rryske2001/praca-magisterska/obrazki/konwertery_spi_i2c.png

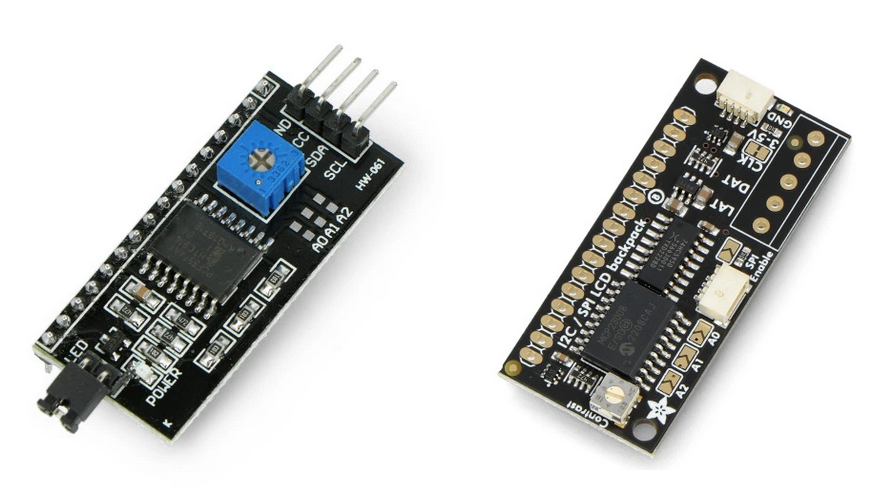
obrazki/konwertery_spi_i2c.png
