rryske2001/praca-magisterska/obrazki/40x2_lewe_wyprowadzenia.png

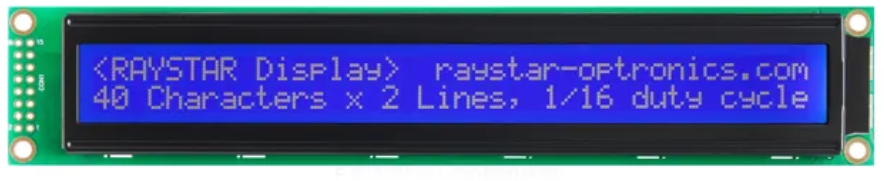
obrazki/40x2_lewe_wyprowadzenia.png
