rryske2001/praca-magisterska/obrazki/rysunki.pptx

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
Instrukcja (01h)

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
Drugi bajt danych

Pierwszy bajt danych

MOSI

8

Stan wysokiej impedancji

MISO

## Slide 2

PCF8574

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
## Slide 3

MCP23S17

GPA7

GPA6

GPA5

GPA4

GPA3

GPA2

GPA1

GPA0

INTA

INTB

A2

A1

A0

GPB0

GBP1

GPB2

GPB3

GPB4

GPB5

GPB6

GPB7

VDD

VSS

CS

SCK

SI

SO

RESET

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
## Slide 4

MCP2017

GPA7

GPA6

GPA5

GPA4

GPA3

GPA2

GPA1

GPA0

INTA

INTB

A2

A1

A0

GPB0

GBP1

GPB2

GPB3

GPB4

GPB5

GPB6

GPB7

VDD

VSS

NC

SCK

SDA

NC

RESET

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
