rryske2001/praca-magisterska/MCP_I2C_SPI_alternatywna_V11/plots/MCP_I2C_SPI_schematic_V3.pdf

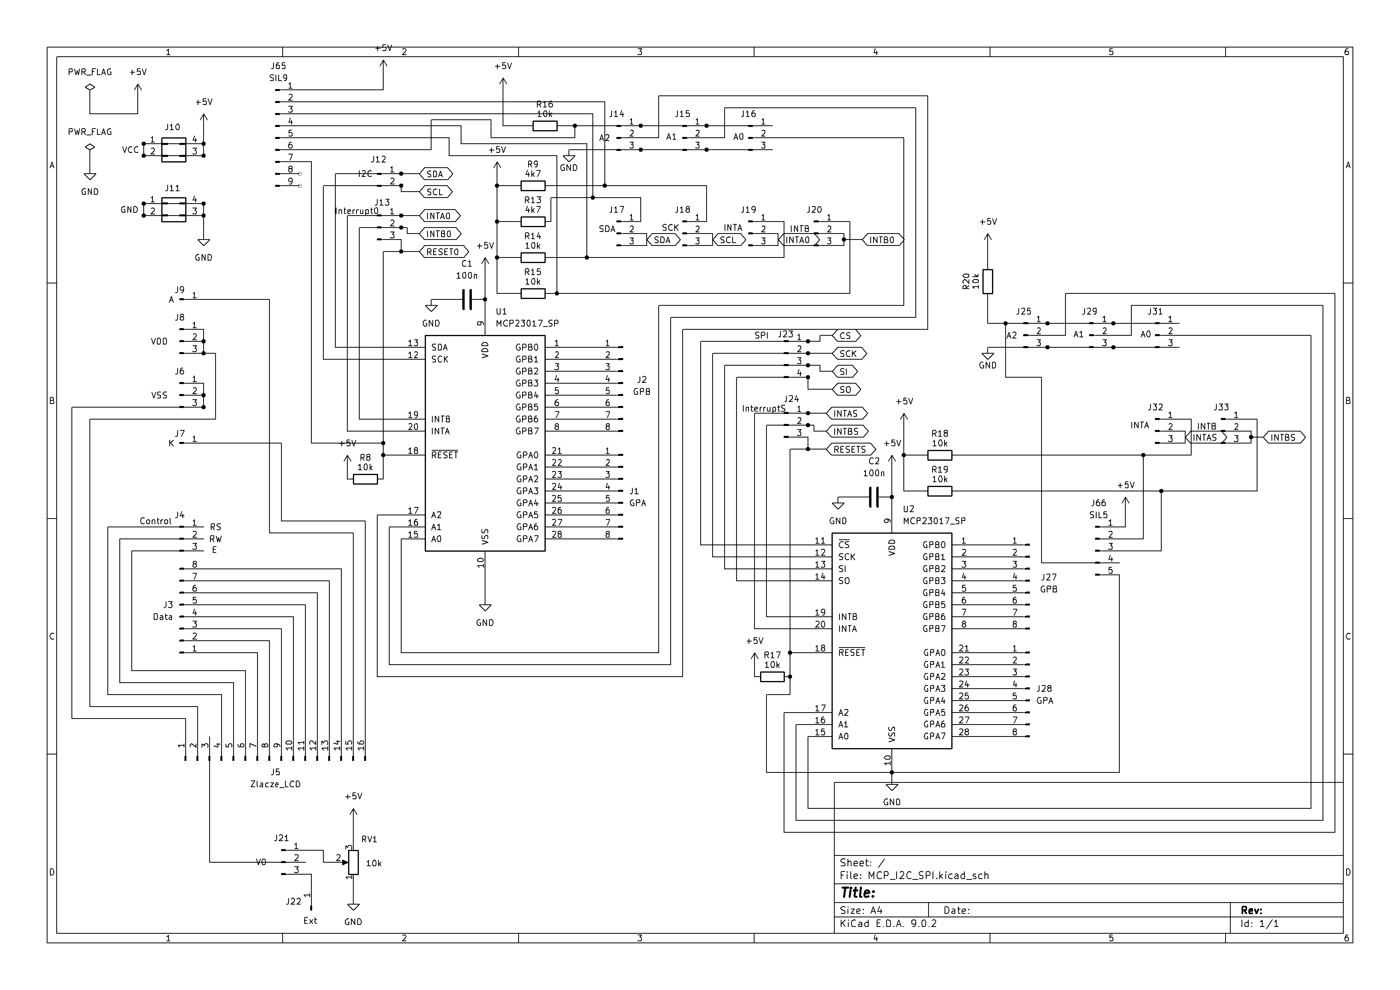
[picture p25: page 1]
