rryske2001/praca-magisterska/Praca_Dyplomowa_Magisterska_Szymon_Dobrowolski_Rafal_Ryske.pdf

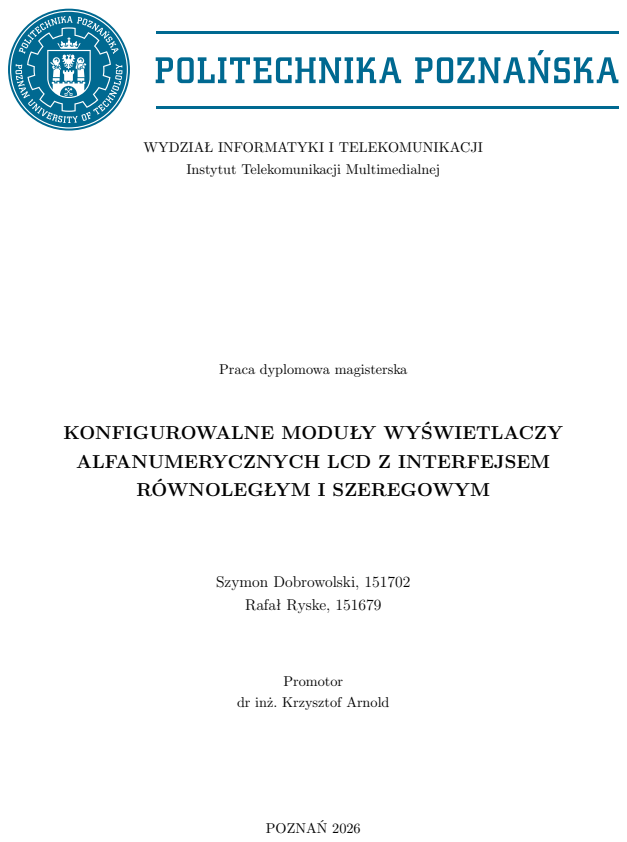
[picture p26: page 1]
RÓWNOLEGŁYM I SZEREGOWYM; Szymon Dobrowolski, 151702; Rafał Ryske, 151679; Promotor; POZNAŃ 2026

WYDZIAŁ INFORMATYKI I TELEKOMUNIKACJI

Instytut Telekomunikacji Multimedialnej

Praca dyplomowa magisterska

KONFIGUROWALNE MODUŁY WYŚWIETLACZY

ALFANUMERYCZNYCH LCD Z INTERFEJSEM

dr inż. Krzysztof Arnold

## Streszczenie

Praca magisterska skupia się na analizie i optymalizacji metod sterowania alfanumerycznymi wyświetlaczami LCD, stanowiąc kompleksowe studium integrujące w tym zakresie zagadnienia sprzętowe i programowe systemów mikroprocesorowych. W projekcie położono szczególny nacisk na oszczędne wykorzystanie wyprowadzeń mikrokontrolera przy zachowaniu efektywnej komunikacji procesora z wyświetlaczami. W pracy opisano mechanizmy komunikacji ze sterownikiem HD44780 i przeanalizowano różnice między klasyczną transmisją równoległą a transmisją szeregową. W tym celu wykorzystano magistralę I²C oraz SPI, badając układy ekspanderów portów

z rodziny PCF8574, MCP23017 oraz MCP23S17. Omówiono także projekty zintegrowanych, dwuwarstwowych obwodów drukowanych. Przygotowano autorskie biblioteki w języku C z bezpośrednim dostępem do rejestrów ekspanderów i przeprowadzono szczegółową analizę opóźnień programowych oraz charakterystyk dynamicznych w transmisji danych. W pracy przedstawiono również narzędzia sprzętowo-programowe, udowadniając, że wydajne interfejsy szeregowe z powodzeniem mogą zastąpić komunikację równoległą bez strat dla poprawnej i szybkiej transmisji danych.

Słowa kluczowe: ATmega 328p, ekspander I/O, ESP32, I2C, mikrokontroler, MCP23017, MCP23S17,

obwód drukowany, PCB, PCF8574, SPI, sterownik HD44780, wyświetlacz LCD

## Abstract

This Master’s thesis focuses on the analysis and optimization of control methods for alphanumeric LCDs, constituting a comprehensive study that integrates the hardware and software aspects of microprocessor systems in this regard. Particular emphasis was placed on the economical use of microcontroller pins while maintaining effective communication between the processor and the displays. The thesis describes the communication mechanisms with the HD44780 controller and analyzes the differences between classic parallel and serial transmissions. For this purpose, I²C

and SPI buses were utilized to examine port expander chips from the PCF8574, MCP23017, and MCP23S17 families. The designs of integrated, two-layer printed circuit boards (PCBs) are also

discussed. Custom C language libraries with direct access to the expanders’ registers were developed, and a detailed analysis of software delays and dynamic characteristics in data transmission was conducted. Furthermore, the thesis presents hardware and software tools, proving that efficient serial interfaces can successfully replace parallel communication without compromising correct and high-speed data transmission.

Keywords: ATmega328p, I/O expander, ESP32, I2C, microcontroller, MCP23017, MCP23S17,

printed circuit board, PCB, PCF8574, SPI, HD44780 controller, LCD display

# Spis treści

1 Wstęp | 7
2 Wyświetlacze alfanumeryczne LCD | 9
3 Ekspandery wejść/wyjść równoległych | 17
4 Projekt modułu LCD z 8-bitowymi ekspanderami PCF8574 | 25
5 Projekt modułu LCD z 16-bitowym ekspanderem MCP23017 | 35
6 Projekt modułu LCD z 16-bitowym ekspanderem MCP23S17 | 41
7 Projekt modułu LCD z 16-bitowymi ekspanderami MCP23x17 | 47

I

II | Spis treści
8 Projekt systemu rozproszonego z łącznością radiową | 55
9 Testowanie ekspanderów wejść/wyjść | 71
10 Uruchamianie modułu LCD z 8-bitowymi ekspanderami PCF8574 | 83
11 Uruchamianie modułu LCD z 16-bitowymi ekspanderami MCP23x17 | 97
12 Uruchamianie modułu bezprzewodowego z układem CC1101 | 103
13 Badania parametrów podsystemu z modułem LCD | 117
13.1 Analiza porównawcza opóźnień programowych i charakterystyk dynamicznych wy-
14 Podsumowanie | 127
Literatura | 129

# Rozdział 1

# Wstęp

## 1.1 Geneza pracy

W obecnej dobie technologicznej wyświetlacze stanowią fundamentalny element komunikacji na linii człowiek-maszyna (ang. Human-Machine Interface, HMI). Przybierają one wielorakie formy

i stopnie skomplikowania: od ekranów o wysokiej rozdzielczości w inteligentnych smartfonach, aż po proste, monochromatyczne panele w kasach sklepowych. W trakcie codziennej interakcji z urządzeniem elektronicznym użytkownika interesuje z reguły wyłącznie natychmiastowo i bezbłędnie wyświetlony wynik. Rzadko zdajemy sobie sprawę, jak złożony ciąg zdarzeń musi zaistnieć wewnątrz układu cyfrowego, zanim na ekranie zaobserwujemy żądaną informację.
Każdy znak pojawiający się na matrycy ciekłokrystalicznej jest w rzeczywistości wynikiem dziesiątek niskopoziomowych operacji bitowych, rygorystycznej synchronizacji sygnałów strobujących i translacji poleceń przez zaawansowane kontrolery sprzętowe. W świecie systemów wbudowanych (ang. embedded systems), gdzie zasoby pamięci i mocy obliczeniowej bywają mocno ograniczone,

proces ten staje się jeszcze większym wyzwaniem inżynierskim.
Ponadto, nieustanne dążenie do miniaturyzacji elektroniki sprawia, że klasyczne, równoległe sterowanie wyświetlaczami alfanumerycznymi pochłania zbyt wiele cennych wyprowadzeń (GPIO)

mikrokontrolera. Naturalnym rozwiązaniem tego problemu jest przeniesienie ciężaru komunikacji na popularne magistrale szeregowe, takie jak I²C czy SPI, z wykorzystaniem dedykowanych układów

pośredniczących – ekspanderów portów.
Głównym celem niniejszej pracy jest kompleksowa analiza procesu sterowania matrycami LCD w standardzie HD44780, począwszy od interfejsów równoległych, aż po zoptymalizowane rozwiązania szeregowe oparte na układach z rodziny PCF8574, MCP23017 i MCP23S17. Obszarem zainteresowań jest wykazanie, jak pełną inżynierskich niuansów tematyką może być ta z pozoru prozaiczna wizualizacja znaków.
Aby w pełni zweryfikować te procesy, opracowano fizyczne stanowiska testowe w postaci zinte-

growanych obwodów drukowanych, pozwalających na pełnoprawną obsługę wielowierszowych matryc. Co istotne, stworzone moduły zaprojektowano z myślą o wysokiej uniwersalności, dzięki czemu mogą one posłużyć również jako cenne pomoce dydaktyczne w laboratoriach studenckich. Przeprowadzona w kolejnych rozdziałach analiza porównawcza, uwzględniająca przepływność magistrali, rygory czasowe i niezawodność sygnałową, stanowić ma kompendium wiedzy o optymalnym łączeniu warstwy programowej ze sprzętową w celu uzyskania maksymalnej efektywności układu.

7

8 | Wstęp

## 1.2 Podział obowiązków projektowych

Szymon Dobrowolski

| Dokonanie przeglądu not katalogowych mikrokontrolerów z rdzeniem AVR i specyfikacji modu-
łów Arduino. Analiza architektury, obsługi programowej i protokołów transmisji dla wskazanych ekspanderów I/O. Zapoznanie się z opisem katalogowym standardowego sterownika HD44780U. Dokonanie przeglądu konwerterów I2C/LCD oraz SPI/LCD. Zapoznanie się z projektami wstęp-

nymi konfigurowalnych wyświetlaczy LCD, zaproponowanymi przez promotora. Zaprojektowanie konfigurowalnego modułu LCD 2x16/4x20 z interfejsem równoległym oraz interfejsami I²C i SPI.

Wykonanie badań symulacyjnych oprogramowania. Przeprowadzenie podstawowych testów na wersjach prototypowych modułów. Wykorzystanie w testach platformy Arduino. Przeprowadzenie badań, weryfikujących zgodność opóźnień programowych z wymaganiami sterownika HD44780U oraz parametrami dynamicznymi wyświetlaczy i ekspanderów I/O.

| Współudział w opracowaniu projektów PCB modułów według wskazówek promotora. Udział
w uwzględnieniu w projektach PCB wersji z frezowanym polem masy i z warstwą soldermaski.

Rafał Ryske

| Zapoznanie się z zasadą działania, protokołami komunikacyjnymi i programową inicjalizacją
wbudowanych modułów TWI oraz SPI. Przegląd wyświetlaczy alfanumerycznych LCD, ze szczególnym uwzględnieniem modułów 2x16 i 4x20. Przeanalizowanie interfejsów i rozkładu wyprowadzeń typowych alfanumerycznych wyświetlaczy LCD. Wybór reprezentatywnych wyświetlaczy o zgodnym rozkładzie wyprowadzeń. Zaprojektowanie modułu LCD 2x16/4x20 z interfejsem równoległym, interfejsem I²C i konfiguracją połączeń na płytce modułu. Wykorzystanie wskazanych 8-bitowych

ekspanderów I/O. Wykorzystanie wskazanych 16-bitowych ekspanderów I/O. Opracowanie pro-

gramów testowych dla zaprojektowanych modułów. Zbadanie poprawności komunikacji jednostki centralnej z konfigurowalnymi modułami LCD dla różnych długości połączeń.
| Współudział w opracowaniu projektów PCB modułów według wskazówek promotora. Udział
w uwzględnieniu w projektach PCB wersji z frezowanym polem masy i z warstwą soldermaski.

# Rozdział 2

# Wyświetlacze alfanumeryczne LCD

## 2.1 Charakterystyka wyświetlaczy

Rozważania dotyczące wyświetlaczy należy zacząć od tego jakie rozwiązania są oferowane przez producentów oraz potrzeb projektowych. Pierwszym wyborem jest technologia w jakiej wyprodukowano ekran. W większości przypadków sprowadza się to do decyzji pomiędzy wyświetlaczami LCD, a OLED. Obydwa rozwiązania różnią się pod względem parametrów wyświetlania (tutaj przeważa ekran OLED), oraz ceną. Młodzi adepci elektroniki częściej decydują się na zakup wyświetlaczy

LCD do celów dydaktycznych. Niebagatelny jest tutaj stosunek ceny do parametrów fizycznych ekranu - jego wielkości. W związku z popularnością tej technologii, jest ona rozważana w dalszej części pracy.
Typowy wyświetlacz ciekłokrystaliczny do prawidłowej pracy potrzebuje podświetlenia, sterownika oraz filtrów polaryzacyjnych. Elementem, który powoduje zmianę danych i komend z mikrokontrolera na napięcia sterujące matrycą, jest sterownik graficzny. Dzięki temu urządzeniu możliwa jest manipulacja polaryzacją struktury ciekłokrystalicznej - zmiana odcieni, barw. Najczęściej spotykanymi rodzajami sterowników są między innymi: HD44780, ILI9341 i ST7789. Implementacja danego układu scalonego w wyświetlaczu definiuje jego sposób komunikacji, rodzaje obsługiwanych matryc, liczbę możliwych znaków czy sekcję zasilania układu [9].

Wybór ekranu jest nieodłącznie związany z doborem pod optymalną liczbę znaków. Tak jak w większości przypadków rynek wyświetlaczy pozwala tu na dostęp do wielorakich rozwiązań. Dla sterowników HD44780 dostępnych jest kilka rozmiarów matryc znakowych. Najpopularniejszymi są 16x2 , 20x4 i 40x2¹
. Sterowniki ILI9341 oraz ST7789 są przeznaczone do wizualizacji różnego rodzaju grafik. Z tego względu ekrany współpracujące z powyższymi układami są charakteryzowane liczbą dostępnych pikseli [5].

W trakcie projektowania urządzenia, należy zwrócić uwagę na umiejscowienie wyświetlacza na płytce. W przypadku wyboru ekranu z sterownikiem HD44780 błędne dobranie wyprowadzeń, może wiązać się z nieodpowiednim wyświetlaniem znaków - do góry nogami. Może to zabrzmieć prozaicznie, lecz tworząc duży projekt takie przeoczenie niesie za sobą ogromne konsekwencje -w najgorszym przypadku zmarnowanie funduszy. Młodsze sterowniki pozwalają na programowe manipulowanie obrazem, przez co problem z błędnym zaprojektowaniem miejsca na wyświetlacz, przy dobrze napisanym kodzie praktycznie nie występuje[27].

W zależności od technologii wykonania sterownika wyświetlacza, występuje w nich różne napięcie zasilania oraz przyjmowane stany logiczne. HD44780 musi być zasilany napięciem 5 V, natomiast

1
gdzie pierwsza liczba to liczba kolumn, natomiast druga to liczba wierszy

9

10 | Wyświetlacze alfanumeryczne LCD

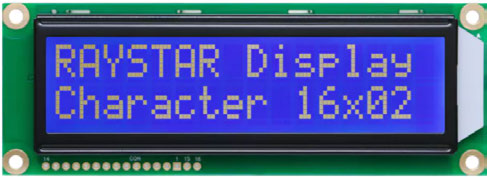
[picture p27: figure]

Rysunek 2.1: Przykład wyświetlacza 16x2 z wyprowadzeniami na dolnej części wyświetlacza [29]

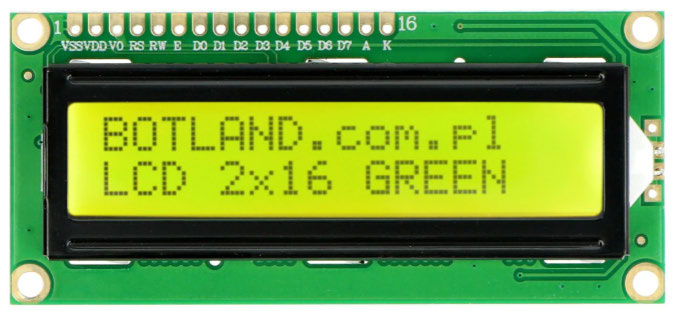
[picture p28: figure]

Rysunek 2.2: Przykład wyświetlacza 16x2 z wyprowadzeniami na górnej części wyświetlacza [4]

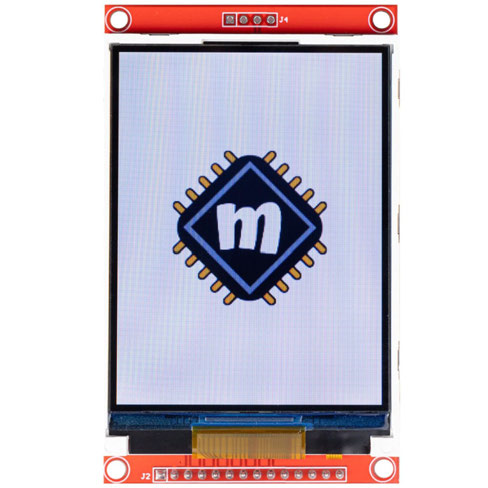
[picture p29: figure]

Rysunek 2.3: Wyświetlacz TFT sterowany układem ILI9341 [22]

Rysunek 2.4: Zdjęcie wyświetlacza 40x2 ze złączami po lewej stronie [30]

2.2. Interfejsy wyświetlaczy | 11

nowszy klon tego układu HD44780U może przyjmować napięcie 2,7 - 5,5 V. Z tego względu nowsza odsłona zadziała zarówno z mikrokontrolerami z rodziny ATMEL AVR (5 V) [1] jak i z ESP32 (3,3
V) [11]. Sterownik ILI9341 przyjmuje napięcie zasilania na poziomie 2,5 - 3,3 V. W przypadku

mikrokontrolerów pracujących na wyższym napięciu, może być konieczne zastosowanie konwertera poziomów napięć logicznych [13].

Każdy wyświetlacz wymaga podświetlenia. Bez niego odczytanie informacji jest bardzo trudne, często niemożliwe. Większość ekranów pozwala na zmienianie jasności. Jest to możliwe poprzez użycie zewnętrznego potencjometru lub zmiennej szerokości impulsu - PWM. Takie rozwiązanie pozwala na dostosowanie wyświetlacza do miejsca pracy.
Kolejną możliwością dostosowania wyświetlacza, jest regulacja kontrastu. W przypadku modułów z 16 -pinowym wyprowadzaniem, zazwyczaj odbywa się to zmianą napięcia na pinie V0. Malejące napięcie powoduje zwiększenie kontrastu i zanikanie znaków z matrycy. Narastające napięcie zmniejsza kontrast i znaki zlewają się w białe lub czarne prostokąty. Idealne napięcie to około 0,5 -1 V, można je uzyskać z napięcia dzielnika, lub potencjometru, którym można liniowo wyregulować kontrast, pod dany kąt patrzenia na wyświetlacz. W przypadku chęci skorzystania z cyfrowej regulacji kontrastu, pin V0 można podłączyć do złącza PWM, podobnie jak w przypadku sterowania jasnością [11].

## 2.2 Interfejsy wyświetlaczy

Interfejs to punkt styku lub zestaw reguł umożliwiający komunikację między różnymi systemami, urządzeniami lub programami. Pozwala na szybką wymianę danych oraz współpracę elementów [23].

Głównym podziałem interfejsów jest klasyfikacja ze względu na sposób przesyłu danych. W taki sposób rozróżniamy magistrale jako równoległe i szeregowe. Interfejs równoległy charakteryzuje się znacznie większą prędkością transmisji, lecz potrzebuje wielu połączeń. Magistrale szeregowe ograniczają liczbę złącz, natomiast wymagają złożonego protokołu komunikacji. Projektując urządzenie do pracy z interfejsem szeregowym należy zapoznać się z ograniczeniami prędkości transmisji danego rozwiązania. Najbardziej popularnymi interfejsami szeregowymi są I²C oraz SPI [24].

I

2C lub IIC (ang. Inter-Integrated Circuit) jest przykładem magistrali szeregowej, wykorzy-

stującej 2 linie do komunikacji. Znaczącą przewagą nad innymi interfejsami jest możliwość wymiany danych pomiędzy wieloma urządzeniami bez potrzeby prowadzenia indywidualnych połączeń. Wszystko odbywa się na tej samej magistrali odpowiednio rozszerzając protokół komunikacji. Dzięki takiemu rozwiązaniu interfejs zyskał znaczną popularność wśród osób zaczynających przygodę z elektroniką. Niewątpliwą wadą magistrali I²C jest jej maksymalna szybkość transmi-

sji. Dla dwukierunkowej wymiany danych jest to 3,4 Mbit/s. Nie każde urządzenie obsługujące tę magistralę ma możliwość komunikacji z taką szybkością. Zważając na ograniczenia interfejsu I²C

znajduje on swoje zastosowanie na krótkich dystansach. Magistrala IIC jest chętnie wykorzystywana w układach pomiarowych, z dużą liczbą sensorów [21, 28].
Alternatywą do wolnego I²C jest interfejs SPI. Specjalistyczne układy wykorzystujące tą ma-

gistralę są w stanie komunikować się z prędkościami przekraczającymi 100 Mbit/s. Z drugiej

strony SPI w swojej specyfice posiada szereg wad, które trzeba rozpatrzeć w trakcie projektowania. Znaczącą różnicą od wymienionego wcześniej I²C jest dwukrotnie większa liczba połączeń.

Wspólna dwukierunkowa szyna danych zostaje rozbita na dwie jednokierunkowe tj. MISO (ang. Master Input Slave Output) oraz MOSI (ang. Master Output Slave Input). Sygnał zegarowy jest prze-

12 | Wyświetlacze alfanumeryczne LCD

syłany linią SCK (ang. Source Clock ). Najważniejszą zmianą pomiędzy wymienionymi interfejsami jest wybór urządzenia podrzędnego. Dużą zaletą magistrali I²C jest jej minimalistyczne podejście,

gdzie jedną szyną wywołuje się wymianę danych z żądanym układem slave. Gdy chcemy zmienić rozmówcę wszystko odbywa się tą samą linią. Sprawa ma się zupełnie inaczej przy SPI. Ostatnim z złącz tego interfejsu jest SS (ang. Slave Select). Każde z urządzeń podrzędnych ma indywi-

dualne połączenie z swojego SS do odpowiednio przygotowanego pinu w urządzeniu nadrzędnym. Przykładowo tworząc system z 3 czujnikami i mikrokontrolerem dla interfejsu SPI trzeba zająć 6 pinów, gdzie dla I²C to 2 połączenia. Stanowi to ogromną różnicę, zwłaszcza przy projektowa-

niu płytki drukowanej. Magistrala SPI jest częstym rozwiązaniem w szybkich pamięciach flash, wyświetlaniu wymagającej szybkiego odświeżania grafiki czy specjalistycznych układach pomiarowych [20, 26].

Rysunek 2.5: 16-pinowe złącze wyświetlacza [29]

Na rysunku 2.5 przedstawiono 16-pinowe złącze wyświetlacza pracującego z interfejsem równoległym. Każdy z pinów pełni określoną rolę. VSS to wyprowadzenie masy układu. VDD to zasilanie (typowo 5 V). V0 to regulacja kontrastu. A to anoda diody podświetlenia ekranu, natomiast K to ka-

toda. Przez wyprowadzenia D0 - D7 odbywa się komunikacja równoległa, przesyłane są tu dane oraz komendy. Numer podany, stojący przy literze D odpowiada indeksowi bitu w bajtowej ramce danych. Na załączonym rysunku widnieją również trzy porty sterujące RS, RW, oraz E, które zostaną omówione w dalszej części rozdziału.

2.3. Transmisja poleceń i danych | 13

## 2.3 Transmisja poleceń i danych

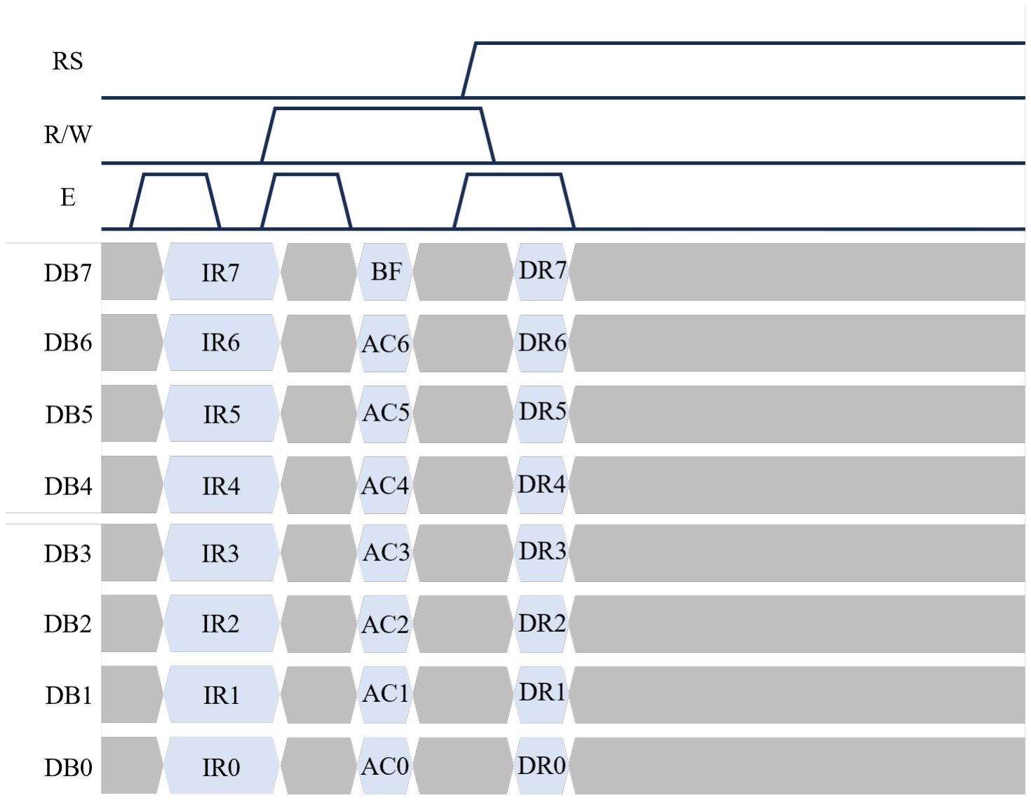
[picture p30: figure]

Rysunek 2.6: Wykres czasowy, przedstawiający transmisję równoległą 8-bitową [11]

W 8-bitowej równoległej transmisji danych wykorzystywany jest cały zestaw wyprowadzeń danych wyświetlacza (DB7 - DB0). Przesyłany jest cały bajt danych w jednym impulsie Enable.

Występują też trzy linie sterujące:

- RS (ang. Register Select) - pozwala na pracę w trybie instrukcji (na rysunku 2.6 oznaczone

jako IR7 - IR0) lub trybie danych (oznaczone jako DR7 - DR0). Instrukcje to inaczej polecenia, które ma wykonać sterownik wyświetlacza (np. wyczyść matrycę, lub ustaw kursor na danej pozycji, itp.). Dane to kod ASCII litery, która ma być wyświetlona lub definicja pikseli dla własnego znaku. Dla niskiego stanu (0 V) wyświetlacz przyjmuje instrukcje. Jeżeli jest podany stan wysoki (5 V), to wyświetlacz przyjmuje dane.

- R/W (ang. Read/Write) - gdy jest podany niski stan, wyświetlacz jest w trybie zapisu. Przyj-

muje wówczas dane oraz komendy. Stan wysoki ustawia sterownik w tryb odczytu, wyświetlacz, przesyła wtedy na pinie D7 flagę zajętości (na rysunku 2.6 - BF) oraz na pozostałych (D6-D0) licznik adresu (AC6 - AC0), przy czym, że pin RS jest ustawiony na 0. W przypadku,

gdy RS ma stan 1, wyświetlacz odsyła kod ASCII wybranego znaku.

- E (ang. Enable) - sygnał wyzwalający przyjęcie komendy lub danych. Sterownik odczytuje

dane z pinów w momencie opadającego zbocza (zmiany stanu z wysokiego na niski).

14 | Wyświetlacze alfanumeryczne LCD

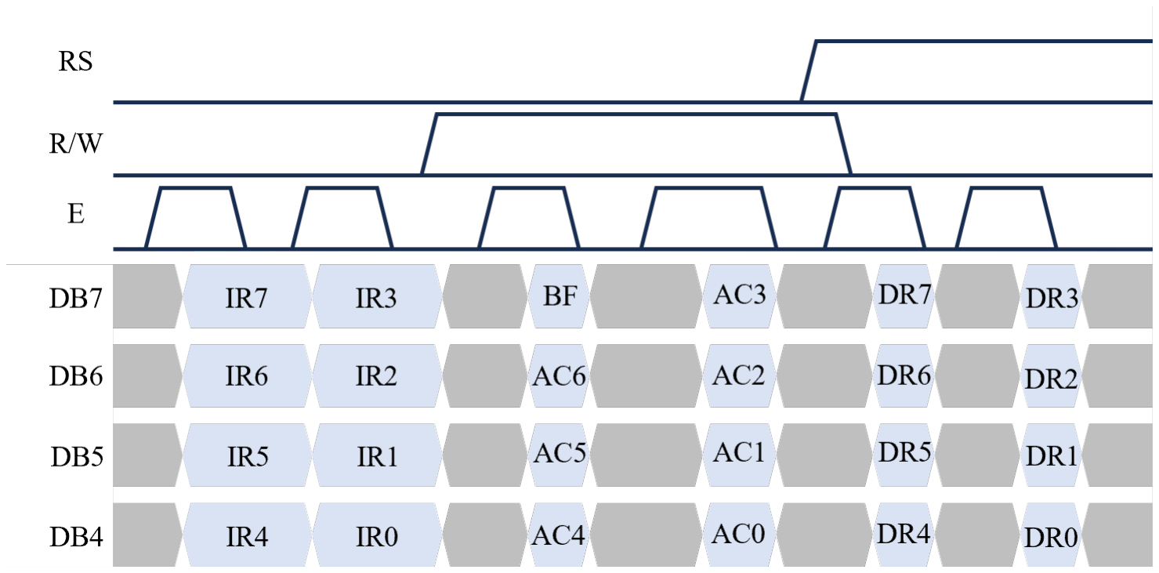
[picture p31: figure]

Rysunek 2.7: Wykres czasowy, przedstawiający transmisję równoległą 4-bitową [11]

Twórcy układu HD44780 przewidzieli, że stosowanie 8 linii do transmisji poleceń dla wyświetlacza znacząco wpływa na dostępność portów w mikrokontrolerze, dlatego zdecydowali się wprowadzić tryb 4-bitowy, który częściowo ten problem rozwiązuje. Dane są wówczas fizycznie przesyłane przez piny D7 - D4, natomiast pozostałe wyprowadzenia (D3 - D0) pozostają niepodłączone.

Przesył komend lub danych odbywa się poprzez podział bajtu na dwie części. Jak można zauważyć na rysunku 2.7, w trakcie pierwszego impulsu sygnału Enable przesyłana jest starsza część bajtu instrukcji (IR7 - IR4) lub danych (DR7 - DR4). Następnie, przy drugim impulsie Enable, przesyłana jest młodsza część bajtu instrukcji (IR3 - IR0) lub danych (DR3 - DR0). Należy podkreślić, że stan linii RS oraz R/W nie może ulec zmianie w trakcie przesyłania obu połówek jednego bajtu [11].

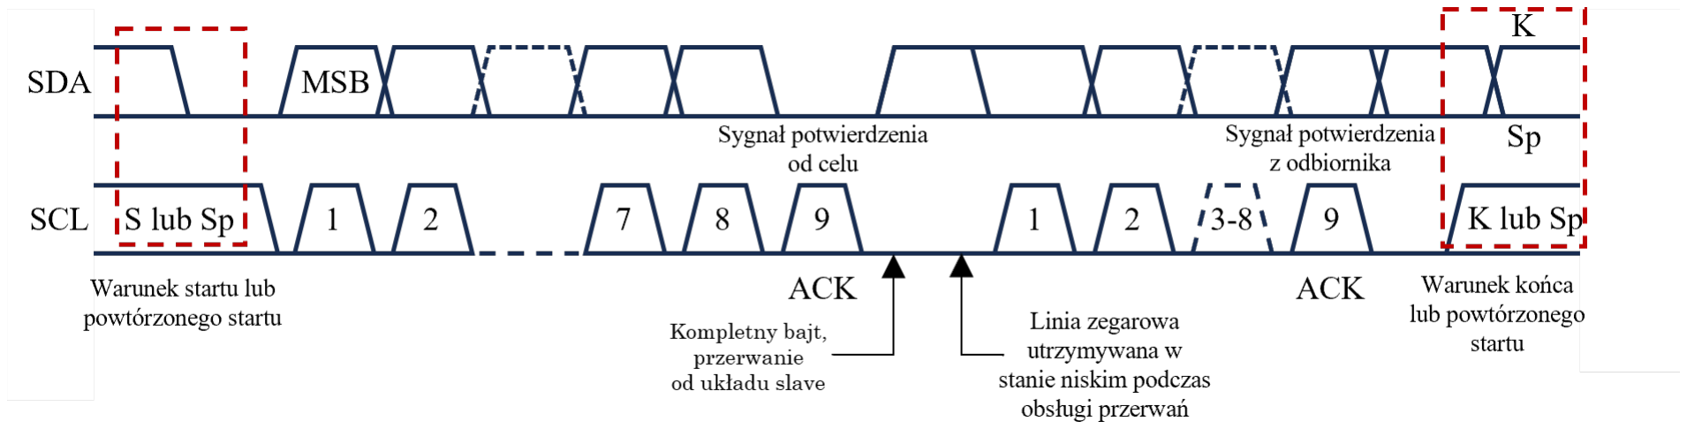
[picture p32: figure]

Rysunek 2.8: Wykres czasowy, przedstawiający transmisję szeregową dla I²C [21]

W standardzie I²C wykorzystywane są tylko dwie linie SDA (dane) oraz SCL (zegar). Aby wy-

wołać konkretne urządzenie master wysyła warunek startu. Zegar jest w stanie wysokim, w tym czasie linia danych zmienia swój stan z wysokiego na niski. W takim wypadku odbiorniki interpretują to jako początek transmisji. Pierwszy bajt wysłany przez nadajnik to siedem bitów adresu oraz najmniej znaczący, zarezerwowany bit operacji (R/W - zapis, odczyt). Po nadaniu ósmego

bitu master zwalnia linię SDA pozwalając jej wrócić do stanu wysokiego. Wygenerowany zostaje

2.4. Konwertery I²C/LCD | 15

dziewiąty impuls zegara. W tym czasie odbiornik musi ściągnąć linię SDA do masy, aby potwierdzić odebranie danych (nadać ACK ang. Acknowledge).

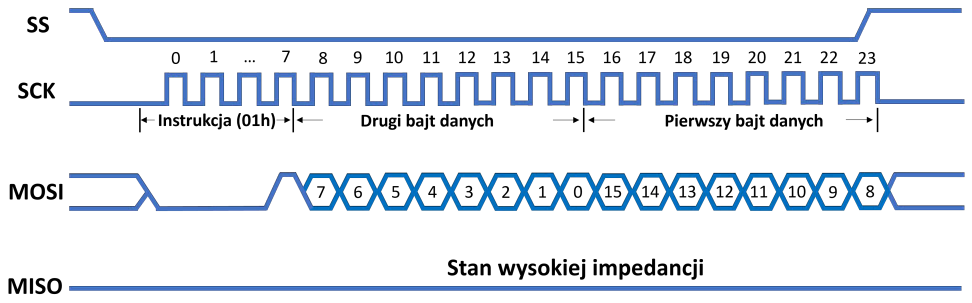
[picture p33: figure]

Rysunek 2.9: Wykres czasowy, przedstawiający transmisję szeregową dla SPI [20]

Zapis w magistrali SPI odbywa się poprzez aktywację układu linią SS - (ang. Slave Select)

ustawioną w stan niski. Zaraz po tym master wysyła odpowiednią instrukcję zapisu szyną MOSI (01h), a następnie jeden lub dwa bajty właściwych danych, które trafiają do odpowiedniego reje-

stru urządzenia. W trybie zapisu układ slave nie wysyła żadnych odpowiedzi, a master ignoruje wszelkie sygnały przychodzące. Po zakończeniu transmisji nadajnik dezaktywuje linię SS. Zegarem steruje master. To on ustala prędkość transmisji. Odbiornik nigdy nie generuje swojego sygnału SCK. Jeżeli master przerwie nadawanie zegara, z powodu obsługi innych zadań, wtedy slave czeka, aż sygnał zegara wróci, aby mógł dokończyć obiór danych. Na rysunku 2.9 przedstawiony jest tryb nadawania SPI Mode 0. Oznacza to, że polaryzacja spoczynkowa zegara to stan niski. Natomiast dane odczytywane są na pierwszym narastającym zboczu zegara [9].

## 2.4 Konwertery I²C/LCD

W trakcie wyboru wyświetlacza można natrafić na ekrany z dodatkowym modułem wlutowanym do wyprowadzeń płytki. Zazwyczaj dołożony moduł jest konwerterem X/LCD. Głównym urządzeniem na dodatkowej płytce jest tzw. ekspander wejść/wyjść. Zastosowanie konwertera pozwala

na sterowanie z wyświetlaczem zaprojektowanym na interfejs równoległy z użyciem komunikacji szeregowej. Takie rozwiązanie stanowi pogodzenie charakterystyki wyświetlacza z minimalizacją połączeń.
Konwerter oparty na protokole I²C pozwala na sterowanie wyświetlaczem w trybie 4 - bito-

wym. Redukuje on liczbę niezbędnych połączeń do dwóch - SDA, dla danych, oraz SCL dla zegara.

Posiada potencjometr do regulacji kontrastu, trzy pola lutownicze do ustalenia adresu układu PCF8574 oraz zworkę do włączania zasilania podświetlenia. Na wyjściu ma 16 pinów odpowiadających wyświetlaczowi ze sterownikiem HD44780.

16 | Wyświetlacze alfanumeryczne LCD

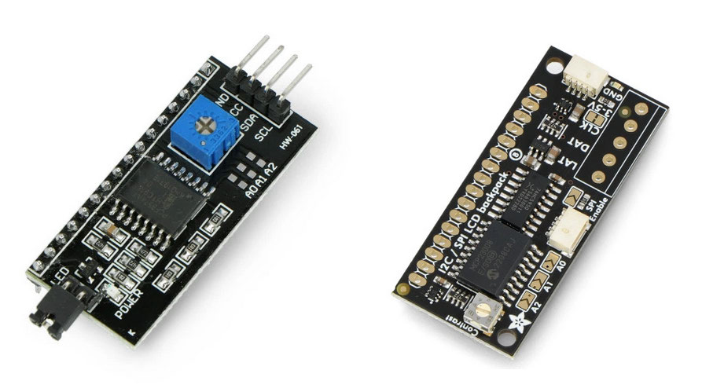
[picture p34: figure]

Rysunek 2.10: Konwertery I²C oraz I²C/SPI [3]

Rozbudowaną wersją jest konwerter z interfejsami I²C/SPI. Za pomocą zworki (pola lutowniczego) można wybrać tryb transmisji I²C lub SPI. Interfejs I²C, obsługuje układ MCP23008.

Podobnie jak poprzedni konwerter umożliwia ustawienie adresu układu. W przypadku wybrania trybu SPI wykorzystywany jest układ 74LS595D. Na płytce posiadają one wspólne wejścia oraz wyjścia, co wymusza na programiście wybranie tylko jednego z tych układów. Tutaj również występuje regulacja kontrastu przy pomocy potencjometru, a włączenie podświetlenia odbywa się z jednego z pinów wyjściowych układów MCP23008 oraz 74LS595D [26].

# Rozdział 3

# Ekspandery wejść/wyjść równoległych

## 3.1 Zadania ekspanderów w systemach mikroprocesorowych

Projektując układ, można napotkać sytuację, gdy wybrany mikrokontroler ma zbyt małą liczbę portów wejść/wyjść. Pierwszym nasuwającym się rozwiązaniem jest zakup urządzenia z bogatszym

asortymentem pinów. Istnieje jednak możliwość rozszerzenia możliwych połączeń bez konieczności zmiany jednostki głównej.
Ekspander wejść/wyjść to dosłownie port rozszerzeń pinów GPIO (ang. General Purpose Input Output). Takie urządzenia są projektowane do pracy z magistralą szeregową. Wykorzystując

interfejs szeregowy, który zajmuje relatywnie mało połączeń, można powiększyć zasób dostępnych wyprowadzeń (zazwyczaj 8 dodatkowych pinów, ale zależy to od wybranego układu scalonego).

Na rynku dostępnych jest wiele układów, które pozwalają na ekspandowanie portów. Urządzenia różnią się od siebie liczbą użytecznych pinów, obsługiwanymi interfejsami czy sygnałami sterującymi [10].

## 3.2 Układy PCF8574

Przy opracowywaniu modułów wykorzystano ekspandery PCF8574. Jest to 8 bitowy rozszerzacz portów I/O, który do komunikacji wykorzystuje magistralę I²C. Urządzenie może być zasilane

napięciem od 2,5 do 6 woltów, dzięki czemu ułatwia proces projektowania sekcji zasilania.

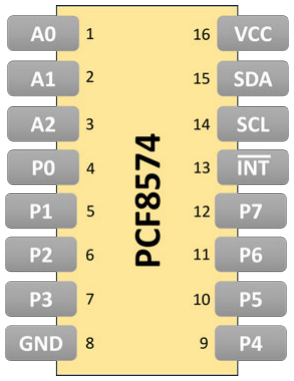
[picture p35: figure]

Rysunek 3.1: Rozkład wyprowadzeń układu PCF8574 [16]

17

18 | Ekspandery wejść/wyjść równoległych

Na rysunku 3.1 przedstawiono rozkład wyjść ekspandera. Piny 1 - 3 służą do ustawienia adresu urządzenia. Kolejne 4 wyprowadzenia to połowa bajtu danych. Ósmym wyjściem jest masa układu.

Kolejny półbajt danych stanowią piny od 9 do 12. Wyprowadzenie numer 13 to port przerwań. Pin 14 i 15 obsługują komunikację magistralą I²C, z czego pierwszym jest SCL, a następnym SDA.

Ostatnim wyjściem jest linia zasilania.
Port wejść/wyjść został zrealizowany za pomocą quasi dwukierunkowych wejść/wyjść - quasibidirectional I/O. Takie rozwiązanie eliminuje potrzebę stosowania dodatkowych rejestrów konfi-

guracyjnych. Stan danego pinu jest definiowany przez napięcie, które się na nim znajduje. Gdy ekspander jest włączony wszystkie wyprowadzenia są w stanie wysokim, przez zastosowanie rezystora podciągającego, wymuszającego natężenie prądu o wartości 100µA. Każdy pin może pracować z sygnałami o maksymalnym natężeniu prądu 25 mA.
Wymiana danych pomiędzy PCF8574, a mikrokontrolerem zaczyna się typowym sygnałem startu dla magistrali I²C. Linie SDA i SCL przed rozpoczęciem transmisji mają stan wysoki. Ściągnięcie SDA do stanu niskiego przy jednoczesnym stanie wysokim na SCL zaczyna proces

komunikacji. W kolejnych taktach przesyłany jest 7 bitowy adres. Ramkę kończy bit kierunku komunikacji. Gdy jest to 1, układ przesyła sygnały podłączone do wyprowadzeń P0-P7 (tryb read). W przeciwnym przypadku na piny I/O są przekazywane dane z mikrokontrolera (tryb write).

Przykładem jak działa typowa transmisja danych będzie wymiana pomiędzy mikrokontrolerem, a ekspanderem (tryb write). Dla układu PCF8574 pierwsze 4 bity adresowe (licząc od najstarszego bitu) są stałe tworząc ciąg 0100. Następne 3 pola są definiowane przez stan napięć na wejściach A0, A1 i A2. Bajt jest zakończony zerem (R/W). Po przesłaniu pierwszego bajtu ekspander o danym

adresie odsyła potwierdzenie odebrania danych ang. acknowledge. Następnie jest przesyłany bajt surowych danych, które będą reprezentować 8 wyprowadzeń ekspandera (stan pojedynczego bitu to jeden pin). Poprawność odebrania danych jest sygnalizowana potwierdzeniem od układu PCF8574 (ponieważ on odbiera dane). Jeżeli chcemy zakończyć transmisję należy to zrobić wysyłając charakterystyczny dla protokołu I²C sygnał STOP. Jest to podciągnięcie linii SDA do stanu wysokiego,

przy jednoczesnym stanie wysokim szyny SCL. W przypadku gdy chcemy odczytywać stany wejść ekspandera (tryb read) to mikrokontroler musi potwierdzać tylko odebrane dane (adres dalej jest potwierdzany przez PCF8574).

Układ omawianego ekspandera posiada linię przerwań INT. Jest to sprzętowe rozwiązanie problemu sprawdzania przez urządzenie nadrzędne wszelkich zmian zachodzących w trakcie sesji komunikacyjnej. Pozwala to na rzadsze ingerowanie mikrokontrolera, co oszczędza czas. PCF8574 sam informuje o zmianach zachodzących na porcie wejść/wyjść. Wspomniana linia INT pracuje

w konwencji otwartego drenu ang. open-drain. Uznajemy, że linia jest aktywna, gdy zaobserwujemy stan niski. Działanie linii przerwań najlepiej wyjaśni wspomniany wcześniej przykład transmisji. W momencie startu linia INT jest aktywna. Potwierdzenie ze strony PCF8574 po pierwszym bajcie może powodować podciągnięcie linii przerwań do stanu wysokiego (wyłączenie jej). Następnie są przesyłane dane. Przerwania są bardzo ważne w trybie odczytu (read). Wykorzystanie tego

rozwiązania pozwala na informowanie mikrokontrolera o zmianach występujących na wejściach ekspandera. Przykładem wykorzystania tego pomysłu jest reakcja układu na kliknięcie przycisku. Głównym zastosowaniem przerwań jest alarmowanie o zmianach i kasowanie swojej aktywności po potwierdzeniach (informujemy mikrokontroler, że nie musi się skupiać na tym co się dzieje w danej sesji).

3.3. Układy MCP23x17 | 19

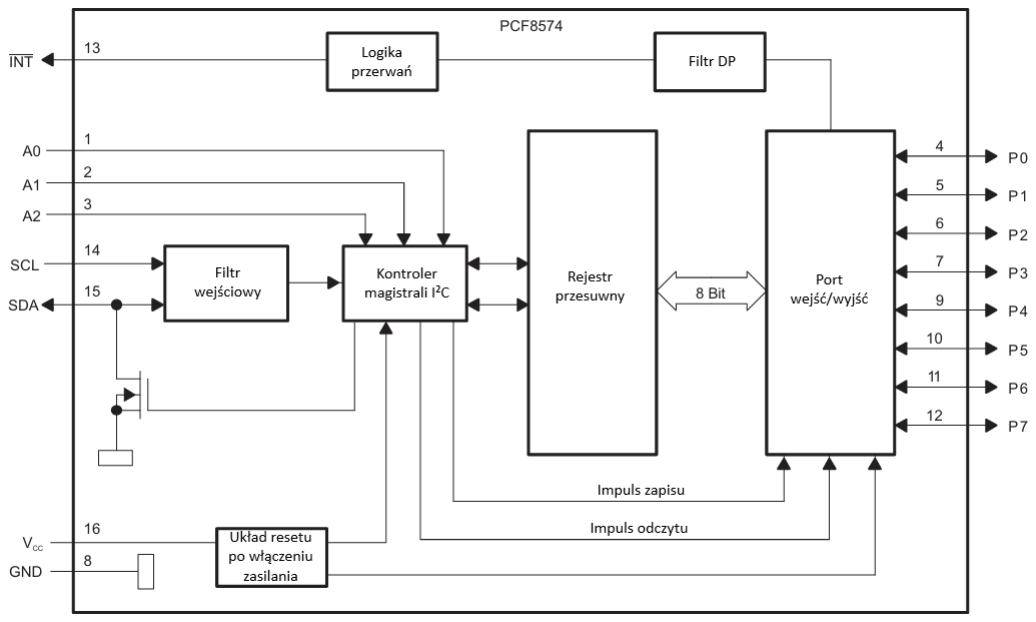
[picture p36: figure]

Rysunek 3.2: Schemat blokowy układu PCF8574 [16]

Na rysunku 3.2 przedstawiono schemat blokowy ekspandera PCF8574. Układy filtrów eliminują szumy i zwiększają poprawność odebranych/nadawanych danych. Kontroler magistrali I²C realizuje

tłumaczone poprzednio schematy protokołu komunikacyjnego. PCF8574 posiada rejestr przesuwny, do którego są przekazywane dane zależnie od kierunku transmisji. Wspomniany rejestr współpracuje z portem wejść/wyjść, gdzie podłączamy peryferia. Blok logiki przerwań spełnia zadania związane

z tłumaczonymi wcześniej reakcjami wyjścia INT.
Układ PCF8574 to bardzo popularne urządzenie, które znajduje wiele zastosowań. Ekspander jest wykorzystywany między innymi w konwerterach do wyświetlaczy LCD, obsłudze klawiatur, sterowaniu modułami przekaźników czy agregowaniu sygnałów czujników. Pomimo tego PCF8574 ma kilka wad, które stawiają znak zapytania w kontekście doboru odpowiedniego układu uwzględniając potrzeby projektowe. Urządzenie nie posiada rejestrów sterujących, przez co ma ograniczone możliwości konfiguracji. Prostota PCF8574 jest jednocześnie jego ogromną zaletą, jak i wadą. Z myślą o bardziej wymagających projektach powstały ekspandery, których przykładowy reprezentant zostanie przedstawiony w kolejnym rozdziale [16].

## 3.3 Układy MCP23x17

Układy z serii MCP23x17 to 16-bitowe ekspandery wejść/wyjść. W miejscu oznaczenia x kryje się obsługiwany interfejs komunikacji z układem. Gdy x wynosi 0, to I²C, natomiast literka S to ma-

gistrala SPI. W porównaniu do układu PCF8574, MCP23x17 daje ogromne możliwości konfiguracji. W tabeli 3.1 przedstawiono rejestry sterujące układu MCP23x17. Najważniejsze to IODIRA oraz IODIRB, umożliwiające ustawienie kierunku pinów portów. GPIOA oraz GPIOB pozwalają na odczyt stanów logicznych pinów, natomiast OLATA, OLATB pozwalają na zapis do pinów.

W omawianym układzie to nie tylko 8-bitów danych oraz bit trybu decyduje o stanie pinów. Tutaj

20 | Ekspandery wejść/wyjść równoległych

Tabela 3.1: Tabela przedstawiająca rejestry sterujące w układach MCP23x17 [14]

Adres (Hex) | Nazwa Rejestru | Opis
0x00 | IODIRA | Kierunek pinów Portu A (1 = Wejście, 0 = Wyjście)
0x01 | IODIRB | Kierunek pinów Portu B
0x02 | IPOLA | Polaryzacja wejść Portu A (odwracanie stanów logicznych)
0x03 | IPOLB | Polaryzacja wejść Portu B
0x04 | GPINTENA | Włączenie przerwań dla pinów Portu A
0x05 | GPINTENB | Włączenie przerwań dla pinów Portu B
0x06 | DEFVALA | Domyślna wartość do porównań przerwań (Port A)
0x07 | DEFVALB | Domyślna wartość do porównań przerwań (Port B)
0x08 | INTCONA | Konfiguracja sposobu generowania przerwań (Port A)
0x09 | INTCONB | Konfiguracja sposobu generowania przerwań (Port B)
0x0A | IOCON | Rejestr konfiguracji globalnej (wspólny) m.in. flaga SEQOP i BANK
0x0B | IOCON | Kopia rejestru konfiguracji globalnej
0x0C | GPPUA | Włączenie wewnętrznych rezystorów Pull-Up (Port A)
0x0D | GPPUB | Włączenie wewnętrznych rezystorów Pull-Up (Port B)
0x0E | INTFA | Flaga przerwania - wskazuje, który pin wywołał przerwanie (Port A)
0x0F | INTFB | Flaga przerwania (Port B)
0x10 | INTCAPA | Przechwycony stan portu A w momencie wystąpienia przerwania
0x11 | INTCAPB | Przechwycony stan portu B w momencie wystąpienia przerwania
0x12 | GPIOA | Odczyt stanu logicznego pinów Portu A
0x13 | GPIOB | Odczyt stanu logicznego pinów Portu B
0x14 | OLATA | Zatrzask wyjściowy Portu A (Zapis do pinów)
0x15 | OLATB | Zatrzask wyjściowy Portu B (Zapis do pinów)

programista musi pamiętać o wpisaniu danych do rejestrów, a nie bezpośrednio na piny. Powoduje to dodatkowy nakład pracy od programisty oraz konieczność podstawowej znajomości układu. Warto wspomnieć, że 16 portów układu jest podzielone na dwa bloki 8-bitowe GPA oraz GPB. Dodatkowo, każdy z tych portów może być całkowicie indywidualnie skonfigurowany jako wejście lub wyjście. W opisywanych układach odeszło się od quasi-dwukierunkowych portów, na rzecz prawdziwych w pełni konfigurowalnych portów wejścia/wyjścia. Każdy z tych pinów potrafi dostarczyć

lub przyjąć prąd o natężeniu do 25 mA. Należy pamiętać jednak, że maksymalny prąd wpływający przez pin zasilania VDD to 125 mA, a wypływający przez VSS to 150 mA, trzeba zatem być ostrożnym, aby nie przekroczyć sumarycznych prądów. Dla każdego pinu skonfigurowanego jako wejście, można programowo włączyć rezystor podciągający Pull-up o wartości około 100 kΩ. Układy z serii MCP23x17 posiadają zaawansowany system przerwań - piny INT A dla banku GPA oraz INT B dla banku GPB. Mogą one sygnalizować zmianę stanu, na pinach wejściowych. Podobnie jest w układzie PCF8574, ale tutaj również mamy możliwość konfiguracji, jak zachowają się te piny. Możemy też odczytać przechwycone stany portów A oraz B w rejestrach odpowiednio INTCAPA oraz INTCAPB. Kolejną funkcjonalnością wartą omówienia jest odwracanie polaryzacji. Układy te posiadają specjalne rejestry (IPOLA, IPOLB) pozwalające odwrócić logikę wejść. Je-

żeli do wejścia podłączony jest przycisk zwierający do masy, ekspander można tak skonfigurować, aby programistycznie odczytywany był stan logiczny jako wysoki. MCP23x17 są zaprojektowane tak, aby pracować z wieloma systemami. Obsługują szeroki zakres napięć od 1.8 V do 5,5 V. Niski pobór prądu w trybie Standby rzędu 1 µA sprawia, że to rozwiązanie nadaje się idealnie do układów

zasilanych bateryjnie lub z akumulatorów.

3.3. Układy MCP23x17 | 21

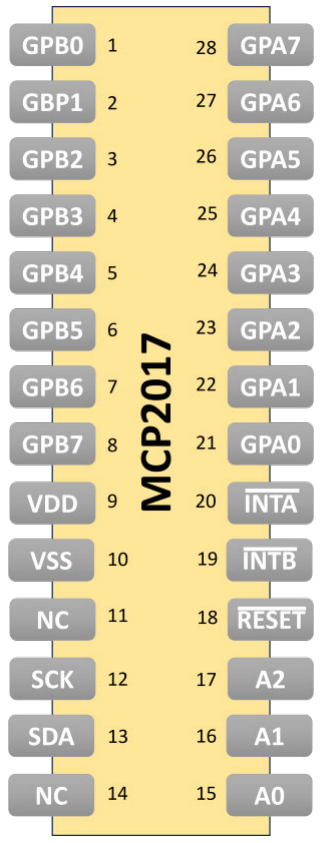
[picture p37: figure]

Rysunek 3.3: Rozkład wyprowadzeń układu MCP23017 [14]

Na rysunku 3.3 został przedstawiony rozkład wyprowadzeń dla układu MCP23017 w obudowach SOIC, SPDIP, SSOP. Piny 1-8 to wyprowadzenia wejść/wyjść dla portu B. Zasilanie jest dostar-

czane przez VDD oznaczone na rysunku jako pin numer 9. Masa układu znajduje się tuż obok zasilania i jest oznaczona jako VSS - pin 10. W przypadku ekspandera komunikującego się po I²C

pin 12 to zegar magistrali (SCK), a pin 13 to dane (SDA). Pin 11 oraz 14 nie są podłączone. Ustawia-

nie adresu odbywa się na pinach 15-17. Pin RESET znajduje się na pozycji 18. Piny sygnalizujące przerwanie, znajdują się odpowiednio dla INT A - 20, INT B - 19. Piny 28-21 to wyprowadzenia wejść/wyjść dla portu A.

22 | Ekspandery wejść/wyjść równoległych

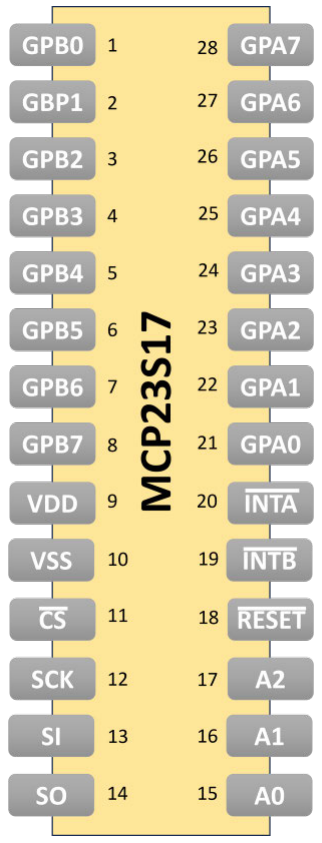
[picture p38: figure]

Rysunek 3.4: Rozkład wyprowadzeń układu MCP23S17 [14]

W przypadku układu MCP23S17 (rys. 3.4) rozkład wyprowadzeń różni się jedynie na pinach 11-14, gdzie wyprowadzone zostały połączenia interfejsu SPI. CS (ang. Chip Select - wybór układu) znajduje się na pinie 11. SCK, czyli zegar magistrali jest na pozycji 12. SI (ang. Slave Input -Wejście danych) jest oznaczone numerem 13. SO (ang. Slave Output - Wyjście danych) znajduje się na pinie 14. Należy zanaczyć, że piny adresowe (17-15) są nadal aktywne. Mimo, że jest to układ

zaprojektowany do komunikacji interfejsem SPI to nadal na jednym pinie CS można połączyć wiele układów MCP23S17, co redukuje ilość koniecznych pinów do podłączenia wielu układów do mikrokontrolera. W takim przypadku, nadal jako pierwszy bajt danych należy wysłać Optcode, który zawiera adres i wywołuje konkretny układ MCP23S17.

3.3. Układy MCP23x17 | 23

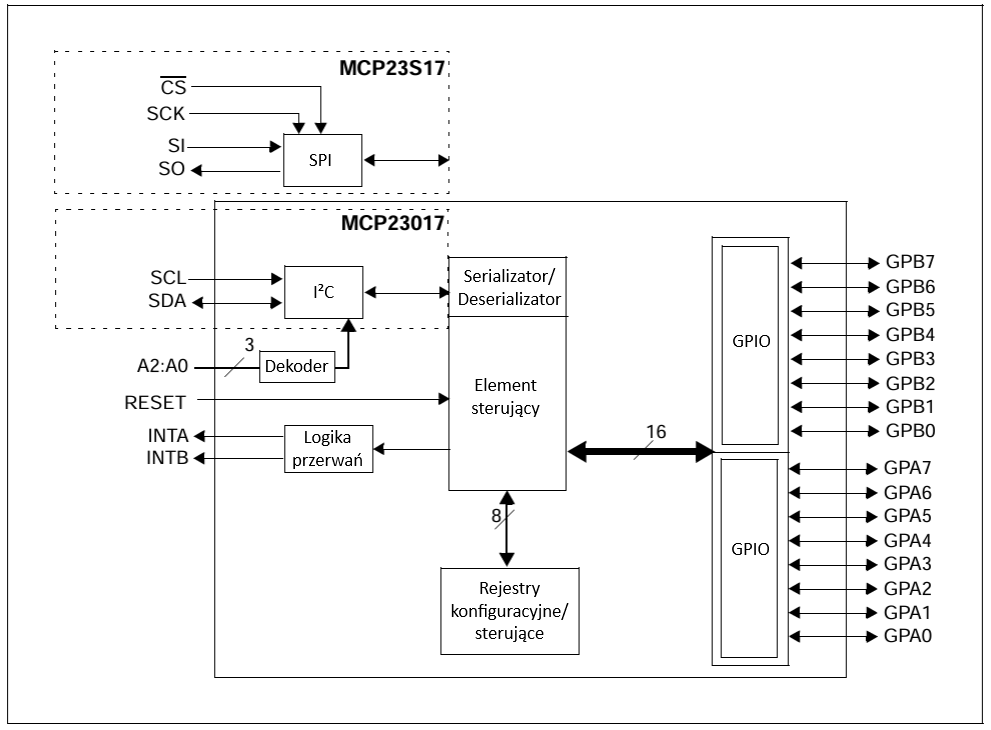
[picture p39: figure]

Rysunek 3.5: Schemat blokowy układu MCP23x17 [14]

Na rysunku 3.5 został przedstawiony schemat blokowy układów MCP23017 oraz MCP23S17. Można zauważyć, że cała logika dla obydwu układów jest taka sama, różnią się jedynie modułami obsługi interfejsów (odpowiednio I²C oraz SPI). Dane komunikacyjne wchodzą na blok serializa-

tora/deserializatora, który konwertuje przesyłane sygnały jako szeregowe na postać równoległą.

W takiej formie dane przyjmuje element sterujący. Jest to główny blok logiczny. To on koordynuje pracę układu, komunikuje się przy pomocy 8-bitowej szyny danych z rejestrami konfiguracyjnymi i sterującymi, w których przechowywane są ustawienia poszczególnych wyprowadzeń. Właściwe stany logiczne są przekazywane przez 16-bitową szynę danych bezpośrednio do bloków wejścia/wyjścia (GPIO). Dzielą one dostępne linie na dwa 8-bitowe porty: Port A (wyprowadzenia GPA0-GPA7) oraz Port B (wyprowadzenia GPB0-GPB7). Architektura układu posiada również

układ logiki przerwań, która pozwala na sprzętowe powiadomienia podłączonego mikrokontrolera, o zmianach stanów na wejściach za pomocą linii INT A i INT B [14].

# Rozdział 4

# Projekt modułu LCD z 8-bitowymi

# ekspanderami PCF8574

## 4.1 Założenia techniczne

Projektowany moduł wspierający uruchomienie wyświetlaczy LCD powinien spełniać następujące warunki:

- obsługa wyświetlaczy LCD 2x16/4x20,
- wykorzystanie 8-bitowych ekspanderów I/O,
- możliwość korzystania z interfejsu równoległego (8-bit/4-bit transmisja danych),
- możliwość korzystania z interfejsu szeregowego I²C,
- możliwość konfigurowania interfejsu na płytce modułu,
- zapewnienie intuicyjnej konfiguracji połączeń,
- zapewnienie szeregowej transmisji danych i sygnałów sterujących,
- zasilanie zewnętrzne +5 V z systemu mikroprocesorowego,
- współpraca modułu z mikroprocesorami różnych rodzin,
- możliwość współpracy z modułami platformy Arduino,
- możliwość współpracy z modułami platformy ESP32,
- możliwość dostosowania kontrastu wyświetlacza LCD,
- łatwe serwisowanie modułu.

25

26 | Projekt modułu LCD z 8-bitowymi ekspanderami PCF8574

## 4.2 Koncepcja modułu

| W procesie tworzenia płytki drukowanej, powstało wiele koncepcji dotyczących funkcjonalności
oraz rozłożenia elementów na płytce. Dzięki optymalnemu rozłożeniu elementów oraz dobremu prowadzeniu ścieżek, udało się zredukować rozmiar płytki z 156 mm szerokości, oraz 118 mm wysokości do 98 mm szerokości oraz 92 mm wysokości. W pierwszych wersjach płytek (rys. 4.1) złącza zasilania były po zewnętrznej stronie układu, w nowszych (rys. 4.3) wersjach zostały one osadzone między

złączami modułu ekspandera a wyświetlacza. Połączenia między modułem komunikacji równoległej, a układem komunikacyjnym z dwoma PCF8574 są konfigurowalne, można je połączyć wprost, aby sterować wyświetlaczem lub wykorzystać je jako piny wejściowe, dla dodatkowych układów. Połączenie jest intuicyjne, tak aby osoby początkujące miały ułatwioną możliwość konfiguracji.

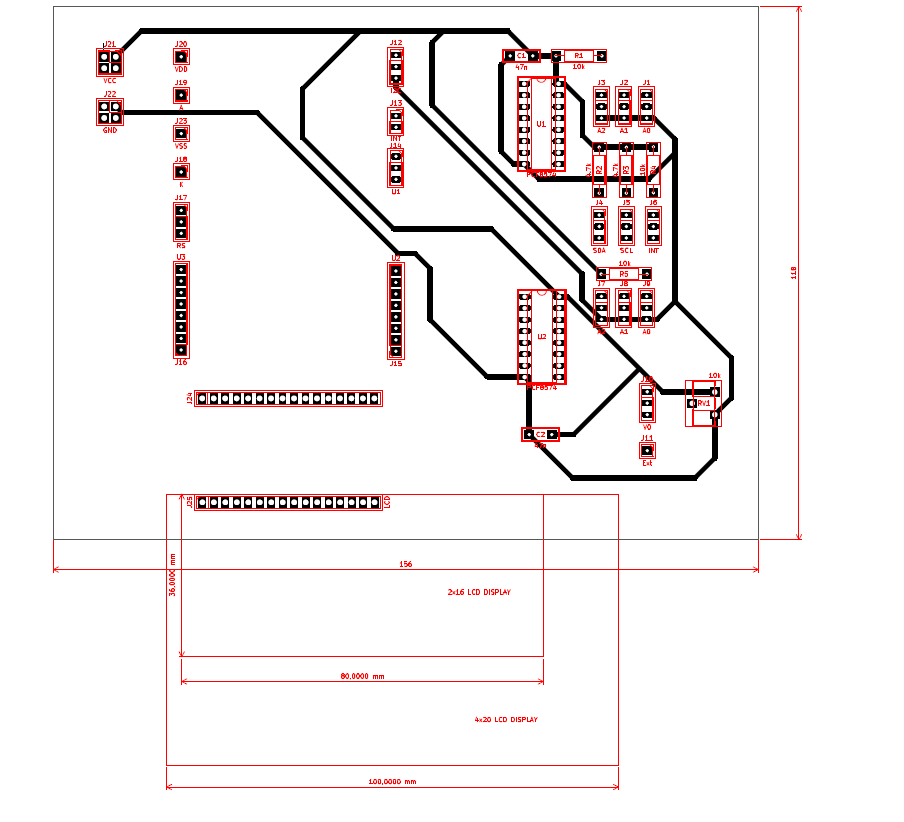
[picture p40: figure]

Rysunek 4.1: Szkic płytki z dwoma układami PCF8574, z układem elementów w wersji V1

4.3. Opis modułu | 27

## 4.3 Opis modułu

W celu ułatwienia zrozumienia zagadnień związanych ze sterowaniem standardowym wyświetlaczem, protokołów komunikacji I²C, oraz możliwościami konfiguracji systemu, została stworzona

płytka drukowana z dwoma układami PCF8574. Płytka PCB jest dedykowana dla rozmiarów wyświetlaczy 80 x 36 mm, jest to wyświetlacz z 2 wierszami oraz 16 kolumnami, oraz 98 x 60 mm
- 4 wiersze, 20 kolumn. Przedstawione rodzaje wyświetlaczy mają wspólne 16-pinowe wyjście, więc moduł jest z nimi w pełni kompatybilny. Wspierana jest zarówno komunikacja równoległa 4-bitowa, 8-bitowa, ale również ze względu na dwa ekspandery - szeregowa 8-bitowa i 4-bitowa. W konfiguracji 8-bitowej, jeden układ PCF8574 obsługuje 8 linii danych równoległych, natomiast drugi obsługuje trzy linie sterujące. W przypadku chęci wykorzystania drugiego ekspandera jako rozszerzenia wyjść mikrokontrolera, można zrezygnować z transmisji 8-bitowej na rzecz 4-bitowej transmisji. Wtedy proces komunikacji przejmuje jeden ekspander - 4 linie danych, oraz 3 sterujące. Drugi zostaje do dyspozycji programisty. Moduł doskonale radzi sobie z komunikacją, z płytkami ewaluacyjnymi, opartymi na mikrokontrolerach AVR, szczególnie z platfomą Arduino UNO. Ze względu na możliwość konfiguracji płytki oraz jej elastyczność programista ma dużą dowolność, jeżeli chodzi o sposób podłączenia peryferiów oraz ich obsługi w kodzie. Płytka drukowana staje się naturalnym rozszerzeniem możliwości platformy Arduino. Układ posiada możliwość konfiguracji adresów dla każdego z ekspanderów, dodatkowo można włączyć do obwodu rezystory 4,7 kΩ podciągające dla szyny I²C, oraz rezystor 10 kΩ dla złącza przerwań INT. Zapewniona została

możliwość wyboru podciągu, ze względu na ograniczenia prądowe dla różnych układów. W przypadku wielu mikrokontrolerów istnieje też możliwość załączenia rezystorów wewnętrznych. W razie konieczności, można też skorzystać z innych rezystorów ograniczających, wyłączając wbudowane rezystory. Płytka jest zasilana napięciem +5 V. W przypadku korzystania z platformy Arduino nie

jest konieczne stosowanie dodatkowych zasilaczy, ze względu na mały pobór prądu przez moduł, można go zasilać bezpośrednio z np. Arduino UNO. Zostały opracowane wersje modułów zarówno z soldermaską pod wytrawianie przez firmy zewnętrzne oraz z frezowaniem ścieżek, które mogą zostać wykonane bezpośrednio na uczelni, ograniczając potrzebę wykorzystania skomplikowanego procesu technologicznego.
Na rysunku 4.2 został przedstawiony schemat ideowy płytki drukowanej z dwoma układami PCF8574. Jest to układ znacznie bardziej zaawansowany, niż popularne tanie moduły ”I²C Back-

pack”, wykorzystujące jeden moduł PCF8574 i pozwalające jedynie na komunikację 4-bitową. Rozwiązanie opracowane w ramach tej pracy obejmuje dwa układy PCF8574, co pozwala na realizację pełnej transmisji 8-bitowej. Jest to świetne rozwiązanie do nauki oraz eksperymentowania z wyświetlaczami opartymi na sterowniku HD44780U. Komunikacja 8-bitowa jest znacznie prostsza w implementacji programowej po stronie mikrokontrolera. Na schemacie widoczny jest również podział ról. Ekspander U2 obsługuje linie danych. Jego porty P0-P7 są podłączone poprzez złącze J15 oraz szynę U3 do pinów D0-D7 wyświetlacza LCD (piny 7-14 na złączu J25). Ekspandr U1 obsługuje linie sterujące. Jego porty P0-P2 są doprowadzone na piny 4-6 złącza J25 (LCD). Wyprowadzenia magistrali I²C znajdują się na pinach oznaczonych J12 (SDA-1, SCL-2). Złą-

cza te są podłączone do zworek J4 (SDA) oraz J5 (SCL), które umożliwiają włączenie lub wyłączenie

rezystorów 4, 7kΩ, przydatne gdy już inne urządzenia posiadają swój pull-up. Obok wyprowadzenia magistrali szeregowej znajduje się pin J13 obsługujący przerwania (INT) oraz odpowiadająca mu zworka J6 pozwalająca sterować obwodem pull-up dla przerwań (rezystor 10kΩ).

28 | Projekt modułu LCD z 8-bitowymi ekspanderami PCF8574

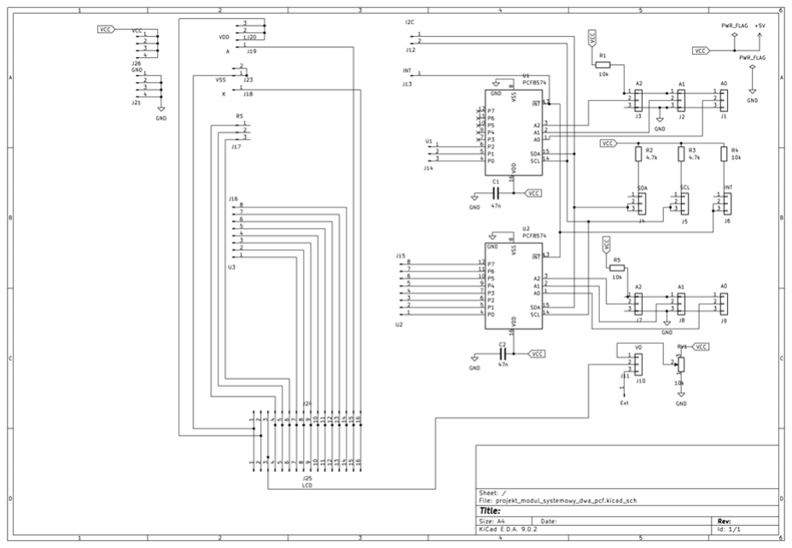
[picture p41: figure]

Rysunek 4.2: Schemat modułu z dwoma układami PCF8574

Każdy z układów posiada zworki konfigurujące sprzętowy adres magistrali (J1, J2, J3 dla U1 oraz J7, J8, J9 dla U2). Rozwiązanie to pozwala na uniknięcie konfiltów adresów na magistrali

i precyzyjne przypisanie różnych adresów bazowych dla bloku sterowania i bloku danych. Zastosowanie układów scalonych wykonanych w technologii CMOS, wymaga eliminacji zakłóceń wysokoczęstotliowościowych w liniach zasilających, które powstają podczas szybkiego przełączania stanów logicznych. Każdy z układów PCF8574 posiada kondensator odsprzęgający (C1 oraz C2)
[27] o pojemności 47 nF. Za poprawną czytelność znaków na wyświetlaczu odpowiada potencjo-

metr montażowy RV1 o rezystancji 10 kΩ dołączony do pinu V0 wyświetlacza. Działa on jako dzielnik napięcia, między linią VCC a masą układu. Jego włączenie do układu jest również konfiguowalne na poziomie sprzętowym za pomocą zworki J10. Umożliwia ona wybór między wewnętrznym potencjometrem, a zewnętrzym źródłem odniesienia oznaczonym jako Ext. Złącza J18 oraz J19 pozwalają na elastyczne zarządzanie zasilaniem anody i katody podświetlenia. Dzięki zastosowaniu zworek możliwe jest stałe podłączenie podświetlenia do zasilania lub wyprowadzenie sterowania na zewnątrz.

## 4.4 Płytka PCB z soldermaską

Zaprojektowany moduł stanowi uniwersalną płytkę bazową pełniącą rolę zaawansowanego konwertera transmisji zarówno szeregowej na równoległą, jak i równoległej na szeregową. Płytka została zaprojektowana do celów ewaluacyjnych i rozwojowych. Została przewidziana duża liczba wyprowadzeń testowych oraz zworek konfiguracyjnych.

4.4. Płytka PCB z soldermaską | 29

Główny obrys płytki drukowanej (rys. 4.2) wynosi 98 na 92 mm. Posiada ona cztery otwory

montażowe po rogach płytki oraz jeden w środku. Pozwala to na stabilne zamontowanie płytki do obudowy. Na projekcie naniesiono obrysy referencyjne dwóch popularnych typów wyświetlaczy 2x16 oraz 4x20. Wyświetlacz podłączony do złącza J25 wystaje poza płytkę. Daje to oszczędność miejsca w obudowie, oraz pełen wgląd w strukturę płytki, w razie koniecznych modyfikacji połączeń lub konfiguracji zworek.
Warstwa górna przeznaczona jest na montaż elementów przewlekanych (THT). Znajdują się tu kor-

pusy układów scalonych, złącza, zworki, rezystory, kondensatory oraz potencjometr. Na tej warstwie znajdują się również ścieżki zasilające układy oraz połączenia masy.
Elementy na płytce zostały umieszczone uwzględniając podział na bloki funkcjonalne. Układy scalone U1, U2 oraz ich kondensatory odprzęgające zostały umieszczone w centrum płytki, co minimalizuje długość ścieżek sygnałowych do złącz konfiguracyjnych. Złącza te zostały zgrupowane w lewej części płytki. Podłączenie ich jest bardzo intuicyjne, aby płytka zadziałała w trybie szeregowej transmisji danych wystarczy połączyć złącze z lewej strony do złącza odpowiadającego z prawej strony. W przypadku chęci skorzystania z transmisji równoległej, wystarczy wpiąć się w złącza po prawej stronie bloku konfiguracyjnego. Sekcja komunikacji z wyświetlaczem została wyraźnie rozdzielona od sekcji zasilania oraz komunikacji z układami PCF8574. Po prawej stronie płytki znajduje się blok konfiguracyjny. To właśnie na tej stronie znajdują się zworki konfiguracyjne oraz rezystory pull-up. W tym bloku można skonfigurować adres układów PCF8574 oraz włączyć lub wyłączyć sprzętowy pull-up dla szyny I²C lub linii przerwań INT. Poniżej znajduje

się potencjometr regulujący kontrast wraz z jego zworkami konfiguracyjnymi.
Warstwa opisowa (ang. Silkscreen) została bardzo szczegółowo opisana, co pozwoli na uniknięcie

wielu błędów podczas konfiguracji układu. Zastosowano czytelne etykiety dla poszczególnych bloków ”PULL UP”, ”DATA”, ”CON”(ang. Control), co ułatwia diagnostykę i uruchamianie układu

bez konieczności ciągłego spoglądania na schemat ideowy. Każda ze zworek również jest oznaczona, a zworki mają dodatkowo opisane stany logiczne ”1”i ”0”, co minimalizuje błędy złej adresacji układów. Piny zasilania oraz magistrali komunikacyjnej (SDA, SCL) są jednoznacznie zidentyfikowane.

Na spodniej stronie płytki, przedstawionej na rysunku 4.4 zostały poprowadzone ścieżki sygnałowe. Zgodnie z dobrymi praktykami projektowymi, odstępy izolacyjne ang. clearance między ścieżkami oraz między padami a ścieżkami są duże. Zabieg ten z jednej strony znacząco ułatwia ręczny montaż elementów w technologii przewlekanej (THT) i ogranicza ryzyko zwarć (tzw. mostków lutowniczych). Po drugie, zwiększony dystans między równoległymi liniami sygnałowymi zmniejsza

pojemności pasożytnicze, co korzystnie wpływa na integralność przesyłanych sygnałów, zwłaszcza w obszarze 8-bitowej magistrali danych [7, 19].

30 | Projekt modułu LCD z 8-bitowymi ekspanderami PCF8574

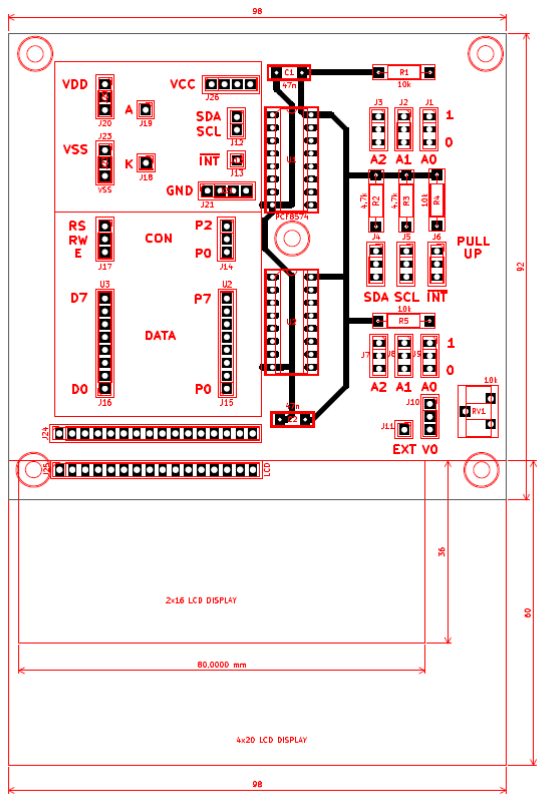
[picture p42: figure]

Rysunek 4.3: Szkic płytki z dwoma układami PCF8574

4.4. Płytka PCB z soldermaską | 31

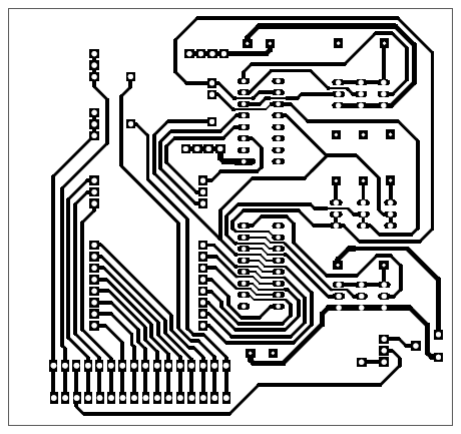
[picture p43: figure]

Rysunek 4.4: Szkic spodniej strony płytki z dwoma układami PCF8574

32 | Projekt modułu LCD z 8-bitowymi ekspanderami PCF8574

## 4.5 Płytka PCB z frezowaniem ścieżek

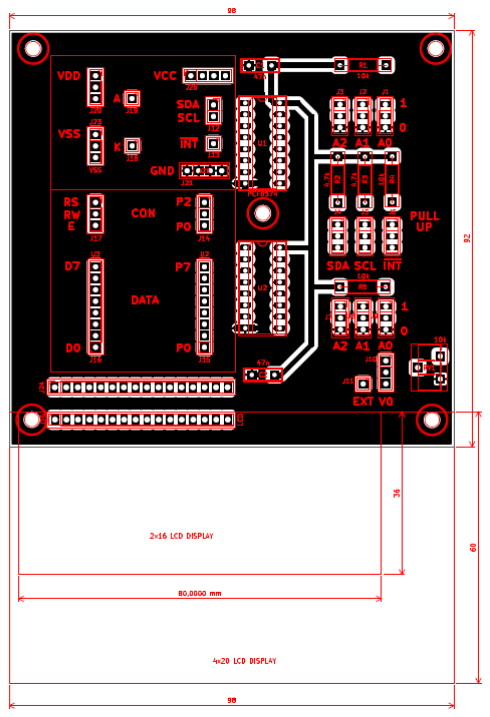
[picture p44: figure]

Rysunek 4.5: Szkic płytki z dwoma układami PCF8574 wersja pod frezowanie

W tej sekcji przedstawiono wersję płytki, która może zostać wykonana lokalnie na uczelni. Jest to wersja zoptymalizowana pod kątem wytwarzania metodą obróbki ubytowej - frezowania izolacyjnego CNC. Pod względem elektrycznym i topologicznym układ zachowuje funkcjonalność pierwowzoru. Strona wierzchnia płytki (rys. 4.5) to strona montażowa. Ponieważ jest to płytka wykonywana lokalnie i nie zawiera pokrycia izolacyjnego (ang. solder mask) oraz nadruków (ang. silkscreen), napisy zostaną umieszczone poprzez naklejenie odpowiednich etykiet. Nie zdecydowano się na frezowanie napisów w miedzi. To stwarzałoby ryzyko zwarć (odprysk miedzi), ale też obniżało

estetykę a nawet czytelność napisów. Aby zapobiec utlenianiu miedzi, zalecane jest polakierowanie

powierzchni płytki.

4.5. Płytka PCB z frezowaniem ścieżek | 33

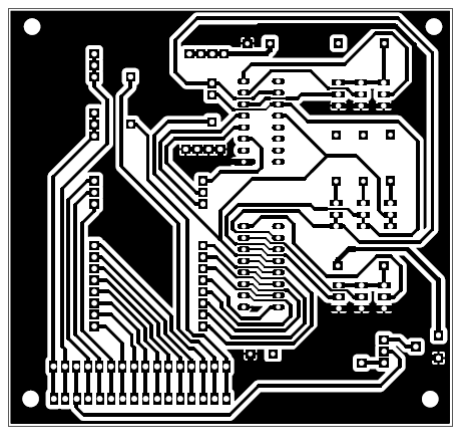
[picture p45: figure]

Rysunek 4.6: Szkic spodniej strony płytki z dwoma układami PCF8574 wersja pod frezowanie

Dolna warstwa płytki (rys. 4.6) zawiera ścieżki oraz pola lutownicze. Został zastosowany większy

odstęp między polem masy a, padami montażowymi, co ułatwi montaż i lutowanie. Cyna nie będzie się rozlewać i powodować zwarcia do masy.
Rozmieszczenie elementów jest podyktowany łatwością prowadzenia ścieżek przy użyciu frezarki, gdzie przelotki są problematyczne do wykonania w warunkach domowych. Pady mas w układach PCF8574 (U1 oraz U2) zostały wydłużone, gdyż pin ten pełni również rolę przelotki, więc rozgrzanie

go po obu stronach płytki zapewni dobry rozpływ cyny, a w konsekwencji stabilne połączenie elektryczne.
Zestaw złącz, układów, zworek, kondensorów oraz rezystorów nie został zmieniony. Nie zmienił się również ich rozkład.

# Rozdział 5

# Projekt modułu LCD z 16-bitowym

# ekspanderem MCP23017

## 5.1 Założenia techniczne

Projektowany moduł wspierający uruchomienie wyświetlaczy LCD powinien spełniać następujące warunki:

- obsługa wyświetlaczy LCD 2x16/4x20,
- wykorzystanie 16-bitowych ekspanderów I/O,
- możliwość korzystania z interfejsu równoległego (8-bit/4-bit transmisja danych),
- możliwość korzystania z interfejsu szeregowego I²C,
- możliwość konfigurowania interfejsu na płytce modułu,
- zapewnienie intuicyjnej konfiguracji połączeń,
- zapewnienie szeregowej transmisji danych i sygnałów sterujących,
- zasilanie zewnętrzne +5 V z systemu mikroprocesorowego,
- współpraca modułu z mikroprocesorami różnych rodzin,
- możliwość współpracy z modułami platformy Arduino,
- możliwość współpracy z modułami platformy ESP32,
- możliwość wykorzystania 5 linii jako I/O ogólnego przeznaczenia,
- możliwość dostosowania kontrastu wyświetlacza LCD,
- łatwe serwisowanie modułu.

35

36 | Projekt modułu LCD z 16-bitowym ekspanderem MCP23017

## 5.2 Koncepcja modułu

| W trakcie tworzenia modułu wykonano kilka wersji projektowych. Aby osiągnąć mniejszy roz-

miar płytki drukowanej konieczna była zmiana położenia większości elementów, które znajdowały się w module z układami PCF8574. W finalnej wersji obrócono ekspander o 90 stopni tzn. równolegle do ekranu. Pozwoliło to na przemieszczenie układu scalonego w część centralną PCB, co zwolniło dużo miejsca po bokach płytki. Głównym założeniem przy tym projekcie było maksymalne zbliżenie elementów do siebie, o ile była taka możliwość. Znaczącą zmianą względem modułu z rozdziału nr. 4 jest przeniesienie sekcji zasilania (VSS, VCC, VDD i GND). Przekształcono również umiejscowienie złączy adresowych, sterowniczych i komunikacyjnych. Oba porty wejść/wyjść zostały rozdzielone

na płytce w taki sposób, aby jedno złącze było intuicyjnie naprzeciwko złącz wyświetlacza, natomiast drugie wstawiono na lewym brzegu płytki. Rezystory podciągające przemieszczono na prawą stronę PCB. Zmianom położenia nie podlegał potencjometr do ustawiania kontrastu wyświetlacza. Finalne rozmiary płytki drukowanej to 80x70 mm, więc względem płytki z dwoma PCF8574 skrócono szerokość o 18 mm i wysokość o 15 mm.

## 5.3 Opis modułu

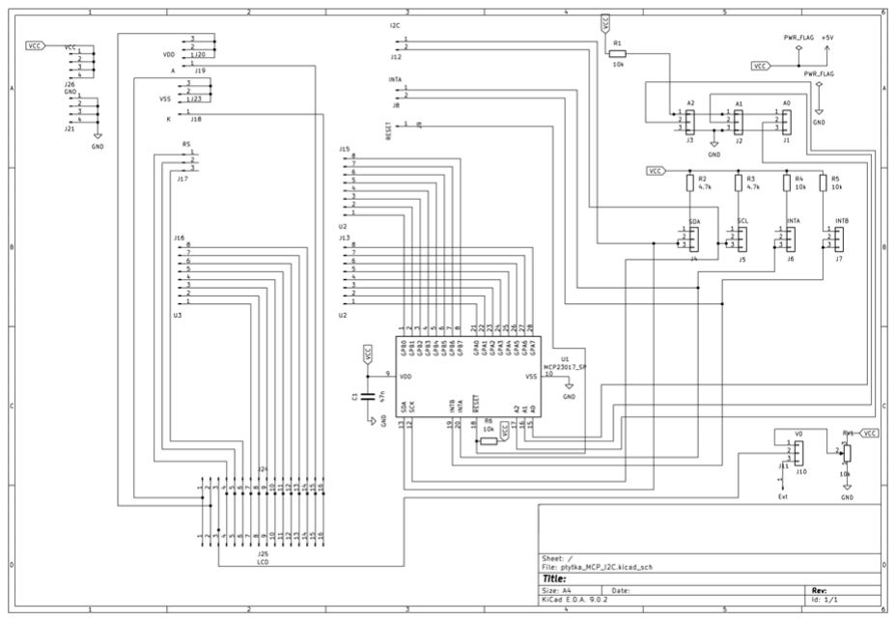
[picture p46: figure]

Rysunek 5.1: Schemat ideowy modułu z MCP23017

Projekt modułu oparty na układzie PCF8574 pozwolił na zdobycie potrzebnego doświadczenia i oswojenie się z zadaniami, układem na płytce drukowanej i ograniczeniami w procesie projektowania. Zdobyte doświadczenie stworzyło idealny fundament pod projekt modułu z wykorzystaniem

5.4. Płytka PCB z soldermaską | 37

rozbudowanego ekspandera MCP23017. Płytka drukowana miała przejść ewolucję, w której zawrze się implementację pod nowy układ scalony. Dzięki omówionym wcześniej przewagom MCP23017 nad PCF8574 możliwe było ograniczenie liczby układów z 2 na 1. Projekt w swoich założeniach miał obsługiwać dwa rodzaje wyświetlaczy LCD o tych samych parametrach, co w koncepcji z ekspanderemi PCF8574. Układ MCP23017 korzysta z interfejsu I²C. Jednym z wyzwań przy tworzeniu płytki

drukowanej była minimalizacja jej rozmiarów. Moduł został skonstruowany z myślą o intuicyjnym zastosowaniu przez użytkownika, dlatego zostały naniesione czytelne opisy złącz. Układ zaprojektowano do działania z różnymi typami mikrokontrolerów. Wyprodukowano dwie wersje modułu, dedykowane na zamówienie (z soldermaską) i do wyfrezowania na uczelni.

Na rysunku 5.1 znajduje się schemat ideowy omawianego modułu. Zawiera on wszystkie potrzebne połączenia do komunikacji z wyświetlaczem LCD, którego złącze jest na dole schematu. Na środku znajduje się układ scalony MCP23017 z wszystkimi potrzebnymi peryferiami. Złącza J15 i J13 są połączone z portami wejść/wyjść ekspandera. Zaobserwować można złącza do podciągania linii interfejsu I²C, pola adresowe czy wyjścia przerwań.

## 5.4 Płytka PCB z soldermaską

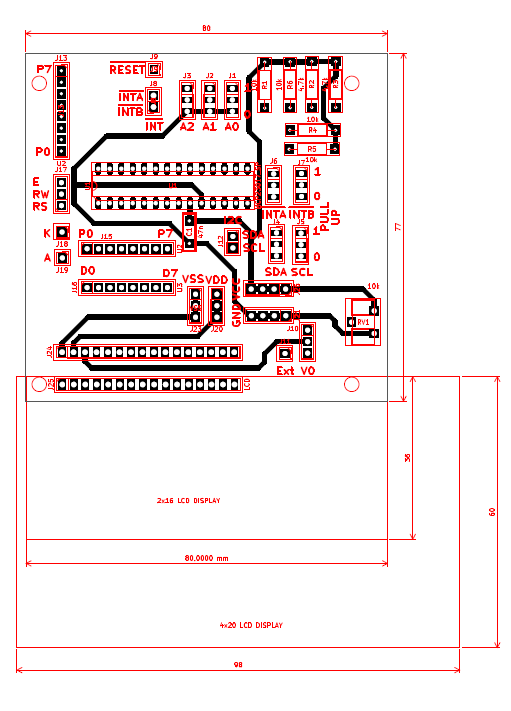
[picture p47: figure]

Rysunek 5.2: Szkic płytki drukowanej opartej na układzie MCP23017

38 | Projekt modułu LCD z 16-bitowym ekspanderem MCP23017

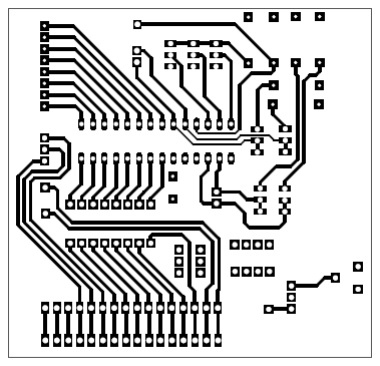
[picture p48: figure]

Rysunek 5.3: Szkic spodniej strony płytki opartej na układzie MCP23017

Rysunek przedstawia płytkę PCB przeznaczoną do produkcji dal podmiotów zewnętrznych. Układ zawiera warstwę ochronną tzn. soldermaskę, która pozwala na bezpieczne korzystanie z przedstawionego rozwiązania. Na rysunkach 5.2 i 5.3 przedstawiono wygląd warstwy wierzchniej i spodniej płytki drukowanej [7, 19].

## 5.5 Płytka PCB z frezowaniem ścieżek

Perspektywa samodzielnego wytwarzania obwodów drukowanych (PCB) przy użyciu zaplecza

sprzętowego instytutu wymusiła konieczność gruntownej rewizji przyjętych wcześniej założeń projektowych. Technologia frezowania izolacyjnego (CNC) znacząco różni się od klasycznych metod

trawienia chemicznego, narzucając rygorystyczne obostrzenia w zakresie topologii obwodu. Fizyczne wymiary narzędzia skrawającego (frezu typu grawerskiego) zdefiniowały minimalny, krytyczny odstęp izolacyjny (ang. clearance) pomiędzy sąsiadującymi polami lutowniczymi oraz ścież-

kami. Zbyt gęste upakowanie elementów mogłoby uniemożliwić przejście frezu, skutkując powstawaniem zwarć.
Szczególną uwagę zwrócono na kąty prowadzenia połączeń – konsekwentnie stosowano załamania o kącie 45 stopni, co ułatwia płynną, ciągłą pracę wrzeciona maszyny i zapobiega niepotrzebnemu zużyciu narzędzi. Ponadto, w celu skrócenia czasu pracy frezarki, nieużywane przestrzenie na płytce wypełniono płaszczyzną miedzi, pozostawiając jedynie wąski kontur izolacyjny wokół właściwych ścieżek. Wdrożenie tych restrykcyjnych reguł projektowych (DRC) zaowocowało stwo-

rzeniem finalnej wersji płytki, w pełni zoptymalizowanej pod kątem bezproblemowej produkcji maszynowej na terenie instytutu.

5.5. Płytka PCB z frezowaniem ścieżek | 39

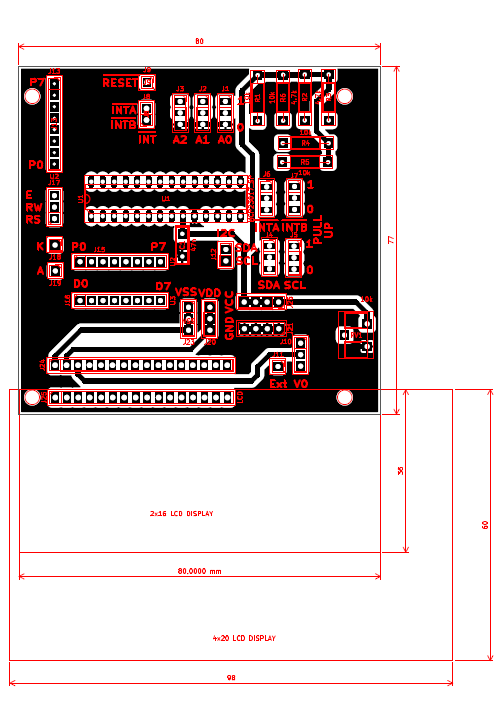
[picture p49: figure]

Rysunek 5.4: Szkic płytki drukowanej opartej na układzie MCP23017, wersja pod frezowanie

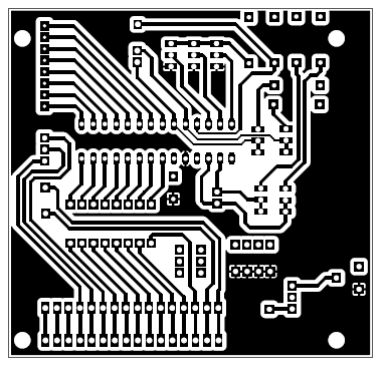
[picture p50: figure]

Rysunek 5.5: Szkic spodniej strony płytki opartej na układzie MCP23017, wersja pod frezowanie

# Rozdział 6

# Projekt modułu LCD z 16-bitowym

# ekspanderem MCP23S17

## 6.1 Założenia techniczne

Ograniczenia magistrali I²C, ale też bardzo podobna struktura układu MCP23S17, skłoniły

do stworzenia modułu obsługującego magistralę SPI. Wspomniany układ ma te same rejestry co jego bliźniaczy odpowiednik MCP23017, co od programisty, w przypadku chęci osiągnięcia większej przepustowości, wymaga jedynie zmiany protokołu komunikacyjnego. Jest to modyfikacja poprzedniego modułu. Różni się zastosowanym układem U1, który współpracuje z magistralą SPI oraz wyprowadzeniem pinów magistrali. W przypadku I²C, były to dwa piny, a w przypadku

SPI to są aż cztery piny. Reszta parametrów pozostała bez zmian.
W związku z tym założenia projektowe można ująć podobnie jak dla modułu MCP23017:
- obsługa wyświetlaczy LCD 2x16/4x20,
- wykorzystanie 16-bitowych ekspanderów I/O,
- możliwość korzystania z interfejsu równoległego (8-bit/4-bit transmisja danych),
- możliwość korzystania z interfejsu szeregowego SPI,
- możliwość konfigurowania interfejsu na płytce modułu,
- zapewnienie intuicyjnej konfiguracji połączeń,
- zapewnienie szeregowej transmisji danych i sygnałów sterujących,
- zasilanie zewnętrzne +5 V z systemu mikroprocesorowego,
- współpraca modułu z mikroprocesorami różnych rodzin,
- możliwość współpracy z modułami platformy Arduino,
- możliwość współpracy z modułami platformy ESP32,
- możliwość wykorzystania 5 linii jako I/O ogólnego przeznaczenia,
- możliwość dostosowania kontrastu wyświetlacza LCD,
- łatwe serwisowanie modułu.

41

42 | Projekt modułu LCD z 16-bitowym ekspanderem MCP23S17

## 6.2 Koncepcja modułu

| Zmiana układu scalonego nie spowodowała dużych zmian w kontekście rozmieszczenia złącz
wewnątrz płytki drukowanej. Jedyną różnicą względem poprzedniego modułu było dostosowanie się pod komunikację magistralą SPI. Skutkowało to usunięciem rezystorów podciągających do linii SDA i SCL. Wraz z rezystorami zniknęły złącza do podciągania szyn interfejsu I²C. Wolne miejsce

pozwoliło na dodanie portu 4-pinowego do obsługi nowej magistrali.

## 6.3 Opis modułu

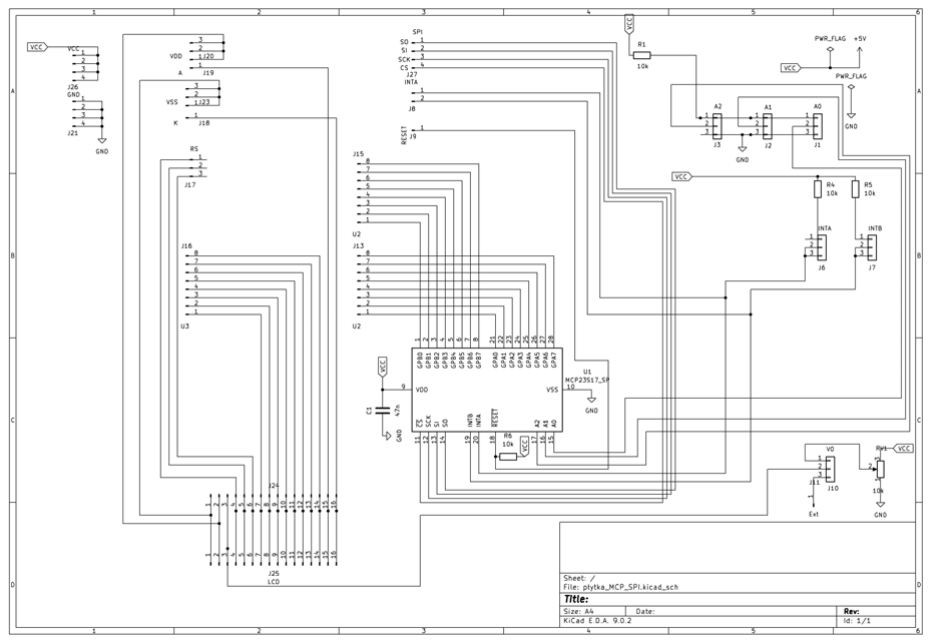
[picture p51: figure]

Rysunek 6.1: Schemat ideowy modułu z MCP23S17

Przedstawiony moduł sprzętowy realizuje komunikację z alfanumerycznym wyświetlaczem LCD za pomocą synchronicznej magistrali szeregowej SPI. W tym przypadku również jest dostępna pełna komunikacja równoległa. Jeden 16-bitowy układ obsłuży w pełni wyświetlacz. Upraszcza to znacząco prowadzenie ścieżek na płytce drukowanej i zmniejsza koszty produkcji. Komunikacja z mikrokontrolerem odbywa się poprzez złącze J27 (SPI). Zastosowanie magistrali SPI (linie MISO/SO, MOSI/SI, SCK, CS) pozwala na osiągnięcie znacznie większych prędkości transferu danych (do 10 MHz) w porównaniu do standardowego I²C. Zazwyczaj urządzenia SPI identyfikowane są za pomocą

linii wyboru ang. Chip Select (CS) dla każdego układu na magistrali. Układ MCP23S17 wspiera

jednak sprzętowe adresowanie w ramach tej samej ramki SPI. Dzięki temu w przypadku rozbudowy systemu, kilka takich ekspanderów może współdzielić tę samą fizyczną linię CS, co stanowi ogromną oszczędność pinów w mikrokontrolerze.

6.4. Płytka PCB z soldermaską | 43

16-bitowa przestrzeń wejść/wyjść układu MCP23S17 jest podzielona na dwa niezależne 8-bitowe banki (PORT A i PORT B). Na schemacie (rys. 6.1) widać wyraźny, funkcjonalny podział tych

portów. Wszystkie piny od GPB0 do GPB7 zostały doprowadzone przez złącze J15 do pinów D0-D7 na głównym złączu wyświetlacza J25. Szyna sterująca¹
, wykorzystuje pierwsze trzy piny portu A (GPA0-GPA2). Pozostałe piny pozostają niewykorzystane, co pozostawia rezerwę na ewentualną

rozbudowę.
Projekt zachowuje ciągłość technologiczną z poprzednimi modułami, powielając sprawdzone bloki funkcjonalne. Wykorzystywany jest reset sprzętowy - w przeciwieństwie do układów PCF, MCP23S17 posiada sprzętowe wejście resetujące układ. Zostało ono podciągnięte do zasilania poprzez rezystor R6 o wartości 10 kΩ i dalej wyprowadzone do złącza J9. W tym przypadku również zadbano o wyprowadzenie sygnałów przerwań dla INTA oraz INTB, do złącza J8, a za pomocą zworek J6 i J7 można włączyć PULL-UP poprzez rezystory R4 oraz R5, każdy o wartości 10 kΩ. Dalej jest wykorzystywany kondensator filtrujący C1 o wartości 47nF dla zasilania ekspandera [27].

Potencjometr RV1 do regulacji napięcia polaryzacji matrycy oraz złącza konfiguracyjne do zasilania układów oraz podświetlenia (anoda i katoda) pozostały bez zmian.

## 6.4 Płytka PCB z soldermaską

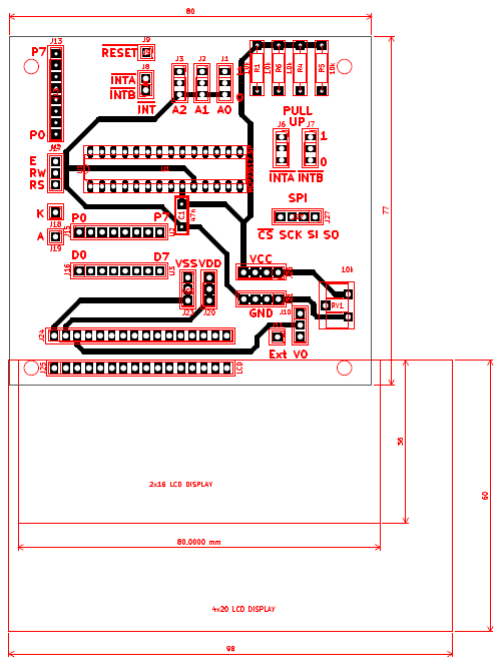
[picture p52: figure]

Rysunek 6.2: Szkic płytki drukowanej opartej na układzie MCP23S17

1
linie RS, RW, EN

44 | Projekt modułu LCD z 16-bitowym ekspanderem MCP23S17

Na rysunku 6.2 przedstawiono górną warstwę płytki drukowanej, opracowaną dla potrzeb produkcji przez podmiot zewnętrzny. Moduł posiada czytelne opisy złącz, tak aby używanie układu było intuicyjne. Płytka drukowana charakteryzuje się bardziej zwartą konstrukcją niż poprzednie wersje, a jej wymiary wynoszą 80 x 77 mm. Projekt został zrealizowany jako obwód dwuwarstwowy. Na warstwie górnej znajdują się korpusy elementów THT oraz stosowne opisy ułatwiające konfigurację oraz zrozumienie połączeń na płytce. Najważniejszym elementem w centralnej części płytki jest układ U1 - 16-bitowy ekspander. Przy jego nóżce zasilania (VCC) umieszczony został kondensator filtrujący C1 gwarantujący stabilność zasilania [27]. Po prawej stronie występują zworki

konfigurujące PULL-UP dla przerwań INTA oraz INTB, a tuż pod nimi złącze do kominikacji SPI. W prawej dolnej sekcji znajduje się potencjometr RV1 oraz jego zworki konfigurujące. W górnej części płytki znajdują się zworki konfigurujące adres urządzenia oraz wyprowadzenia INTA, INTB i RESET. Po prawej stronie zostały wyprowadzone pinu portu A, tuż pod nimi złącze sygnałów sterujących oraz zasilanie podświetlenia (anoda oraz katoda).
Warstwa opisowa (ang. Silkscreen) została szczegółowo opracowana. Złącze J27 jednoznacz-

nie opisuje każde połączenie dla magistrali SPI. Przerwania oraz reset zostały wyraźnie zaznaczone, a zworki adresowe dla układu MCP23S17 są wyraźnie oznaczone stanami logicznymi 0 i 1, tak jak w poprzednich projektach. W tej płytce również występuje 16-pinowe złącze J25 dla ekranu LCD.

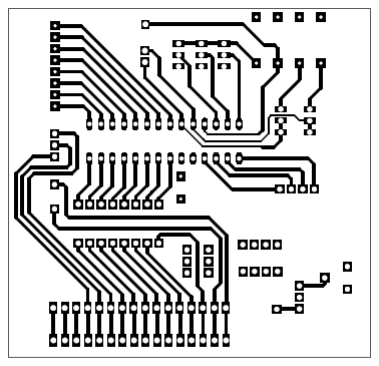
[picture p53: figure]

Rysunek 6.3: Szkic spodniej strony płytki opartej na układzie MCP23S17

Warstwa dolna płytki, przedstawiona na rysunku 6.3 zawiera w głównej mierze ścieżki sygnałowe oraz pady, do których lutowane są elementy. Ze względu na zastosowanie montażu przewlekanego THT to właśnie na tej stronie realizowane są fizyczne połączenia poprzez lutowanie. Należy zaznaczyć, że zadbano o odpowiednie grubości ścieżek oraz odstęp między nimi, aby ograniczyć zjawisko przesłuchów, co przy prędkościach transmisji występujących w protokole SPI jest ważne. To rozwiązanie zapewnia wysoką integralność sygnałów cyfrowych wymienianych z układem MCP23S17 [19, 7].

6.5. Płytka PCB z frezowaniem ścieżek | 45

## 6.5 Płytka PCB z frezowaniem ścieżek

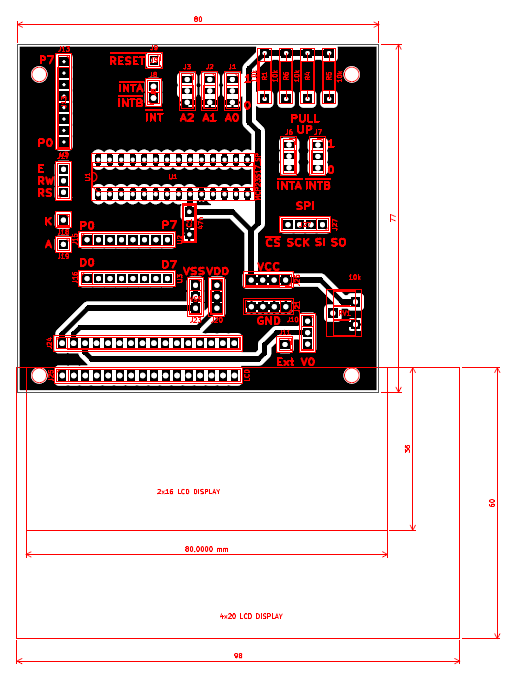
[picture p54: figure]

Rysunek 6.4: Szkic płytki drukowanej opartej na układzie MCP23S17 wersja pod frez

Wersja modułu zoptymalizowana pod kątem szybkiego wytworzenia z wykorzystaniem obróbki ubytkowej, tj. frezowania izolacyjnego CNC, zaprezentowana na rysunku 6.4 strona top, w porównaniu do poprzedniej wersji charakteryzuje się wylaną płaszczyzną masy na całej powierzchni płytki. Wybór tej technologii poniósł za sobą jeszcze kilka innych konsekwencji, podobnych jak w przypadku poprzedniej płytki. Pierwszą są napisy, w tym przypadku również zdecydowano o naklejanych napisach. Ze względu, na to, że ta płytka jest jeszcze mniejsza to miejsca na wygrawerowane napisy w miedzi przez maszynę CNC, niosłyby za sobą jeszcze większe ryzyko na powstanie zwarć, lub zerwanie połączeń. Gdyby zdecydowano się na małe napisy w miedzi byłyby one zdecydowanie mało czytelne, dlatego wybór naklejanych napisów wydaje się ścieżką optymalną.
Układ komunikuje się za pomocą magistrali SPI, która w przeciwieństwie do powolnego I²C

jest interfejsem znacznie szybszym, a dodatkowo synchronicznym (częstotliwość SCK może wynosić 10 MHz). Przy takich prędkościach zbocza sygnałów są bardzo strome, co generuje zakłócenia.

Płaszczyzna masy drastycznie zmniejsza impedancję pętli powrotnej i działa jak ekran elektromagnetyczny. Dodatkową korzyścią z wykorzystaniem płaszczyzny masy jest zwiększona odporność na zakłócenia zewnętrzne oraz mniejszą emisją zakłóceń elektromagnetycznych (EMI).

Białe pola widoczne na rysunku 6.4 to przestrzeń bez miedzi i to właśnie w tych miejscach ostrze maszyny numerycznej CNC będzie się poruszało, usuwając miedź i tworząc żądane połączenia elektryczne. Pozostałe pole miedzi minimalizuje czas pracy frezarki oraz znacząco wydłuża

46 | Projekt modułu LCD z 16-bitowym ekspanderem MCP23S17

żywotność narzędzi skrawających. Na warstwie górnej zdecydowano prowadzić ścieżki zasilania oraz jedyną ścieżkę sygnałową od potencjometru, aż do pinu V0 złącza wyświetlacza.

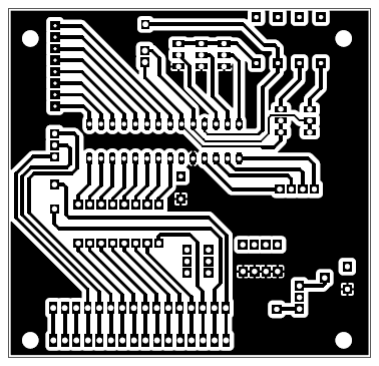
[picture p55: figure]

Rysunek 6.5: Szkic spodniej strony płytki opartej na układzie MCP23S17 wersja pod frez

Widoczna na rysunku 6.5 warstwa dolna płytki zawiera ścieżki sygnałowe, mają ode duży odstęp (ang. clearance), co ma zminimalizować ryzyko zwarć między sygnałami. Na tej warstwie

elementy będą lutowane do padów, większy odstęp pozwoli na łatwiejsze lutowanie elementów oraz zminimalizuje postania mostków lutowniczych między padami. Linie magistrali szybkiej SPI (SCK, SI, SO) są stosunkowo krótkie i otoczone masą, co zapobiega przesłuchom na wolniejsze,

asynchroniczne linie sterujące wyświetlaczem.

# Rozdział 7

# Projekt modułu LCD z 16-bitowymi

# ekspanderami MCP23x17

## 7.1 Założenia techniczne

Podczas fazy koncepcyjnej i projektowej dedykowanych modułów edukacyjnych opartych na 16-bitowych ekspanderach wejść/wyjść, wyłoniono innowacyjną koncepcję zintegrowania dwóch niezależnych interfejsów komunikacyjnych na wspólnym obwodzie drukowanym (PCB). Zdecydowano się na fizyczne połączenie w obrębie jednego laminatu układu MCP23017 (wykorzystującego magistralę

I

2C) oraz jego odpowiednika MCP23S17 (sterowanego za pomocą szybkiej magistrali SPI).

Dzięki takiej hybrydowej topologii, docelowy użytkownik modułu – na przykład student w laboratorium dydaktycznym – zyskuje możliwość płynnego i natychmiastowego przełączania się pomiędzy różnymi standardami transmisji szeregowej. Nie wymaga to przepinania samej matrycy LCD, modyfikacji głównych przewodów sygnałowych czy wymiany całych płytek testowych. Stanowi to doskonałe, zintegrowane narzędzie do bezpośredniej analizy porównawczej obu protokołów, pozwalające na empiryczne badanie różnic w opóźnieniach programowych, przepływności danych oraz złożoności obsługi warstwy sprzętowej. Mimo iż zintegrowany układ charakteryzuje się relatywnie większą powierzchnią laminatu w porównaniu do pojedynczych rozwiązań, w ogólnym rozrachunku znacząco optymalizuje przestrzeń roboczą i ułatwia przechowywanie sprzętu w zapleczu laboratoryjnym, eliminując potrzebę dublowania tych samych złącz i peryferiów.
W konsekwencji założenia techniczne dla projektowanej płytki są następujące:
- obsługa wyświetlaczy LCD 2x16 i LCD 4x20 z typowym złączem 16-pin,
- wykorzystanie 16-bitowego ekspandera I/O z interfejsem I²C,
- wykorzystanie 16-bitowego ekspandera I/O z interfejsem SPI,
- możliwość korzystania z interfejsu równoległego (8-bit/4-bit transmisja danych),
- konfigurowanie interfejsów na płytce modułu,
- czytelność i intuicyjność interfejsów konfiguracyjnych,
- dołączanie/odłączanie rezystorów podciągających dla linii SDA, SCL,
- dołączanie/odłączanie rezystorów podciągających dla linii OD (ang. Open Drain),

47

48 | Projekt modułu LCD z 16-bitowymi ekspanderami MCP23x17
- możliwość konfigurowania wolnych linii I/O,
- konfigurowanie 3 bitowych adresów dla układów ekspanderów,
- zasilanie zewnętrzne systemu mikroprocesorowego,
- współpraca modułu z mikroprocesorami różnych rodzin
- możliwość współpracy z modułami platformy Arduino,
- możliwość współpracy z modułami platformy ESP32.

## 7.2 Koncepcja modułu

Znaczącym wyzwaniem z zakresu inżynierii komputerowego wspomagania projektowania (CAD) okazał się optymalny rozkład przestrzenny (ang. component placement) głównych układów scalo-

nych. Zastosowanie standardowych, przewlekanych obudów typu DIP-28 dla wieloportowych ekspanderów wymaga zagospodarowania dużej powierzchni laminatu. W początkowej fazie projektowania rozważano horyzontalną orientację układów względem złącza wyświetlacza. Wstępne analizy trasowania ścieżek wykazały jednak, że ułożenie poziome drastycznie komplikuje wyprowadzenie magistral sygnałowych i wymusza niepożądane, głębokie modyfikacje w wypracowanym już, ergonomicznym układzie złącz peryferyjnych. Zmiana ta zaburzyłaby również czytelność warstwy opisowej (ang. silkscreen), co w przypadku narzędzia dydaktycznego jest zjawiskiem wysoce niepożądanym.

Ostatecznie zdecydowano się na orientację pionową, która umożliwiła zachowanie symetrii i logicznego podziału płyty na niezależną sekcję I²C (układ U1) oraz sekcję SPI (układ U2).

Z uwagi na konieczność implementacji znacznej liczby złącz konfiguracyjnych i elementów pasywnych, początkowa wersja modułu osiągnęła wymiary 136 mm szerokości oraz 95 mm wysokości. Na ten stosunkowo duży rozmiar bezpośrednio wpłynęła potrzeba umieszczenia obwodów kondycjonujących i sterujących. Jak wynika z analizy schematu ideowego, na płycie zaimplementowano między innymi:
Dedykowane rezystory podciągające (ang. pull-up) o wartości 4.7 kΩ i 10 kΩ dla linii sygnałowych magistrali I²C (SDA, SCL) oraz linii resetujących.

Rozbudowane bloki wyboru adresów sprzętowych. Zastosowanie zworek dla linii A0, A1 i A2 pozwala na fizyczną modyfikację adresu każdego z ekspanderów, co sprzętowo umożliwia podłączenie do ośmiu takich samych układów na jednej magistrali bez ryzyka wystąpienia konfliktu adresowego. Pełny dostęp do sprzętowych linii przerwań (INTA, INTB) dla obu układów, pozwalający na im-

plementację zaawansowanych algorytmów asynchronicznych w programie mikrokontrolera. Dodatkowo, moduł wyposażono we wspólny, 16-pinowy interfejs dla wyświetlacza alfanumerycznego, zintegrowany z precyzyjnym potencjometrem do regulacji kontrastu matrycy (RV1) oraz dedykowanymi wyprowadzeniami dla zasilania podświetlenia (piny A i K). Tak duża gęstość kom-

ponentów THT na obwodzie drukowanym wymagała rygorystycznego zaplanowania tras sygnałowych, aby uniknąć konieczności stosowania wielowarstwowych struktur PCB, co z powodzeniem zrealizowano zachowując klasyczną topologię dwuwarstwową.

7.2. Koncepcja modułu | 49

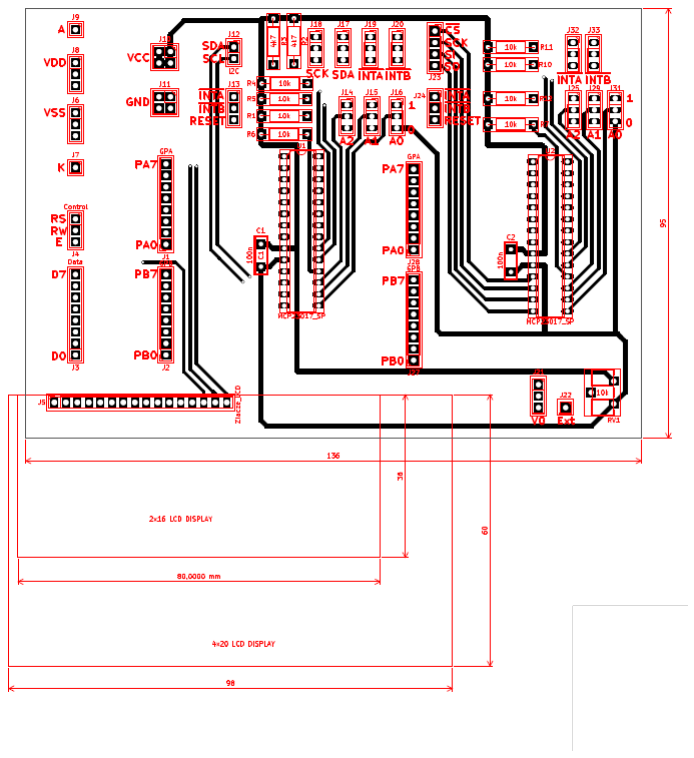
[picture p56: figure]

Rysunek | 7.1: | Pierwsza wersja szkicu wierzchniej strony płytki z modułami
MCP23x17

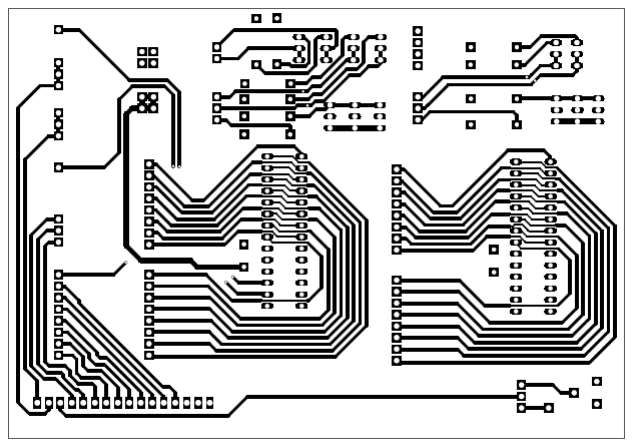
[picture p57: figure]

Rysunek | 7.2: | Pierwsza wersja szkicu spodniej strony płytki z modułami
MCP23x17

Każda następna wersja płytki drukowanej konsekwentnie zmniejszała jej fizyczne wymiary. Ogromny postęp w pracy osiągnięto poprzez umiejętne poprowadzenie ścieżek z przelotkami, zmianą orientacji na poziomą złącz adresowych, złącz przerwań i podciągów interfejsu I²C. W projekcie

wykorzystano również drabinki rezystorowe typu SIL9 oraz SIL5, dzięki czemu zmniejszono obszar przeznaczony dla rezystorów. Zadbano również o czytelność modułu dla użytkownika. Obszary danych magistral szeregowych zostały przegrodzone wyraźnymi prostokątami, wraz z odpowiednimi nazwami interfejsu. Finalna wersja płytki z dwoma ekspanderami miała wymiary 97,7 mm szerokości i 98,8 mm wysokości. Regularna i sumienna praca pozwoliły na stworzenie modułu o podobnych

50 | Projekt modułu LCD z 16-bitowymi ekspanderami MCP23x17

rozmiarach do płytki z działu czwartego, natomiast upakowanie komponentów, jak i samo zaawansowanie modułu były bez porównania większe.

## 7.3 Opis modułu

Zaprojektowany układ pełni funkcję uniwersalnego modułu rozszerzeń portów wejścia/wyjścia.

Głównym zadaniem modułu było zwiększenie liczby linii sterujących i obsługa standardowego wyświetlacza LCD. Układ wykorzystywał dwa najpopularniejsze interfejsy szeregowe tzn. SPI oraz I

2C. Płytkę PCB podzielono na dwie sekcje, zależne od obsługiwanej magistrali. Dużą zaletą za-

projektowanego modułu była możliwość korzystania z dwóch interfejsów jednocześnie. Głównym zamysłem takiego podejścia była współpraca układu zarówno z wyświetlaczem, jak i różnego rodzaju czujnikami, które obsługiwały jedną z dostępnych magistral. Takie rozwiązanie pozwalało na wykorzystanie pojedynczego projektu do wielu liczby pomysłów np. pomiar temperatury lub transmisja bezprzewodowa.

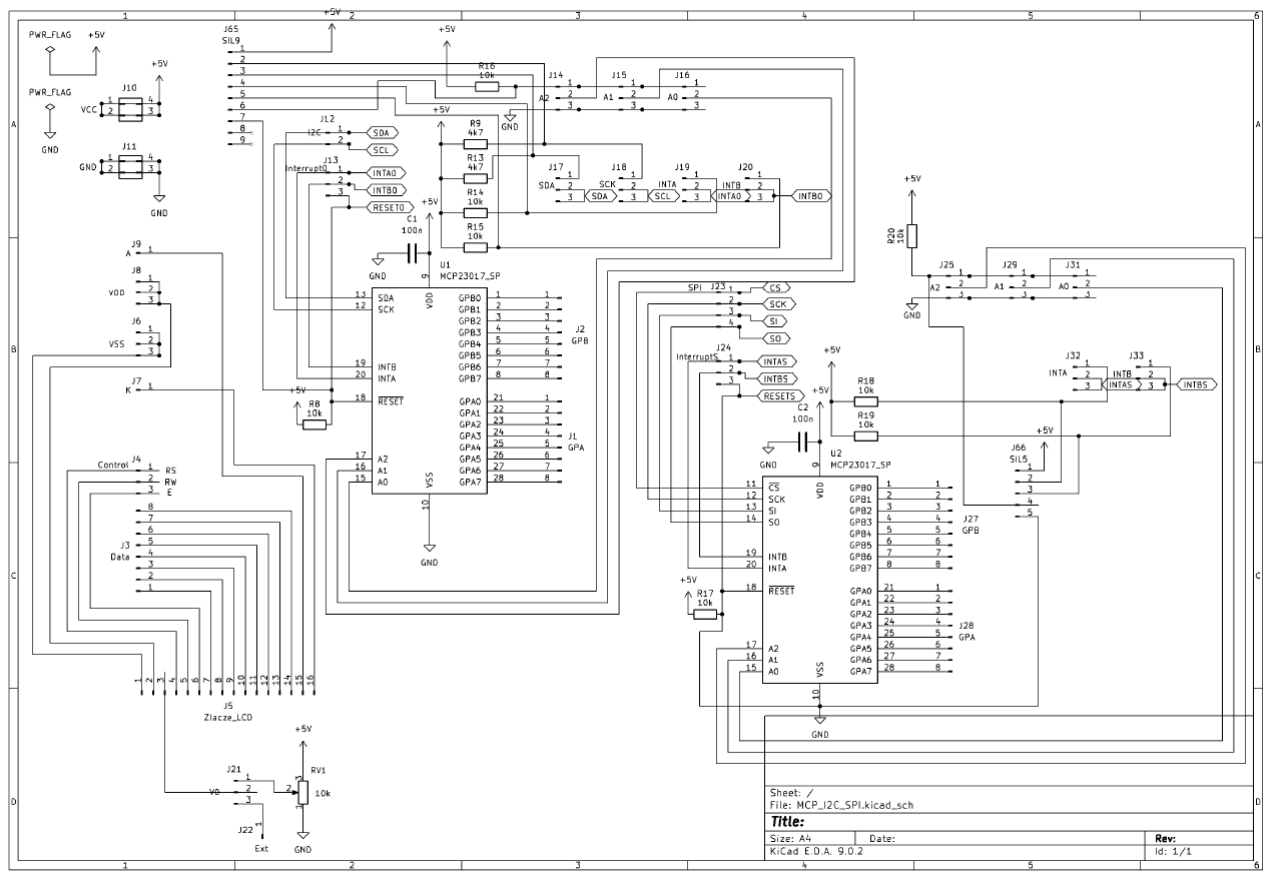
[picture p58: figure]

Rysunek 7.3: Schemat ideowy modułu z MCP23x17

7.4. Płytka PCB z soldermaską | 51

## 7.4 Płytka PCB z soldermaską

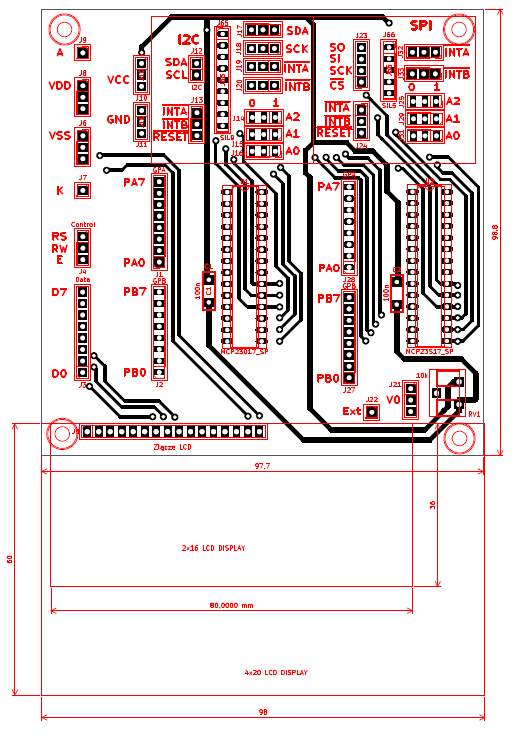
[picture p59: figure]

Rysunek 7.4: Wierzchnia strona płytki PCB z dwoma układami MCP23x17

Widoczny na rysunku 7.4 szkic górnej strony płytki pokazuje rozmieszczenie elementów zaznaczonych obrysami oraz prowadzenie ścieżek. Płytka miała 97,7 mm szerokości oraz 98,8 mm wysokości. Rozmieszczenie elementów zostało starannie przemyślane. Na górze płytki znajdują się zworki, oznaczone dwoma prostokątami. W lewym obrysie znajdują elementy odpowiedzialne za konfigurację części I²C. Zostały one odpowiednio oznaczone, tj. włączenie rezystorów podciąga-

jących dla SDA, SCK, INT A, INT B. Zostało przewidziane również ustawianie adresów układu MCP23017 poprzez odpowiednie ustawianie zworek, zgodnie z opisem na płytce. Wyprowadzenia połączeń do układu znajdują się po lewej stronie od drabinki rezystorowej oznaczonej jako SIL9. W prawym obrysie znajdują się zworki konfigurujące magistralę SPI, tj. włączenie podciągów dla INT A, INT B, oraz ustawienie adresu (w trybie SPI tzw. Opcode). Przy lewej krawędzi

płytki znajdują się piny konfiguracyjne wyświetlacza pozwalające zasilić sterownik podświetlenia oraz wybrać, w jaki sposób mają zostać podłączone piny danych oraz sterujące. Możliwe jest bezpośrednie połączenie mikrokontrolera z układami MCP23017 lub MCP23S17. Kontrast wyświetlacza sterowany jest za pomocą potencjometru RV 1 znajdującego się w prawym dolnym rogu płytki. Możliwe jest również wybranie zewnętrznego sterowania kontrastem podając sygnał na wejście Ext

52 | Projekt modułu LCD z 16-bitowymi ekspanderami MCP23x17

oraz ustawienie zworki V 0 w odpowiedni tryb pracy. W dolnej części płytki znajduje się złącze wyświetlacza LCD.

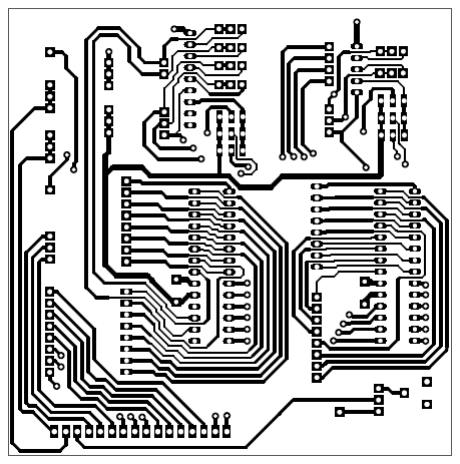
[picture p60: figure]

Rysunek 7.5: Spodnia strona płytki PCB z dwoma układami MCP23x17

Warstwa dolna obwodu drukowanego, przedstawiona na rysunku 7.5, stanowi główną płaszczyznę trasowania sygnałów oraz część dystrybucji zasilania. Zgodnie z dobrymi praktykami, zróżnicowano szerokości prowadzonych ścieżek w zależności od ich funkcji. Główne linie zasilające poprowadzono ścieżkami o szerokości 40 mils, co zapewnia odpowiednią obciążalność prądową i minimalizuje rezystancję pasożytniczą. Z kolei standardowe szyny sygnałowe wytrasowano z domyślną szerekością 25 mils. Aby zachować wymogi dotyczące odstępów izolacyjnych, w obszarach o dużym

zagęszczeniu otworów zastosowano zwężenie ścieżek do 15 mils. Zabieg ten skutecznie zapobiega powstawaniu zwarć oraz mostków lutowniczych podczas montażu. Dostosowano również wymiary wyprowadzeń stosowanych komponentów przewlekanych (THT). Dla złącza matrycy LCD zasto-

sowano wiertła o średnicy 0,8 mm, natomiast dla standardowych wyprowadzeń wybrano otwory o średnicy 0,9 mm. W przypadku padów układów scalonych oraz kondensatorów odsprzęgających średnicę wiercenia zredukowano do 0,7 mm, co sprzyja lepszemu formowaniu się spoiny lutowniczej. Zmiany warstw sygnałowych zrealizowano za pomocą przelotek o średnicy zewnętrznej padu równej 55 mils i średnicy otworu 0,6 mm.

7.5. Płytka PCB z frezowaniem ścieżek | 53

## 7.5 Płytka PCB z frezowaniem ścieżek

Alternatywna wersja docelowej płyty głównej zachowuje pełną funkcjonalność układu bazowego, jednak jej topologia została zmodyfikowana pod kątem wytwarzania metodą frezowania izolacyjnego (CNC) oraz poprawy parametrów elektrycznych.

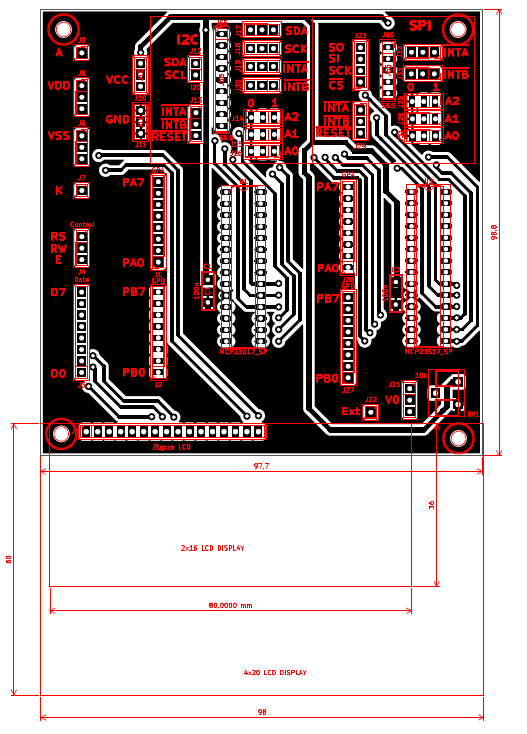
[picture p61: figure]

Rysunek 7.6: Wierzchnia strona płytki PCB wypełniona polem masy z dwoma układami MCP23x17

Warstwa górna płytki PCB, widoczna na rysunku 7.6 pełni funkcję warstwy montażowej dla elementów THT. Poprowadzono na niej tylko te ścieżki sygnałowe, które wymagały bezkolizyjnego skrzyżowania z głównymi magistralami. Znajdują się tu również wszystkie złącza i zworki konfiguracyjne. W tej technologii warstwa opisowa (oznaczenia elementów), musi być wykonana ręcznie,

jako naklejki z oznaczeniami, bądź wygrawerowana w technologii CNC, co obarczone jest ryzykiem małej czytelności oznaczeń.

54 | Projekt modułu LCD z 16-bitowymi ekspanderami MCP23x17

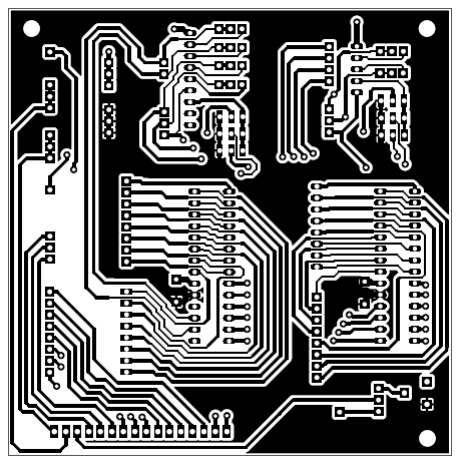
[picture p62: figure]

Rysunek 7.7: Spodnia strona płytki PCB wypełniona polem masy z dwoma układami MCP23x17

Warstwa dolna płytki PCB, widoczna na rysunku 7.7 skupia główną mozaikę połączeń sygnałowych i zasilających. Trasowanie ścieżek zrealizowano z zachowaniem powiększonych odstępów izolacyjnych (ang. clearance), które dostosowano do fizycznej średnicy narzędzia skrawającego (frezu).

Najważniejszą różnicą względem wersji trawionej chemicznie jest płaszczyzna masy. Puste przestrzenie na warstwie dolnej wypełniono wylewką miedzi podłączoną do potencjału masy (GND).

Skraca to znacząco czas pracy maszyny CNC i minimalizuje zużycie frezów, ponieważ usuwa się tylko wąski margines wokół ścieżek. Rozlana masa tworzy doskonały ekran elektromagnetyczny (EMC). Zapewnia to niskoimpedancyjną ścieżkę powrotu dla szybkich sygnałów cyfrowych, dra-

stycznie redukując podatność układu na zakłócenia i przesłuchy.

# Rozdział 8

# Projekt systemu rozproszonego z

# łącznością radiową

## 8.1 Założenia techniczne

W czasach intensywnego rozwoju technologii komunikacji radiowej np. 5G, WiFi i Bluetooth wiele projektów rezygnuje z transmisji przewodowej, na rzecz propagowania danych w otwartą przestrzeń. Wraz z popytem na łączność bezprzewodową powstał cały szereg programów symulacyjnych na potrzeby badań prototypowanych rozwiązań. Projekt modułów z ekspanderami portów I/O znakomicie wpasowywał się w swoich założeniach w rozszerzenie koncepcji o łączność RF.

Mikrokontrolery takie jak ESP32 czy niektóre urządzenia z rodziny Arduino pozwalają na taką wy-

mianę danych, zazwyczaj operując na częstotliwościach gigahercowych. Transmisja w takim paśmie charakteryzuje się dużą przepływnością, lecz znikomym zasięgiem. Założenia zakładają, że projekt powinna cechować stabilna komunikacja w promieniu kilkunastu, a nawet klikudziesięciu metrów. Z tego względu postanowiono, że transmisja ma odbywać się na paśmie nielicencjonowanym o częstotliwości środkowej 868 MHz. Kolejnym kryterium był kształt samego promiennika wysyłającego sygnał w świat. Zainspirowanie prezencją i prostotą wykonania anteny w mikrokontrolerze ESP32 skłoniło do wyboru anteny typu IFA. Na potrzeby rozszerzenia o łączność bezprzewodową

postanowiono zaprojektować własne moduły antenowe, zintegrowane z układem scalonym, który obsługiwał taki typ komunikacji. Wybór padł na urządzenie firmy Texas Instruments, transceiver CC1101. Układ zapewniał konwersję danych z SPI na standard RF, dzięki czemu mógł współpracować z ekspanderem MCP23S17, który znajdował się na jednym z zaprojektowanych wcześniej modułów. Poza tym CC1101 pracował na napięciu zasilania 3,3 V i zapewniał wiele funkcji związanych z technologią radiową, np. kilka rodzajów modulacji, pracę na różnych pasmach i wzmocnienie sygnału nawet o 12 dBm. Kolejną ważną cechą układu była możliwość zabezpieczenia transmisji przez bitowe słowa synchronizacyjne lub rozszerzenie pakietu o nadmiarowy kod cykliczny CRC.

## 8.2 Koncepcja modułu

Na potrzeby symulacyjne przygotowano 3 warianty płytek PCB: podstawową, ze skróconą płaszczyzną masy oraz wydłużoną. Każda z płytek została przebadana, a wyniki pomiarów zostały opisane w rozdziale ”Badania parametrów propagacyjnych”. Płytka podstawowa była inspiracją modułu instruktażowego z dokumentacji udostępnionej przez Texas Instruments. Na rysunku 8.1

55

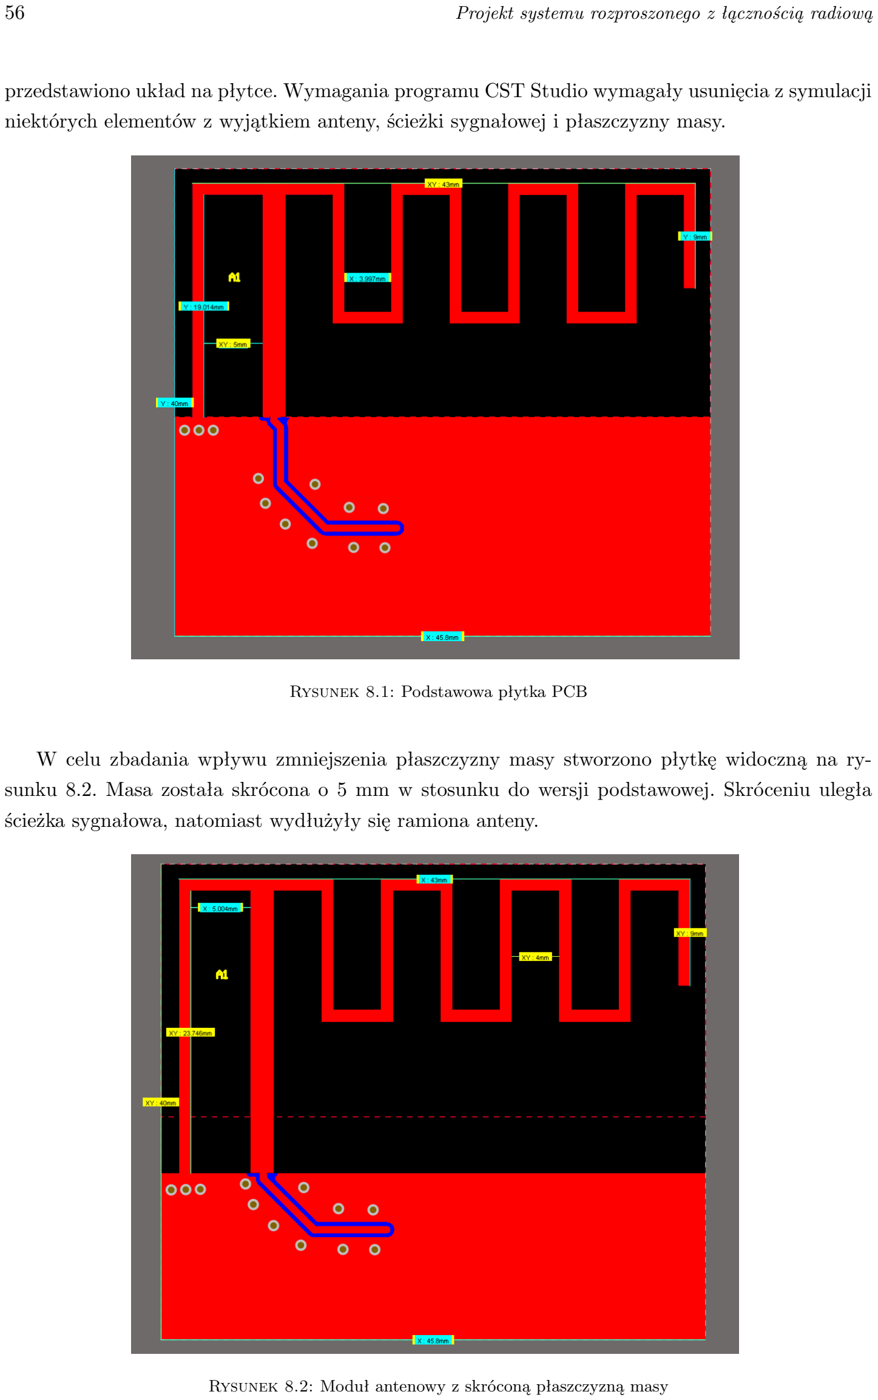
[picture p63: page 56]

56 | Projekt systemu rozproszonego z łącznością radiową

przedstawiono układ na płytce. Wymagania programu CST Studio wymagały usunięcia z symulacji niektórych elementów z wyjątkiem anteny, ścieżki sygnałowej i płaszczyzny masy.

Rysunek 8.1: Podstawowa płytka PCB

W celu zbadania wpływu zmniejszenia płaszczyzny masy stworzono płytkę widoczną na rysunku 8.2. Masa została skrócona o 5 mm w stosunku do wersji podstawowej. Skróceniu uległa ścieżka sygnałowa, natomiast wydłużyły się ramiona anteny.

Rysunek 8.2: Moduł antenowy z skróconą płaszczyzną masy

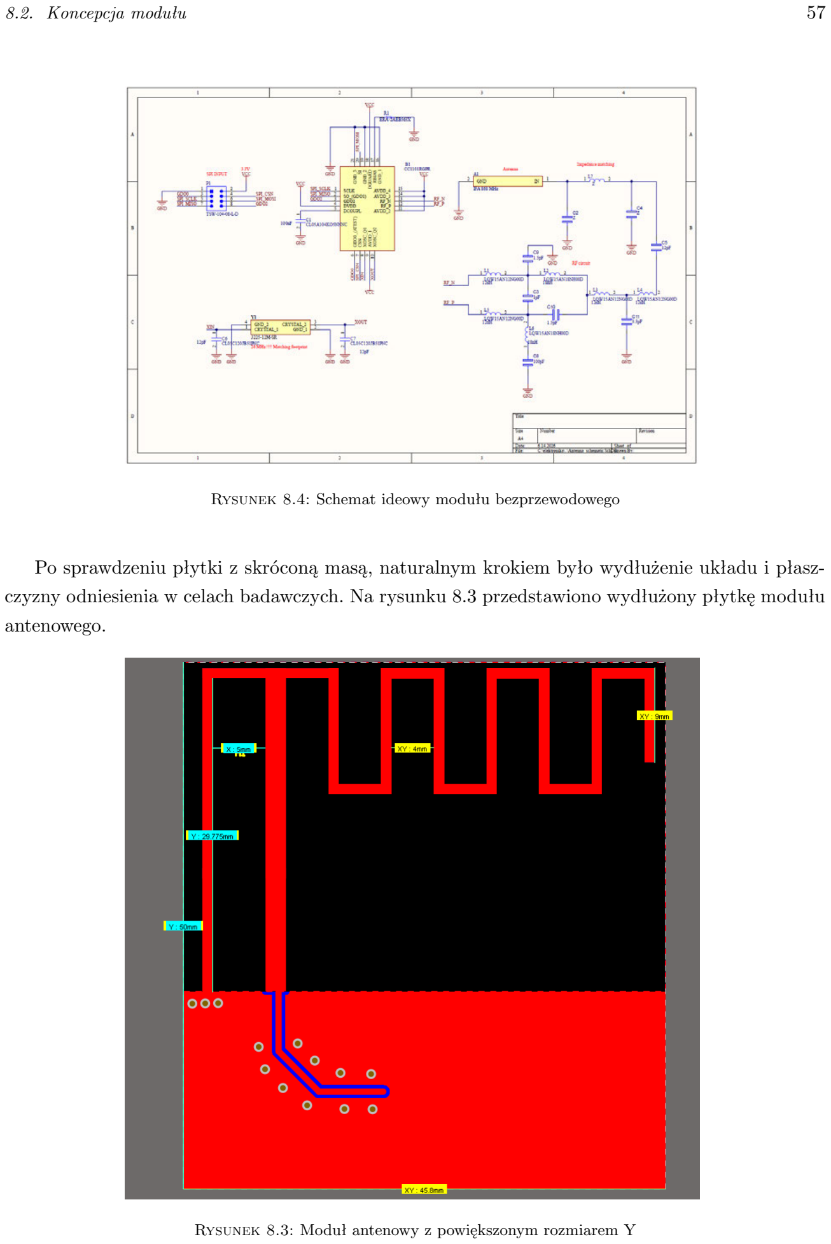
[picture p64: page 57]

8.2. Koncepcja modułu | 57

Rysunek 8.4: Schemat ideowy modułu bezprzewodowego

Po sprawdzeniu płytki z skróconą masą, naturalnym krokiem było wydłużenie układu i płaszczyzny odniesienia w celach badawczych. Na rysunku 8.3 przedstawiono wydłużony płytkę modułu antenowego.

Rysunek 8.3: Moduł antenowy z powiększonym rozmiarem Y

58 | Projekt systemu rozproszonego z łącznością radiową

## 8.3 Opis modułu

| Przedstawiony na rysunku 8.4 schemat ideowy ukazuje implementację układu nadawczo-
- odbiorczego CC1101 firmy Texas Instrument, do obsługi komunikacji w paśmie sub-gigahercowym. Moduł wraz z anteną, został zaprojektowany do pracy w paśmie ISM 868 MHz. Wyprowadzenie radiowe układu CC1101, oznaczone jako RF N (pin 13) oraz RF P (pin 12), są portami różnicowymi (zbalansowanymi). Oznacza to, że sygnał użyteczny jest różnicą potencjałów między tymi dwoma wyprowadzeniami. Z kolei zastosowana w projekcie antena drukowana (A1-IFA 868 MHz) jest elementem niesymetrycznym (niezbalansowanym), odniesionym do masy, o nominalnej impe-

dancji wynoszącej 50 Ω. Bezpośrednie podłączenie portów różnicowych z niesymetryczną anteną skutkowałoby drastycznym niedopasowaniem i stratą większości mocy wypromieniowywanej. Aby

temu zapobiec, zastosowano dyskretny obwód symetryzatora, tzw. balun.
| Na omawianym schemacie układ symetryzatora oraz wstępnego dopasowania impedancji został
zrealizowany przy pomocy elementów dyskretnych LC. Topologia jest zgodna z notą katalogową producenta układu. Symetryzator pełni dwie fundamentalne funkcje. Transformacja zakresu trybu pracy zamienia sygnał różnicowy z pinów RF P i RF N na sygnał niesymetryczny (single-ended),

który może być poprowadzony jedną ścieżką w kierunku anteny. Drugą właściwością symetryzatora jest dopasowanie impedancyjne. Wzmacniacz mocy (PA) oraz tor odbiorczy (LNA) wbudowane

w CC1101 wymagają do optymalnej pracy specyficznej impedancji obciążenia. Zgodnie ze specyfikacją dla pasma 868 MHz wynosi ona optymalnie 86,5 + j43 Ω. Zadaniem elementów składowych baluna jest przetransformowanie tej zespolonej wartości do standardowej rzeczywistej impedancji systemowej wynoszącej 50 Ω.
| Kondensator C8 pełni dodatkową funkcję separacji galwanicznej (blokowania składowej stałej),
zapewniając zwarcie dla sygnałów wysokiej częstotliwości (w.cz.) do masy, jednocześnie zapobie-

gając przepływowi prądu stałego z wewnętrznych obwodów polaryzacji układu CC1101.
| Za węzłem sumującym baluna sygnał trafia na układ filtru dolnoprzepustowego, zbudowanego
z cewek L3, L4 oraz kondensatora C11, Jest to krytyczny element z punktu widzenia kompatybilności elektromagnetycznej. Modulacje cyfrowe generują niepożądane wyższe harmoniczne (zwłaszcza drugą i trzecią harmoniczną częstotliwości bazowej), które ten filtr ma za zadanie skutecznie wy-

tłumić przed wypromieniowaniem ich w „eter”.
| Ostatnim blokiem przed samą anteną jest obwód dopasowujący, składający się z elementu L7
oraz kondensatorów C2, C4, C5. Moduł ten pozwala na precyzyjne dostrojenie anteny w warunkach docelowej pracy urządzenia. Obecność elementów dielektrycznych przestraja rezonans anteny, co kompensuje się poprzez dobór wartości elementów w tej sekcji.
| Do precyzyjnego taktowania wewnętrznego syntezera PLL wykorzystano zewnętrzny rezonator
kwarcowy Y1 o częstotliwości 26 MHz, obciążony kondensatorami C6 i C7, co zapewnia odpowiednią stabilną częstotliwość wymaganą dla wąskopasmowej transmisji RF [15].

## 8.4 Badania parametrów propagacyjnych

| W celu wstępnej weryfikacji projektowanego modułu poddano go badaniom w programie symu-
lacyjnym CST Studio Suite 2019. Oprogramowanie to profesjonalne środowisko wyspecjalizowane w testowaniu układów radiowych różnego rodzaju. Z pomocą programu badano 3 najważniejsze parametry sygnału tj. współczynnik S1.1, wykres Smitha oraz wykres promieniowania w polu dalekim. Dzięki tym parametrom można było oszacować, czy dany wariant miał predyspozycje

8.4. Badania parametrów propagacyjnych | 59

do dalszej realizacji. Współczynnik S1.1 to parametr odpowiadający wprost za dopasowanie anteny. Była to skala odbicia napięcia od portu wejściowego, w której im mniejszy wynik w dB, tym lepiej. Za pomocą wykresu Smitha określano charakter impedancji, gdzie wartością oczekiwaną było równe 50Ω. Dzięki wykresowi propagacji w polu dalekim sprawdzono, czy antena była dookólna. CST Studio posiadał możliwość optymalizacji parametrów anteny w zależności od wyznaczonego celu. Proces optymalizacji polegał na zmianie parametrów fizycznych wybranych elementów całego modułu. Dla prostoty zmieniano tylko 2 wielkości: odległość pomiędzy nogą sygnałową i nogą odniesienia anteny oraz długością ostatniego meandra. Celem optymalizacji było osiągnięcie wartości współczynnika S1.1 na poziomie mniejszym niż -10 dB. Każdy wariant płytki był poddany badaniu bez optymalizacji i po procesie optymalizacji.

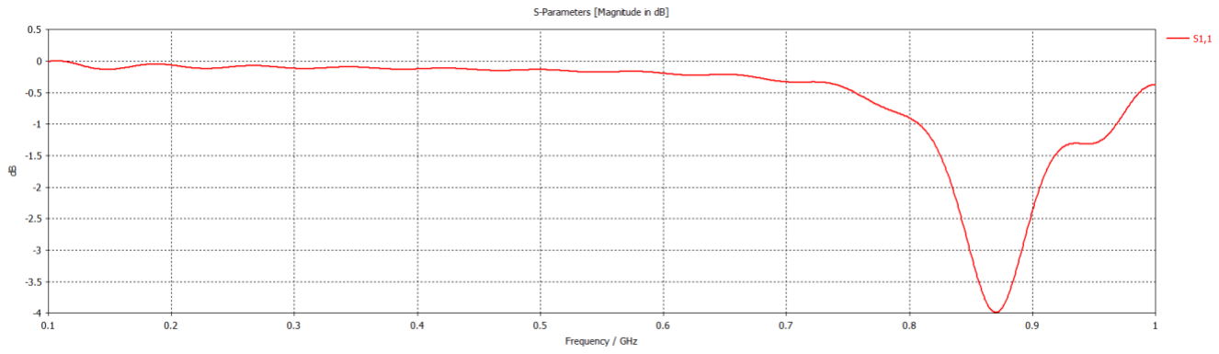
[picture p65: figure]

Rysunek 8.5: Współczynnik S11 - płytka bazowa bez optymalizacji

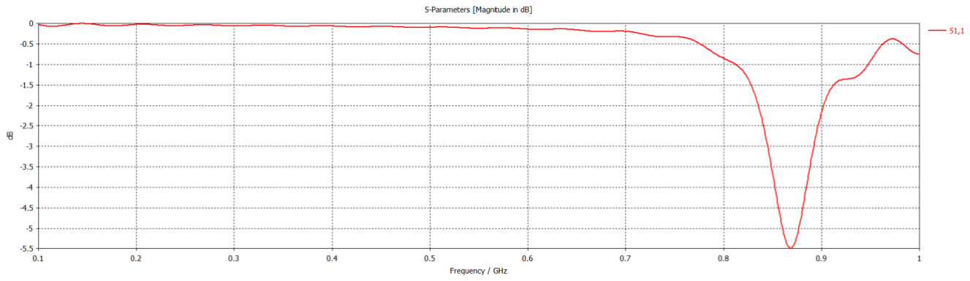
[picture p66: figure]

Rysunek 8.6: Współczynnik S11 - płytka bazowa zoptymalizowana

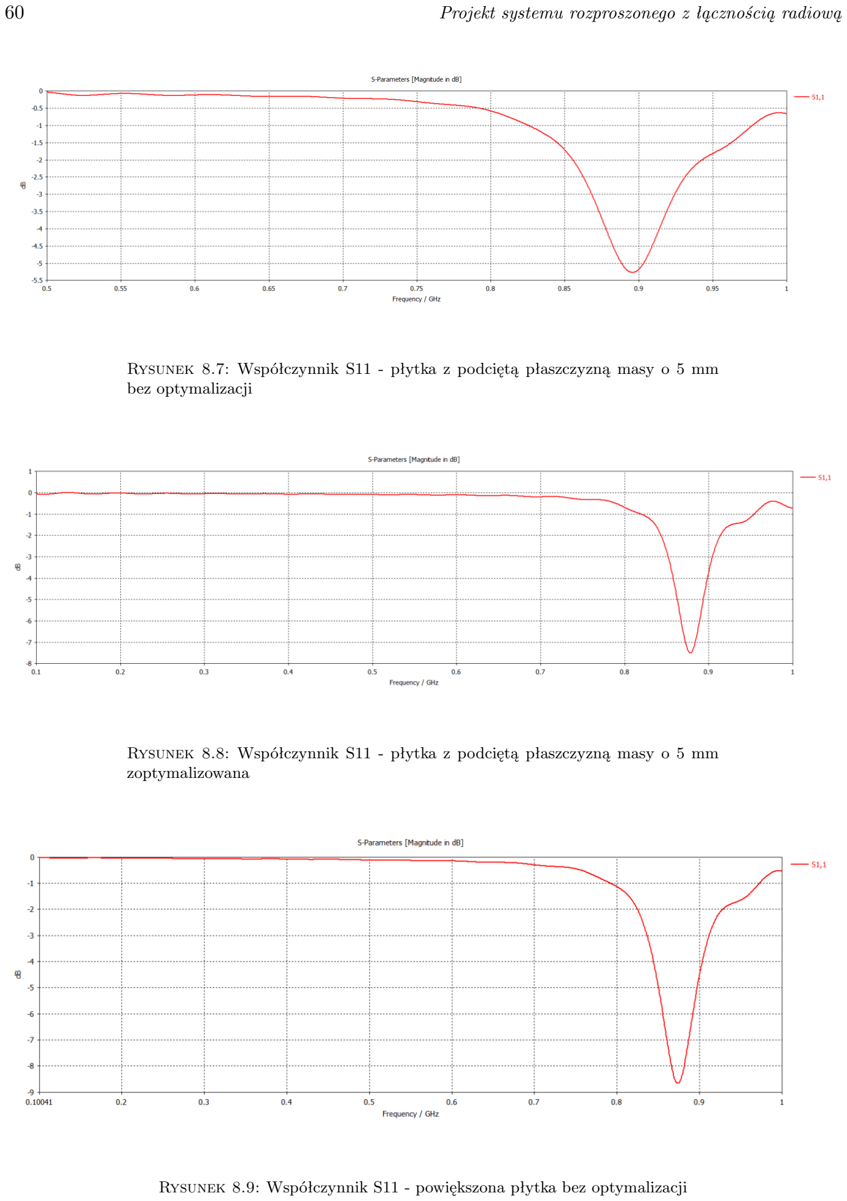
[picture p67: page 60]

60 | Projekt systemu rozproszonego z łącznością radiową

Rysunek 8.7: Współczynnik S11 - płytka z podciętą płaszczyzną masy o 5 mm bez optymalizacji

Rysunek 8.8: Współczynnik S11 - płytka z podciętą płaszczyzną masy o 5 mm zoptymalizowana

Rysunek 8.9: Współczynnik S11 - powiększona płytka bez optymalizacji

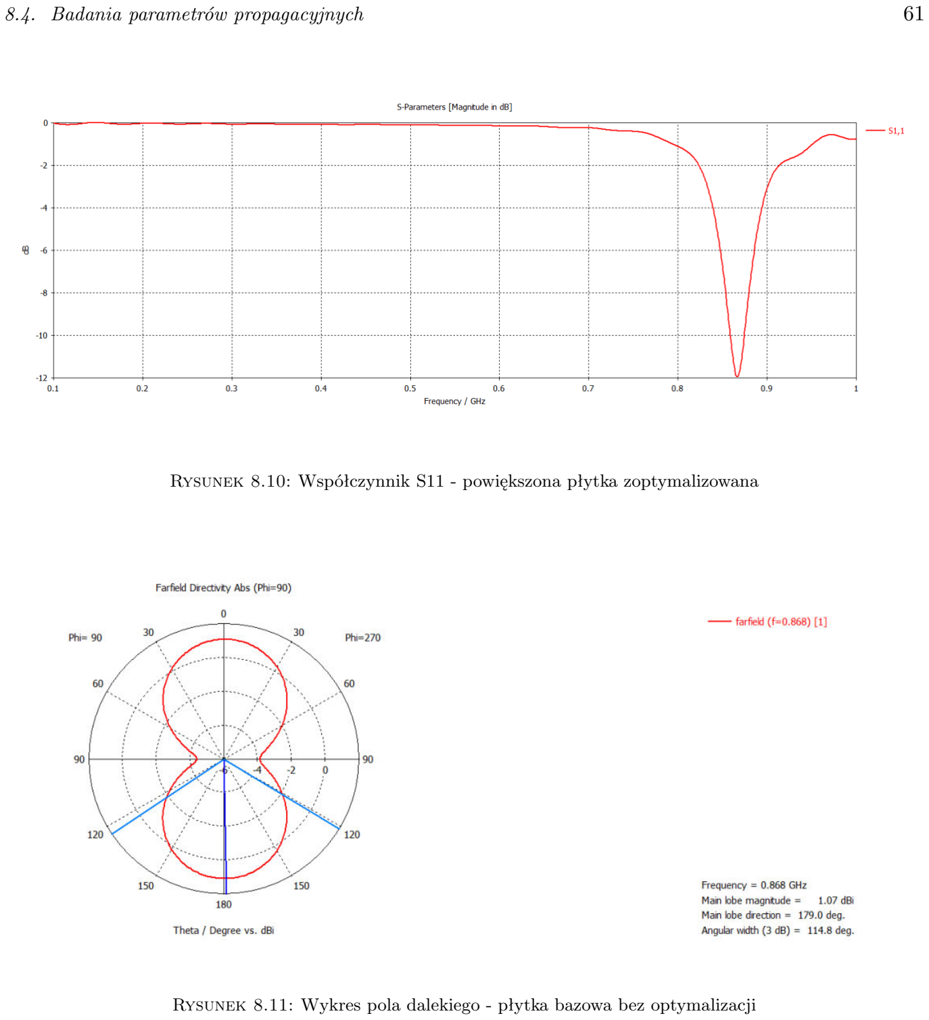
[picture p68: page 61]

8.4. Badania parametrów propagacyjnych | 61

Rysunek 8.10: Współczynnik S11 - powiększona płytka zoptymalizowana

Rysunek 8.11: Wykres pola dalekiego - płytka bazowa bez optymalizacji

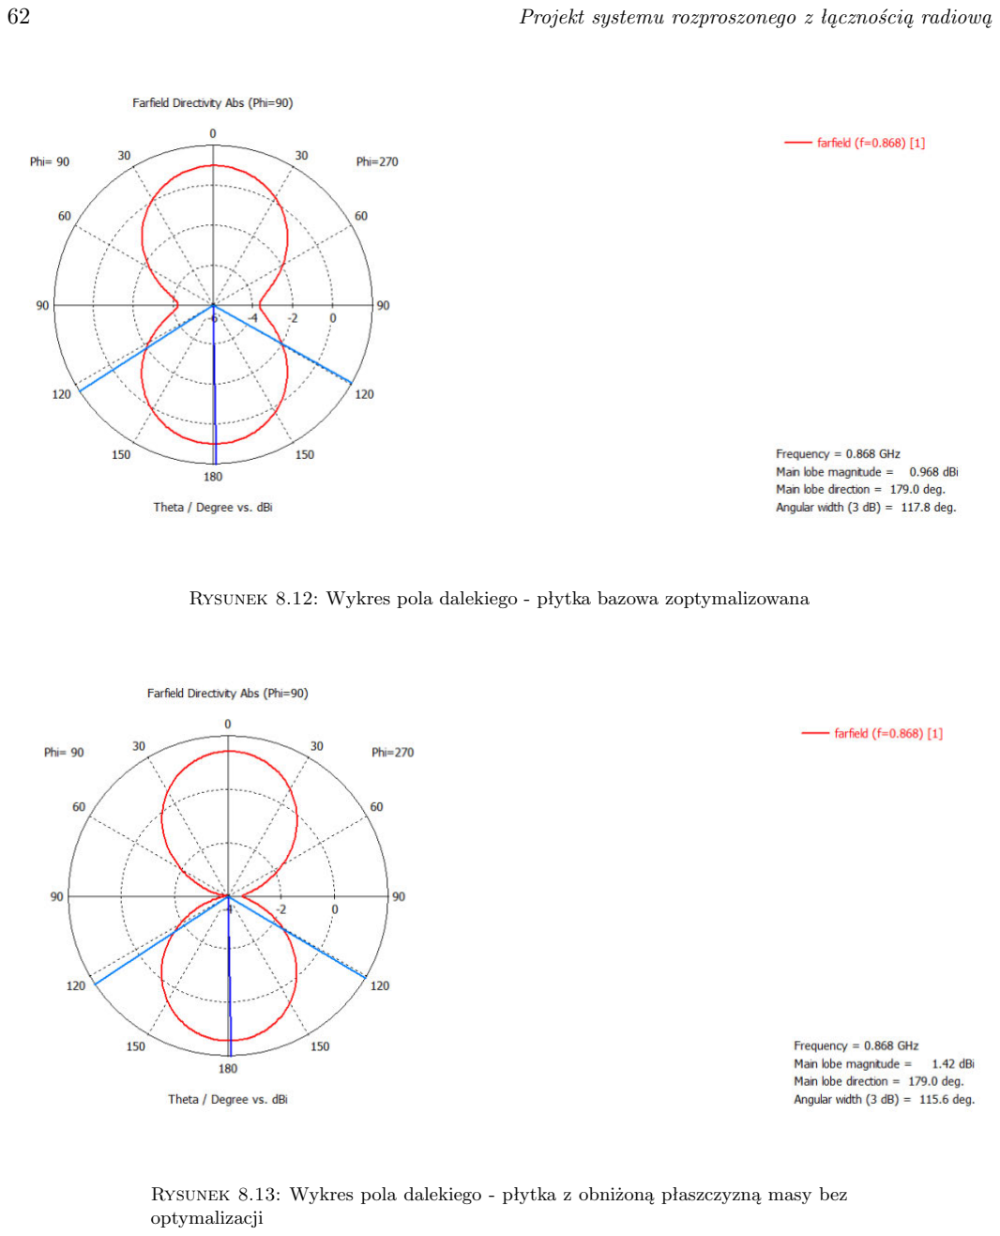
[picture p69: page 62]

62 | Projekt systemu rozproszonego z łącznością radiową

Rysunek 8.12: Wykres pola dalekiego - płytka bazowa zoptymalizowana

Rysunek 8.13: Wykres pola dalekiego - płytka z obniżoną płaszczyzną masy bez optymalizacji

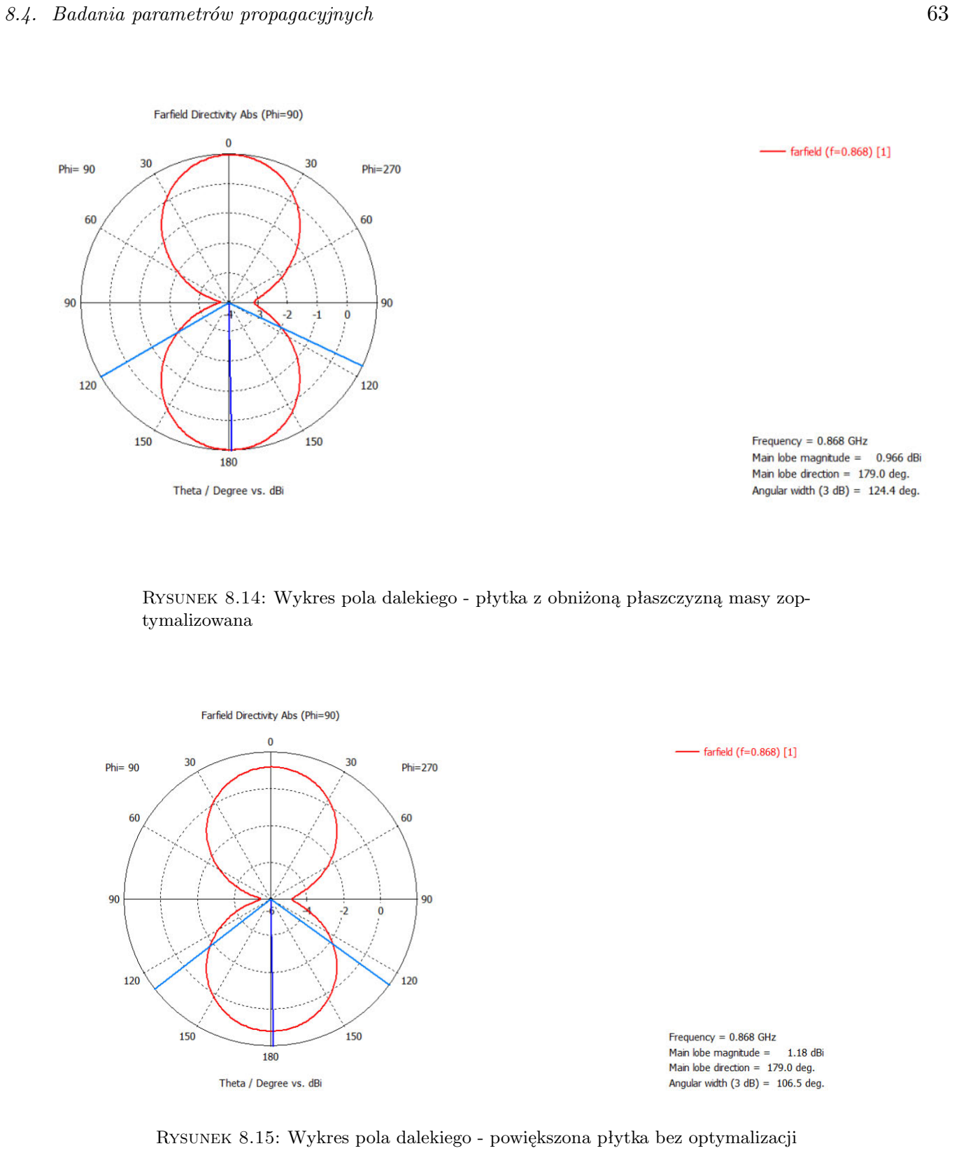
[picture p70: page 63]

8.4. Badania parametrów propagacyjnych | 63

Rysunek 8.14: Wykres pola dalekiego - płytka z obniżoną płaszczyzną masy zoptymalizowana

Rysunek 8.15: Wykres pola dalekiego - powiększona płytka bez optymalizacji

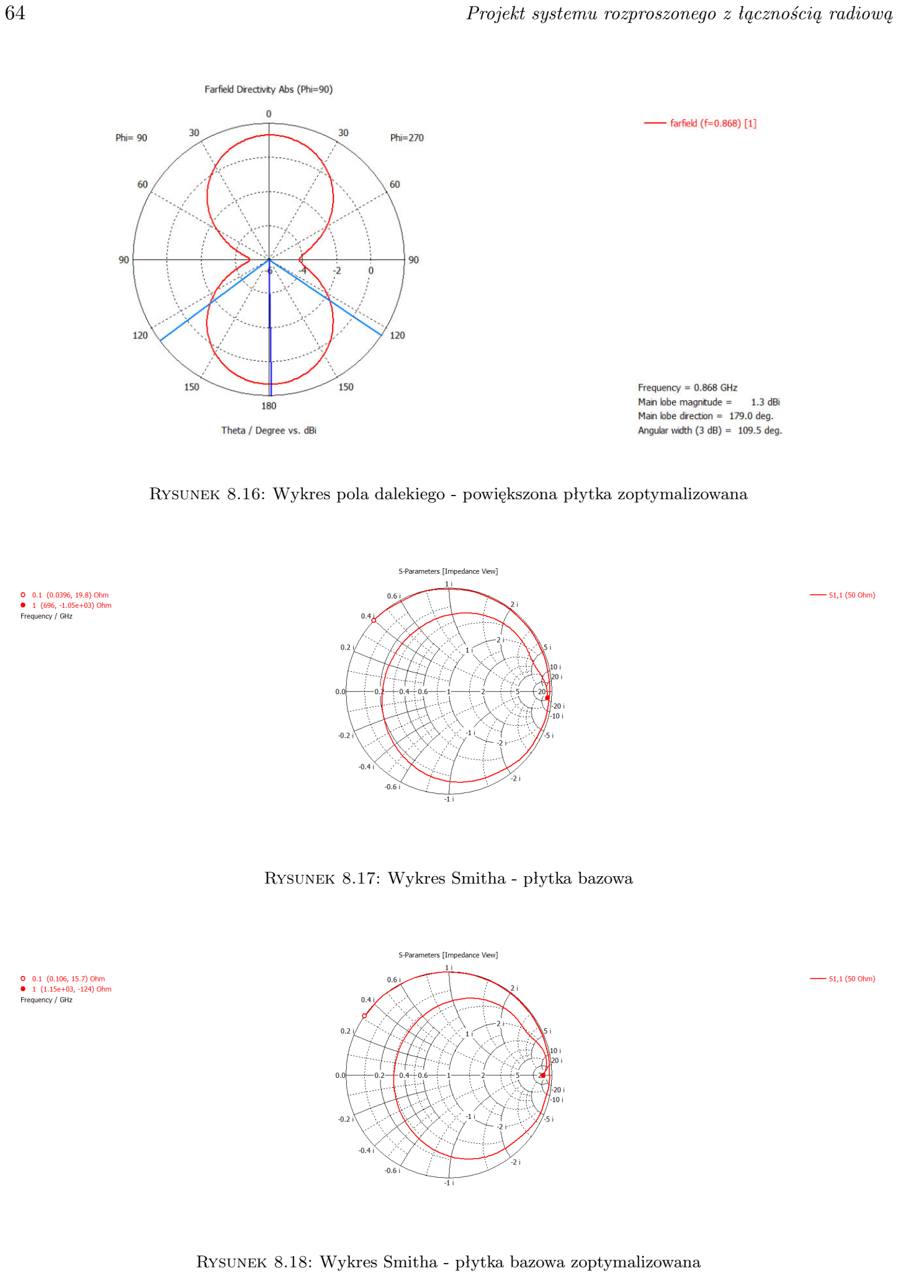
[picture p71: page 64]

64 | Projekt systemu rozproszonego z łącznością radiową

Rysunek 8.16: Wykres pola dalekiego - powiększona płytka zoptymalizowana

Rysunek 8.17: Wykres Smitha - płytka bazowa

Rysunek 8.18: Wykres Smitha - płytka bazowa zoptymalizowana

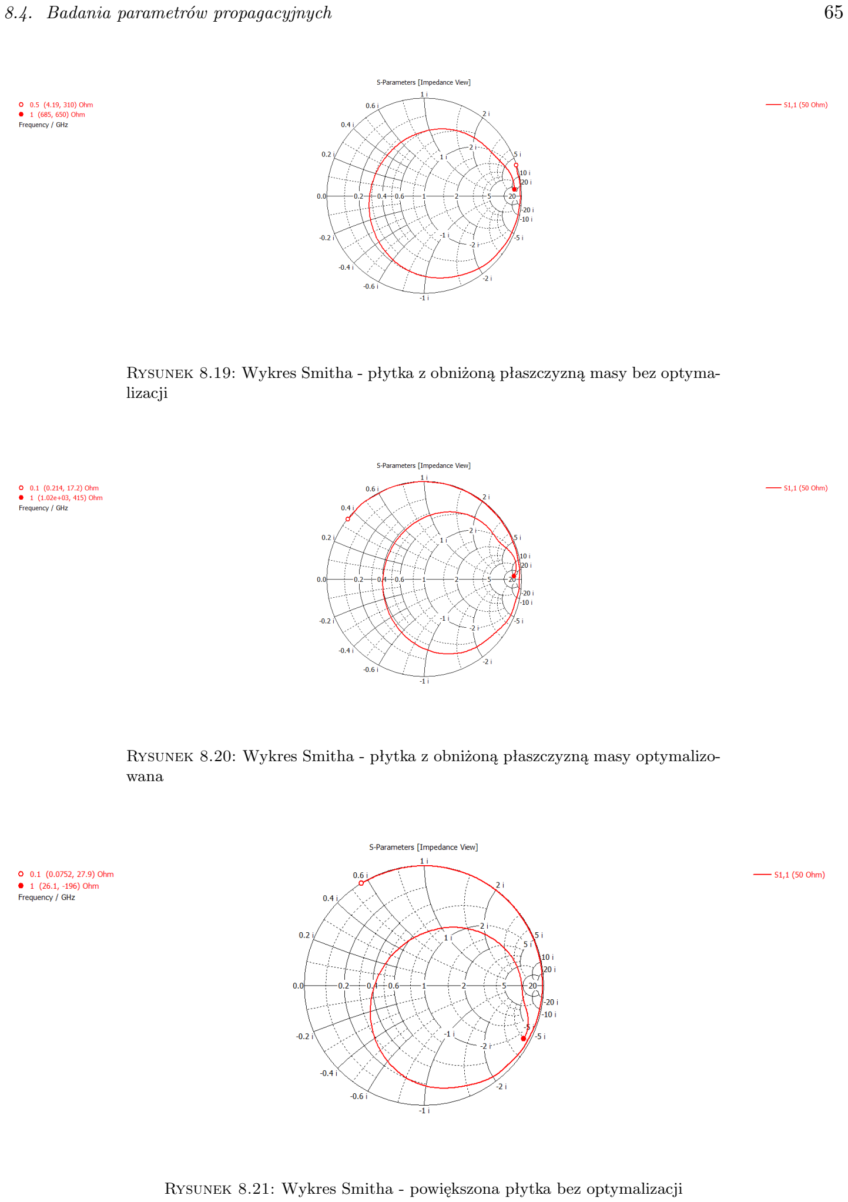
[picture p72: page 65]

8.4. Badania parametrów propagacyjnych | 65

Rysunek 8.19: Wykres Smitha - płytka z obniżoną płaszczyzną masy bez optymalizacji

Rysunek 8.20: Wykres Smitha - płytka z obniżoną płaszczyzną masy optymalizowana

Rysunek 8.21: Wykres Smitha - powiększona płytka bez optymalizacji

66 | Projekt systemu rozproszonego z łącznością radiową

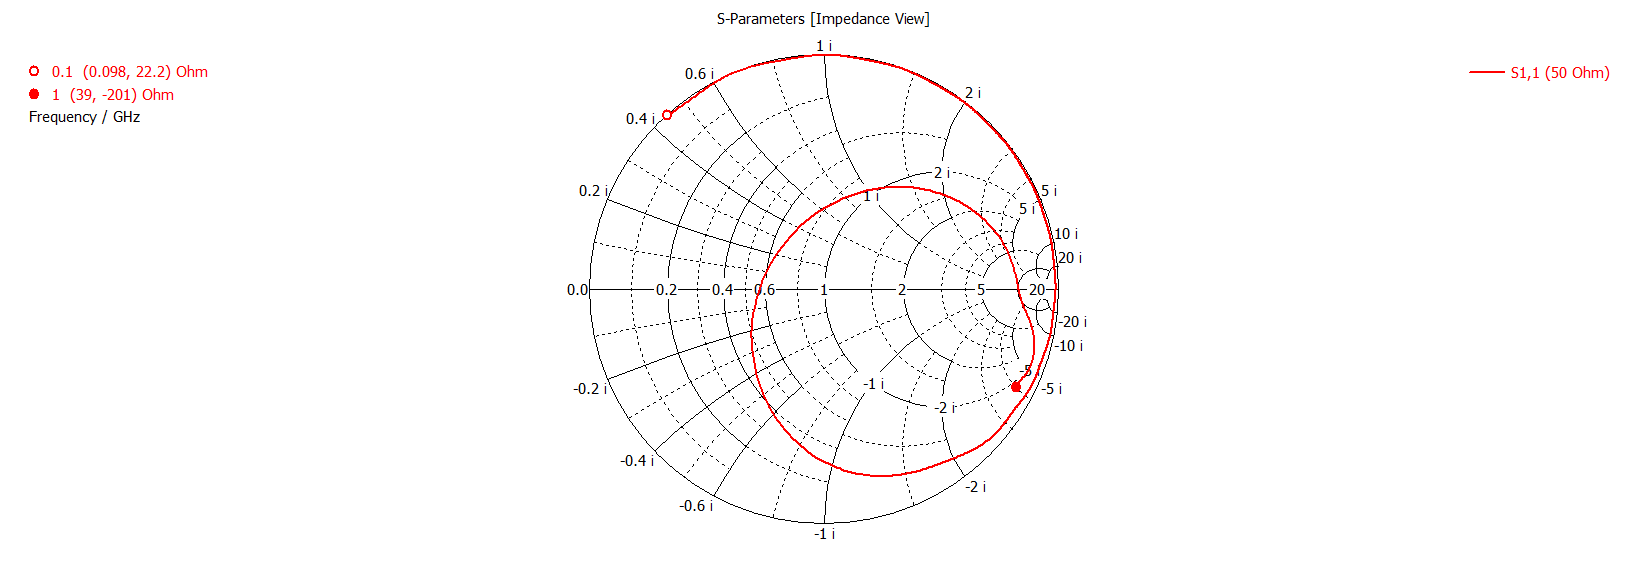
[picture p73: figure]

Rysunek 8.22: Wykres Smitha - powiększona płytka optymalizowana

Wyniki symulacji dla modeli bazowych wykazały niedopasowanie toru radiowego. Wersja bazowa, nawet po optymalizacji, osiągnęła współczynnik S11 na poziomie zaledwie -4,5 dB dla częstotliwości 868 MHz. Wynikało to ze zbyt bliskiego sąsiedztwa litej wylewki masy, która generowała silne pasożytnicze sprzężenia pojemnościowe. Próba fizycznego podcięcia masy o 5 mm zmniejszyła pojemność brzegową, jednak drastycznie przesunęła częstotliwość rezonansową w górę (do 880 MHz po optymalizacji) oraz uniemożliwiła poprawne zestrojenie układu do wymaganej impedancji 50 Ω.

Przełom w badaniach nastąpił w wariancie płytki z wydłużonym laminatem. Już przed procesem optymalizacji struktura wykazywała poprawny kierunek zmian, zbliżając się do pożądanego rezonansu ze współczynnikiem S11 = -8,6 dB. Po zastosowaniu algorytmu optymalizacyjnego ang. Trust Region Framework model docelowy osiągnął wynik S11 = -12,6 dB precyzyjnie na częstotliwości środkowej 868 MHz. Z analizy wykresu Smitha wynika ponadto, że powiększona geometria pozwoliła znacząco podnieść rzeczywistą rezystancję wejściową anteny z poziomu 11,5 Ω do optymalnej wartości 32,32 Ω. Zmierzona na wykresie impedancja Z = 32, 32 + j11, 65 Ω stwarza dogodne warunki do finalnego dostrojenia toru za pomocą wtrąconego szeregowo kondensatora kompensacyjnego.
Równie istotne różnice odnotowano w analizie charakterystyk kierunkowych. W modelach bazowych zbyt mała powierzchnia przeciwwagi powodowała powstanie głębokich minimów polaryzacyjnych i silnych przewężeń wiązki. Zwiększenie pola powierzchni miedzi w wydłużonej płytce ustabilizowało rozkład prądów powierzchniowych. Uzyskano w ten sposób pożądaną, quasi-dookólną charakterystykę przestrzenną. Docelowy wariant płytki osiągnął zysk na poziomie 1,30 dBi oraz bardzo szeroki kąt połowy mocy wynoszący 109,5 ◦
. Przekłada się to bezpośrednio na eliminację martwych stref zasięgu oraz stabilną komunikację w paśmie ISM¹
, niezależnie od fizycznej orientacji urządzenia w przestrzeni.

1
ang. Industrial, Scientific, Medical - wydzielony zakres fal radiowych przeznaczony do zastosowań przemysłowych, naukowych, medycznych oraz domowych.

8.5. Płytka PCB | 67

## 8.5 Płytka PCB

Projekt urządzenia został zrealizowany na dwuwarstwowej płytce PCB o grubości laminatu FR4 0.8 mm. Układ płytki został zaprojektowany ze szczególnym uwzględnieniem wymagań dla układów wysokiej częstotliwości (w.cz.), dążąc do minimalizacji strat sygnału użytecznego oraz

ograniczenia emisji niepożądanych zakłóceń elektromagnetycznych.

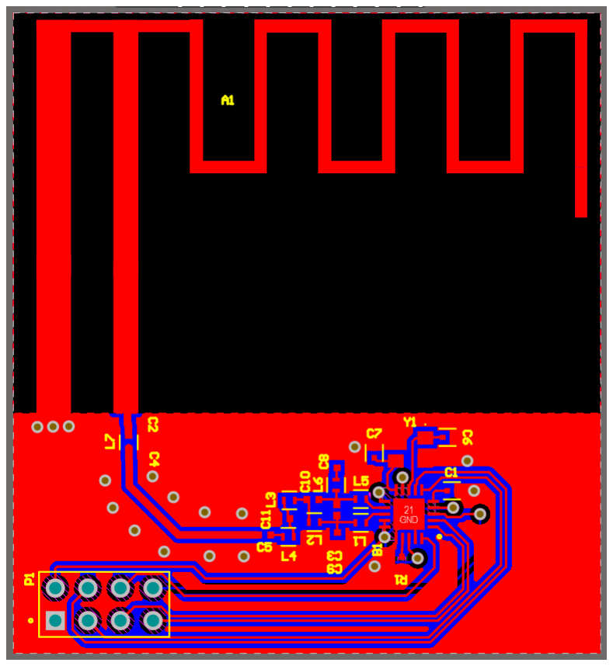
[picture p74: figure]

Rysunek | 8.23: | Szkic płytki drukowanej opartej na układzie CC1101, strona
wierzchnia

Warstwa górna (rys. 8.23) została obsadzona elementami do montażu powierzchniowego (SMD) wszystkich elementów składowych układu oraz poprowadzone zostały ścieżki sygnałowe (SPI, zasilanie oraz tor RF). Najważniejszym elementem modułu jest układ CC1101 (U1) w obudowie QFN20. Zgodnie z zasadami projektowania RF, tor radiowy (od pinu 12 i 13 układu U1 do wejścia anteny A1) został poprowadzony możliwie najkrótszą drogą. Zastosowano precyzyjne rozmieszczenie elementów w obudowach 0402, realizujących funkcję symetryzatora (baluna), filtra dolno-

przepustowego oraz układu dopasowania impedancji. Zachowano symetrię ścieżek dla sygnałów różnicowych RF P i RF N przed wejściem do symetryzatora, co jest krytyczne dla zachowania poprawnego balansu amplitudy i fazy sygnału.

68 | Projekt systemu rozproszonego z łącznością radiową

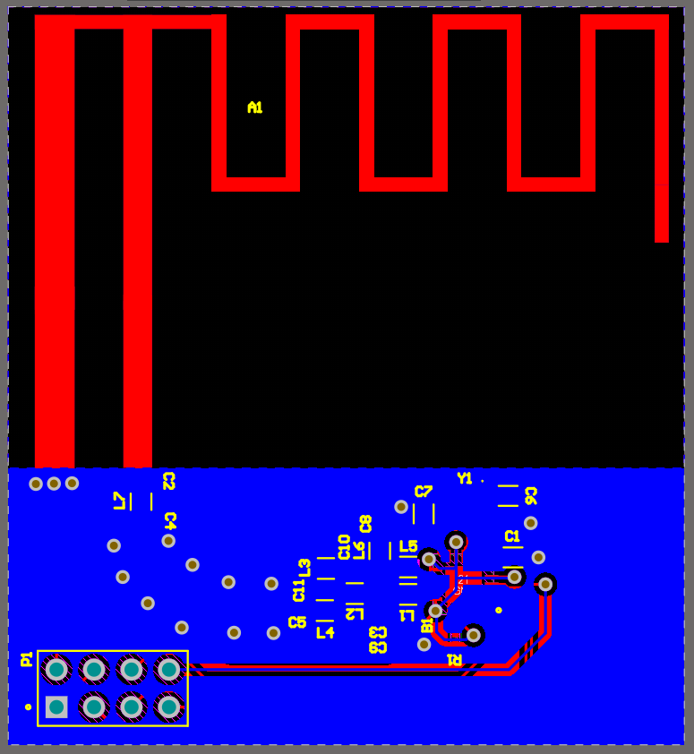
[picture p75: figure]

Rysunek 8.24: Szkic płytki drukowanej opartej na układzie CC1101 strona spodnia

Warstwa dolna (rys. 8.24) pełni w dużej mierze funkcję litej płaszczyzny masy. Jest to kluczowy

element dla stabilnej pracy toru RF. Wzdłuż ścieżki przenoszącej częstotliwość radiową rozmieszczono przelotki zszywające. Tworzą one barierę ekranującą i zapewniają, że płaszczyzna masy na warstwie wierzchniej ma ten sam potencjał co główna masa na warstwie spodniej, zapobiegając powstawaniu pętli masy. Na omawianej stronie płytki znajduje się również ścieżka sygnałowa dla pinu funkcyjnego GDO2 oraz część ścieżek zasilających tuż pod układem CC1101.

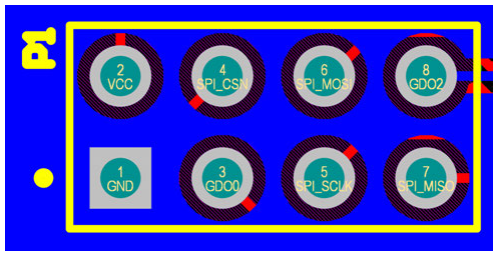
[picture p76: figure]

Rysunek 8.25: Złącze z wyprowadzeniami modułu

Na rysunku 8.25 przedstawiono wyprowadzenia, służące do połączenia modułu z systemem mikroprocesorowym:

- pin 1 (GND) - masa odniesienia układu. Dla zapewnienia prawidłowego działania toru ra-

diowego oraz minimalizacji szumów cyfrowych, wyprowadzenie to powinno zostać połączone bezpośrednio z główną płaszczyzną masy (ang. Ground Plane) systemu mikrokontrolera nad-

rzędnego za pomocą połączenia o jak najniższej impedancji. Pozwala to uniknąć powstawania pętli masy, które mogłyby negatywnie wpłynąć na czułość odbiornika RF,

- pin 2 (VCC) - główna linia zasilająca transiwer CC1101. Nominalne napięcie pracy dla tego

układu wynosi 3,3 V. Z uwagi na wysoką czułość struktur w.cz. na tętnienia napięcia, linia

8.5. Płytka PCB | 69

ta wymaga stabilnego źródła zasilania oraz ścisłego odsprzęgania zasilania za pomocą dedykowanych kondensatorów ceramicznych o niskiej zastępczej rezystancji szeregowej (ESR),

umieszczonych jak najbliżej struktury układu,

- pin 3 (GDO0) - główne, wielofunkcyjne wyjście cyfrowe ogólnego przeznaczenia (ang. Gene-

ral Purpose Digital Output Pin 0 ). Przy domyślnej konfiguracji lub odpowiedniej modyfikacji

rejestru sterującego IOCFG0, pin ten pełni rolę sprzętowego wyjścia przerwania. Sygnalizuje on zdarzenia takie jak poprawne zdekodowanie słowa synchronizującego (ang. Sync Word)

czy odebranie kompletnego pakietu danych, automatycznie zmieniając stan na wysoki i informując mikrokontroler Master o konieczności opróżnienia bufora RX FIFO,

- pin 4 (SPI CSN) - sygnał wyboru urządzenia na magistrali szeregowej (ang. Chip Select

Not). Jest to wejście cyfrowe aktywne w stanie niskim (logiczne zero). Przejście linii w stan

niski wybudza wewnętrzny kontroler SPI układu CC1101 i inicjuje transakcję, natomiast powrót do stanu wysokiego zatrzaskuje przesłane rejestry konfiguracyjne i zwalnia magistralę, umożliwiając komunikację z innymi urządzeniami Slave,

- pin 5 (SPI SCLK) - wejściowa linia sygnału zegarowego magistrali SPI (ang. Serial Clock).

Sygnał ten jest generowany wyłącznie przez urządzenie nadrzędne i służy do pełnej synchronizacji bitowej transferu danych. Układ CC1101 próbuje i zatrzaskuje stany logiczne na liniach danych zgodnie z konfiguracją trybu SPI Mode 0,0 (próbkowanie na zboczu narastającym),

- pin 6 (SPI MOSI) - linia wejściowa danych szeregowych. Za jej pośrednictwem mikrokontroler

nadrzędny przesyła do układu CC1101 bajty nagłówkowe (adresowe), komendy strobujące (ang. Command Strobes) oraz dane konfiguracyjne przeznaczone do zapisania w rejestrach

wewnętrznych lub w buforze TX FIFO,

- pin 7 (SPI MISO) - linia wyjściowa danych szeregowych. Służy do synchronicznego wypro-

wadzania danych z rejestrów statusowych transiwera oraz zawartości bufora RX FIFO do pamięci mikrokontrolera. Linia ta przechodzi w stan wysokiej impedancji, gdy pin CSN znajduje się w stanie wysokim, co pozwala na współdzielenie magistrali z innymi układami peryferyjnymi,

- pin 8 (GDO2) - dodatkowe, w pełni programowalne wyjście cyfrowe ogólnego przeznaczenia

(ang. General Purpose Digital Output Pin 2 ). Za pośrednictwem rejestru konfiguracyjnego

IOCFG2 może zostać zaprogramowane do sygnalizowania różnorodnych stanów wewnętrznych transiwera. W zaawansowanych aplikacjach radiowych wykorzystuje się je jako wskaźnik zajętości kanału (ang. Clear Channel Assessment – CCA ), sygnał osiągnięcia progu zapełnienia bufora FIFO lub jako sprzętowe wybudzenie w trybie energooszczędnym (ang. Wake-on-Radio).

# Rozdział 9

# Testowanie ekspanderów wejść/wyjść

## 9.1 Środowisko pomiarowe

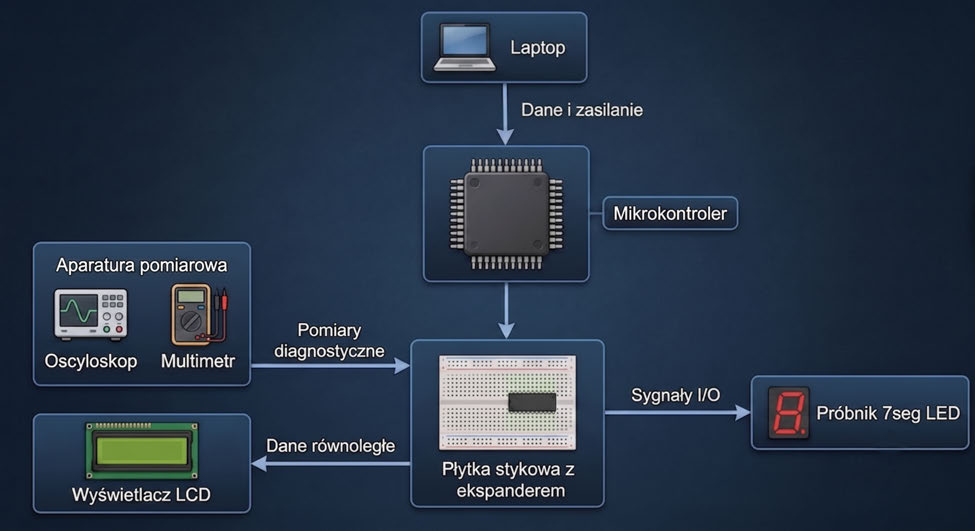
[picture p77: figure]

Rysunek 9.1: Środowisko pomiarowe

Przed zaprojektowaniem płytki drukowanej z układami MCP23x17, zostało zbudowane stanowisko pomiarowe, zilustrowane na schemacie blokowym (rys. 9.1), które pozwala na kompleksową diagnozę badanego modułu [23]. Głównymi elementami zestawu były:

- komputer klasy PC (laptop): Pełni rolę nadrzędnej stacji roboczej. Służy do kompilacji kodu,

programowania mikrokontrolera oraz zapewnia zasilanie dla całego układu poprzez port USB,

- mikrokontroler nadrzędny (ang. Master ): W tej roli został wykorzystany mikrokontroler z ro-

dziny AVR, wbudowany w płytkę rozwojową Arduino UNO. Odpowiada on za generowanie sygnałów sterujących na magistrali SPI (MOSI, SCK, SS) oraz realizację algorytmu testo-

wego,

71

72 | Testowanie ekspanderów wejść/wyjść
- płytka stykowa z ekspanderem: Główny obiekt badań. Zastosowanie płytki prototypowej za-

pewnia szybką rekonfigurację połączeń podczas testów bez konieczności lutowania,

- moduły wykonawcze i wskaźnikowe: Do weryfikacji stanów na portach ekspanderów służył

próbnik 7-segmentowy LED - pełnił on funkcję prostego szybkiego wskaźnika wizualnego. Pozwala on na natychmiastową, doświadczalną weryfikację stanów logicznych na pojedynczych pinach wyjściowych ekspandera. Kolejnym elementem wykonawczym był wyświetlacz LCD oparty na sterowniku HD44780U. Służy on do weryfikacji poprawności przesyłu złożonych równoległych danych 8-bitowych oraz trzech sygnałów sterujących,

- aparatura pomiarowa: Zostały wykorzystane: Oscyloskop, który okazał się niezbędny do ana-

lizy czasowej sygnałów cyfrowych. Pozwala on na podgląd przebiegów magistrali SPI oraz badanie zjawisk takich jak drgania styków (ang. bouncing). Multimetr za pomocą którego

zostały zweryfikowane napięcia zasilań, sprawdzenie ciągłości obwodu.

## 9.2 Testy funkcjonalne układów PCF8574

Zanim przystąpiono do tworzenia płytek drukowanych, wykonano kilka testów funkcjonalnych. Pierwszym testem było sprawdzenie działania portów GPIO. Jako wskaźnik stanów logicznych został wykorzystany moduł wyświetlacza 7-segment. Sterowany był poprzez mikrokontroler ATMega AVR 328p, za pomocą programu podobnego do przedstawionego na rysunku 9.8, różni się jedynie implentacją interfejsu, oraz przekazywaniem danych wprost, bez rejestrów sterujących. Program ten wysyła wartość liczbową na ekran z różnymi odstępami czasu. Miało to na celu sprawdzenie, jak układ zachowuje się podczas transmisji wielu danych sekwencyjnie, czy jest stabilny oraz poprawnie wystawia dane na swoich wyprowadzeniach. Jest to kluczowe do sterowania wyświetlaczem, gdzie liczy się poprawność każdej wysłanej komendy. Wynik testu został przedstawiony na rysunku 9.2.
Kolejnym krokiem były testy z docelowym wyświetlaczem, który przyjmował dane równoległe wprost zdeserializowane przy pomocy układu PCF8574. Przy pierwszej próbie układ zachował się nieoczekiwanie, a na wyświetlaczu nie ukazał się pełen napis ”Hello, World”, tylko ”Hdlln, Vnrld”. Wskazywało to na przesunięcie liter o jeden wpis w tabeli ASCII¹
. Sugeruje to zamianę najmniej znaczącego bitu danych. Dodatkową oznaką nieprawidłowego działania wyświetlacza była niepełna inicjalizacja wyświetlacza. Pojawiał się kursor, który w sekwencji inicjalizacyjnej został wyłączony. Usterka, wyglądająca na groźną w rzeczywistości okazała się złym podłączeniem przewodu danych D7. Po wyeliminowaniu błędu układ działał w sposób niezakłócony, również w trybie dwustronnej komunikacji z wykorzystaniem flagi Busy. Na rysunku 9.3 został przedstawiony wynik eksperymentu. Kod sterujący znajduje się na rysunkach 9.4, 9.5, 9.6. To był jasny sygnał do przystąpienia do prac związanych z projektowaniem płytki PCB.

1
standard kodowania znaków operujący na 7-bitach

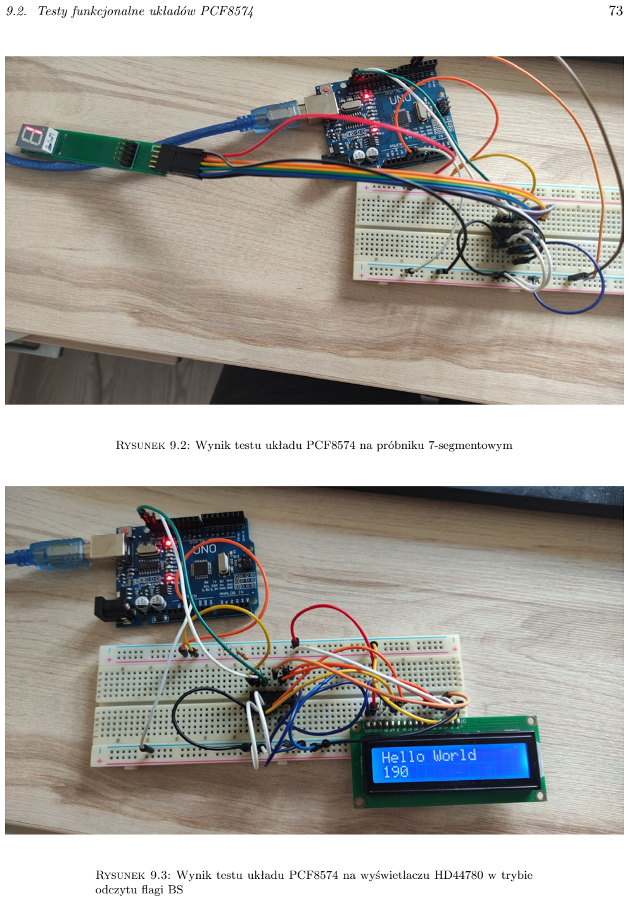
[picture p78: page 73]

9.2. Testy funkcjonalne układów PCF8574 | 73

Rysunek 9.2: Wynik testu układu PCF8574 na próbniku 7-segmentowym

Rysunek 9.3: Wynik testu układu PCF8574 na wyświetlaczu HD44780 w trybie odczytu flagi BS

74 | Testowanie ekspanderów wejść/wyjść

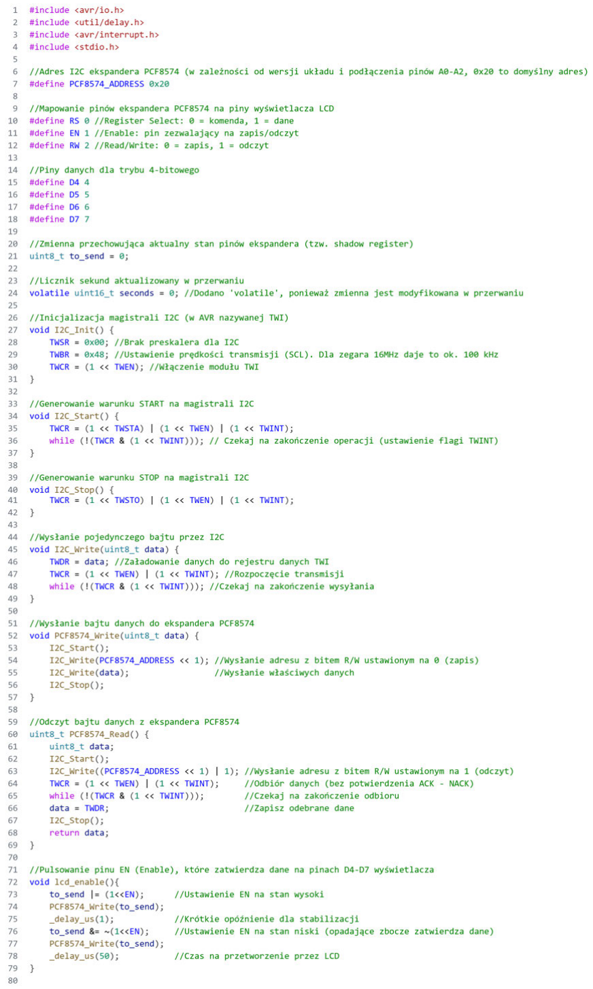
[picture p79: figure]

Rysunek 9.4: Kod programu testowego układu PCF8574. Część I

9.2. Testy funkcjonalne układów PCF8574 | 75

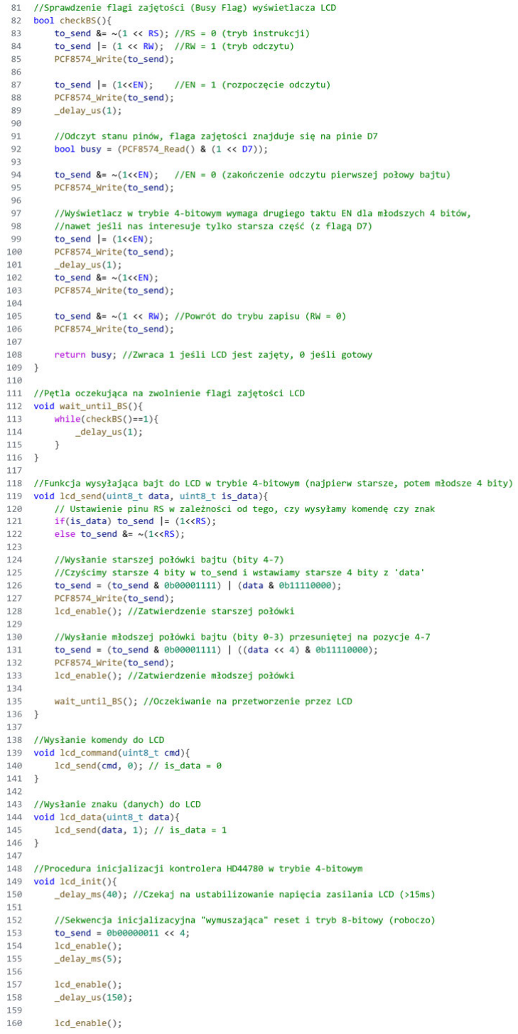
[picture p80: figure]

Rysunek 9.5: Kod programu testowego układu PCF8574. Część II

76 | Testowanie ekspanderów wejść/wyjść

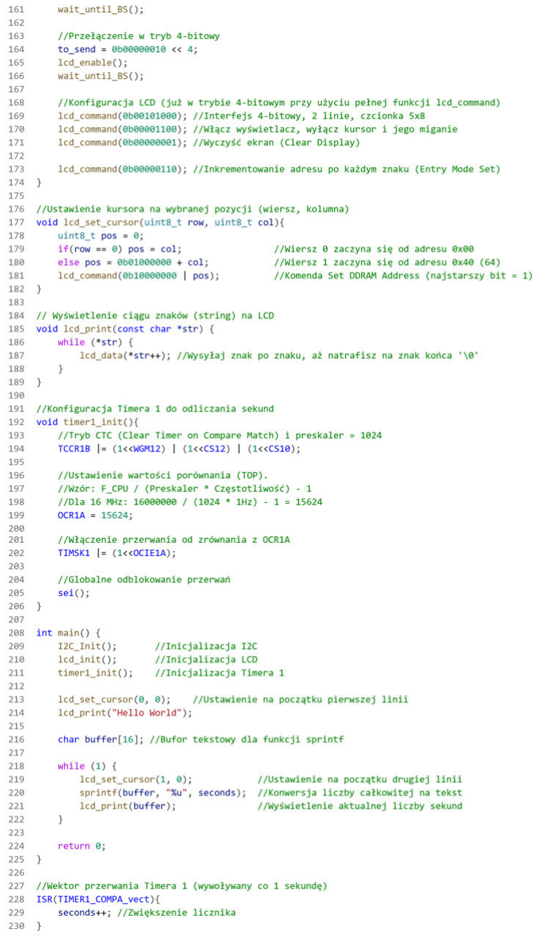
[picture p81: figure]

Rysunek 9.6: Kod programu testowego układu PCF8574. Część III

9.3. Testy funkcjonalne układów MCP23017 | 77

## 9.3 Testy funkcjonalne układów MCP23017

Pozytywny rezultat testów funkcjonalnych na układzie PCF8574 skutkował przeprowadzeniem badań z użyciem ekspanderów z serii MCP23x17. Na rysunku 9.7 przedstawiono fragment obsługi magistrali I²C. Jedną z różnic względem kodu z testów układu PCF8574 było użycie no-

wej funkcji void MCP W rite, która pozwalała wykorzystać złożoność ekspandera MCP23017 tzn. wpisywać dane do poszczególnych rejestrów urządzenia. W kodzie wykonano kilka zestawów badawczych, które miały sprawdzić zachowanie MCP23017 przy zapisie do poszczególnych rejestrów I/O (OLAT i GPIO). W tym celu wykorzystano dwa próbniki 7-segment, ponieważ ekspander ma dwa porty wejść/wyjść. Kod zawierał 4 testy (zmienna test mode), które służyły do sprawdzania

układu MCP23017. Za pomocą wcześniej wymienionej funkcji zapisywania danych, wysyłano koordynaty dla próbników (wyświetlane cyfry). Zależnie od wybranego trybu pracy informacje były

zapisywane na różnych rejestrach lub na wszystkich tego samego rodzaju. Wnioskiem z badania zachowania układu było stwierdzenie, że niezależnie od wybranego rejestru (na danym porcie)

wynik na wyświetlaczu był natychmiastowo aktualizowany. Rozważania na ten temat były spowodowane niejednoznacznym wyjaśnieniem pracy i zachowań rejestrów I/O (OLAT, GPIO) w nocie

katalogowej ekspandera.

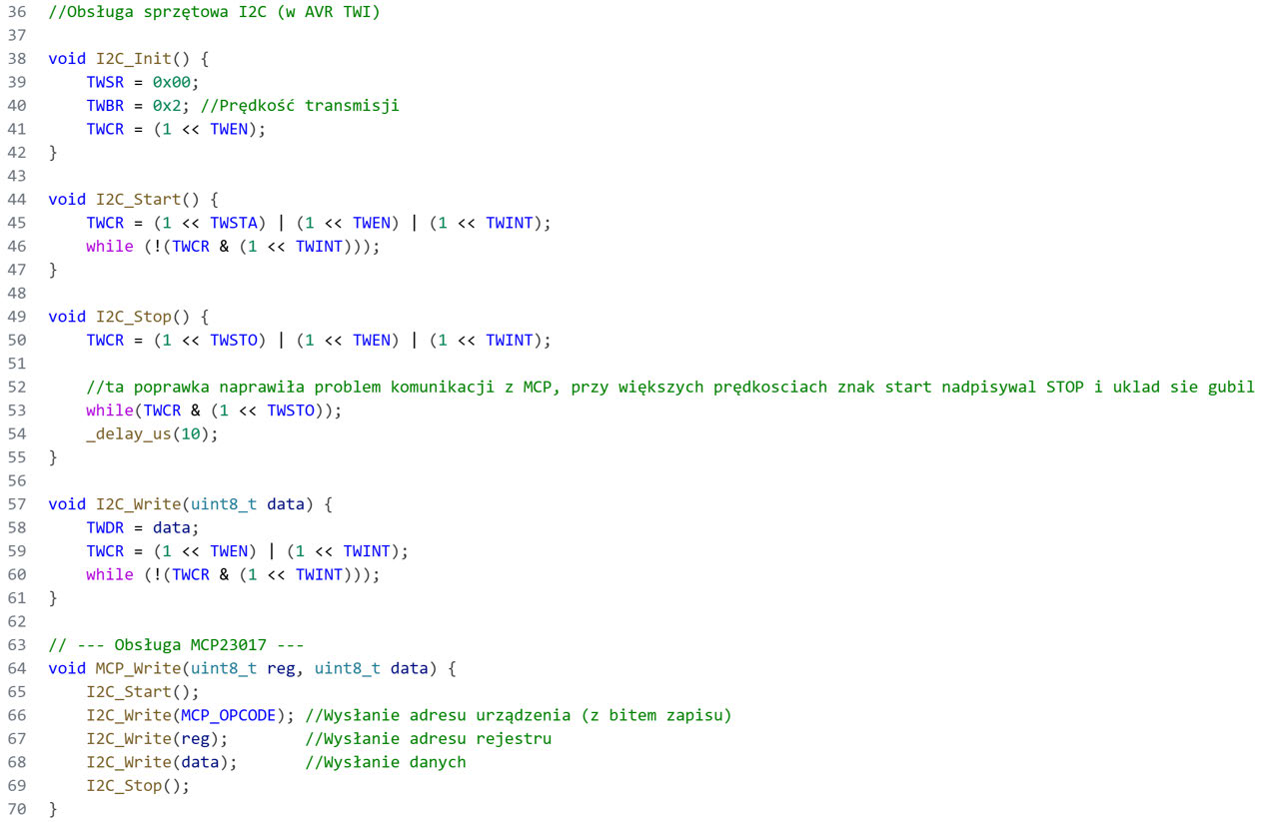
[picture p82: figure]

Rysunek 9.7: Fragment kodu obsługującą komunikację z MCP23017

78 | Testowanie ekspanderów wejść/wyjść

## 9.4 Testy funkcjonalne układów MCP23S17

| Biorąc pod uwagę fakt, że układy MCP23017 oraz MCP23S17 współdzielą niemal identyczną
architekturę wewnętrzną - posiadają ten sam rdzeń logiczny, mapę rejestrów oraz strukturę portów wejścia/wyjścia, proces weryfikacji sprzętowej oparto na założeniach i środowisku testowym przygotowanym wcześniej dla układu na szynie I²C. Zastosowanie analogicznej metody badaw-

czej, wykorzystującej próbniki 7-segmentowe jako deterministyczne wskaźniki stanów logicznych, pozwoliło na rzetelne i miarodajne porównanie obu rozwiązań technologicznych.
| Przejście na protokół SPI udowodniło zalety modularnego pisania kodu. Najważniejsze funkcje
i maszyna stanów głównego programu testowego nie uległy zmianie. Modyfikacji poddano wyłącznie warstwę fizyczną transferu danych. Transakcje oparte na adresowaniu I²C oraz bitach potwierdzeń

zostały zastąpione przez szybką, synchroniczną transmisję szeregową. Wymagało to zaimplementowania programowej obsługi pinu wyboru pinu CS. Komunikacja z układem MCP23S17 wymagała każdorazowego wygenerowania stanu niskiego na linii CS, a następnie wysłaniu trzech bajtów poprzez linię MOSI: bajtu kontrolnego (tzw. Opcode zawierający sprzętowy adres układu), bajt

adresu rejestru oraz właściwego bajtu danych. Dopiero powrót linii CS do stanu wysokiego powodował zatrzaśnięcie przesłanych informacji w strukturze układu. Cały kod realizujący te operacje, z uwzględnieniem podziału na logiczne bloki inicjalizacyjne i wykonawcze, jest widoczny na rysunkach 9.8, 9.9, 9.10.
| Kluczowym wnioskiem płynącym ze zmiany interfejsu komunikacyjnego była poprawa prze-
pływności danych. Magistrala SPI, w przeciwieństwie do I²C, nie wykorzystuje topologii otwartego

drenu i rezystorów podciągających, lecz opiera się na wyjściach typu push-pull [17]. Pozwala to na

uzyskanie bardzo stromych zboczy sygnałów, co z kolei umożliwia taktowanie linii zegarowej SCK częstotliwościami rzędu kilku, a nawet kilkunastu megaherców. Dodatkowo, brak narzutu protokołu w postaci bitów startu, stopu, oraz konieczności oczekiwania na bity potwierdzeń od układu slave, zminimalizował czas propagacji instrukcji od mikrokontrolera do wyprowadzeń ekspandera.
| Podczas testów szczególną uwagę zwrócono na interakcję z rejestrami sterującymi kierunkiem
i stanem portów, które w modelu SPI posiadają dokładnie te same adresy (np. 0x12 dla GPIOA, 0x14 dla OLATA), co w modelu I²C. Zgodnie z założeniami teoretycznymi opisanymi w nocie

katalogowej, zapis danych do rejestru portu (GPIO) oraz bezpośrednio do rejestru zatrzasków wyjściowych (OLAT) przynosił identyczne, natychmiastowe rezultaty. Wyniki obserwacji potwierdziły

wnioski płynące z poprzednich badań: stany logiczne na wyprowadzeniach układu MCP23S17 były aktualizowane bez zauważalnych opóźnień i prawidłowo, stabilnie odzwierciedlane na diodach próbników 7-segmentowych, bez efektu drgania czy migotania sygnału.
| Pomyślne zakończenie testów z wykorzystaniem próbników 7-segmentowych udowodniło pełną
kompatybilność programową i architektoniczną obu układów. Skrócenie czasu transmisji pojedynczego bajtu komendy dzięki magistrali SPI bezpośrednio rozwiązuje problem wąskiego gardła komunikacyjnego. Wyniki te stanowią fundament pod docelową implementację sterownika LCD zgodnego ze standardem HD44780. Pozwala to założyć, że oprogramowanie wyższego poziomu będzie funkcjonować całkowicie transparentnie, niezależne od tego czy fizycznym mostkiem między mikrokontrolerem a matrycą LCD jest układ MCP23017, czy jego szybszy odpowiednik MCP23S17 [2].

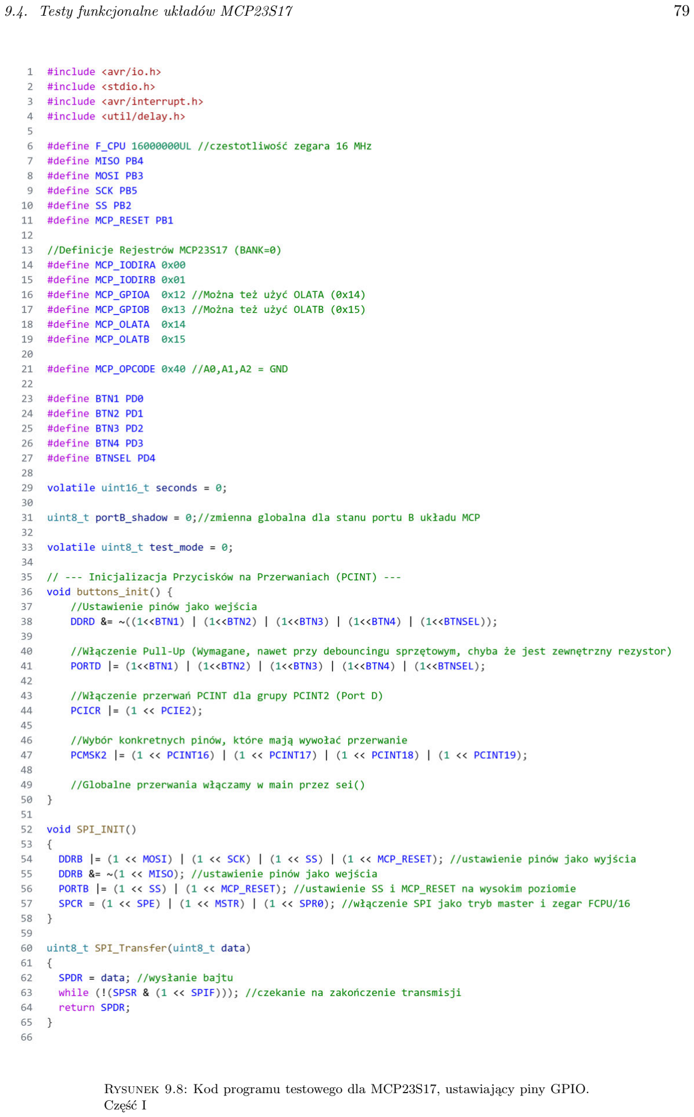
[picture p83: page 79]

9.4. Testy funkcjonalne układów MCP23S17 | 79

Rysunek 9.8: Kod programu testowego dla MCP23S17, ustawiający piny GPIO. Część I

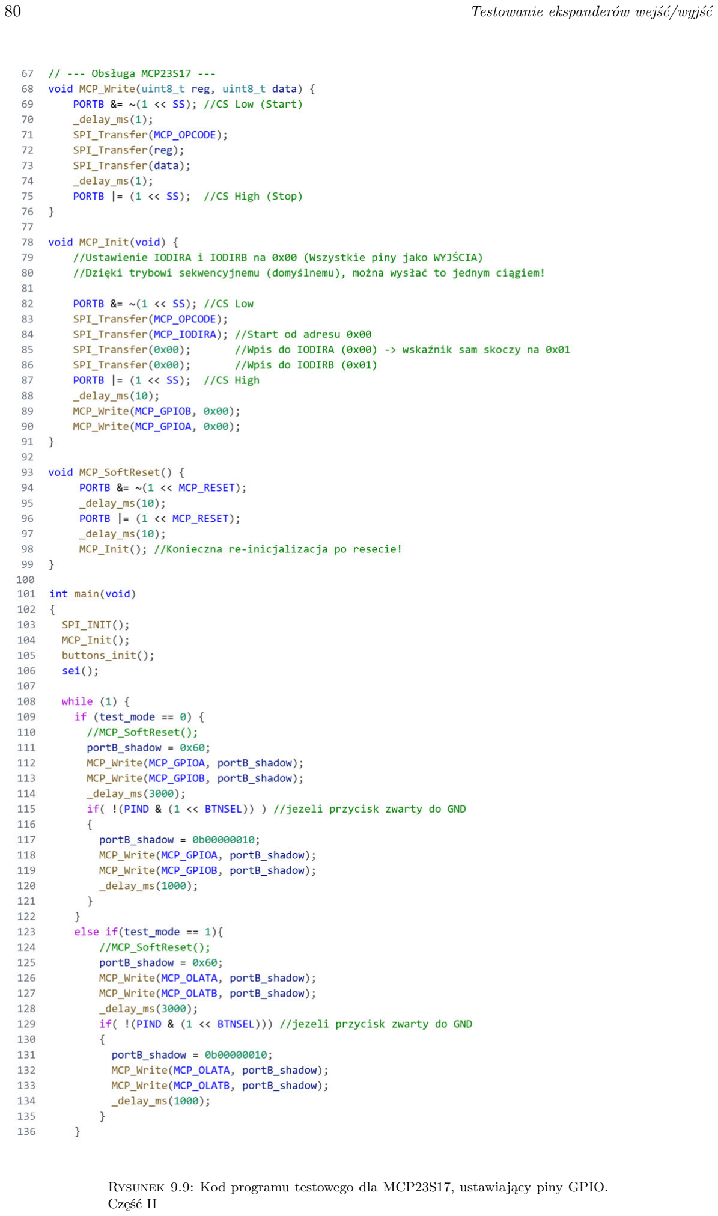
[picture p84: page 80]

80 | Testowanie ekspanderów wejść/wyjść

Rysunek 9.9: Kod programu testowego dla MCP23S17, ustawiający piny GPIO. Część II

9.4. Testy funkcjonalne układów MCP23S17 | 81

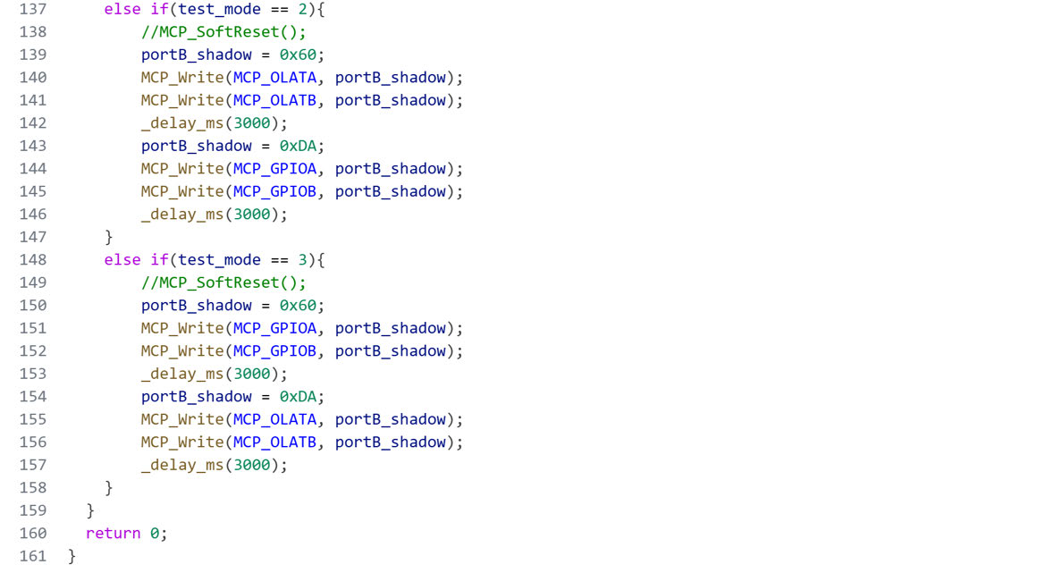
[picture p85: figure]

Rysunek 9.10: Kod programu testowego dla MCP23S17, ustawiający piny GPIO. Część III

# Rozdział 10

# Uruchamianie modułu LCD z

# 8-bitowymi ekspanderami PCF8574

## 10.1 Środowisko pomiarowe

Przetestowanie ekspanderów pod kątem poprawności działania i projekt płytek drukowanych doprowadziły do wyprodukowania modułów. Gotowy obwód dał możliwość badania układów bez troski o jakość połączenia tak jak w przypadku płytek stykowych. Na rysunku 10.1 przedstawiono schemat blokowy środowiska testowego dla modułu z ekspanderami PCF8574. Wykonano zestaw badań, które zostaną opisane szczegółowo w następnych podrozdziałach.

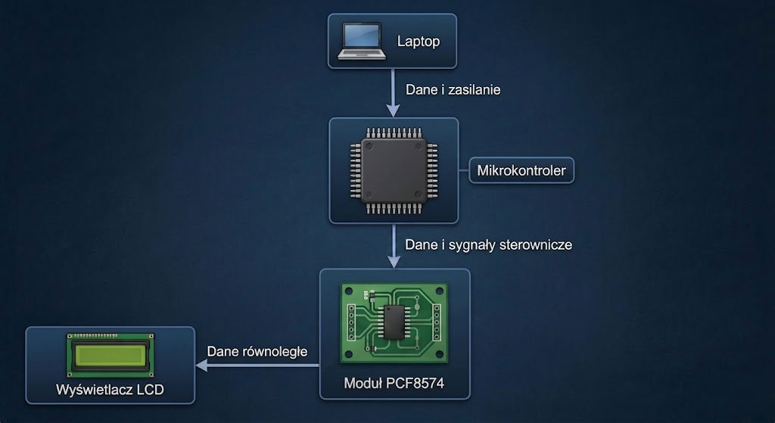
[picture p86: figure]

Rysunek 10.1: Poglądowy schemat modułu z PCF8574

83

84 | Uruchamianie modułu LCD z 8-bitowymi ekspanderami PCF8574

## 10.2 Testy modułu z 8-bitową transmisją równoległą danych

| Zgodnie z projektem moduł obsługiwał dane i sygnały sterujące wysyłane wprost z mikrokon-
trolera na wyświetlacz LCD. W tym trybie ekspandery były całkowicie pominięte. Na rysunku 10.3 oraz 10.4 przedstawiono kod potrzebny do uruchomienia 8-bitowej transmisji równoległej. W kodzie znajdował się szereg funkcji konfiguracyjnych, inicjalizacyjnych, transmisyjnych i wykonawczych. Na rysunku 10.2 oraz 10.7 można zaobserwować wynik omówionych badań.

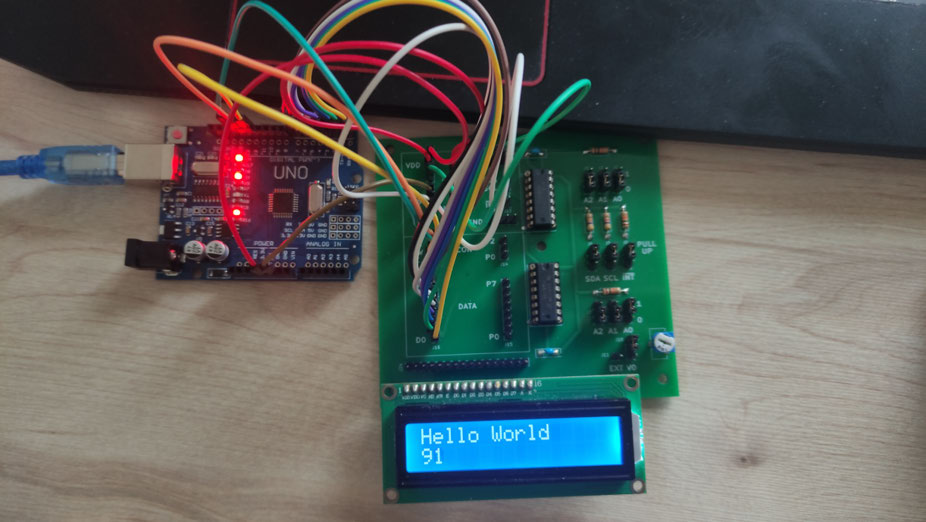
[picture p87: figure]

Rysunek 10.2: Zdjęcie przedstawiające pracę układu w trybie 8-bitowym, na wyświetlaczu 16x2

Przedstawiony kod realizuje 8-bitową transmisję danych. W jego strukturze można znaleźć funkcje realizujące sterowanie wyświetlaczem takie jak lcd enable() do wysyłania impulsu informującego o gotowości wystawionych danych. Kod lcd send() to funkcja, która ustawia pin RS, w zależności

od wysyłania komendy lub danych, w dalszej kolejności wystawia 8 bitów na piny D7-D0 wyświetlacza. Funkcje lcd command() oraz lcd data() to funkcje pomocnicze rozgraniczające wysyłanie komend od danych. W lcd init() odbywa się inicjalizacja wyświetlacza w trybie 8-bitowym zgodnie

z dokumentacją. W linii 68 kodu znajduje się komenda ustawiająca tryb 8-bitowy transmisji oraz włączona obsługa 2 linii dla wyświetlacza 16x2 oraz wielkość czcionki jako 5x8 pikseli. W kolejnej linii jest włączenie wyświetlacza, wyłączenie widoczności kursora. Następna linia czyści wyświetlacz, a po 2 ms przerwie (czas na dokończenie czyszczenia) włączone jest przesuwanie kursora w prawo. Funkcja lcd set cursor() ustawia kursor według podanych koordynat - wiersz, kolumna. Kod lcd print wysyła ciąg znaków na wyświetlacz. Funkcja timer1 init() włącza układ czasowy,

wyzwalający przerwanie co 1 sekundę. W linii 117 jest obsługa wektoru przerwania - inkrementacja zmiennej seconds. W funkcji głównej zostało zrealizowane wyzwolenie funkcji inicjalizujących ustawienie kursora na pozycję początkową, wyświetlenie napisu ”Hello World”oraz w kolejnej linii cykliczne zliczanie pracy układu w sekundach. W kolejnych podrozdziałach zostały wymienione jedynie kluczowe różnice dla innych implementacji oraz trybów transmisji danych.

10.2. Testy modułu z 8-bitową transmisją równoległą danych | 85

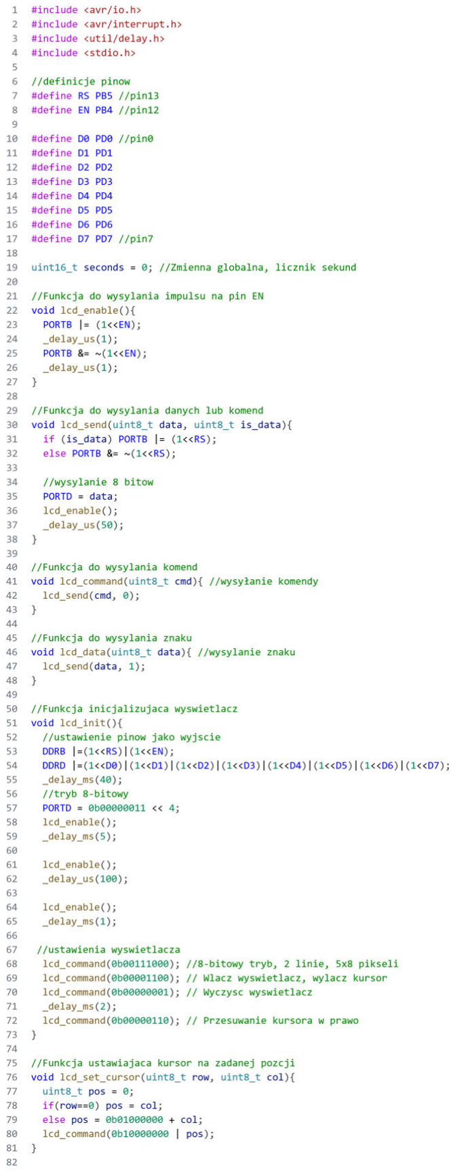
[picture p88: figure]

Rysunek 10.3: Kod programu obsługujący tryb 8-bitowej transmisji danych do modułu wyświetlacza. Część I

86 | Uruchamianie modułu LCD z 8-bitowymi ekspanderami PCF8574

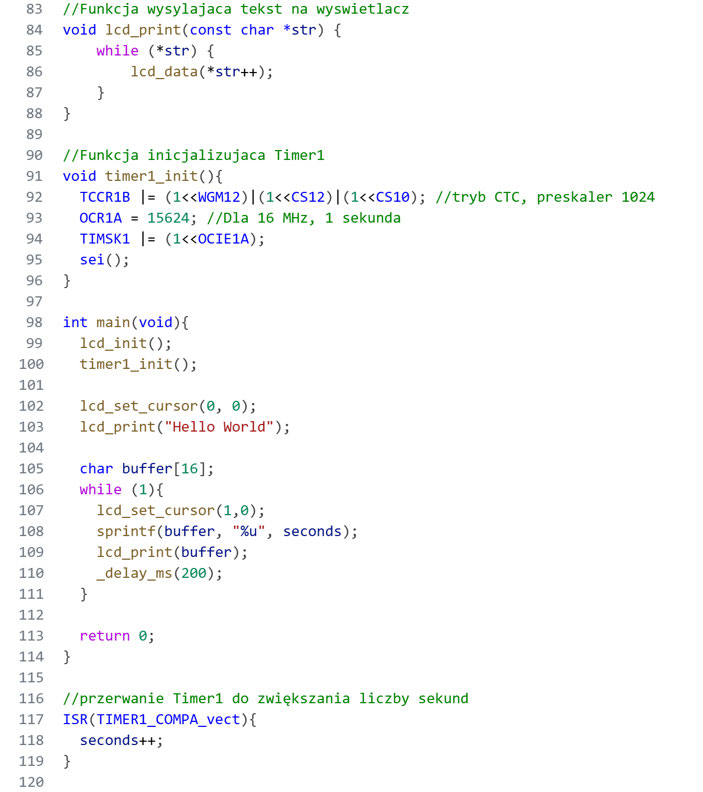
[picture p89: figure]

Rysunek 10.4: Kod programu obsługujący tryb 8-bitowej transmisji danych do modułu wyświetlacza. Część II

Wymiana wyświetlacza na większy wymagała rozszerzenia funkcji lcd set cursor. Dodano 2 kolejne wiersze o maskach bitowych 0x14 oraz 0x54. Rozbudowano również funkcję main, tak aby wypełnić całe dostępne miejsce na wyświetlaczu.

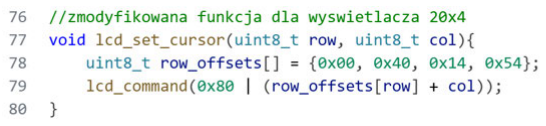
[picture p90: figure]

Rysunek 10.5: Zmodyfikowana funkcja lcd set cursor dla wyświetlacza 20x4

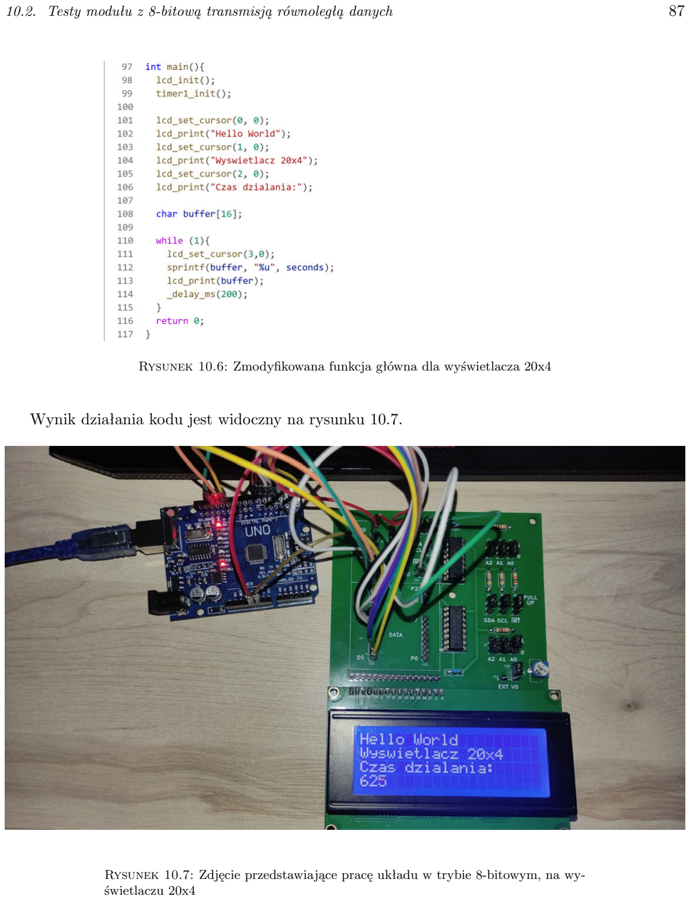
[picture p91: page 87]

10.2. Testy modułu z 8-bitową transmisją równoległą danych | 87

Rysunek 10.6: Zmodyfikowana funkcja główna dla wyświetlacza 20x4

Wynik działania kodu jest widoczny na rysunku 10.7.

Rysunek 10.7: Zdjęcie przedstawiające pracę układu w trybie 8-bitowym, na wyświetlaczu 20x4

88 | Uruchamianie modułu LCD z 8-bitowymi ekspanderami PCF8574

## 10.3 Testy modułu z 4-bitową transmisją równoległą danych

| Sterownik HD44780 oprócz pracy 8-bitowej oferował możliwość dwukrotnego zredukowania
liczby połączeń linii danych. Kluczowe funkcje różniące się od implementacji 8-bitowej zostały przedstawione na rysunku 10.9.

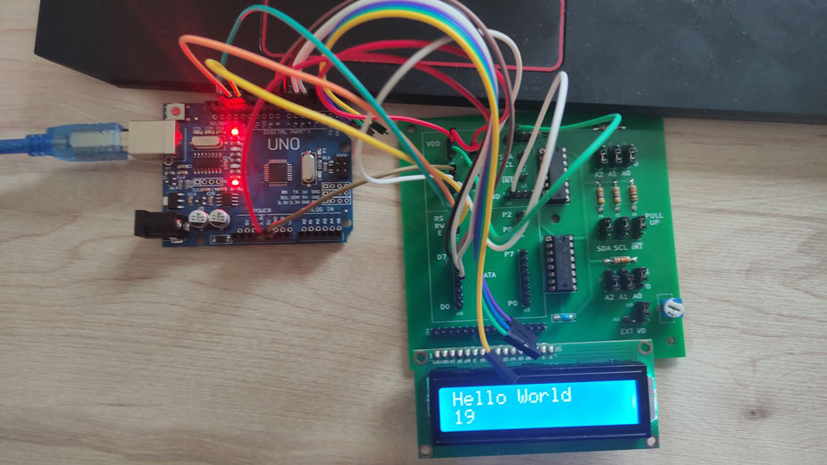
[picture p92: figure]

Rysunek 10.8: Zdjęcie przedstawiające pracę układu w trybie 4-bitowym

Dla implementacji 4-bitowej transmisji danych poddano ewolucji funkcję lcd send. W zmodyfikowanej funkcji wymiany danych wysyłano starszy półbajt na piny P7 - P4. Po przesłaniu połowy danych czyszczono stan wyjść i sumowano z przesuniętymi o 4 pozycje najmłodszymi bitami. Takim sposobem realizowano komunikację 8-bitową przy ograniczonej liczbie połączeń.

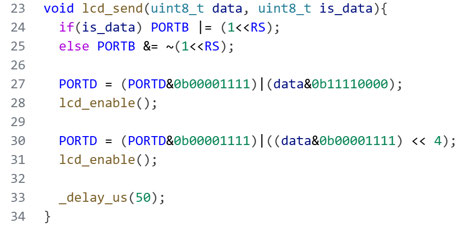
[picture p93: figure]

Rysunek 10.9: Funkcja lcd send dla implementacji 4-bitowej

Inicjalizacja wyświetlacza również musiała przejść proces renowacji. W linii 46 ustawiono tylko 4 najstarsze bity jako wyjścia mikrokontrolera do przesyłu danych. Od tej pory każda instrukcja musiała zostać przesunięta o 4 miejsca w lewo. Po procedurze resetu (linie 49 - 57) następowała

konfiguracja sterownika graficznego. Moment nastawy trybu 4-bitowej wymiany danych znajdował się w linii nr. 59. Wraz z wysłaniem komendy i zatwierdzeniem jej przez sterownik układ przyjmował dane w sposób, który przedstawiono w poprzednim fragmencie kodu.

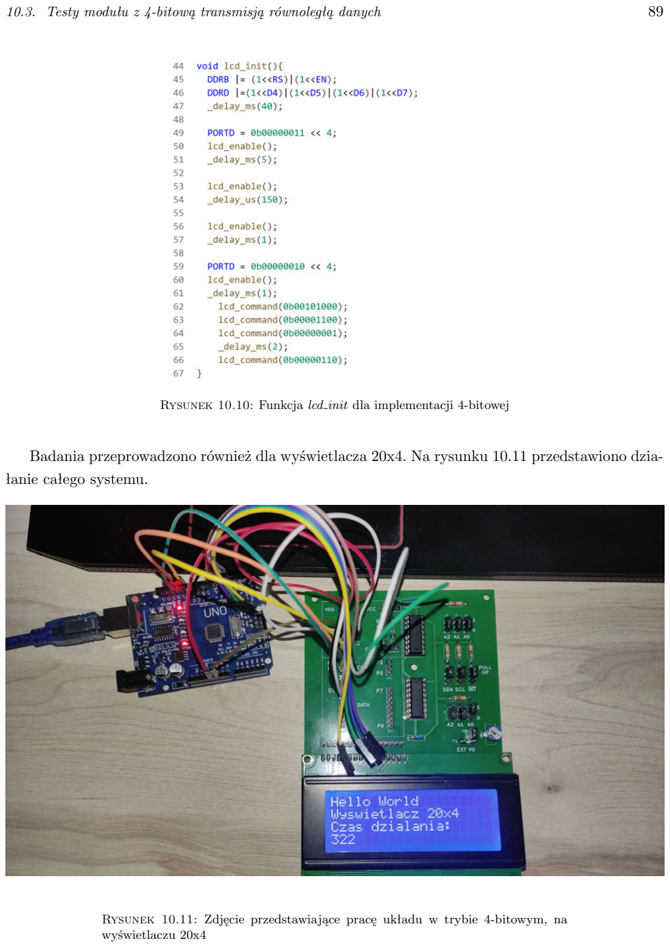
[picture p94: page 89]

10.3. Testy modułu z 4-bitową transmisją równoległą danych | 89

Rysunek 10.10: Funkcja lcd init dla implementacji 4-bitowej

Badania przeprowadzono również dla wyświetlacza 20x4. Na rysunku 10.11 przedstawiono działanie całego systemu.

Rysunek 10.11: Zdjęcie przedstawiające pracę układu w trybie 4-bitowym, na wyświetlaczu 20x4

## 10.4 Testy modułu z transmisją szeregową danych

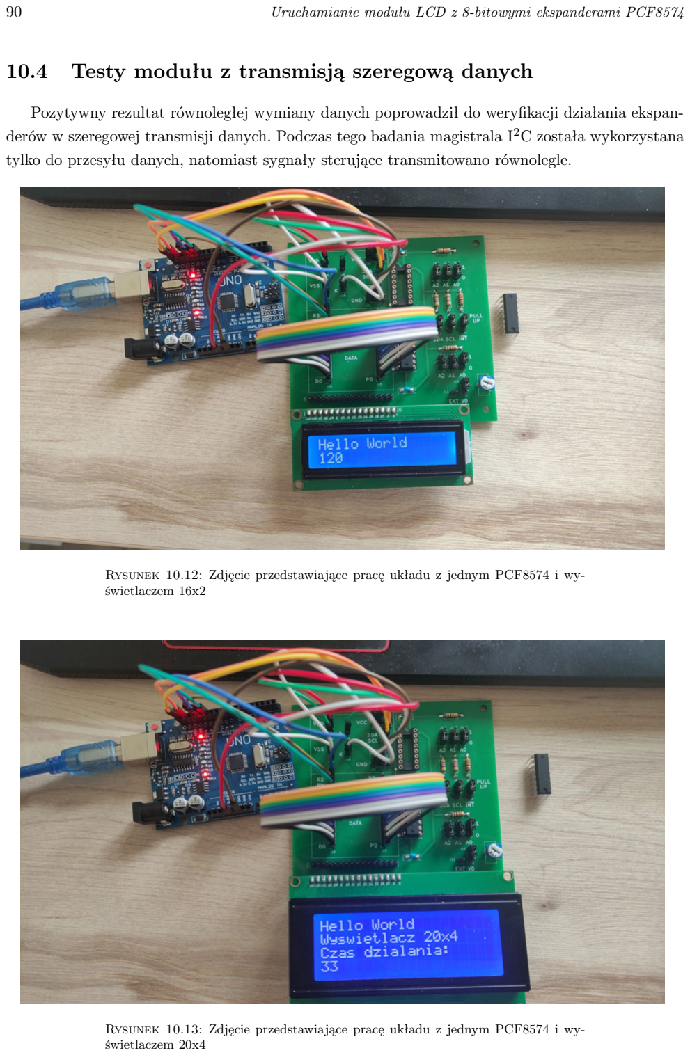
[picture p95: page 90]

90 | Uruchamianie modułu LCD z 8-bitowymi ekspanderami PCF8574

Pozytywny rezultat równoległej wymiany danych poprowadził do weryfikacji działania ekspanderów w szeregowej transmisji danych. Podczas tego badania magistrala I²C została wykorzystana

tylko do przesyłu danych, natomiast sygnały sterujące transmitowano równolegle.

Rysunek 10.12: Zdjęcie przedstawiające pracę układu z jednym PCF8574 i wyświetlaczem 16x2

Rysunek 10.13: Zdjęcie przedstawiające pracę układu z jednym PCF8574 i wyświetlaczem 20x4

10.4. Testy modułu z transmisją szeregową danych | 91

Prezentowany na rysunku 10.14 program implementuje sposób sterowania wyświetlaczem LCD. Rozwiązanie to łączy szeregową transmisję danych za pośrednictwem zewnętrznego ekspandera z bezpośrednim równoległym sterowaniem liniami kontrolnymi z poziomu mikrokontrolera AT-

Mega328p. Zastosowanie takiego podejścia stanowi kompromis, pozwala na zaoszczędzenie zasobów sprzętowych (pinów GPIO) procesora nadrzędnego odpowiedzialnych za 8-bitową transmisję

danych, przy jednoczesnym zachowaniu maksymalnej szybkości i precyzji sygnałów sterujących (RS, RW, E). Komunikacja z omawianym ekspanderem obywa się za pomocą I²C. Transmisja

danych opiera się na sekwencyjnym wywołaniu zestawu niskopoziomowych funkcji sterujących magistralą, do których należą I2C Init(), I2C Start(), I2C Write(), I2C Stop(). Sercem modułu

odpowiedzialnego za translację poleceń systemowych na stany fizyczne ekspandera jest funkcja PCF8574 Write(). Przyjmuje ona jako argument jeden 8-bitowy bajt danych, który reprezentuje

docelowy stan logiczny wszystkich ośmiu wyprowadzeń układu PCF8574. Wewnątrz tej funkcji realizowany jest kompletny cykl transmisyjny I²C, czyli wysłanie zdefiniowanego adresu sprzęto-

wego ekspandera, a następnie przesłanie bajtu danych, który bezpośrednio przepisuje stany na piny wyjściowe układu scalonego.
Podczas gdy szyna danych (D0-D7) sterownika wyświetlacza połączona jest z wyjściami eks-

pandera PCF8574, sygnały sterujące RS, RW, E są obsługiwane asynchronicznie i bezpośrednio przez PORT B mikrokontrolera ATMega328p. Operacje te są realizowane w liniach 73 oraz 74.

Wykorzystanie bitowych operatorów sumy logicznej oraz iloczynu logicznego z negacją pozwala na bezwzględną modyfikację stanów wybranych pinów bez naruszania konfiguracji pozostałych wyprowadzeń portu. Bezpośrednie połączenie linii E do pinu mikrokontrolera ma fundamentalne znaczenie dla stabilności działania systemu. Sterownik HD44780 wymaga, aby impuls Enable miał ściśle określony czas trwania oraz odpowiednio strome zbocza. Generowanie tego impulsu poprzez programowe opóźnienia delay us() bezpośrednio na pinie mikrokontrolera pozwala uniknąć narzutów czasowych magistrali I²C, które wystąpiłoby, gdyby sygnał E również był generowany przez

ekspander. Zapobiega to powstawaniu błędów transmisji i gwarantuje poprawną interpretację instrukcji przez wewnętrzną maszynę stanów wyświetlacza.
Pozostała część struktury oprogramowania jest zgodna z klasycznym algorytmem transmisji w pełni równoległej, co ułatwia migrację kodu między różnymi platformami. W kodzie istnieją również zakomentowane funkcje sterujące wyświetlaczem 20x4, zlokalizowane w liniach 113-120 oraz 140-145. Zostały one wykorzystane przy testach większego wyświetlacza, którego wynik działania został zaprezentowany na rysunku 10.13. Wprowadzenie tych zmian jest podyktowane odmienną organizacją pamięci DDRAM (ang. Display Data RAM ) w układach wielowierszowych. Podczas gdy standardowy wyświetlacz 16x2 adresuje wiersze w sposób ciągły (począwszy od adresów 0x00 dla linii pierwszej oraz 0x40 dla linii drugiej), sterownik formatu 20x4 dokonuje logicznego przesunięcia pamięci. Wiersz trzeci stanowi fizyczne przedłużenie wiersza pierwszego (adres początkowy 0x14), natomiast wiersz czwarty kontynuuje przestrzeń adresową wiersza drugiego (adres początkowy 0x54) [18].

92 | Uruchamianie modułu LCD z 8-bitowymi ekspanderami PCF8574

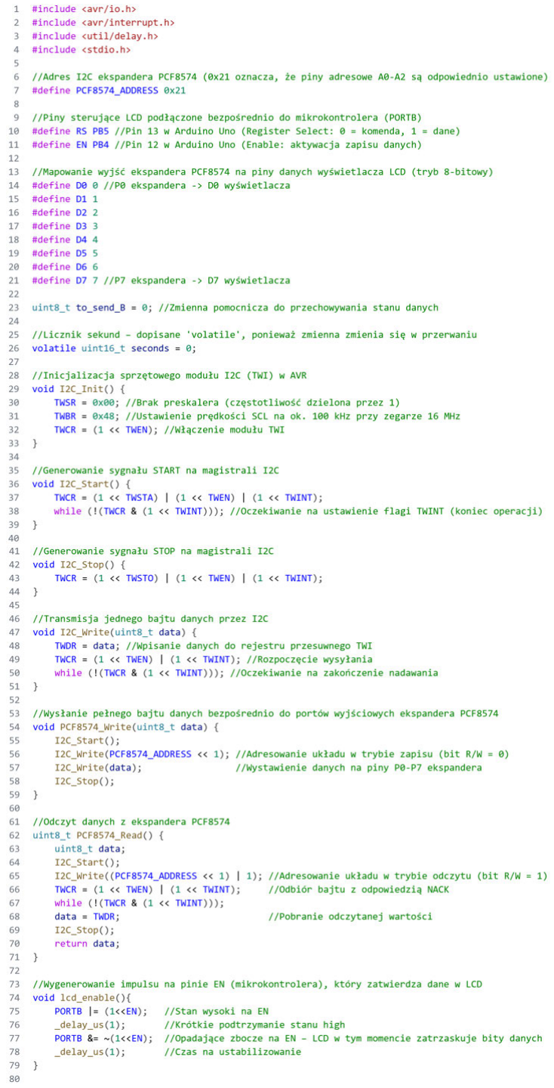
[picture p96: figure]

Rysunek 10.14: Kod programu obsługujący transmisję 8 bitową danych jednym PCF8574. Część I

10.4. Testy modułu z transmisją szeregową danych | 93

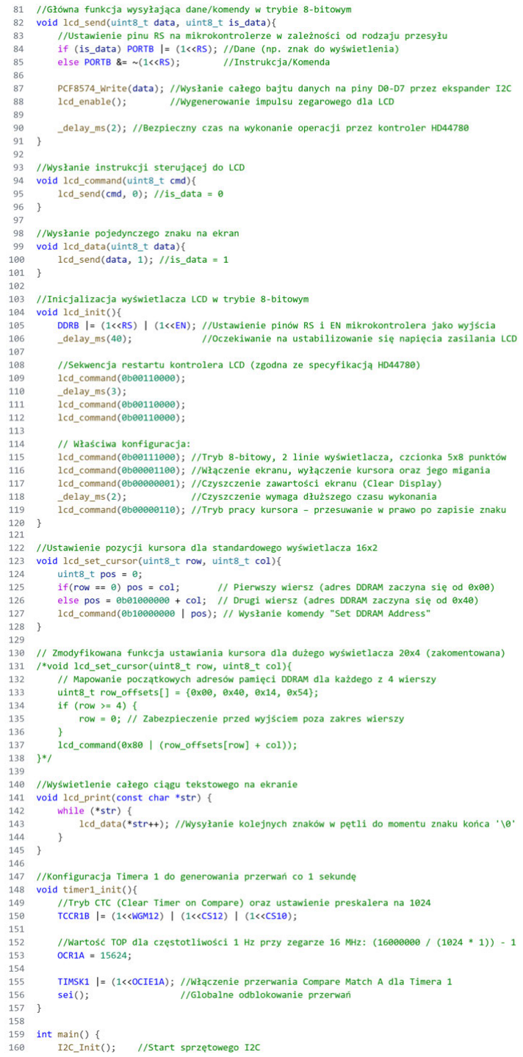
[picture p97: figure]

Rysunek 10.15: Kod programu obsługujący transmisję 8 bitową danych jednym PCF8574. Część II

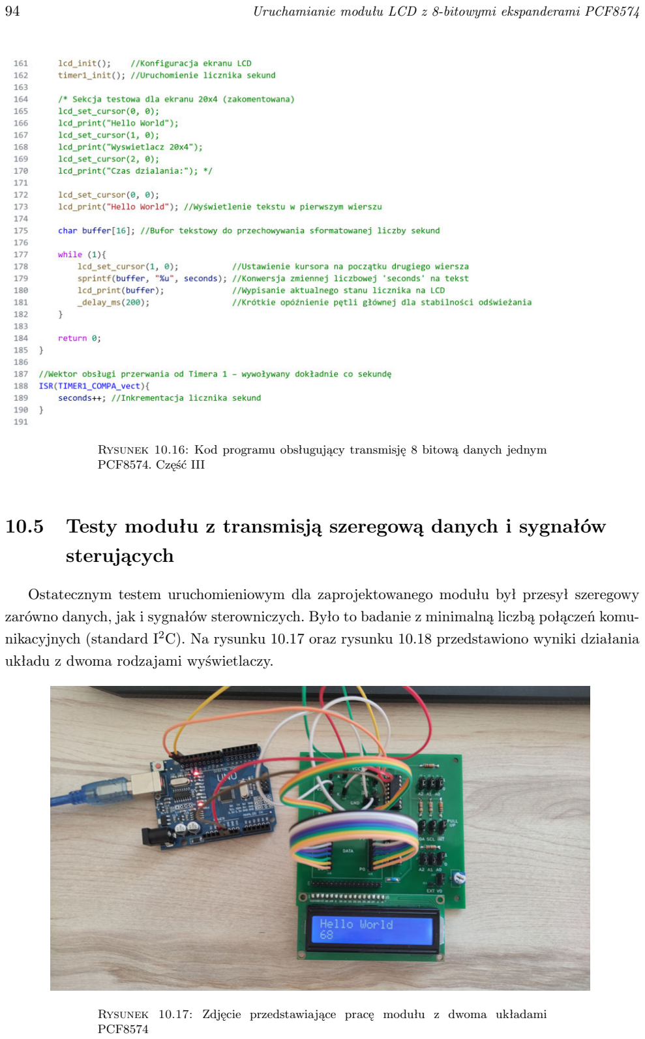
[picture p98: page 94]

94 | Uruchamianie modułu LCD z 8-bitowymi ekspanderami PCF8574

Rysunek 10.16: Kod programu obsługujący transmisję 8 bitową danych jednym PCF8574. Część III

## 10.5 Testy modułu z transmisją szeregową danych i sygnałów

## sterujących

Ostatecznym testem uruchomieniowym dla zaprojektowanego modułu był przesył szeregowy zarówno danych, jak i sygnałów sterowniczych. Było to badanie z minimalną liczbą połączeń komunikacyjnych (standard I²C). Na rysunku 10.17 oraz rysunku 10.18 przedstawiono wyniki działania

układu z dwoma rodzajami wyświetlaczy.

Rysunek | 10.17: | Zdjęcie przedstawiające pracę modułu z dwoma układami
PCF8574

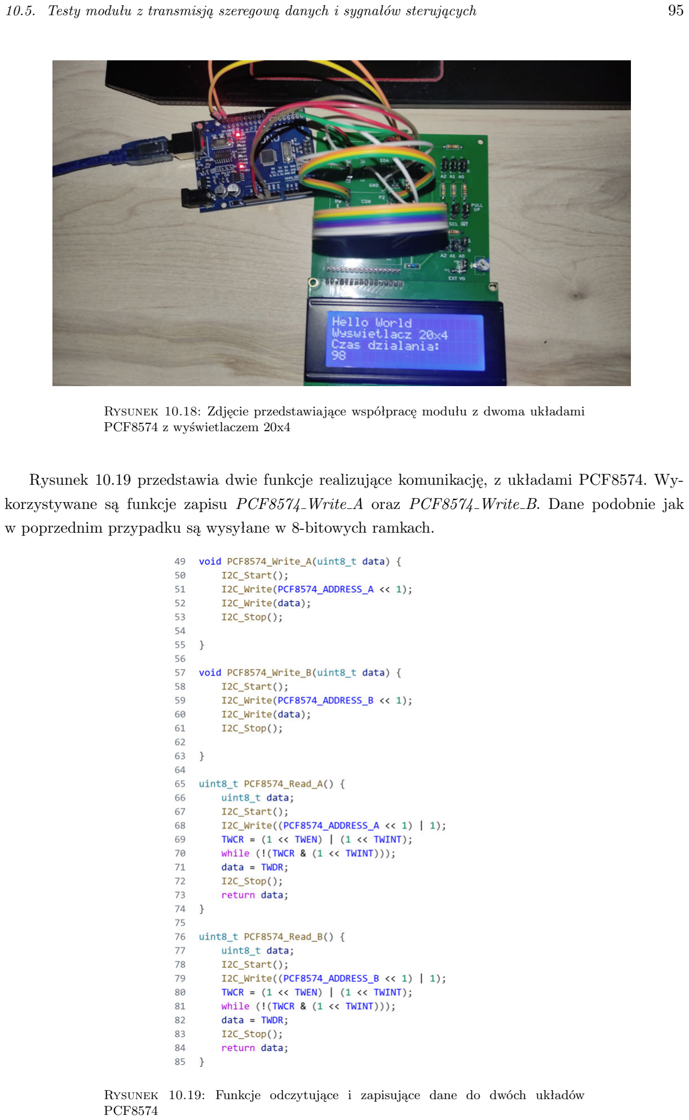
[picture p99: page 95]

10.5. Testy modułu z transmisją szeregową danych i sygnałów sterujących | 95

Rysunek 10.18: Zdjęcie przedstawiające współpracę modułu z dwoma układami PCF8574 z wyświetlaczem 20x4

Rysunek 10.19 przedstawia dwie funkcje realizujące komunikację, z układami PCF8574. Wykorzystywane są funkcje zapisu PCF8574 Write A oraz PCF8574 Write B. Dane podobnie jak

w poprzednim przypadku są wysyłane w 8-bitowych ramkach.

Rysunek | 10.19: | Funkcje odczytujące i zapisujące dane do dwóch układów
PCF8574

96 | Uruchamianie modułu LCD z 8-bitowymi ekspanderami PCF8574

Na obrazku 10.20 widoczne są zmodyfikowane funkcje lcd enable oraz lcd send. Sygnały sterujące nie są już wysyłane równolegle wprost z pinów mikrokontrolera, ale przekazywane za pośrednictwem dodatkowego układu PCF8574.

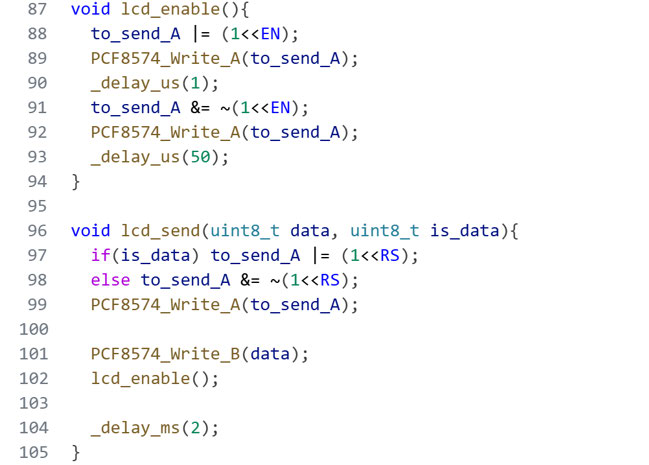
[picture p100: figure]

Rysunek 10.20: Funkcje enable i send dla wyświetlacza sterowanego układami PCF8574

# Rozdział 11

# Uruchamianie modułu LCD z

# 16-bitowymi ekspanderami

# MCP23x17

## 11.1 Środowisko pomiarowe

Testy uruchomieniowe wykonano z użyciem zaprojektowanego modułu z dwoma ekspanderami z rodziny MCP23x17. Do komunikacji wykorzystano moduł Ardiuno Uno, natomiast dane wyświetlano na dwóch rodzajach ekranów LCD.

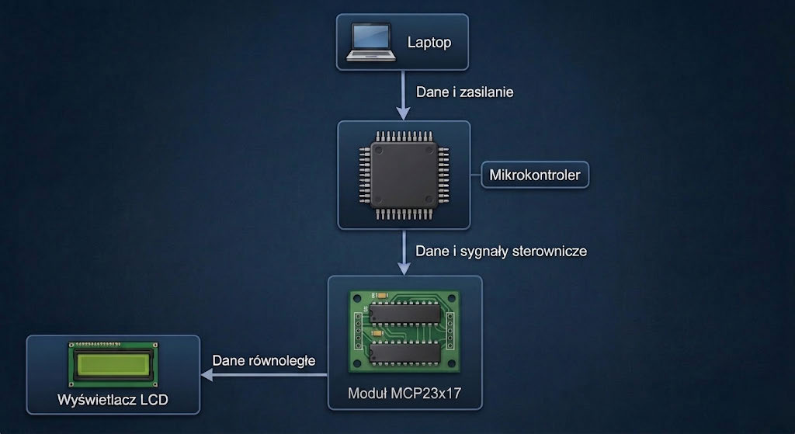
[picture p101: figure]

Rysunek 11.1: Schemat funkcjonalny systemu do testów modułu z układami MCP23x17

97

98 | Uruchamianie modułu LCD z 16-bitowymi ekspanderami MCP23x17

## 11.2 Testy modułu z 8-bitową transmisją równoległą danych

| W badaniach zapewniono, możliwość bezpośredniego transmitowania danych z mikrokontrolera
na wyświetlacz, z użyciem magistrali równoległej wpiętej do zaprojektowanego złącza danych przy ekranie LCD. Kod obsługujący równoległą wymianę danych z testów uruchomieniowych modułu z ekspanderami PCF8547 działał również dla tego projektu. Złącza danych w obu urządzeniach zostały stworzone podobnie, przez co nie powstały zmiany w implementacji komunikacji.

## 11.3 Testy modułu z 4-bitową transmisją równoległą danych

| Po sprawdzeniu 8-bitowej równoległej transmisji danych naturalnym krokiem było zbadanie
komunikacji z okrojoną liczbą bitów. Tak samo jak w poprzednio opisanym badaniu kod dla modułu z PCF8574 pasował do implementacji na płytce z ekspanderami MCP23x17.

## 11.4 Testy modułu z transmisją danych przez łącze I²C

| Zgodnie z koncepcją modułu, w projekcie zastosowano magistralę szeregową I²C. Badania uru-

chomieniowe przeprowadzono w ten sam sposób, jak w przypadku testów płytki z PCF8574 tzn. najpierw sprawdzono sam przesył danych magistralą. Kod przeprowadzający transmisję był kopią programu do obsługi modułu z działu czwartego, wzbogaconą o obsługę rejestrów MCP23017. Mapę rejestrów urządzenia przedstawiono na rysunku 11.2.

Rysunek 11.2: Mapa rejestrów ekspandera MCP23017

Sygnały sterujące wyświetlacz LCD były wysyłane poprzez odpowiednie ustawienia portów mikrokontrolera w Arduino Uno. Program zawierający funkcjonalności magistrali I²C, którą prze-

syłano dane zawarto na rysunku 11.3 oraz 11.4.

11.5. Testy modułu z transmisją danych i sygnałów sterujących przez łącze I2C | 99

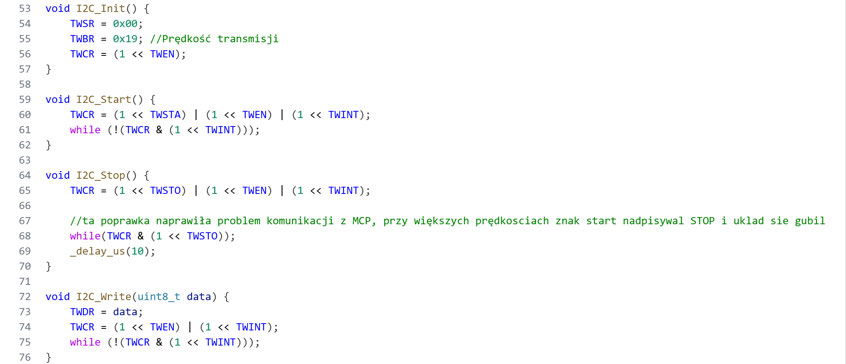
[picture p102: figure]

Rysunek 11.3: Obsługa magistrali I²C. Część I

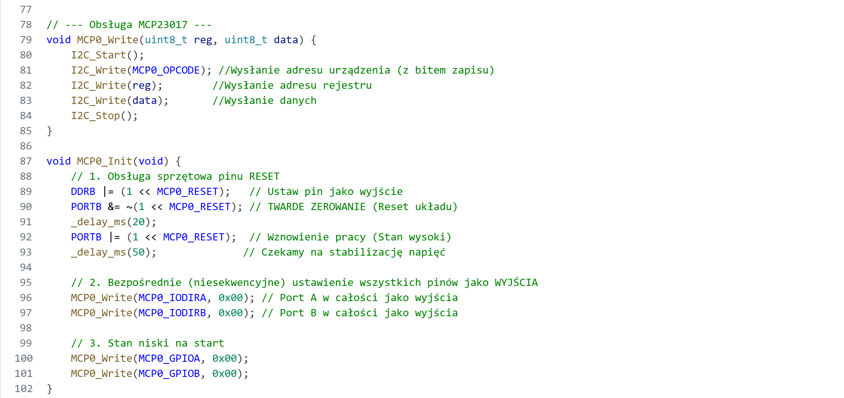
[picture p103: figure]

Rysunek 11.4: Obsługa magistrali I²C. Część II

Moduł był przygotowany do współpracy z wyświetlaczami 2x16 oraz 4x20. Zasada działania sterowania ekranami pozostała identyczna jak w poprzednich programach.

## 11.5 Testy modułu z transmisją danych i sygnałów sterujących

## przez łącze I2C

Po pozytywnie przeprowadzonej transmisji danych, wykonano próbę kontroli wyświetlacza wykorzystując dodatkowy przesył sygnałów sterowniczych magistralą I²C. Omawiana funkcjonalność

została przedstawiona na rysunku 11.5. W programie zdefiniowano indywidualne nazwy takie jak np. LCD RS BIT, które zawierały w sobie przypisaną pozycję w porcie GPIOB. W funkcjach inicjalizowano zmienną portB shadow pozwalającą na manipulowanie sygnałami sterującymi. Następnie

100 | Uruchamianie modułu LCD z 16-bitowymi ekspanderami MCP23x17

za pomocą wcześniej omówionych funkcji aktualizowano stan na porcie GPIOB. W kodzie zawarto aktualizację linii sterujących dla interfejsu SPI, który został wykorzystany w dalszych badaniach. Różnicę można zaobserwować w nazwach własnych funkcji tzn. MCP0 Write odpowiadała za komunikację magistralą I²C, natomiast MCPS Write kontrolowało interfejs SPI.

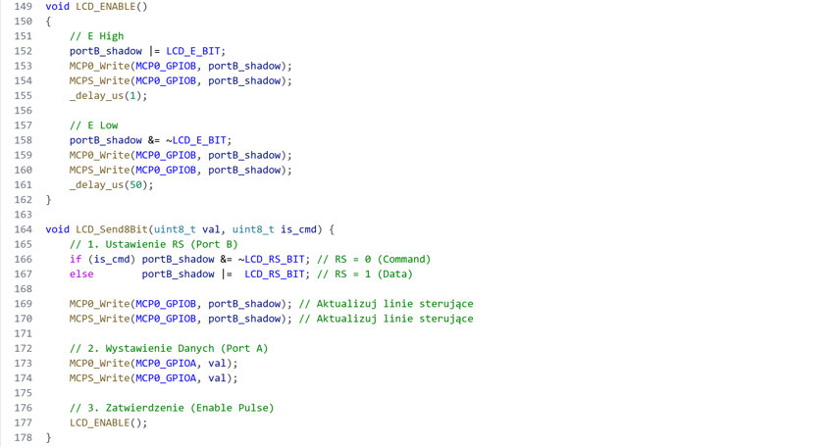
[picture p104: figure]

Rysunek 11.5: Transmisja sygnałów sterowniczych magistralą I²C oraz SPI

## 11.6 Testy modułu z transmisją danych przez łącze SPI

Nowością względem poprzednich implementacji było zawarcie inicjalizacji i transmisji z wykorzystaniem znacznie szybszej magistrali SPI. Dla przejrzystości kodu dodano definicje portów interfejsu (rys. 11.6) oraz rejestrów ekspandera (rys. 11.7).

Rysunek 11.6: Definicje pinów ekspandera MCP23S17

Rysunek 11.7: Mapa rejestrów ekspandera MCP23S17

Inicjalizację interfejsu charakteryzowały dwa segmenty - ustawienia pinów i ustalenie prędkości sygnału zegarowego. Zgodnie z normami komunikacji magistrali SPI stworzono funkcje do transmi-

11.7. Testy modułu z transmisją danych i sygnałów sterujących przez łącze SPI | 101

sji danych. Każdą sesję komunikacji rozpoczynało typowe ściągnięcie pinu CS do stanu niskiego oraz przesłanie adresu urządzenia, z którym chciano nawiązać łączność. Wymianę danych z użyciem SPI można porównać do taśmociągu, w którym jednocześnie adresat otrzymuje dane od nadawcy i na odwrót. Nie da się niczego nadać bez przyjęcia zwrotnej wiadomości. W kodzie stworzono funkcję SPI Transfer, która odpowiadała za ten mechanizm. Posługując się rejestrem SPDR jednocześnie wypychano dane do odbiorcy, i zwracano wartość zachowaną w urządzeniu podrzędnym. Takim sposobem uzyskano warstwę fizyczną pod główną funkcję do komunikacji MCPS Write, która służyła do nadpisywania danych rejestrów żądanymi wartościami. Finalną funkcją, kończącą zbiór instrukcji odpowiedzialnych za obsługę magistrali SPI była inicjalizacja ekspandera. Na początku deklarowano kierunek transmisji dla portów urządzenia. W tym celu na odpowiednie rejestry wysyłano wartość 0 zapisaną systemem szesnastkowym. Takim sposobem kończyła się pierwsza część inicjalizacji. Funkcję kończyło nadpisanie rejestrów portów GPIOA i GPIOB zerami, aby uniknąć odczytu nieprawidłowych danych w fazie początkowej. Kod przedstawiono na rysunku 11.8.

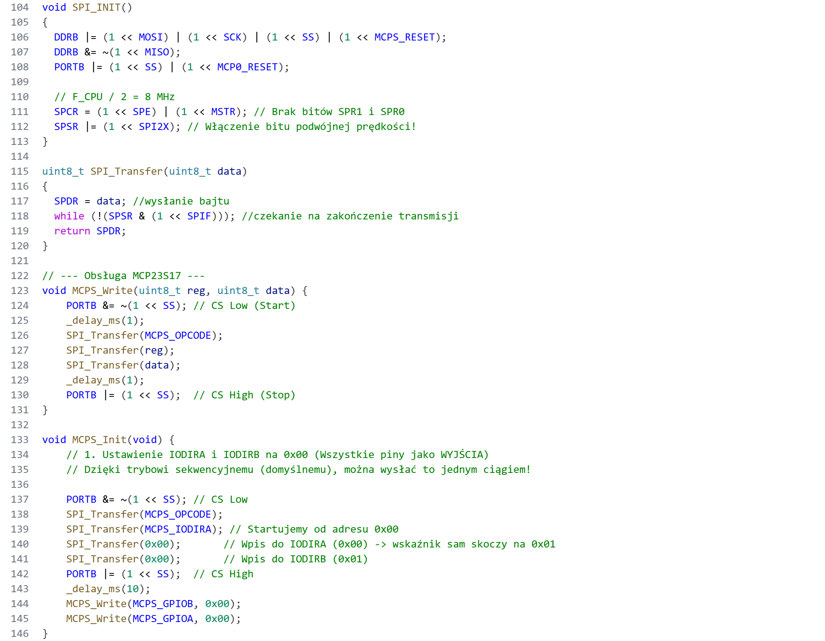
[picture p105: figure]

Rysunek 11.8: Fragment kodu odpowiedzialny za transmisję SPI dla danych

## 11.7 Testy modułu z transmisją danych i sygnałów sterujących

## przez łącze SPI

W toku przeprowadzonych badań, równolegle z analizą magistrali I²C, dokonano empirycznej

weryfikacji sprzętowego sterowania matrycą LCD z wykorzystaniem szybkiego interfejsu szerego-

102 | Uruchamianie modułu LCD z 16-bitowymi ekspanderami MCP23x17

wego SPI (ang. Serial Peripheral Interface). Mechanizm kontroli sygnałów sterowniczych wyświe-

tlacza z poziomu warstwy logicznej aplikacji pozostał spójny z rozwiązaniem opartym na magistrali I²C (co zilustrowano na rysunku 11.5), jednakże konieczne było całkowite przeprojektowanie

warstwy abstrakcji sprzętowej (HAL) odpowiedzialnej za fizyczny transfer danych do ekspandera

portów MCP23S17.
Zasadnicza różnica między analizowanymi interfejsami leży w ich topologii oraz sposobie dystrybucji sygnałów. Inicjalizacja interfejsu SPI w mikrokontrolerze nadrzędnym wymagała przeprowadzenia precyzyjnej, dwuetapowej konfiguracji. W pierwszym kroku zdefiniowano kierunki wyprowadzeń sprzętowych modułu komunikacyjnego: linie MOSI (Master Out Slave In), SCK (Serial Clock) oraz CS (Chip Select) skonfigurowano jako wyjścia, natomiast linię MISO (Master In Slave Out) jako wejście. W drugim kroku, poprzez modyfikację rejestru kontrolnego SPCR (SPI Control Register ), ustalono podział częstotliwości zegara systemowego (preskaler), definiując tym samym docelową przepływność magistrali, oraz wybrano odpowiedni tryb pracy SPI (tzw. SPI Mode określający polaryzację i fazę zegara, zazwyczaj Mode 0,0).

Zgodnie z rygorystycznymi normami synchronicznej komunikacji szeregowej, każdą sesję komunikacyjną (transakcję) rozpoczynało wygenerowanie opadającego zbocza i utrzymanie stanu niskiego na sprzętowej linii wyboru układu CS (zdefiniowanej w kodzie jako pin SS). Operacja ta

wybudza dedykowany układ podrzędny i przygotowuje jego wewnętrzną maszynę stanów do odbioru ramki danych. Kluczową cechą magistrali SPI, odróżniającą ją od standardu I²C, jest praca

w trybie pełnego dupleksu (ang. full-duplex ). W architekturze tej wymiana danych realizowana jest

w oparciu o ideę sprzętowych rejestrów przesuwnych. Układ nadrzędny i podrzędny jednocześnie wymieniają między sobą informacje bit po bicie wraz z każdym taktem sygnału zegarowego SCK. Ten zaawansowany mechanizm zaimplementowano w kodzie za pomocą autorskiej funkcji niskopoziomowej SPI Transfer(). Zapisanie bajtu danych do rejestru danych SPDR (SPI Data Register )

automatycznie inicjowało sprzętową transmisję – procesor sekwencyjnie ”wypychał”bity na linię MOSI, równocześnie próbkując stany z linii MISO. Po zakończeniu cyklu transmisyjnego (8 taktów zegara), funkcja zwracała zawartość rejestru odebraną z ekspandera.

Tak skonstruowana procedura posłużyła jako warstwa fizyczna dla wyższego poziomu abstrakcji, zrealizowanego w funkcji MCPS Write(). Zgodnie ze specyfikacją układu MCP23S17, nadpi-

sywanie rejestrów wymaga wysłania ściśle określonej, trzybajtowej ramki. W pierwszej kolejności nadawany jest tzw. bajt kontrolny (Opcode), zawierający m. in. sprzętowy adres urządzenia oraz bit kierunku operacji (zapis/odczyt). Następnie przesyłany jest bajt z adresem docelowego rejestru

wewnętrznego, a transakcję kończy właściwy bajt danych. Podniesienie linii CS do stanu wysokiego po wysłaniu trzeciego bajtu skutkuje ostatecznym zatrzaśnięciem danych w strukturze ekspandera. Finalnym, lecz niezwykle krytycznym z punktu widzenia niezawodności systemu etapem inicjalizacji, była początkowa konfiguracja docelowych portów urządzenia (GPIOA oraz GPIOB). Za pomocą wywołania funkcji MCPS Write() z wartością 0x00, odpowiednie rejestry kierunku (IO-DIRA, IODIRB) zostały ustawione w tryb wyjściowy. Sekwencję inicjalizacyjną kończyło wpisanie zerowych stanów logicznych (wartość szesnastkowa 0x00) bezpośrednio do rejestrów zatrzasków

portów. Działanie to stanowi kluczowe zabezpieczenie sprzętowe: zapobiega pojawieniu się stanów nieustalonych lub przypadkowych impulsów na pinie Enable (E) wyświetlacza LCD podczas fazy

rozruchu zasilania, co w skrajnych przypadkach mogłoby doprowadzić do zawieszenia się matrycy lub błędnej interpretacji rozkazów.

# Rozdział 12

# Uruchamianie modułu

# bezprzewodowego z układem CC1101

## 12.1 Środowisko pomiarowe

Zbudowane stanowisko pomiarowe zostało zaprojektowane w celu przeprowadzenia kompleksowych testów uruchomieniowych oraz weryfikacji poprawności działania opracowanych modułów transmisji bezprzewodowej. Architektura badanego systemu została fizycznie rozdzielona na dwa

niezależne od siebie węzły – nadawczy oraz odbiorczy –, które komunikują się drogą radiową z wykorzystaniem łącza pracującego w paśmie częstotliwości Sub-1 GHz. Głównym celem tak sformułowanego eksperymentu była emulacja rzeczywistego scenariusza aplikacyjnego, polegającego na bezprzewodowym przesłaniu danych sterujących do oddalonego urządzenia peryferyjnego w celu oceny stabilności i niezawodności całego układu.
Węzeł odpowiedzialny za inicjację transmisji składa się ze stacji roboczej w postaci komputera, który pełni rolę nadrzędnego źródła danych testowych, generuje ładunek użyteczny (ang. payload )

i jednocześnie zapewnia zasilanie układu. Dane te są przekazywane do pierwszej jednostki sterującej, czyli mikrokontrolera stanowiącego centralny element obliczeniowy tego segmentu, którego zadaniem jest akwizycja strumienia informacji, ich odpowiednie formatowanie oraz bezpośrednie wysterowanie układu radiowego. Za właściwą emisję sygnału odpowiada zintegrowany transceiver CC1101 skonfigurowany w trybie nadawczym, który dokonuje modulacji otrzymanego sygnału cyfrowego i przesyła go do medium bezprzewodowego.
Po stronie odbiorczej analogiczny moduł CC1101 realizuje ciągły nasłuch pasma, a po odebraniu fali radiowej dokonuje jej demodulacji i przekazuje odzyskane dane cyfrowe do drugiego mikrokontrolera zarządzającego tą częścią systemu. Jednostka ta jest połączona z osobną stacją roboczą dedykowaną do diagnostyki, monitorowania parametrów łącza oraz logowania wyników transmisji. Kluczowym elementem pośredniczącym w procesie wykonawczym jest ekspander wejść/wyjść

MCP23S17, komunikujący się za pośrednictwem szybkiego interfejsu SPI, który pozwala na zwielokrotnienie dostępnych linii GPIO (ang. General-Purpose Input/Output) mikrokontrolera. Dzięki

temu możliwe jest zapewnienie odpowiedniej liczby linii sterujących oraz danych równoległych niezbędnych do poprawnej obsługi docelowego wyświetlacza LCD, na którym wizualizowane są odebrane informacje. Zaprezentowana topologia środowiska pomiarowego pozwala na całościową ocenę niezawodności toru transmisyjnego, potwierdzając zarówno stabilność samego łącza radiowego, jak i prawidłowe funkcjonowanie sprzętowej warstwy aplikacji. Na rysunku 12.1 przedstawiono omówiony system.

103

104 | Uruchamianie modułu bezprzewodowego z układem CC1101

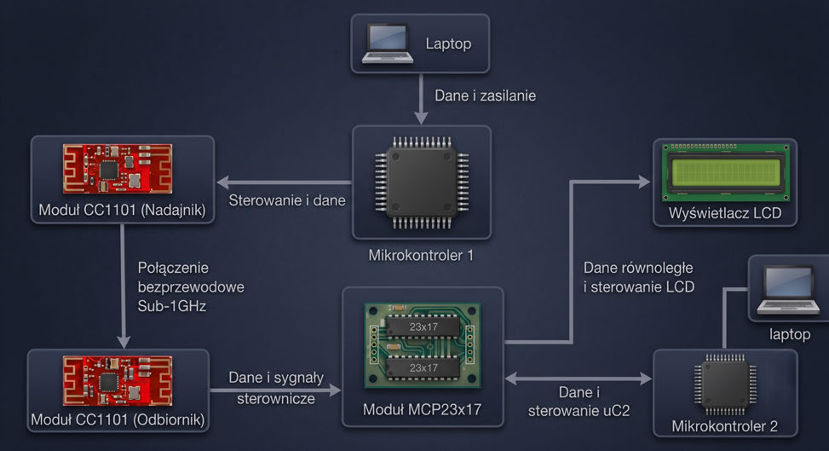
[picture p106: figure]

Rysunek 12.1: Środowisko pomiarowe

## 12.2 Kod testowy

Z punktu widzenia inżynierii oprogramowania, kod sterujący został zaprojektowany w oparciu o paradygmat programowania modularnego. Architektura projektu składała się łącznie z siedmiu

plików źródłowych i nagłówkowych, tworzących spójny system inicjalizacji oraz dwukierunkowej komunikacji pomiędzy dwoma modułami radiowymi (w topologii nadajnik-odbiornik). Strukturę

logiczną oprogramowania podzielono na cztery zintegrowane warstwy:

- Pliki nagłówkowe – zawierające definicje rejestrów i instrukcji strobujących układu CC1101.
- Warstwę abstrakcji sprzętowej (HAL) – realizującą sprzętową inicjalizację magistrali SPI oraz

dostarczającą niskopoziomowe funkcje transferu danych.

- Bibliotekę sterującą – odpowiadającą za wysterowanie transiwera radiowego, jego konfigurację

RF oraz obsługę pakietów.

- Program główny (main) – integrujący wszystkie moduły i realizujący docelową logikę aplika-

cji.

Zgodnie z dokumentacją techniczną producenta, układ CC1101 charakteryzuje się bardzo wysokim stopniem konfigurowalności. Jego wewnętrzna maszyna stanów kontrolowana jest za pośrednictwem 62 rejestrów konfiguracyjnych oraz 17 unikalnych sygnałów sterujących, zwanych instrukcjami strobującymi (ang. Command Strobes). W przeciwieństwie do klasycznych operacji zapisu

i odczytu, impulsy strobujące to specjalne, jednobajtowe komendy przesyłane za pomocą magistrali SPI, które nie przenoszą dodatkowego ładunku danych (payload). Ich wysłanie natychmiastowo wyzwala odpowiednie przejście w maszynie stanów układu (np. wejście w tryb nasłuchu, uruchomienie kalibracji syntezatora częstotliwości czy przejście w stan uśpienia).

12.2. Kod testowy | 105

Fundamentalnym aspektem implementacji procedur SPI było właściwe sformatowanie bajtu nagłówkowego (adresowego) wysyłanego do transiwera na początku każdej transakcji. Protokół ko-

munikacyjny układu CC1101 przewiduje cztery typy operacji, definiowane za pomocą dwóch najstarszych bitów wysyłanego bajtu: bit odczytu/zapisu (R/W) oraz bit trybu dostępu (pojedynczy – Single Access, lub ciągły – Burst Access).

Poprawne zarządzanie flagą trybu ciągłego okazało się krytyczne ze względu na specyficzną architekturę mapy pamięci urządzenia. W przestrzeni adresowej od 0x30 do 0x3F występuje fizyczne nakładanie się adresów (konflikt adresowy) pomiędzy instrukcjami strobującymi a rejestrami statu-

sowymi układu. Producent rozwiązał ten problem sprzętowo, dokonując multipleksowania dostępu w oparciu o wspomniany typ wymiany danych. Próba zapisu lub odczytu z adresów w tym przedziale w trybie pojedynczym (Single Access) jest automatycznie interpretowana przez mikrokon-

troler transiwera jako wywołanie instrukcji strobującej. Z kolei wywołanie operacji odczytu z tej samej puli adresowej, lecz z ustawionym bitem trybu ciągłego (Burst Access), pozwala na swobodny

odczyt użytecznych rejestrów statusowych. W ten sposób zaimplementowano dostęp do kluczowych informacji diagnostycznych, takich jak wbudowany numer seryjny, wersja układu, a także bieżące parametry łącza radiowego (wskaźnik siły sygnału odbitego RSSI oraz wskaźnik jakości połączenia LQI).

Zastosowanie tego mechanizmu przez producenta znacząco optymalizuje mapę pamięci i minimalizuje czas transmisji po magistrali SPI, jednakże wymagało precyzyjnej i rygorystycznej implementacji po stronie mikrokontrolera nadrzędnego. Szczegółowe definicje makr preprocesora, odwzorowujące kompletną mapę adresową rejestrów konfiguracyjnych, rejestrów statusowych oraz instrukcji strobujących, zaprezentowano na rysunku 12.2.

106 | Uruchamianie modułu bezprzewodowego z układem CC1101

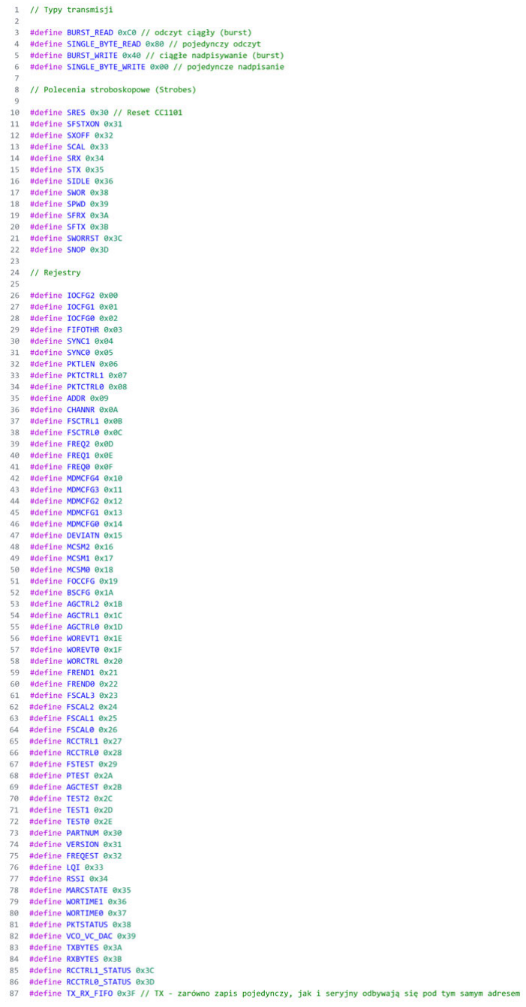
[picture p107: figure]

Rysunek 12.2: Mapa rejestrów i impulsów sterowniczych CC1101

12.2. Kod testowy | 107

Po zdefiniowaniu mapy rejestrów i instrukcji strobujących, prace programistyczne skupiły się na implementacji warstwy abstrakcji sprzętowej (ang. Hardware Abstraction Layer – HAL). War-

stwa ta jest bezpośrednio odpowiedzialna za sprzętową inicjalizację interfejsu SPI w mikrokontrolerze nadrzędnym oraz rygorystyczną realizację niskopoziomowych procedur nadawczo-odbiorczych. Ponieważ jako jednostkę centralną (Master) wykorzystano mikrokontroler ESP32, kod źródłowy

zrealizowano w oparciu o zaawansowane API środowiska programistycznego ESP-IDF.
Kod programu rozpoczęto od zdefiniowania portów wejścia/wyjścia oraz utworzenia dedykowanej struktury danych cc1101 dev t. Struktura ta pełni funkcję wirtualnego odniesienia (uchwytu – ang. device handle) do fizycznego modułu radiowego. Przechowuje ona wskaźnik do przydzielonego urządzenia na magistrali SPI (spi device handle t) oraz przypisany mu numer pinu wyboru układu

CS. Takie modularne podejście znacząco zwiększa skalowalność kodu, pozwalając na jednoczesną, bezkolizyjną i przejrzystą obsługę wielu niezależnych modułów antenowych podłączonych do tej samej szyny sprzętowej mikrokontrolera.
Inicjalizacja magistrali SPI opierała się na konfiguracji dwóch kluczowych struktur środowiska ESP-IDF: spi bus config t oraz spi device interface config t. W pierwszej z nich zmapowano fizyczne wyprowadzenia mikrokontrolera dla linii sygnałowych MOSI, MISO oraz SCLK. W drugiej strukturze zdefiniowano krytyczne parametry transmisyjne. Zegar magistrali ustawiono na częstotliwość 500 kHz, a protokół skonfigurowano do pracy w trybie zerowym (SPI Mode 0), wymaganym

przez układ CC1101.
Warto zwrócić szczególną uwagę na sposób zarządzania linią wyboru układu. W konfiguracji urządzenia zrezygnowano z wbudowanego, sprzętowego sterowania pinem CS (przypisując parametrowi spics io num wartość -1). Decyzja o implementacji ręcznego (programowego) sterowania

tym pinem za pomocą standardowych funkcji biblioteki GPIO podyktowana była rygorystycznymi wymogami czasowymi transiwera. Sprzętowy sterownik SPI w układzie ESP32 mógłby wprowadzać niepożądane stany logiczne pomiędzy kolejnymi bajtami podczas transakcji wielobajtowych. Pełna kontrola programowa gwarantuje nienaruszoną integralność ramki danych. Ponadto, w konfiguracji określono rozmiar kolejki transakcji na 7 elementów, co optymalizuje pracę sprzętowego bufora FIFO i zwiększa ogólną wydajność komunikacji.
Na tak przygotowanym fundamencie fizycznym zbudowano funkcje narzędziowe obsługujące wymianę danych z docelowymi rejestrami i strobami (takie jak cc1101 read reg oraz cc1101 write reg).

Korzystają one z wbudowanej struktury spi transaction t, do której przekazywane są wskaźniki na bufory nadawcze i odbiorcze oraz określana jest długość przesyłanej wiadomości.
Każda operacja zapisu i odczytu została precyzyjnie zsynchronizowana. Proces rozpoczyna się od programowego wygenerowania stanu niskiego na linii CS wybranego modułu. Następnie, wykorzystując zdefiniowane wcześniej maski bitowe (np. CC1101 READ SINGLE), formowany jest bajt

nagłówkowy, zawierający docelowy adres rejestru połączony z bitami kierunku oraz trybu operacji. Po synchronicznym przesłaniu danych za pomocą funkcji spi device transmit(), cykl kończy się przywróceniem linii CS do stanu wysokiego. Napisane w ten sposób funkcje wejścia/wyjścia umoż-

liwiły bezpieczną enkapsulację operacji sprzętowych, tworząc stabilną bazę pod warstwę aplikacji odpowiedzialną za ostateczne wysterowanie parametrów RF układu CC1101.

108 | Uruchamianie modułu bezprzewodowego z układem CC1101

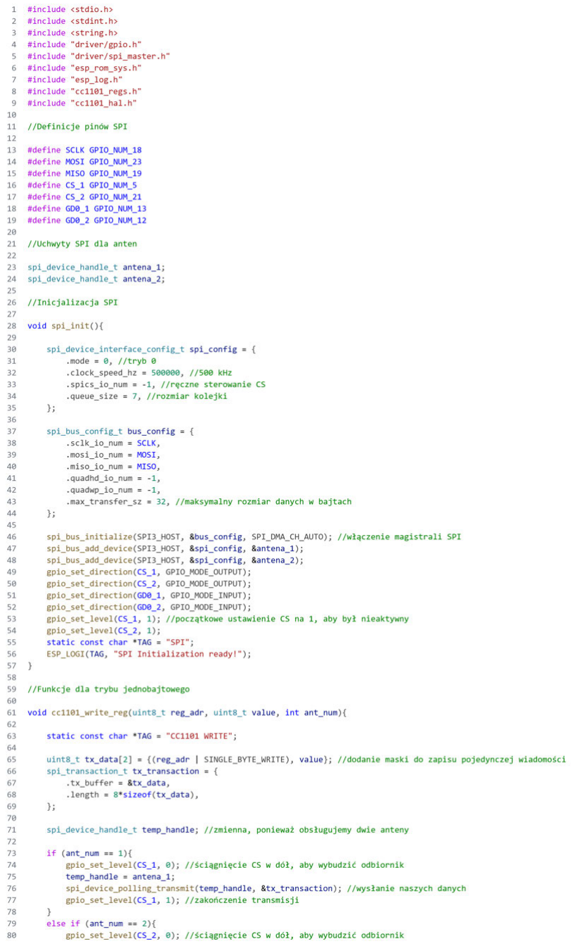
[picture p108: figure]

Rysunek 12.3: Program warstwy fizycznej. Część I

12.2. Kod testowy | 109

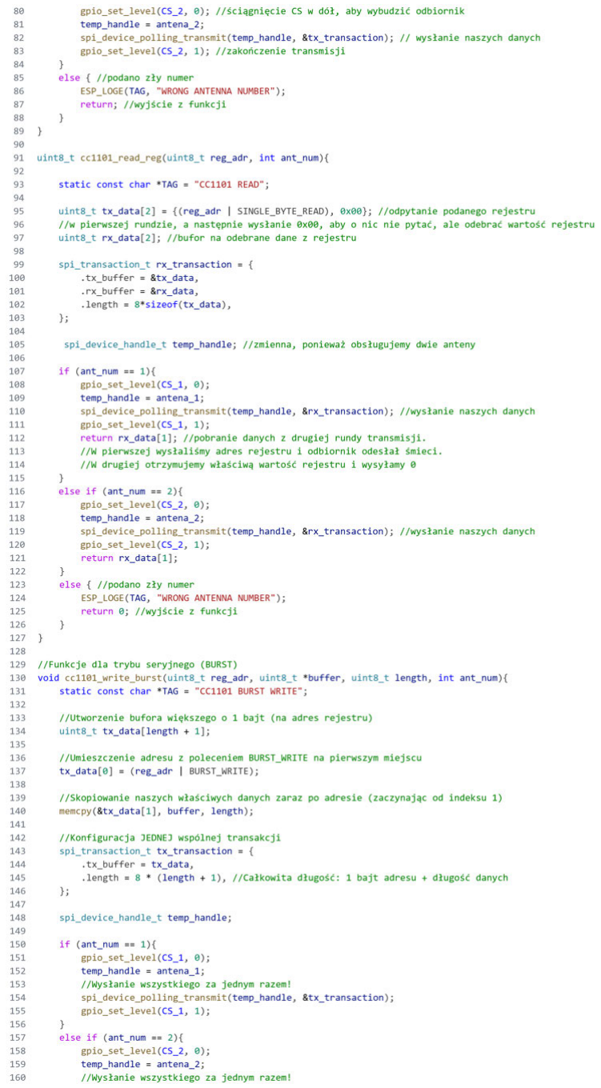
[picture p109: figure]

Rysunek 12.4: Program warstwy fizycznej. Część II

110 | Uruchamianie modułu bezprzewodowego z układem CC1101

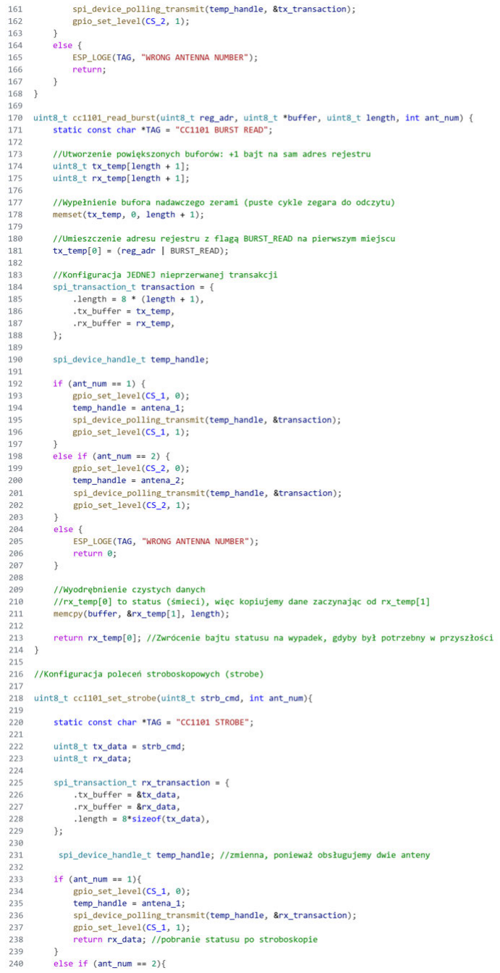
[picture p110: figure]

Rysunek 12.5: Program warstwy fizycznej. Część III

12.2. Kod testowy | 111

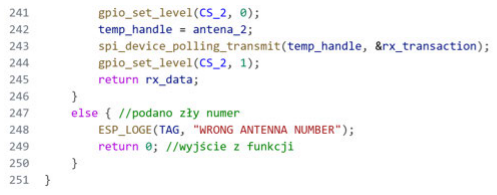
[picture p111: figure]

Rysunek 12.6: Program warstwy fizycznej. Część IV

Wdrożenie warstwy abstrakcji sprzętowej (HAL) pozwoliło na sprawną implementację warstwy

aplikacji, zoptymalizowanej pod kątem minimalizacji narzutu obliczeniowego układu ESP32 oraz maksymalizacji niezawodności łącza. Podstawą rygorystycznej konfiguracji transiwera CC1101 była tablica struktur cfg regiser, przechowująca docelowe adresy rejestrów i ich zadaną wartość. Parametry te wygenerowano za pomocą narzędzia SmartRF Studio, co wyeliminowało ryzyko błędów przy ręcznym przeliczaniu nastaw toru RF.
Proces rozruchu, zrealizowany w funkcji cc1101 init(), rozpoczynał się od sprzętowo-programowego resetu (cc1101 power on reset()). Wykorzystano tu strob SRES połączony z mechanizmem aktywnego oczekiwania (ang. polling). Mikrokontroler odpytywał układ instrukcją SNOP, badając siódmy bit statusowy (maska 0b10000000). Jego wyzerowanie potwier-

dzało osiągnięcie stanu IDLE. Następnie weryfikowano szynę SPI poprzez odczyt rejestru VERSION i iteracyjnie przesyłano zawartość matrycy konfiguracyjnej. Dla optymalizacji energetycznej zaimplementowano funkcję wybudzania cc1101 wake up(), a także ustalono sprzętowe wzmocnienie toru

nadawczego na poziomie +10 dBm.
Procedurę nadawczą (cc1101 send packet()) zoptymalizowano pod kątem szybkości. Przed każdą

transmisją bufor TX FIFO czyszczono strobem SFTX. Ramkę transferowano w trybie ciągłym (BURST), a emisję wyzwalano natychmiastowym strobem STX. Z kolei mechanizm odbiorczy (cc1101 receive packet()) po aktywacji nasłuchu (SRX) oczekiwał na przerwanie z pinu GDO. Pro-

gram pobierał bajt długości z bufora RX FIFO; jeśli przekraczał on bezpieczną granicę 63 bajtów, pakiet odrzucano, a kolejkę czyszczono strobem SFRX.
W celu podniesienia niezawodności wykorzystano sprzętową funkcję dołączania dwóch bajtów diagnostycznych na końcu odebranego pakietu: RSSI (ang. Received Signal Strength Indicator )

oraz LQI. W bajcie LQI producent zaimplementował sprzętową flagę poprawności sumy kontrolnej (CRC). W kodzie zastosowano filtr binarny weryfikujący ten warunek: (status buffer[1] & 0x80)

!= 128. Jego niespełnienie oznaczało przekłamanie danych – uszkodzony pakiet był definitywnie odrzucany, błąd logowano makrem ESP LOGW, a bufor sprzętowy czyszczono przed przyjęciem kolejnej transmisji.

112 | Uruchamianie modułu bezprzewodowego z układem CC1101

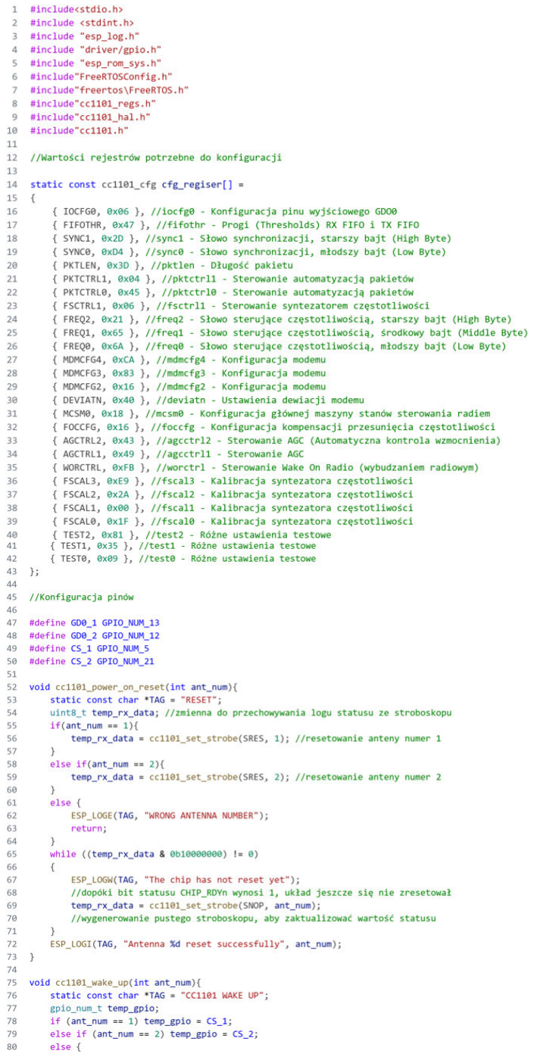
[picture p112: figure]

Rysunek 12.7: Program warstwy funkcjonalnej. Część I

12.2. Kod testowy | 113

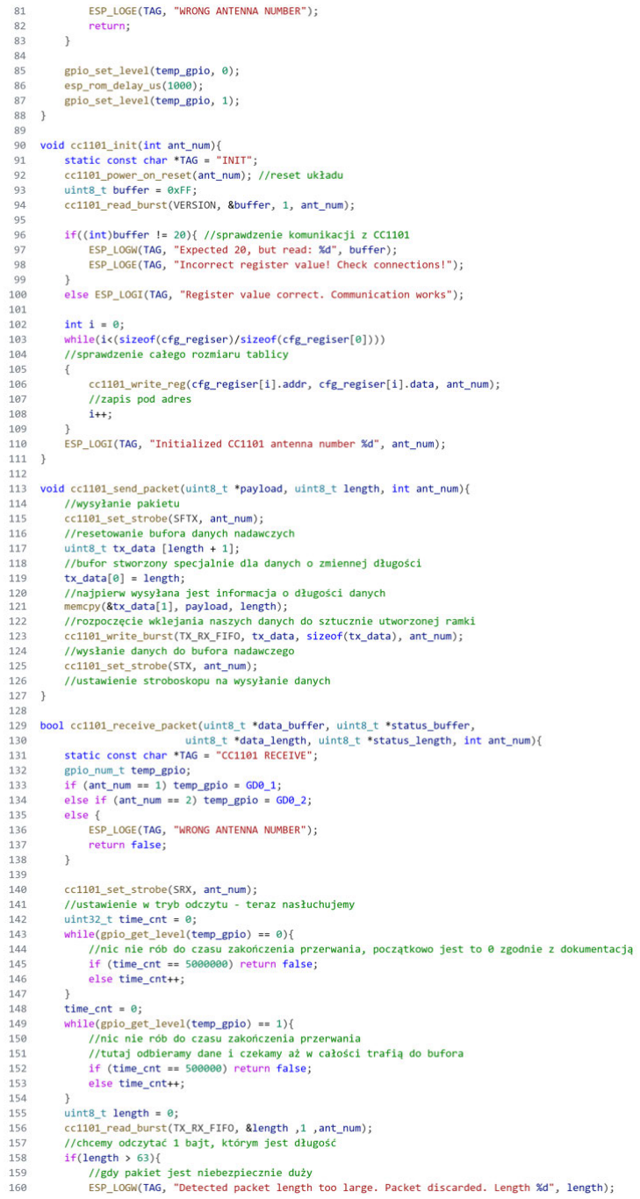
[picture p113: figure]

Rysunek 12.8: Program warstwy funkcjonalnej. Część II

114 | Uruchamianie modułu bezprzewodowego z układem CC1101

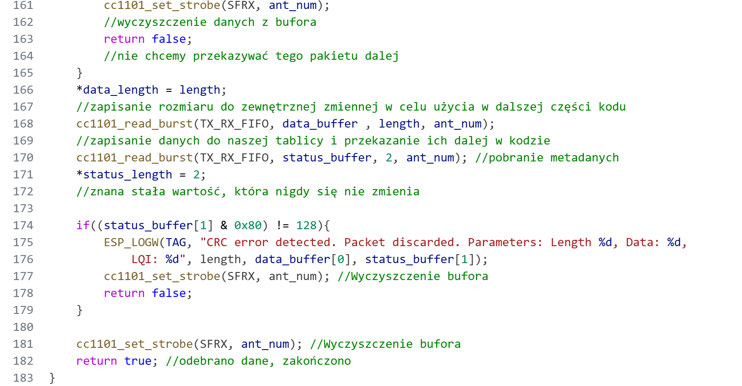
[picture p114: figure]

Rysunek 12.9: Program warstwy funkcjonalnej. Część III

Finalną częścią kodu był program główny, zrealizowany z uwzględnieniem architektury i wymagań mikrokontrolera ESP32. W celu zapewnienia determinizmu czasowego oraz optymalnego wykorzystania zasobów sprzętowych, oprogramowanie zostało oparte na systemie operacyjnym czasu rzeczywistego FreeRTOS. Zastosowanie tego rozwiązania pozwoliło na implementację współbieżności, dzieląc logikę aplikacji na niezależne wątki robocze (zadania). Kod główny stanowił zwieńczenie

wszystkich funkcji konfiguracyjnych i sterujących napisanych w we wcześniejszych etapach prac. Punktem wejścia programu jest funkcja app main(), która w pierwszej kolejności odpowiada za konfigurację sprzętową. Inicjalizowana jest magistrala SPI (spi init()), zapewniająca szybką i nie-

zawodną wymianę danych, a następnie przeprowadzana jest konfiguracja samego układu radiowego CC1101 (cc1101 init()). Po przygotowaniu peryferiów, kontrolę nad wykonywaniem programu przejmuje planista (ang. scheduler ) FreeRTOS, który zarządza utworzonymi zadaniami transmisyjnymi

i odbiorczymi. Każdemu z zadań przydzielono niezależny stos pamięci o rozmiarze 2048 bajtów oraz odpowiedni priorytet, co gwarantuje bezkolizyjną pracę modułów.
Zadanie nadawcze (CC1101 send task) odpowiada za cykliczne formowanie i wysyłanie pakietów

danych. Szczególną uwagę zwrócono na optymalizację bilansu energetycznego urządzenia. Mikrokontroler tuż przed rozpoczęciem nadawania wybudza układ radiowy, transmituje przygotowany bufor danych, po czym niezwłocznie wprowadza transceiver z powrotem w stan głębokiego uśpienia (ang. Power Down) przy pomocy stroboskopu SPWD. Takie zarządzanie zasilaniem drastycznie

redukuje pobór prądu w oknach czasowych pomiędzy kolejnymi transmisjami.
Z kolei zadanie odbiorcze (CC1101 receive task) realizuje nasłuchiwanie oraz ekstrakcję przy-

chodzących danych. W przypadku detekcji poprawnego pakietu, algorytm kopiuje zawartość użyteczną oraz pobiera metadane z bufora statusu. Istotnym elementem analizy sygnału zaimplementowanym w tym wątku jest programowe przeliczanie surowej wartości parametru RSSI (ang. Received Signal Strength Indicator ) na fizyczne jednostki dBm, z uwzględnieniem zdefiniowanego przesunięcia sprzętowego (tzw. offsetu). Ponadto funkcja odczytuje wskaźnik jakości łącza (LQI). Rejestracja

tych parametrów w czasie rzeczywistym pozwala na bieżącą diagnostykę, kalibrację oraz ocenę stabilności zaprojektowanego toru radiowego.

12.2. Kod testowy | 115

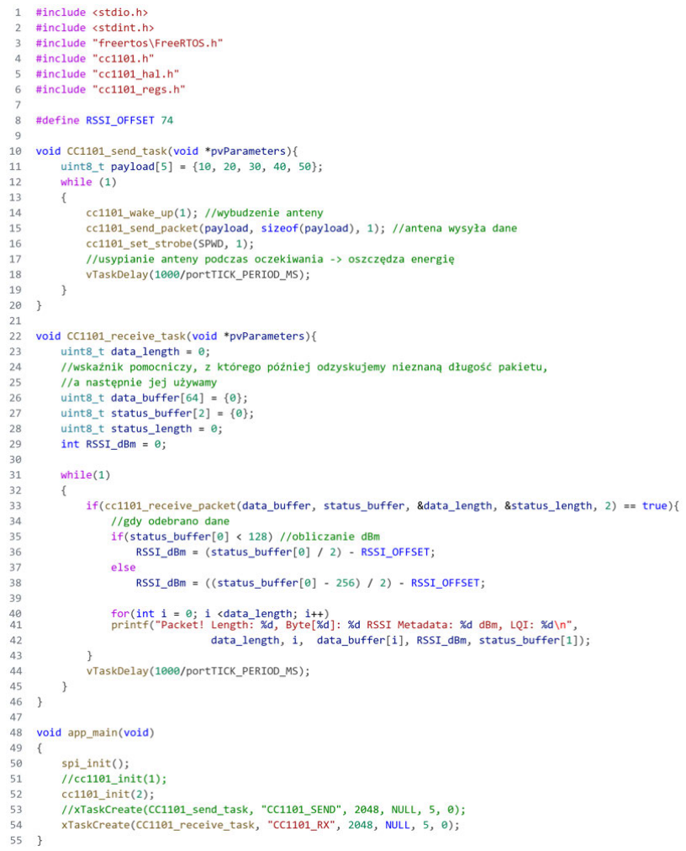
[picture p115: figure]

Rysunek 12.10: Program główny

# Rozdział 13

# Badania parametrów podsystemu z

# modułem LCD

## 13.1 Analiza porównawcza opóźnień programowych i

## charakterystyk dynamicznych wyświetlaczy LCD

Kluczowym elementem determinującym stabilność pracy alfanumerycznych modułów LCD opartych na sterowniku HD44780U jest bezwzględne zachowanie reżimu czasowego narzucanego przez producenta. Weryfikacja charakterystyk dynamicznych układu wymaga dogłębnej analizy zaimplementowanych opóźnień programowych oraz zestawienie ich z ograniczeniami sprzętowymi, takimi jak czasy propagacji sygnałów w ekspanderach I/O oraz czasy przetwarzania instrukcji przez układ sterownika wyświetlacza ciekłokrystalicznego [6].

Fundamentalnym sygnałem warunkującym poprawny odczyt danych przez kontroler wyświetlacza jest wygenerowanie prawidłowego impulsu na linii E ang. Enable). Zgodnie z notą katalogową

układu HD44780U, minimalny czas trwania stanu wysokiego na tej linii wynosi 450 ns dla zasilania napięciem 5 V . We wszystkich opracowanych programach testowych sterujących wyświetlaczem, zarówno w transmisji równoległej, jak i szeregowej zaimplementowano funkcję lcd enable(), która

wymusza stan wysoki na linii E, oczekuje 1 µs, a następnie wraca do stanu niskiego. Zastosowanie takiego opóźnienia daje ponad dwukrotny, bezpieczny margines błędu. Rozwiązanie to całkowicie eliminuje ryzyko zignorowania komendy przez układ na skutek pasożytniczych pojemności ścieżek sygnałowych. Przy pomocy oscyloskopu cyfrowego zweryfikowano rzeczywisty czas omówionego opóźnienia. Pomiar z użyciem makr wyniósł 1.1 µs.
Podczas pomiarów zaobserwowano znaczący wpływ zjawiska dzwonienia (ang. ringing) na wy-

znaczane automatycznie wartości napięcia międzyszczytowego Vpp. Algorytm pomiarowy użytego oscyloskopu FNIRSI-1014D wyznaczał tę wartość jako bezwzględną różnicę pomiędzy absolutnym maksimum a minimum dla całej przechwyconej ramki sygnału, przez co włączał do wyniku krótkotrwałe przerzuty napięcia (ang. overshoot oraz undershoot). Zjawisko to było potęgowane przez spe-

cyfikę prototypowego środowiska testowego oraz nieidealność samego układu pomiarowego. Wykorzystanie uniwersalnej płytki stykowej oraz standardowych przewodów połączeniowych wprowadziło do badanego obwodu rozproszone pojemności oraz indukcyjności pasożytnicze. Dodatkowo, pojemność wejściowa pasywnej sondy w połączeniu z indukcyjnością standardowego przewodu masy (tzw. krokodylka) stworzyła obwód rezonansowy RLC. Przy sygnałach cyfrowych o stromych zbo-

czach prowadzi to do powstawania oscylacji tłumionych, zniekształcających rzeczywisty kształt

117

118 | Badania parametrów podsystemu z modułem LCD

przebiegu. Należy jednak zaznaczyć, że głównym celem przeprowadzonych pomiarów było wyznaczenie opóźnienia sygnału, a nie analiza jego precyzyjnych poziomów napięciowych. Z tego względu automatyczne wskazania Vpp dla całej ramki potraktowano wyłącznie poglądowo. Właściwa analiza opóźnień została przeprowadzona w sposób manualny, z wykorzystaniem kursorów oscyloskopu, co pozwoliło całkowicie uniezależnić uzyskane wyniki czasowe od zarejestrowanego zjawiska dzwonienia.

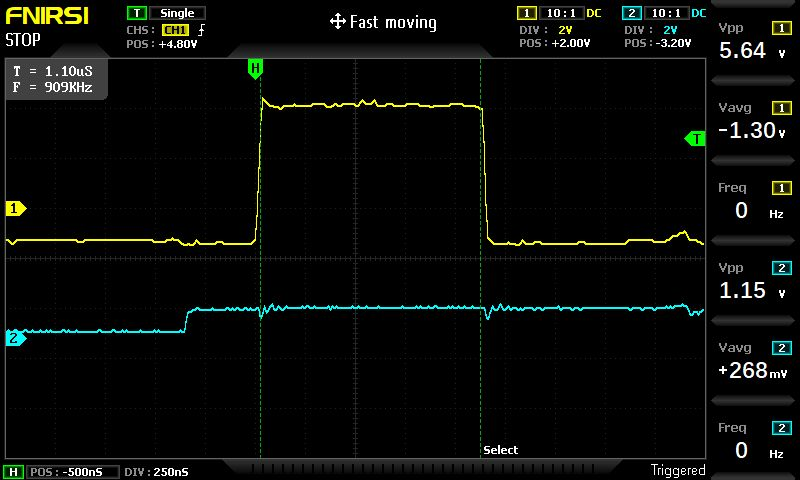
[picture p116: figure]

Rysunek 13.1: Pomiar opóźnienia stanu wysokiego sygnału enable

Kolejnym krytycznym elementem jest czas niezbędny na przetworzenie instrukcji przez wewnętrzny układ sterujący matrycą LCD. Standardowe komendy, takie jak wpisanie znaku do pamięci DDRAM czy przesunięcie kursora, wymagają nominalnie około 37 µs do 43 µs. W kodach źródłowych na końcu funkcji wysyłającej dane lcd send() zastosowano opóźnienie blokujące o war-

tości 50 µs. Jest to wartość optymalna, gwarantująca ukończenie operacji przed nałożeniem kolejnego rozkazu. Wyjątek stanowią instrukcje czyszczenia ekranu ang. Clear Display oraz powrotu na początek linii ang. Return Home, których czas oscyluje w granicach 1,52 ms. W procesie inicjalizacji oraz przy specyficznych poleceniach zaimplementowano wyższe wartości opóźnień, rzędu 2 ms oraz sekwencje 40 ms, 5 ms i 1 ms w początkowej fazie wybudzania układu, zgodnie z wymogami oczekiwania na stabilizację napięcia zasilania VCC wyższego niż 4,5 V [11].

13.1. Analiza porównawcza opóźnień programowych i charakterystyk dynamicznych wyświetlaczy LCD 119

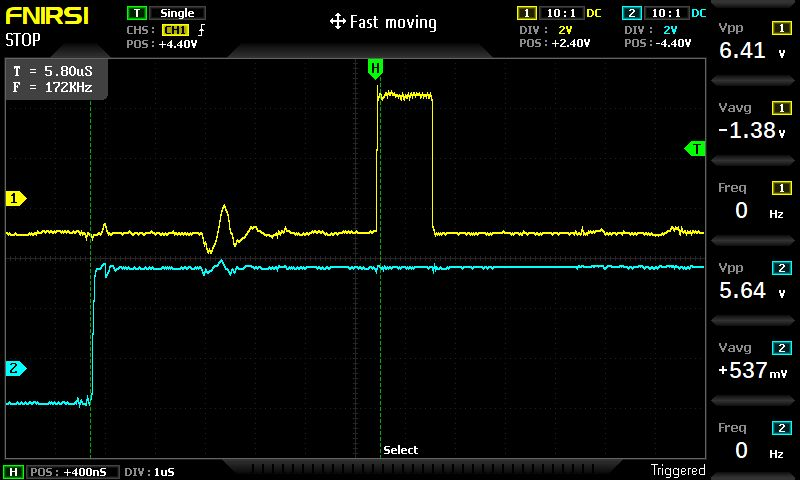
[picture p117: figure]

Rysunek 13.2: Okres stabilizacji danych przed sygnałem Enable

Istotne wnioski płyną z porównania konfiguracji równoległej z układami wykorzystującymi serializację danych. W przypadku sterowania bezpośredniego¹
, czas jest determinowany wyłącznie częstotliwością taktowania mikrokontrolera (16 MHz) i jest pomijanie mały. O całkowitym czasie

transakcji decyduje wprost opóźnienie 50 us. W konfiguracji hybrydowej, gdzie dane są przesyłane szeregowo, a sygnały sterujące równolegle wprost z wyjść mikrokontrolera, sytuacja ulega zmianie z powodu charakterystyki dynamicznej ekspanderów wejść/wyjść. Magistrala I²C taktowana stan-

dardowym zegarem o częstotliwości 100 kHz potrzebuje około 180 µs na przesłanie ramki (uwzględniając adres, dane i bit ACK).Wynika z tego, że samo opóźnienie sprzętowe wynikające z przesyłu

danych do układu PCF8574 znacząco przekracza czas przetworzenia rozkazu przez wyświetlacz LCD (37 µs). Pomiary oscyloskopem przeprowadzone na rzeczywistym układzie (rys. 13.3), wykazały, że częstotliwość linii SCL oscyluje w granicach 96-99 kHz. Protokół I²C wymusza przesłanie

minimum dwóch bajtów, w każdej transakcji zapisu (adres oraz właściwy bajt danych). Jak wy-

nika z zarejestrowanych przebiegów, pełny cykl przesłania danych zajmuje w rzeczywistości 200 µs (rys. 13.4). Oznacza to, że sam narzut czasowy wynikający z protokołu komunikacyjnego ponad

pięciokrotnie przekracza czas przetworzenia instrukcji przez wyświetlacz, stanowiąc głównie wąskie gardło tej metody sterowania.

1
8 bądź 4-bitowego poprzez porty mikrokontrolera ATMega 328p

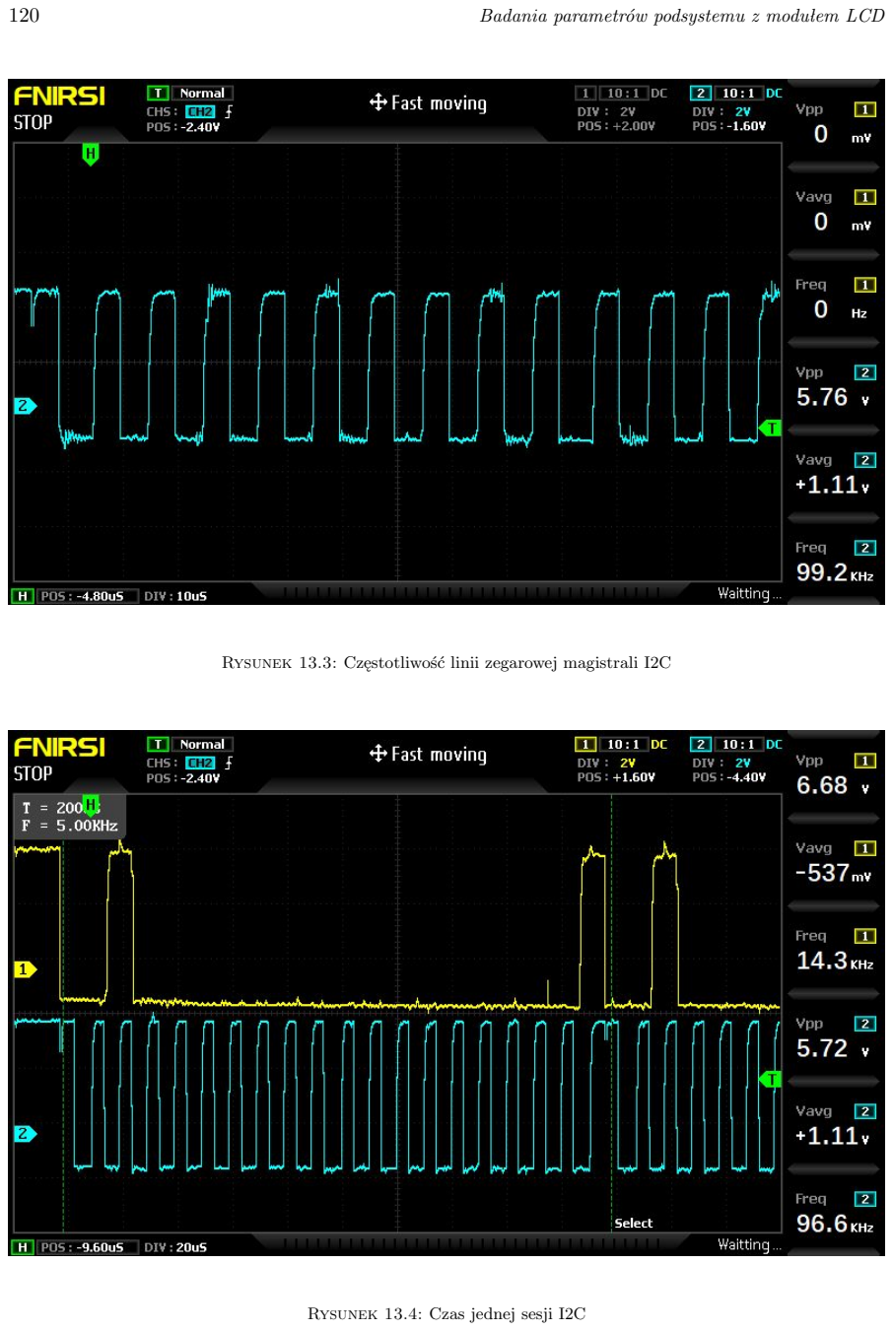
[picture p118: page 120]

120 | Badania parametrów podsystemu z modułem LCD

Rysunek 13.3: Częstotliwość linii zegarowej magistrali I2C

Rysunek 13.4: Czas jednej sesji I2C

13.1. Analiza porównawcza opóźnień programowych i charakterystyk dynamicznych wyświetlaczy LCD 121

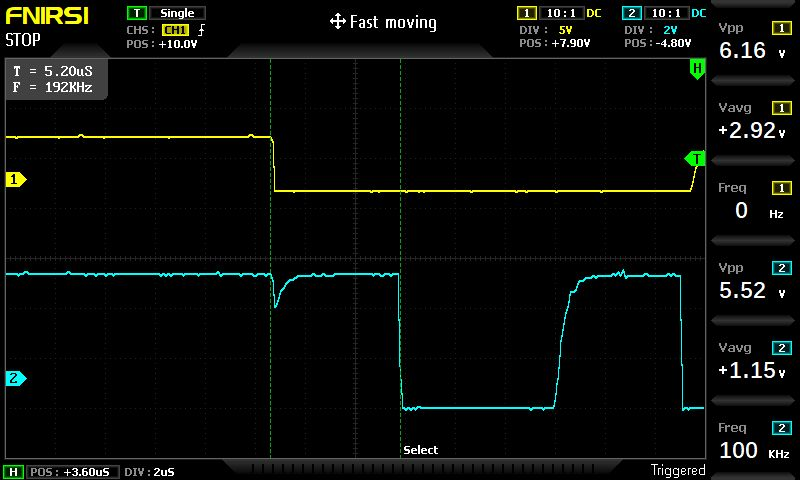
[picture p119: figure]

Rysunek 13.5: Wyznaczenie czasu od sygnału START do faktycznej transmisji

W implementacji z ekspanderami I/O programowe funkcje blokujące przez 50 µs stają się teo-

retycznie nadmiarowe, ponieważ sam fizyczny czas transmisji instrukcji po magistrali gwarantuje, że sterownik HD44780U zdążył przetworzyć poprzednią operację. Niemniej jednak pozostawienie tych opóźnień w strukturze hybrydowej jest uzasadnioną praktyką, gwarantującą niezawodność przy migracjach na szybsze magistrale, gdzie przepływność sprzętowa przestaje maskować wymogi czasowe matrycy. Za pomocą oscyloskopu zweryfikowano parametry sygnałów linii I²C.
W przypadku interfejsu SPI, cechującego się wyższą przepustowością niż I²C, częstotliwość

taktowania magistrali ustalono na 8 MHz. Poprawność tej konfiguracji została zweryfikowana pomiarem na rzeczywistym układzie, jak przedstawiono na przebiegu z oscyloskopu (rys. 13.6),

gdzie rzeczywista częstotliwość linii SCK wynosi około 8,05 MHz. Zgodnie ze specyfikacją układu MCP23S17, pojedyncza instrukcja zapisu wymaga przesłania trzech bajtów (kod operacji, adres rejestru oraz dane). Analiza zarejestrowanego przebiegu sprzętowej transmisji danych przedstawio-

nych na rysunku 13.7 wykazuje, że sekwencyjne nadanie paczki czterech bajtów zajmuje zaledwie 8,62 µs. Dowodzi to, że sprzętowy czas wysyłania pojedynczej instrukcji wraz z niezbędnym narzutem programowym mikrokontrolera (obsługa pętli wysyłającej) wynosi optymalnie około 4-5

µs. Niemniej jednak, na potrzeby zapewnienia stabilnej komunikacji z wolniejszym sterownikiem wyświetlacza LCD, procedura zapisu została celowo spowolniona przez warstwę programową. Wprowadzenie dodatkowego opóźnienia o wartości 1 ms powoduje, że pojedyncza transakcja zapisu na magistrali wydłuża się do ponad 2 ms. Zestawienie dowodów z oscyloskopu (rys. 13.6 rys. 13.7)

z ostatecznym czasem wykonania procedury jednoznacznie udowadnia, że sama warstwa sprzętowa SPI działa z maksymalną, zakładaną wydajnością i bez opóźnień między bitami. W tej specyficznej konfiguracji wąskie gardło systemu zostało sztucznie przesunięte z protokołu komunikacyjnego na oprogramowanie, w celu dostosowania się do ograniczeń czasowych elementu końcowego.

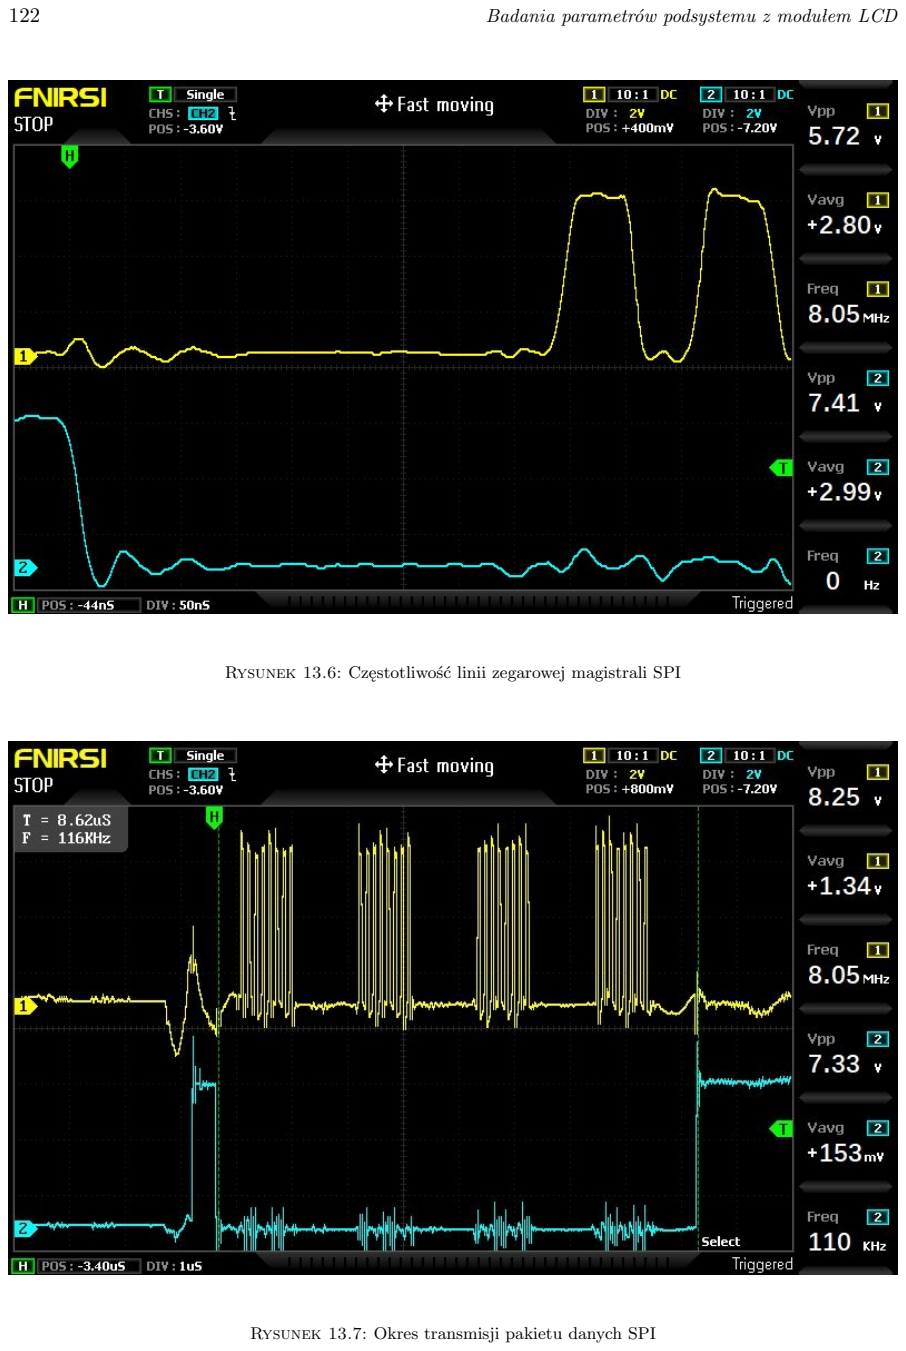
[picture p120: page 122]

122 | Badania parametrów podsystemu z modułem LCD

Rysunek 13.6: Częstotliwość linii zegarowej magistrali SPI

Rysunek 13.7: Okres transmisji pakietu danych SPI

13.2. Badania poprawności transmisji przewodowej w systemie rozproszonym | 123

## 13.2 Badania poprawności transmisji przewodowej w systemie

## rozproszonym

Prace związane ze stabilnością komunikacji zaprowadziły nas do pytania, jaka kombinacja długości łącza i częstotliwości transmisji była optymalna. Poddano badaniom użyte wcześniej interfejsy I

2C oraz SPI, korzystając z ekspanderów serii MCP23x17. W pracach badawczych zastosowano dwa

mikrokontorolery, rezydujące w Arduino Uno oraz ESP32. W przypadku, gdy wykorzystano układ firmy Microchip tabela ma dopisek ”dla napięcia 5 V”. Jest to związane z poziomem logicznym wystawianym przez mikrokontroler. Dla ESP32 w tytułach tabel dopisano ”dla napięcia 3,3 V”. Pomiary wykonano dla kilku długości przewodów transmisyjnych: 1 m, 3 m, 5 m, 7 m i 10 m. Zależnie od badanej magistrali zmieniano częstotliwość taktowania zegara. Dla interfejsu I²C korzystano

z częstotliwości od 100 kHz do 1,1 MHz z krokiem 100 kHz. Zgodnie z dokumentacją techniczną ekspandera MCP23017 jego maksymalna częstotliwość transmisji wynosiła 1 MHz.

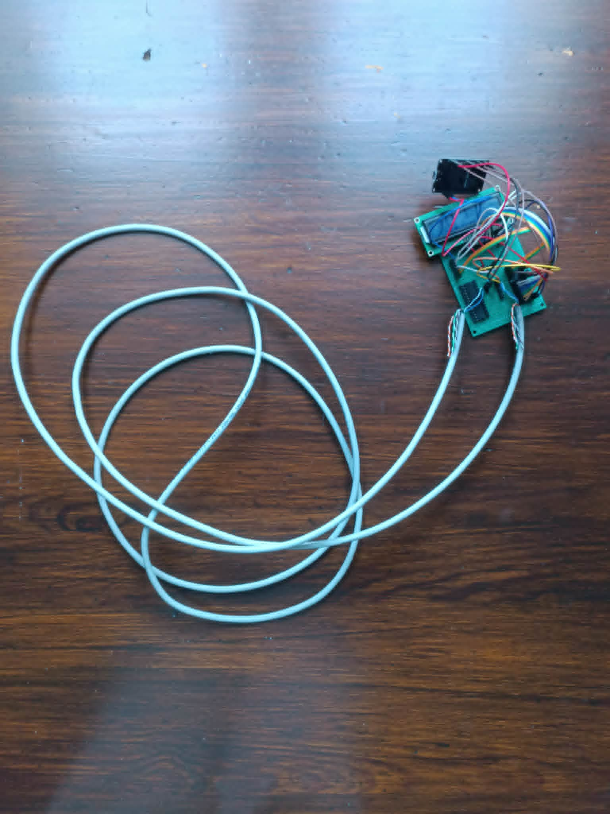
[picture p121: figure]

Rysunek 13.8: Testy na magistrali I²C dla przewodów 3 metrowych

124 | Badania parametrów podsystemu z modułem LCD

Tabela 13.1: Wyniki pomiarów z wykorzystaniem modułu ESP32 dla transmisji I

2C przy napięciu zasilania 3,3 V oraz rezystora 1 kΩ. Część I

Długość / Częstotliwość | 100 kHz | 200 kHz | 300 kHz | 400 kHz | 500 kHz | 600 kHz
1,0 m | + | + | + | + | + | +
3,0 m | + | + | + | + | + | +
5,0 m | + | +/- | – | – | – | –
7,0 m | + | + | – | – | – | –
10,0 m | + | + | – | – | – | –

Tabela 13.2: Wyniki pomiarów z wykorzystaniem modułu ESP32 dla transmisji I

2C przy napięciu zasilania 3,3 V oraz rezystora 1 kΩ. Część II

Długość / Częstotliwość | 700 kHz | 800 kHz | 900 kHz | 1000 kHz | 1100 kHz
1,0 m | + | + | + | +/- | -
3,0 m | + | + | + | +/- | –
5,0 m | – | – | – | – | –
7,0 m | – | – | – | – | –
10,0 m | – | – | – | – | –

Tabela 13.3: Wyniki pomiarów z wykorzystaniem modułu Arduino Uno dla transmisji I²C przy napięciu zasilania 5 V oraz rezystora 1 kΩ. Część I

Długość / Częstotliwość | 100 kHz | 200 kHz | 300 kHz | 400 kHz | 500 kHz
1,0 m | + | + | + | + | +
3,0 m | + | + | + | + | +
5,0 m | + | + | + | + | +
7,0 m | + | + | – | – | –
10,0 m | + | + | – | – | –

Tabela 13.4: Wyniki pomiarów z wykorzystaniem modułu Arduino Uno dla transmisji I²C przy napięciu zasilania 5 V oraz rezystora 1 kΩ. Część II

Długość / Częstotliwość | 600 kHz | 700 kHz | 800 kHz | 900 kHz | 1000 kHz
1,0 m | + | + | + | – | –
3,0 m | + | + | + | – | –
5,0 m | + | + | + | – | –
7,0 m | – | – | – | – | –
10,0 m | – | – | – | – | –

Na podstawie wyników (Tabele 13.1–13.4) przeanalizowano wpływ napięcia logicznego i długości linii na stabilność magistrali I²C (przy rezystorach 1 kΩ). Pomiary wykazały, że układ ESP32 (3,3

V) osiąga najwyższą przepływność (do 900 kHz) na krótkich odcinkach (1–3 m). Jednak ze względu

na niższe napięcie stanu wysokiego jest podatny na pojemność pasożytniczą przewodów, co przy 5–10 m wymusza redukcję prędkości do 100–200 kHz.
Z kolei platforma Arduino Uno (5 V), mimo nieco niższej maksymalnej częstotliwości (800 kHz), wykazuje znacznie większą odporność na degradację sygnału, utrzymując tę prędkość aż do 5 metrów. Dla najdłuższych linii (7–10 m) fizyka transmisji ogranicza oba układy do pasma 100–200

kHz. Podsumowując: standard 3,3 V jest optymalny dla szybkich, scentralizowanych połączeń, natomiast 5 V gwarantuje niezawodną komunikację na większych dystansach.

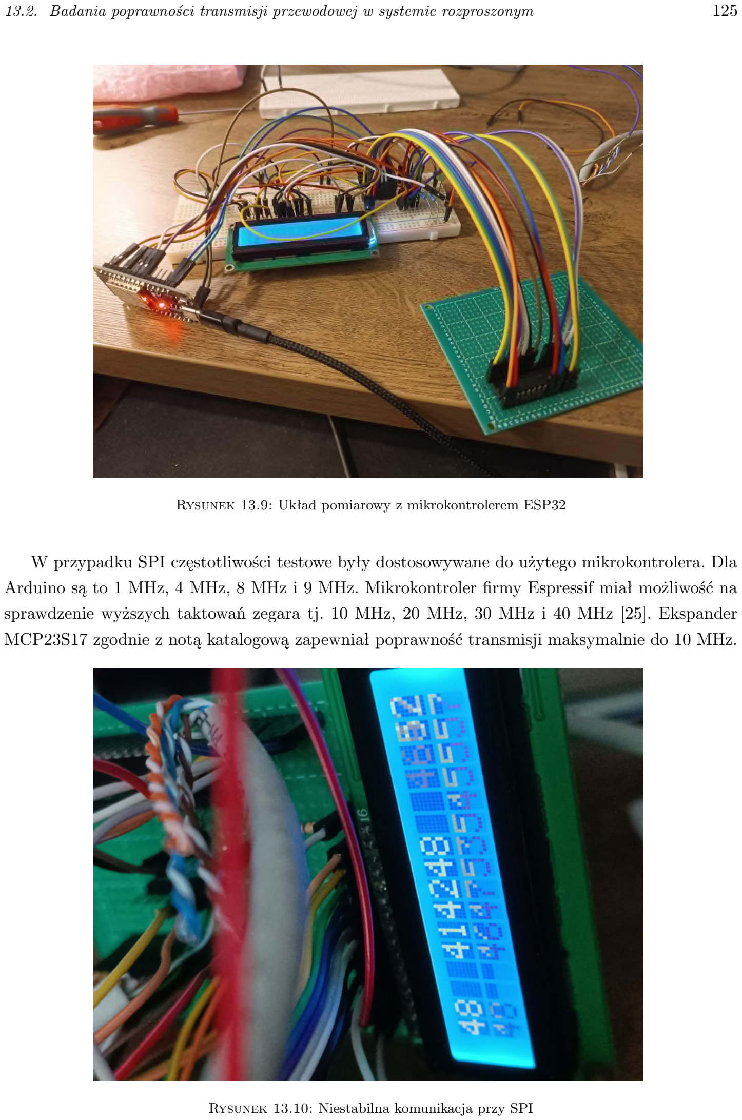
[picture p122: page 125]

13.2. Badania poprawności transmisji przewodowej w systemie rozproszonym | 125

Rysunek 13.9: Układ pomiarowy z mikrokontrolerem ESP32

W przypadku SPI częstotliwości testowe były dostosowywane do użytego mikrokontrolera. Dla Arduino są to 1 MHz, 4 MHz, 8 MHz i 9 MHz. Mikrokontroler firmy Espressif miał możliwość na sprawdzenie wyższych taktowań zegara tj. 10 MHz, 20 MHz, 30 MHz i 40 MHz [25]. Ekspander

MCP23S17 zgodnie z notą katalogową zapewniał poprawność transmisji maksymalnie do 10 MHz.

Rysunek 13.10: Niestabilna komunikacja przy SPI

126 | Badania parametrów podsystemu z modułem LCD

Tabela 13.5: Wyniki pomiarów z wykorzystaniem modułu ESP32 dla transmisji SPI przy napięciu zasilania 3,3 V oraz rezystora 1 kΩ. Część I

Długość / Częstotliwość | 1 MHz | 4 MHz | 8 MHz | 9 MHz
1,0 m | + | + | + | +
3,0 m | + | + | + | +
5,0 m | + | + | + | +
7,0 m | + | + | + | +
10,0 m | – | – | – | –

Tabela 13.6: Wyniki pomiarów z wykorzystaniem modułu ESP32 dla transmisji SPI przy napięciu zasilania 3,3 V oraz rezystora 1 kΩ. Część II

Długość / Częstotliwość | 10 MHz | 20 MHz | 30 MHz | 40 MHz
1,0 m | +/- | – | – | –
3,0 m | +/- | – | – | –
5,0 m | +/- | – | – | –
7,0 m | +/- | – | – | –
10,0 m | – | – | – | –

Tabela 13.7: Wyniki pomiarów z wykorzystaniem modułu Arduino Uno dla transmisji SPI przy napięciu zasilania 5 V oraz rezystora 1 kΩ. Część I

Długość / Częstotliwość | 1 MHz | 4 MHz | 8 MHz | 9 MHz
1,0 m | + | + | + | +
3,0 m | + | + | + | +
5,0 m | + | + | + | +
7,0 m | + | + | + | +/-
10,0 m | + | + | + | –

Tabela 13.8: Wyniki pomiarów z wykorzystaniem modułu Arduino Uno dla transmisji SPI przy napięciu zasilania 5 V oraz rezystora 1 kΩ. Część II

Długość / Częstotliwość | 10 MHz | 20 MHz | 30 MHz | 40 MHz
1,0 m | + | – | – | –
3,0 m | + | – | – | –
5,0 m | +/- | – | – | –
7,0 m | – | – | – | –
10,0 m | – | – | – | –

Pomiary ujawniły kilka ciekawych zjawisk zachodzących w badanym systemie. Zwiększone napięcie stanów logicznych Arduino Uno pozwoliły na stabilną i daleką transmisję do około 8 MHz. Przy szybszej komunikacji został ukazany potencjał ESP32. Stała pojemność przewodów i rezystor tworzyły filtr RC, który tłumił sygnały SPI. W tym momencie znacznie nowocześniejszy układ jakim niewątpliwie jest ESP32 pokazał swoje możliwości. Mikrokontroler pozwalał na wygenerowanie bardzo stromych zboczy o niższej amplitudzie, przez co przy większych częstotliwościach odbiór poszczególnych stanów logicznych był dalej możliwy. Dla podobnej sytuacji odbiór sygnałów z Ar-

duino nie był już osiągalny, ponieważ napięcie rosło lecz zbyt wolno żeby odczytać stan wysoki [6, 8, 12].

# Rozdział 14

# Podsumowanie

Przedstawiona praca udowodniła, że tematyka komunikacji z wyświetlaczami to bardzo rozległy dział elektroniki. Uruchomienie ekranu łączy się z zapoznaniem się z notami katalogowymi wszystkich wykorzystywanych urządzeń, weryfikacją działania na płytce stykowej, poznaniem magistrali komunikacyjnej i przeprowadzeniem testów. Kolejnym wyzwaniem było stworzenie modułów, które miały obsługiwać cały system współpracujący z wyświetlaczem. Proces tworzenia płytek PCB składał się z określenia materiałów, z których miał składać się moduł, dobrania komponentów, rozłożenia elementów, optymalizacji płytki oraz polutowania wszystkich modułów z weryfikacją działania. Sumienna, ciężka praca przyniosła pozytywne efekty - dwa w pełni działające projekty modułów z ekspanderami portów wejścia/wyjścia. Praca z stworzonymi urządzeniami miała dużą

wartość edukacyjną. Powielenie modułów dało możliwość, żeby każdy student elektroniki zdobył doświadczenie z tematyki komunikacji z wyświetlaczem, oraz pracy z różnymi magistralami. Prostota ekspandera PCF8574 pokazywała, że odpowiednio dostosowując projekt do swoich potrzeb można w łatwy i tani sposób manipulować ekranem. Projektowanie modułu wykazało, że ograniczenie liczby połączeń jest możliwe i niesie za sobą wiele korzyści. PCF8574 komunikował się interfejsem I²C, co dało możliwość lepszego zrozumienia szeregowej wymiany danych. Drugi mo-

duł pozwalał na pracę z bardziej zaawansowanymi ekspanderami z rodziny MCP23x17. Urządzenia cechowały się 16-bitową szyną portów wejść/wyjść, rejestrami konfiguracyjnymi i obsługą dwóch magistral szeregowych: I²C oraz SPI. Poza komunikacją szeregową wszystkie moduły miały możli-

wość transmisji równoległej. Dzięki temu student może na jednej płytce zweryfikować wady i zalety danych typów komunikacji. W celu urozmaicenia pracy oraz mając świadomość ciągle rozwijającego się świata elektroniki postanowiono zaprojektować moduły do bezprzewodowej wymiany danych. Układ scalony CC1101 posługiwał się magistralą SPI, dlatego jest w pełni kompatybilny z jednym ze stworzonych modułów. Takim sposobem pokazano, że zaprojektowane i wykonane płytki posiadają ogromny potencjał do rozwoju. Zaprojektowane urządzenia znajdą swoje zastosowanie w systemach pomiarowych, systemach dozorowych, IoT, SmartHome i wielu innych.

127

# Literatura

[1] ATMel. Nota katalogowa mikrokontrolera atmega328p, [online 12.04.2026].

https://ww1.microchip.com/downloads/en/DeviceDoc/Atmel-7810-Automotive-Microcontrollers-ATmega328P_Datasheet.pdf. (https://ww1.microchip.com/downloads/en/DeviceDoc/Atmel-7810-Automotive-Microcontrollers-ATmega328P_Datasheet.pdf)

[2] Jeremy Blum. Odkrywanie Arduino. Narzędzia i techniki inżynierii pełnej czaru. Wydanie II. wyd. Helion, ul. Kościuszki 1c, 44-100 GLIWICE, 2020.
[3] Botland. Konwerter i2c dla wyświetlacza lcd hd44780, [online 14.05.2026].

https://botland.com.pl/konwertery-pozostale/2352-konwerter-i2c-dla-wyswietlacza-lcd-hd44780-5903351248693.html. (https://botland.com.pl/konwertery-pozostale/2352-konwerter-i2c-dla-wyswietlacza-lcd-hd44780-5903351248693.html)

[4] Botland. Wyświetlacz 16x2 z górnymi wyprowadzeniami, [online 12.04.2026].

https://botland.com.pl/wyswietlacze-alfanumeryczne-i-graficzne/19738-wyswietlacz-lcd-2x16-znakow-zielony-justpi-5903351243063.html. (https://botland.com.pl/wyswietlacze-alfanumeryczne-i-graficzne/19738-wyswietlacz-lcd-2x16-znakow-zielony-justpi-5903351243063.html)

[5] Robert H. Chen. Liquid Crystal Displays: Fundamental Physics and Technology. John Wiley and Sons, Inc., Hoboken, New Jersey, 2011.
[6] Augustyn Chwaleba, Maciej Poniński, Andrzej Siedlecki. Metrologia Elektryczna. Wydawnictwo Naukowo-Techniczne, Warszawa, 2003.
[7] Peter Dalmaris. KiCad Like a Pro. Tech Explorations, Berowra 2081, Australia, 2021.
[8] Jacek Dusza, Grażyna Gortat, Antoni Leśniewski. Podstawy miernictwa. Oficyna Wydawnicza Politechniki Warszawskiej, 2002.
[9] Tomasz Francuz. Mikrokontrolery AVR i ARM. Sterowanie wyświetlaczami LCD. wyd. Helion, ul. Kościuszki 1c, 44-100 GLIWICE, 2017.
[10] Paweł Hadam. Projektowanie systemów mikroprocesorowych. wyd. BTC, ul. Lwowska 5 05-120 Legionowo, 2004.
[11] Hitachi. Nota katalogowa sterownika hd44780u, [online 12.04.2026].

https://www.alldatasheet.pl/datasheet-pdf/view/63673/HITACHI/HD44780.html.

[12] Paul Horowitz, Winfield Hill. Sztuka elektroniki. Wydawnictwa Komunikacji Łączności, Warszawa, 2018.
[13] Ilitek. Nota katalogowa sterownika ili9341, [online 12.04.2026].

https://www.alldatasheet.com/datasheet-pdf/view/1131760/ETC2/ILI9341.html.

[14] Microchip Technology Inc. Nota katalogowa ekspanderów mcp23017 oraz mcp23s17, [online 17.04.2026]. https://ww1.microchip.com/downloads/en/devicedoc/20001952c.pdf.
[15] Texas Instruments. Cc1101 - low-power sub-1 ghz rf transceiver [online 15.06.2026].

https://www.ti.com/lit/ds/symlink/cc1101.pdf.

[16] Texas Instruments. Nota katalogowa ekspandera pcf8574, [online 17.04.2026].

https://www.ti.com/lit/ds/symlink/pcf8574.pdf.

129

130 | Literatura
[17] Horward W. Johnson, Martin Graham. High-Speed Digital Design. Prentice Hall, Englewood Cliffs, New Jersey, 1993.
[18] Mirosław Kardaś. Język C Pasja Programowania Mikrokontrolerów 8-bitowych. wyd. Atnel, ul. Uczniowska 5A, 70-893 Szczecin, 2014.
[19] Graham Keeth, Jon Evans, Glenn Peterson. Wprowadzenie do programu kicad, [online 11.06.2026].

https:
//docs.kicad.org/10.0/pl/getting_started_in_kicad/getting_started_in_kicad.html.
[20] Altium Limited. Szeregowe protokoły komunikacyjne część 5 - spi, [online 07.05.2026].

https://resources.altium.com/p/serial-communications-protocols-part-5-spi.

[21] Altium Limited. Szeregowe protokoły komunikacyjne część 6 - i2c, [online 07.05.2026].

https://resources.altium.com/p/6-serial-communications-protocols-i2c.

[22] mSalamon. Wyświetlacz tft oparty na sterowniku ili9341, [online 12.04.2026].

https://sklep.msalamon.pl/produkt/wyswietlacz-tft-lcd-32%E2%80%B3-ili9341-240x320/.

[23] Waldemar Nawrocki. Sensory i systemy pomiarowe. wyd. Politechniki Poznańskiej, ul. Piotrowo 5 61-138 Poznań, 2006.
[24] Waldemar Nawrocki. Projektowanie systemów mikroprocesorowych. wyd. Politechniki Poznańskiej, ul. Piotrowo 5 61-138 Poznań, 2010.
[25] Vedat Ozan Oner. Developing IoT Projects with ESP32. Packt Publishing, 11 St Paul’s Square, Birmingham, 2021.
[26] Zachariah Peterson. Spi vs. i2c: How to choose the best protocol for your memory chips, [online 11.06.2026]. https:

//resources.altium.com/p/spi-versus-i2c-how-choose-best-protocol-your-memory-chips.

[27] Paul Scherz, Simon Mon. Practical Electronics for Inventors. Mc Graw Hill Education, New York, Chicago, 2016.
[28] NXP Semiconductors. Specyfikacja magistrali i2c i instrukcja obsługi, [online 07.05.2026].

https://www.nxp.com/documents/user_manual/UM10204.pdf.

[29] TME. Wyświetlacz 16x2 z dolnymi wyprowadzeniami, [online 12.04.2026]. https://www.tme.eu/pl/

details/rc1602e-biw-esx/wyswietlacze-lcd-alfanumeryczne/raystar-optronics/. (https://www.tme.eu/pl/details/rc1602e-biw-esx/wyswietlacze-lcd-alfanumeryczne/raystar-optronics/)

[30] TME. Wyświetlacz 40x2 z wyprowadzeniami po lewej stronie wyświetlacza, [online 12.04.2026].

https://www.tme.eu/pl/details/rc4002a-biw-jsx/wyswietlacze-lcd-alfanumeryczne/raystar-optronics/. (https://www.tme.eu/pl/details/rc4002a-biw-jsx/wyswietlacze-lcd-alfanumeryczne/raystar-optronics/)

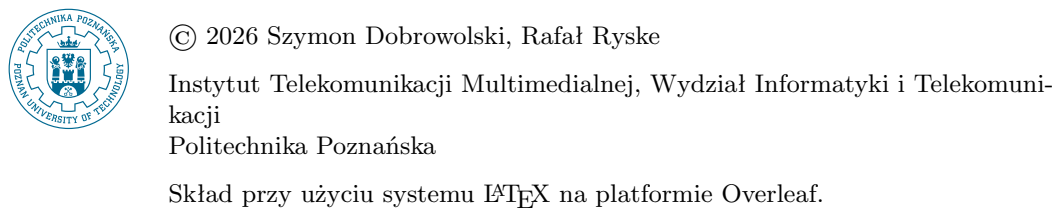
[picture p123: page 131]

© 2026 Szymon Dobrowolski, Rafał Ryske

Instytut Telekomunikacji Multimedialnej, Wydział Informatyki i Telekomuni-
kacji
Politechnika Poznańska

Skład przy użyciu systemu LATEX na platformie Overleaf.
