rryske2001/praca-magisterska/płytka_MCP_I2C/plots/płytka_MCP_I2C_schem_V2.pdf

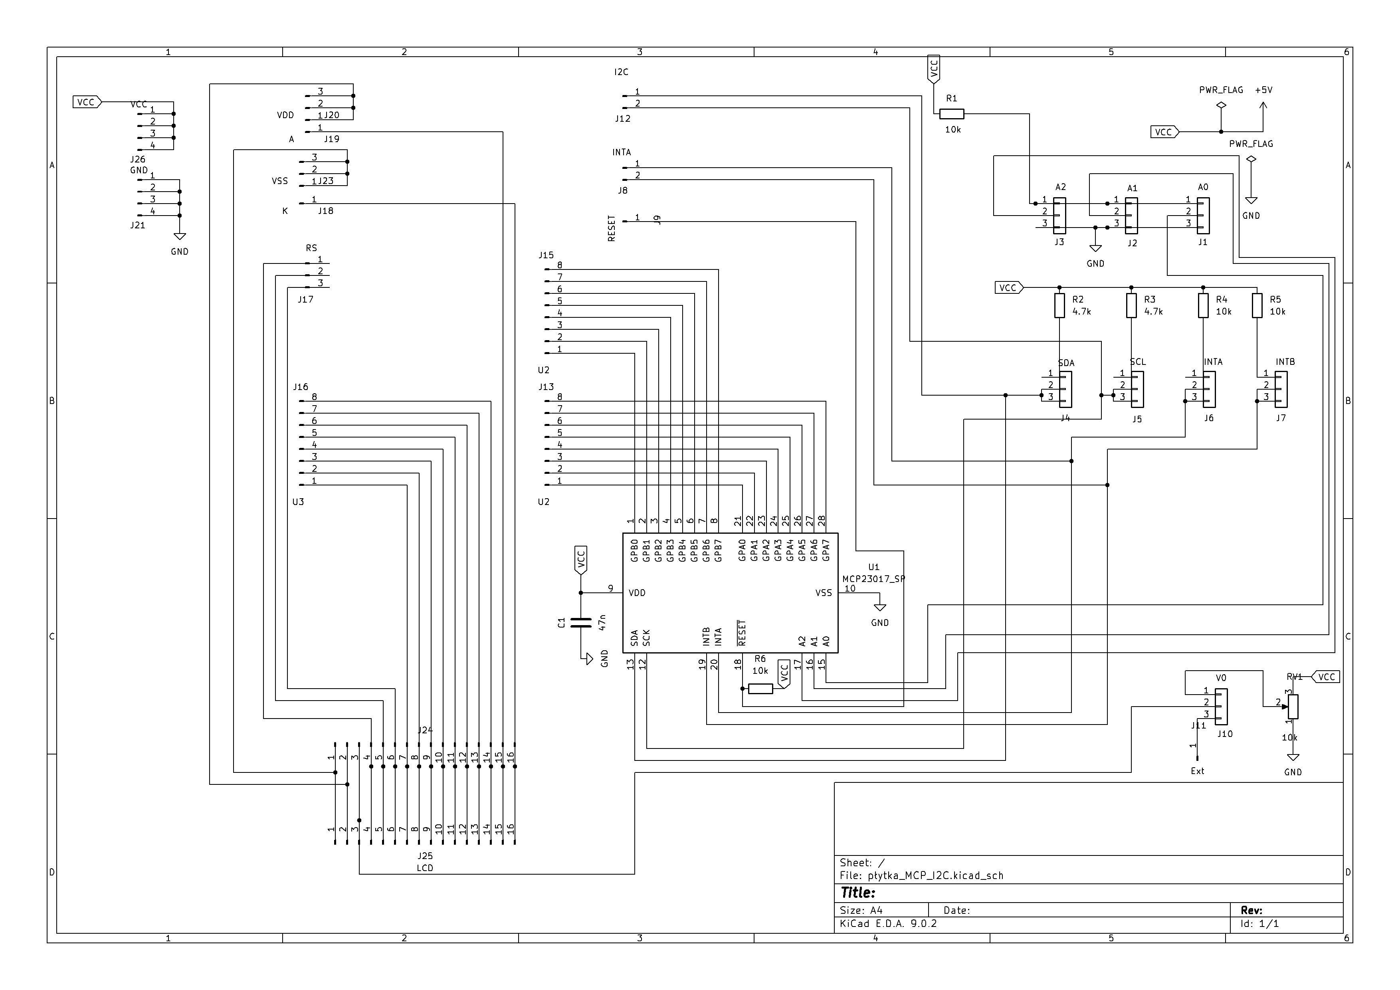
[picture p124: page 1]
