rryske2001/praca-magisterska/płytka_MCP_SPI_frez/plots/płytka_MCP_SPI_schem.pdf

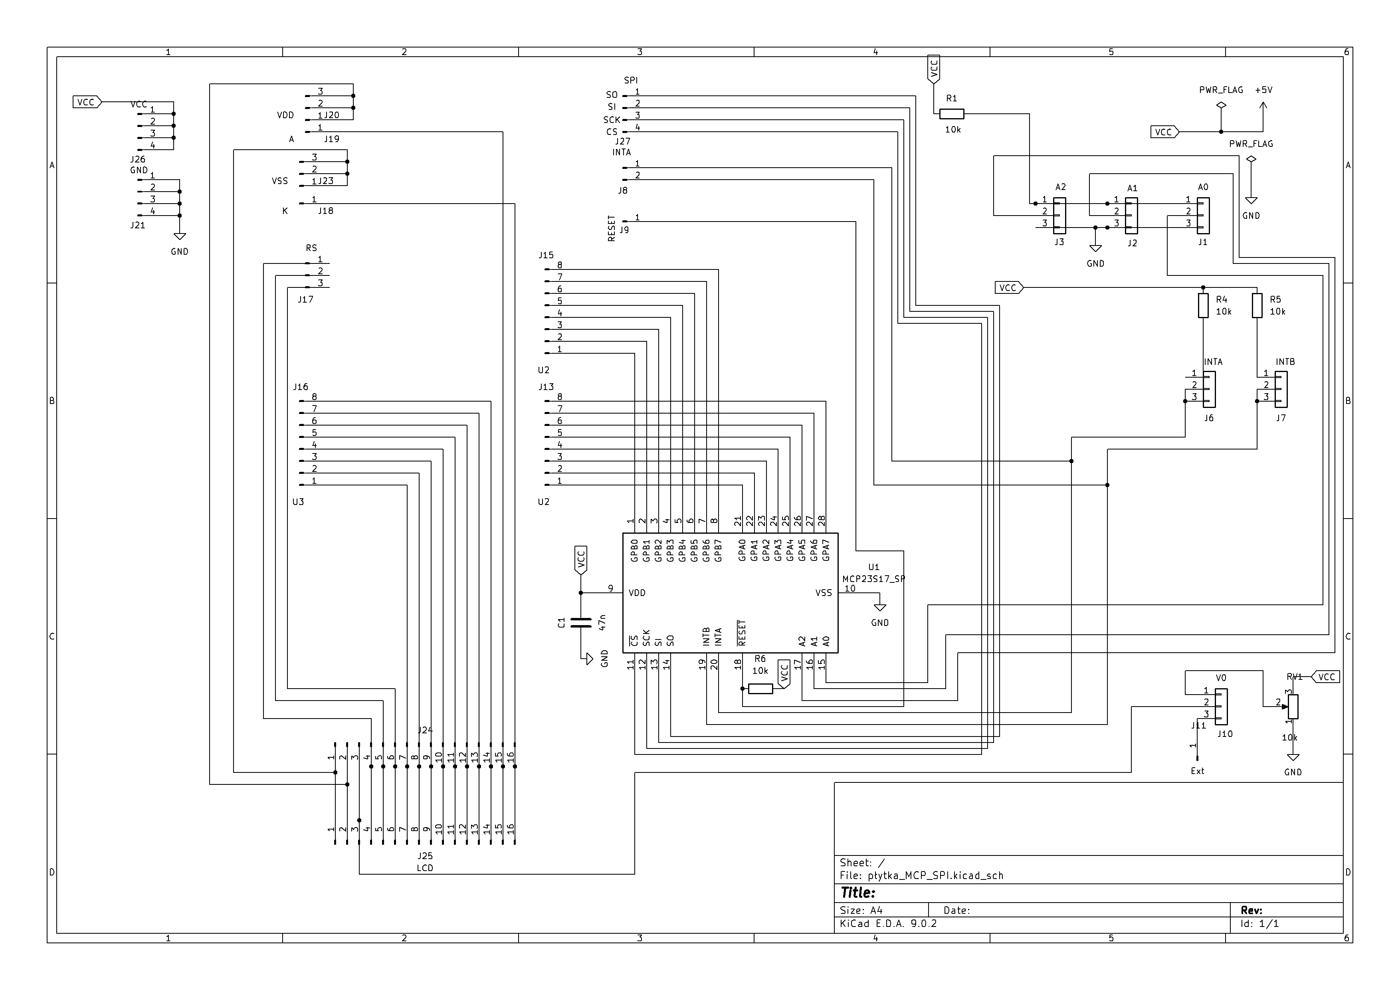
[picture p125: page 1]
