rryske2001/praca-magisterska/projekt_modul_systemowy_dwa_pcf_wersja_frezowanie/plots/schemat.pdf

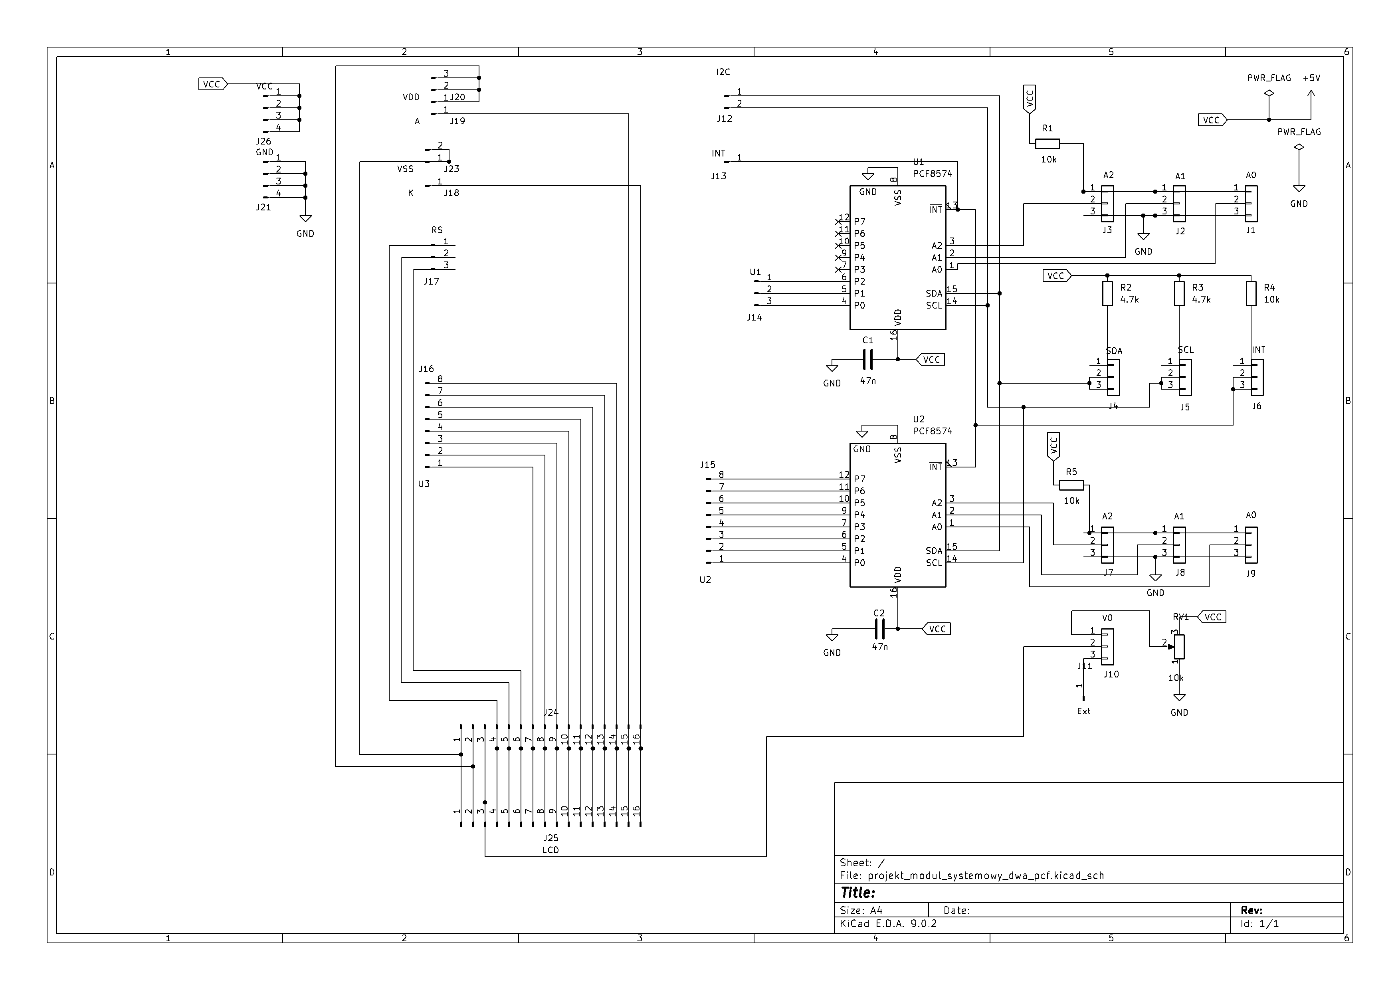
[picture p126: page 1]
