rryske2001/praca-magisterska/MCP_I2C_SPI_alternatywna_V11/plots/MCP_I2C_SPI_schematic_V2.pdf

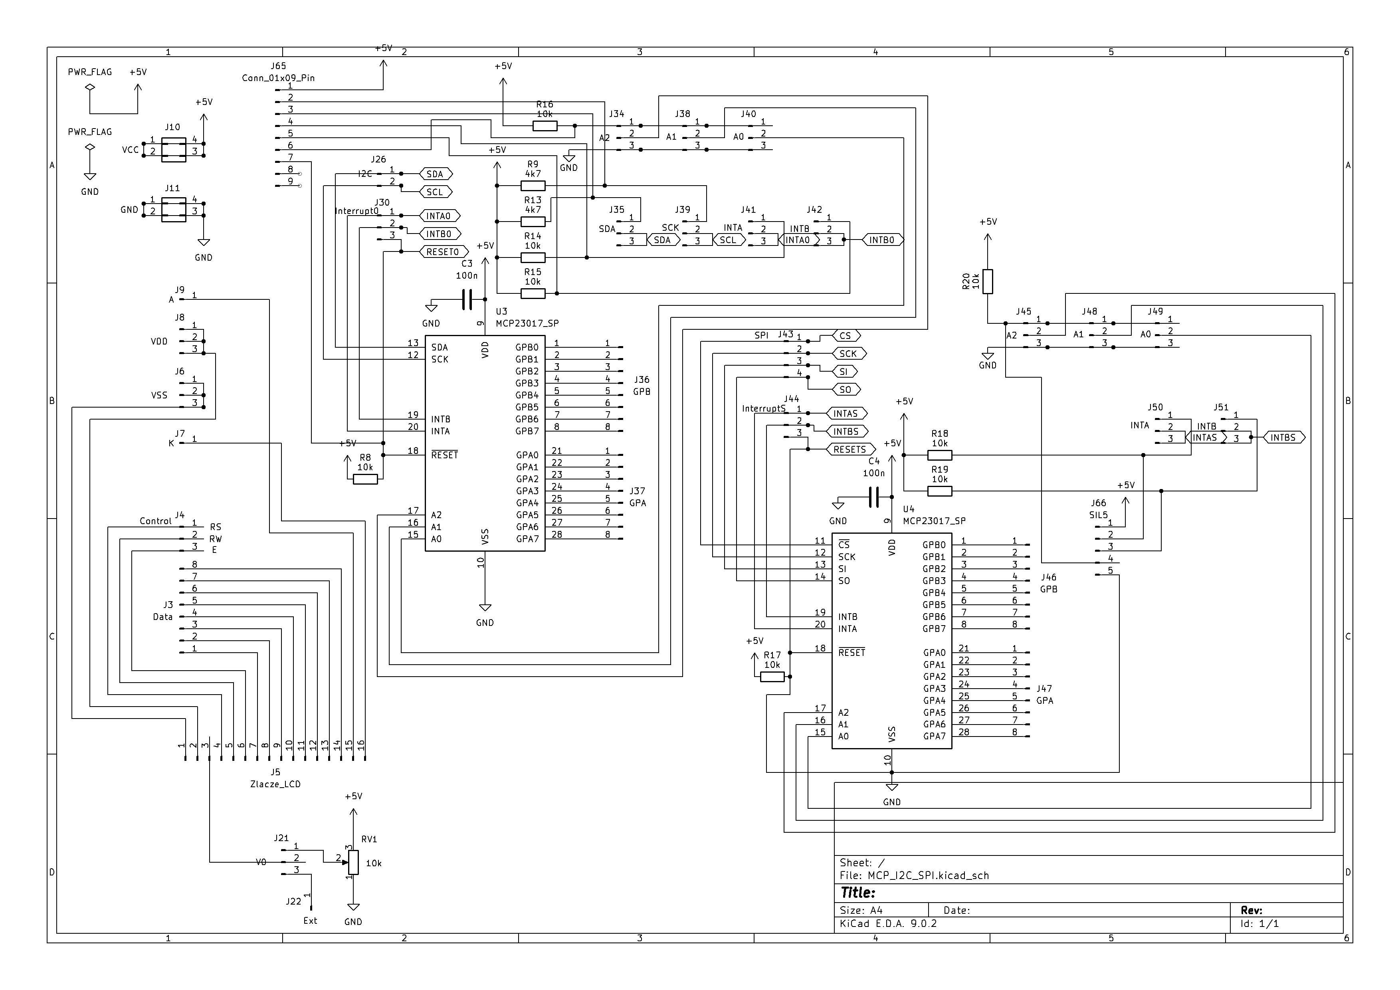
[picture p127: page 1]
