rryske2001/praca-magisterska/MCP_I2C_SPI_alternatywna_V11/plots/MCP_I2C_SPI_schematic.pdf

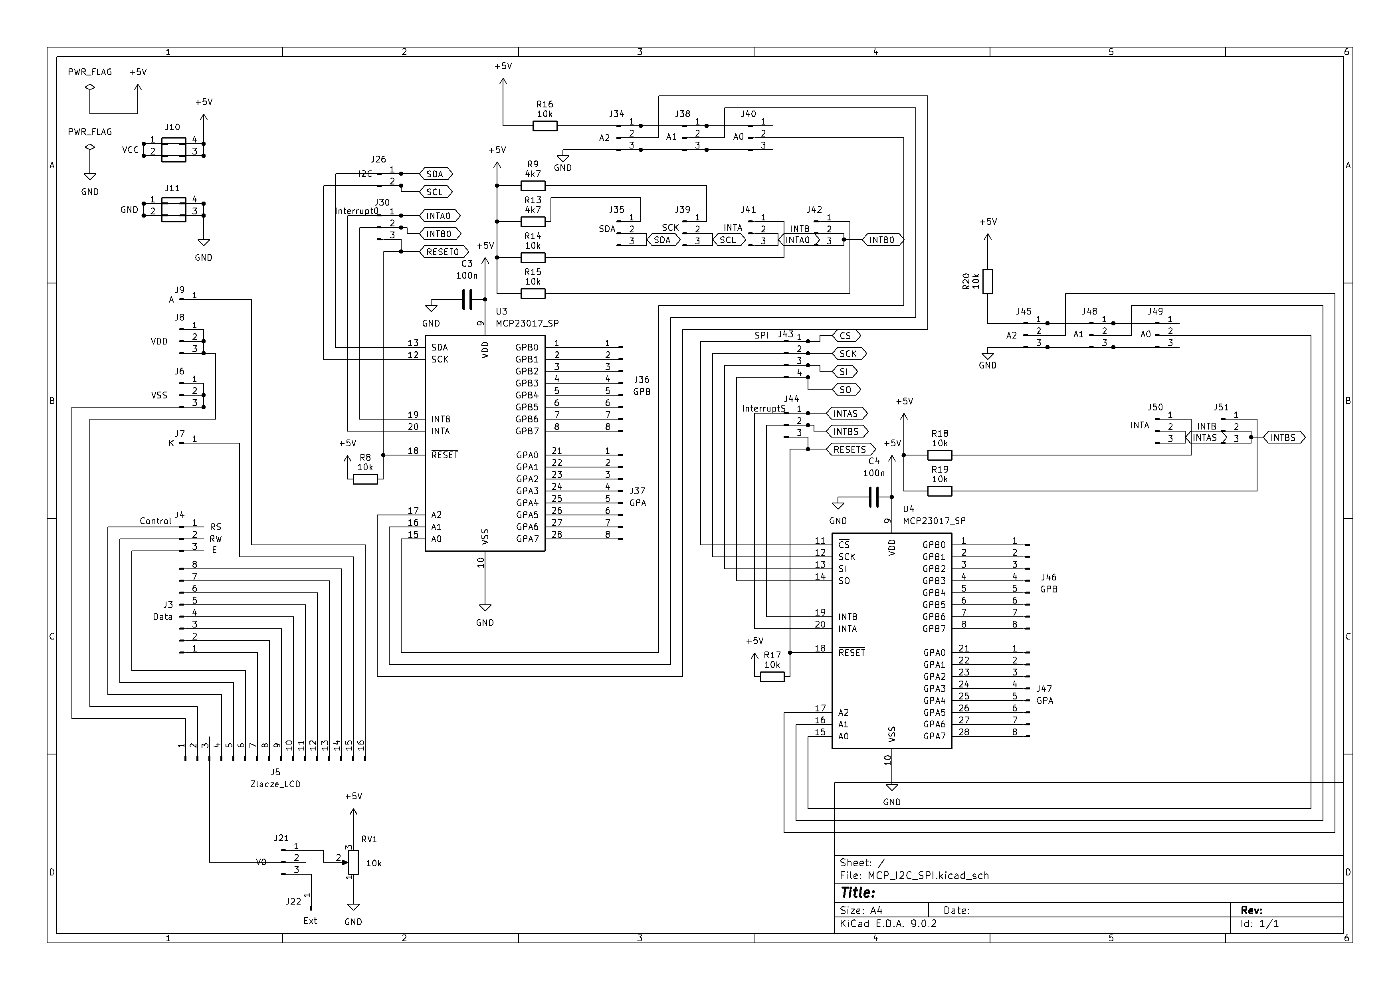
[picture p128: page 1]
