rryske2001/praca-magisterska/płytka_MCP_I2C_v1/plots/płytka_MCP_I2C_schem.pdf

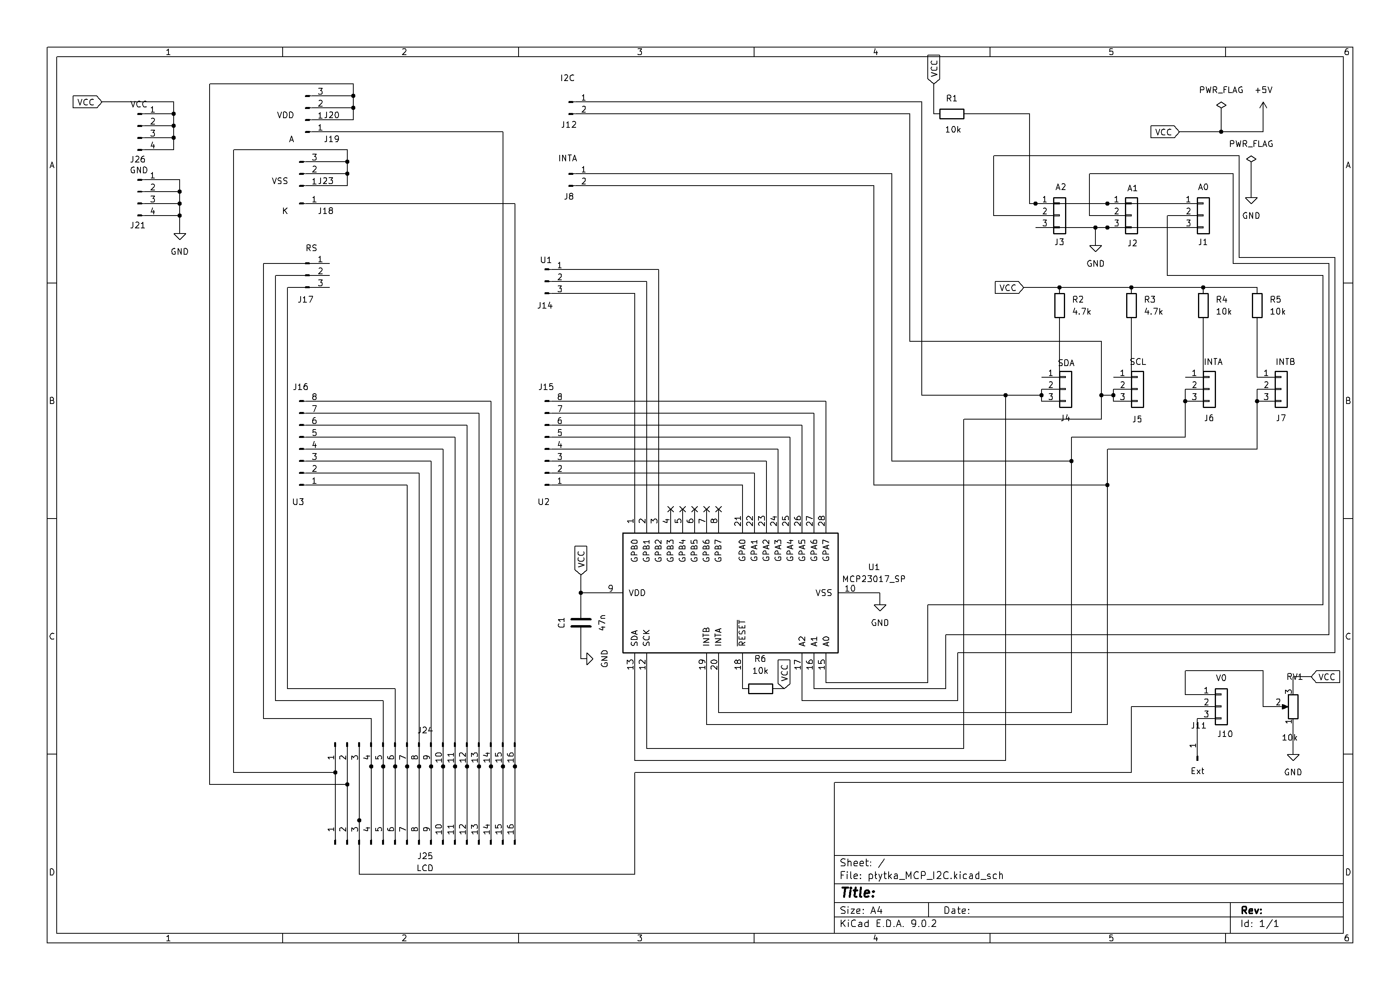
[picture p129: page 1]
