rryske2001/praca-magisterska/kod_MCP_I2C_SPI/caly_kod_MCP_I2C_SPI.png

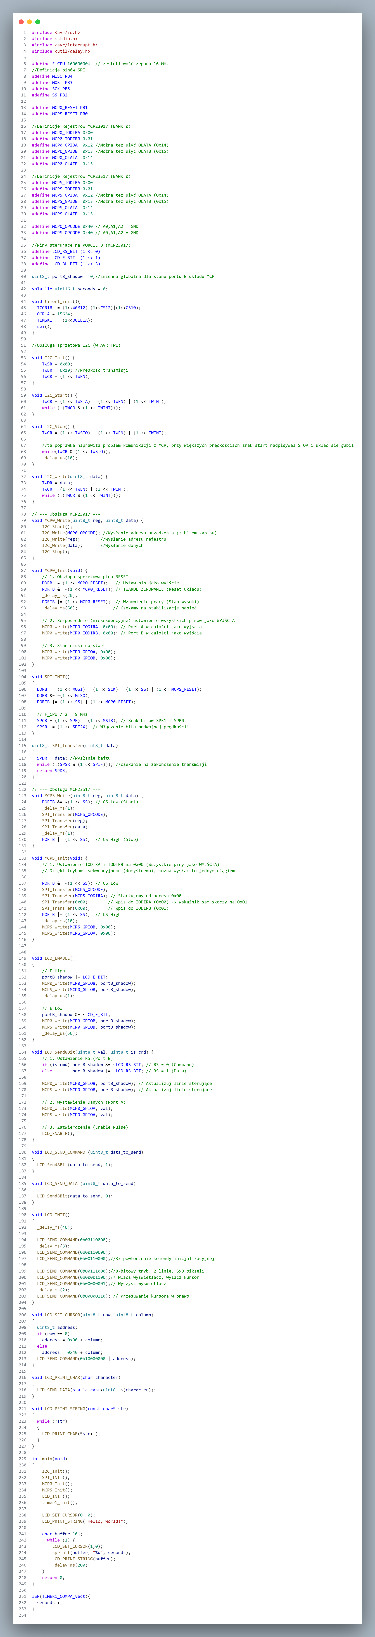
kod_MCP_I2C_SPI/caly_kod_MCP_I2C_SPI.png
