rryske2001/praca-magisterska/kod_MCP_I2C_SPI/kluczowe_funkcje.png

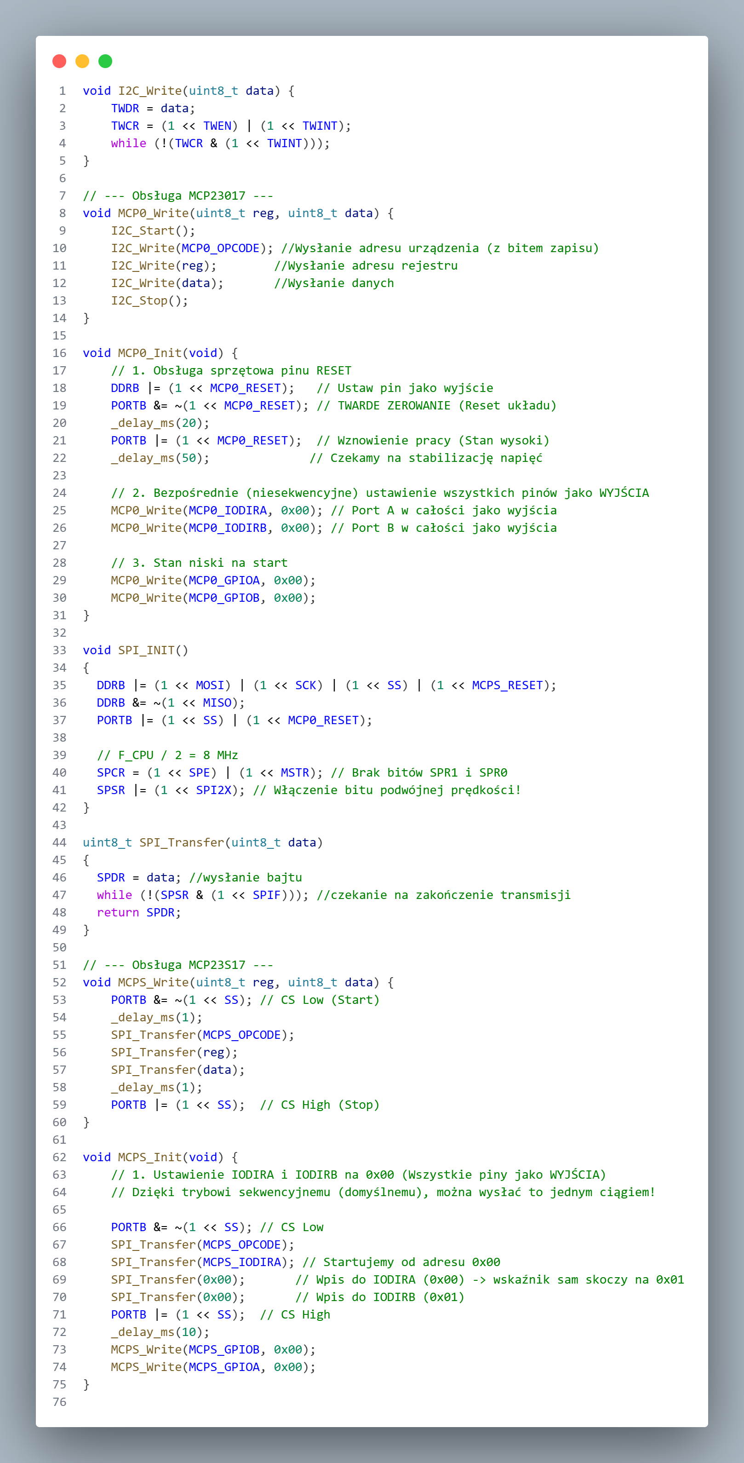
kod_MCP_I2C_SPI/kluczowe_funkcje.png
