rryske2001/praca-magisterska/MPC_SPI/Pomiar czasu jednego pakietu danych.png

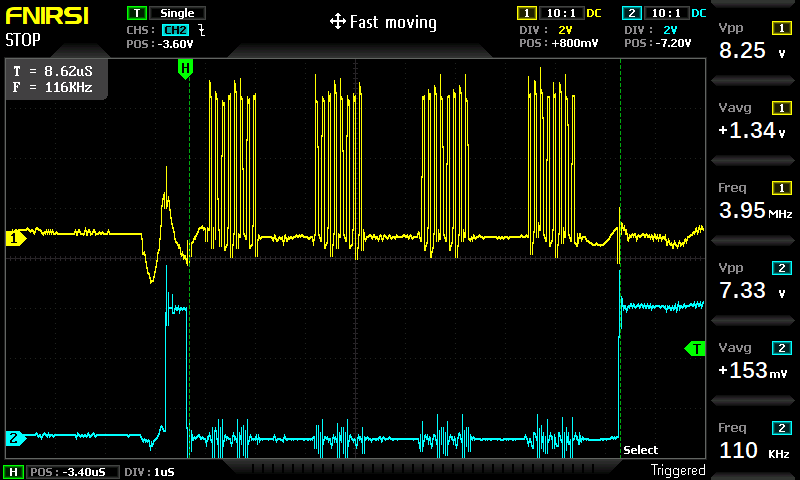
MPC_SPI/Pomiar czasu jednego pakietu danych.png
