rryske2001/praca-magisterska/MPC_SPI/Pomiar_częstotliwości_zegara.png

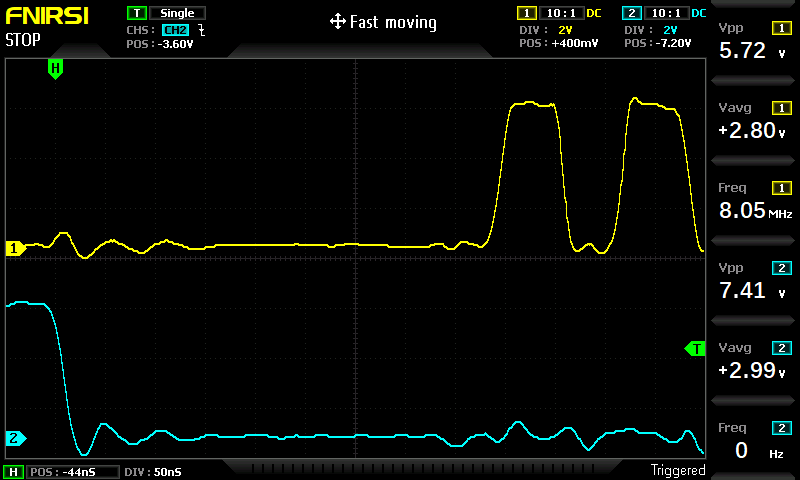
MPC_SPI/Pomiar_częstotliwości_zegara.png
