rryske2001/praca-magisterska/obrazki/16x2_dolne_wyprowadzenia.png

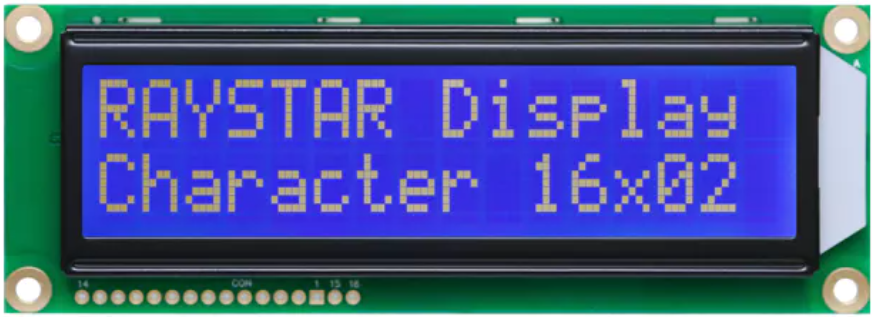
obrazki/16x2_dolne_wyprowadzenia.png
