rryske2001/praca-magisterska/obrazki/MCP23S17pinout.png

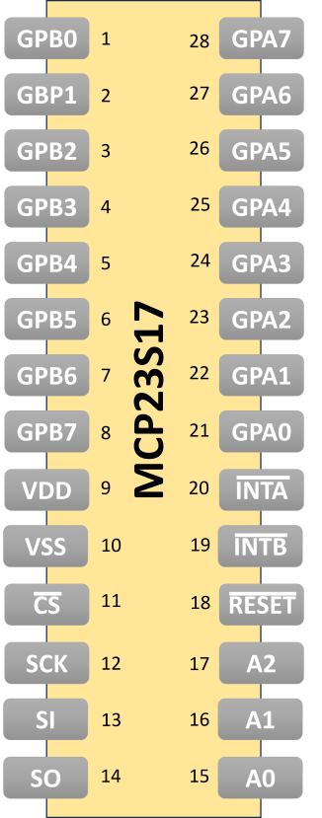
obrazki/MCP23S17pinout.png
