rryske2001/praca-magisterska/obrazki/PCF8574pinout.png

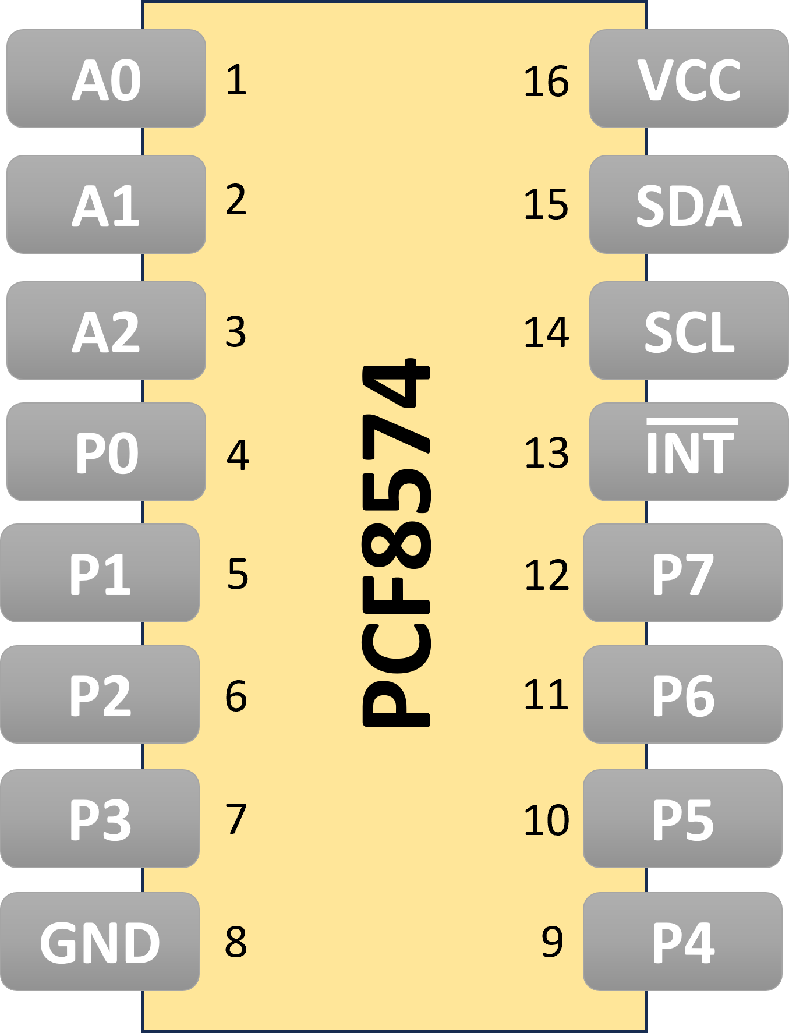
obrazki/PCF8574pinout.png
