rryske2001/praca-magisterska/obrazki/schem_blok_PCF8574.png

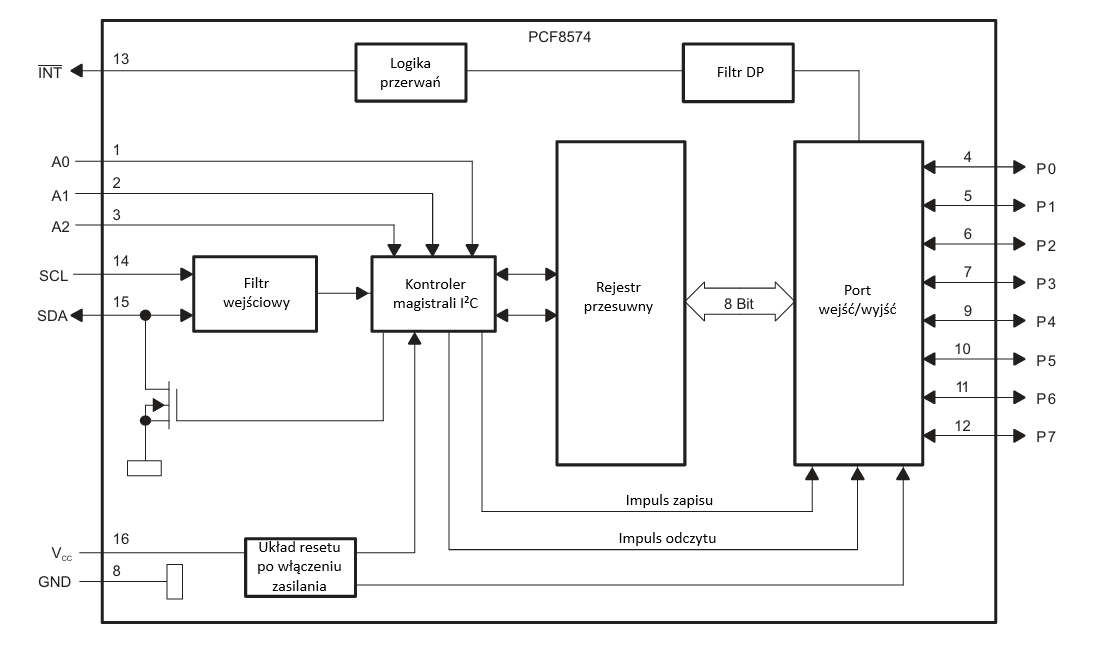
obrazki/schem_blok_PCF8574.png
