rryske2001/praca-magisterska/obrazki/Simple-SPI-Write-Transaction.jpg

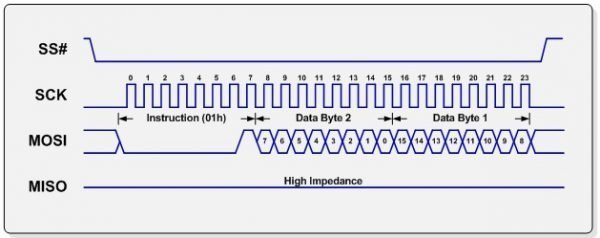
obrazki/Simple-SPI-Write-Transaction.jpg
