rryske2001/praca-magisterska/obrazki/wykres_czasowy_SPI_zapis.png

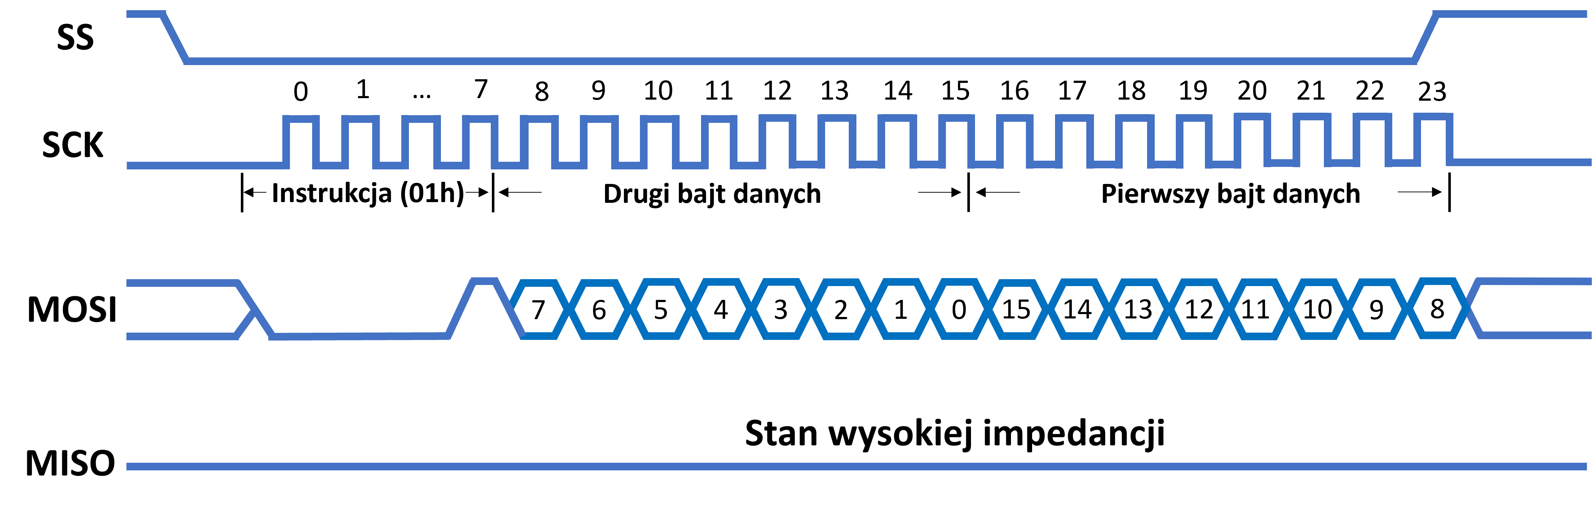
obrazki/wykres_czasowy_SPI_zapis.png
