rryske2001/praca-magisterska/projekt_modul_systemowy_dwa_pcf_wersja_frezowanie/plots/bottom3d.png

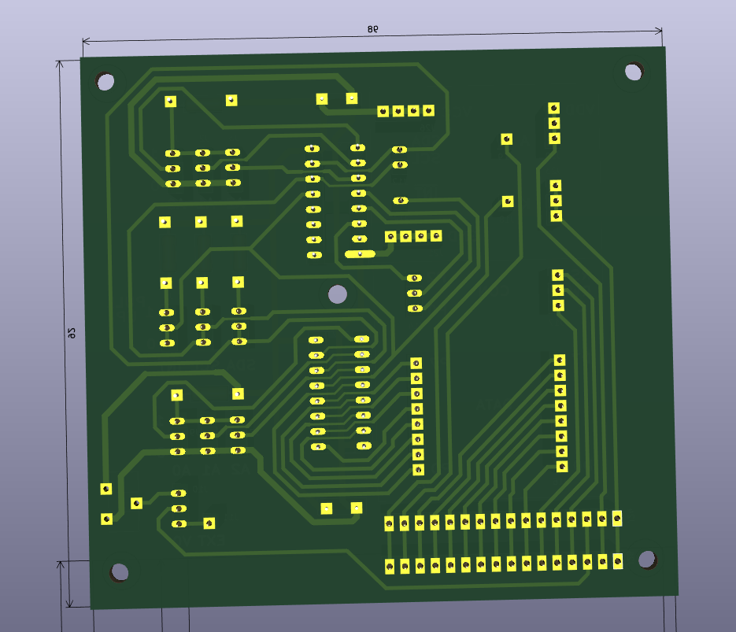
projekt_modul_systemowy_dwa_pcf_wersja_frezowanie/plots/bottom3d.png
