rryske2001/praca-magisterska/wyswietlacz_interfejs_8bit/sygnał_ENABLE.png

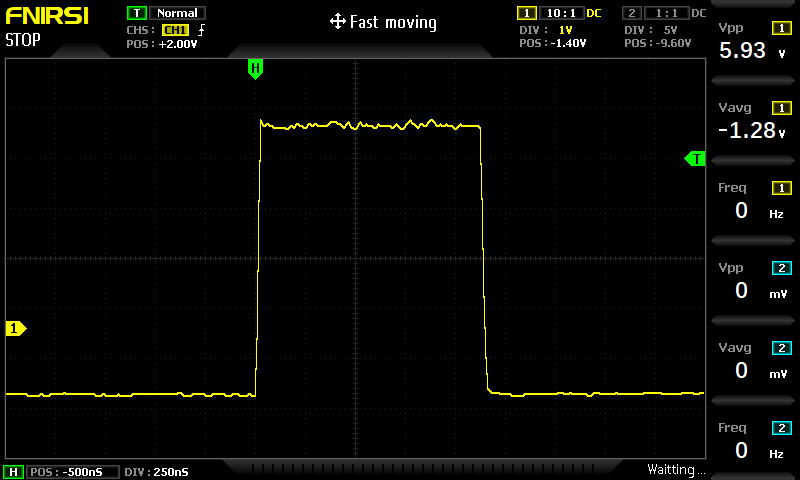
wyswietlacz_interfejs_8bit/sygnał_ENABLE.png
