rryske2001/praca-magisterska/wyswietlacz_interfejs_8bit/sygnał_enable_czas_stan_niski.png

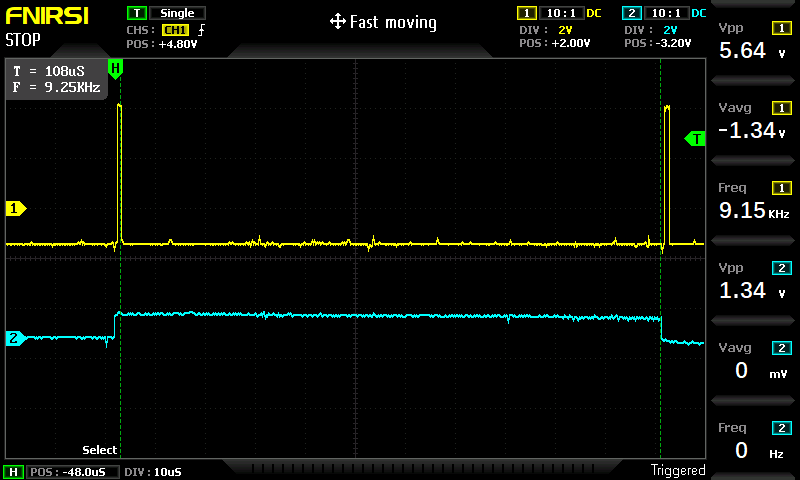
wyswietlacz_interfejs_8bit/sygnał_enable_czas_stan_niski.png
