rryske2001/praca-magisterska/wyswietlacz_interfejs_8bit_pcf/caly_kod_wysw_8bit_1pcf1.png

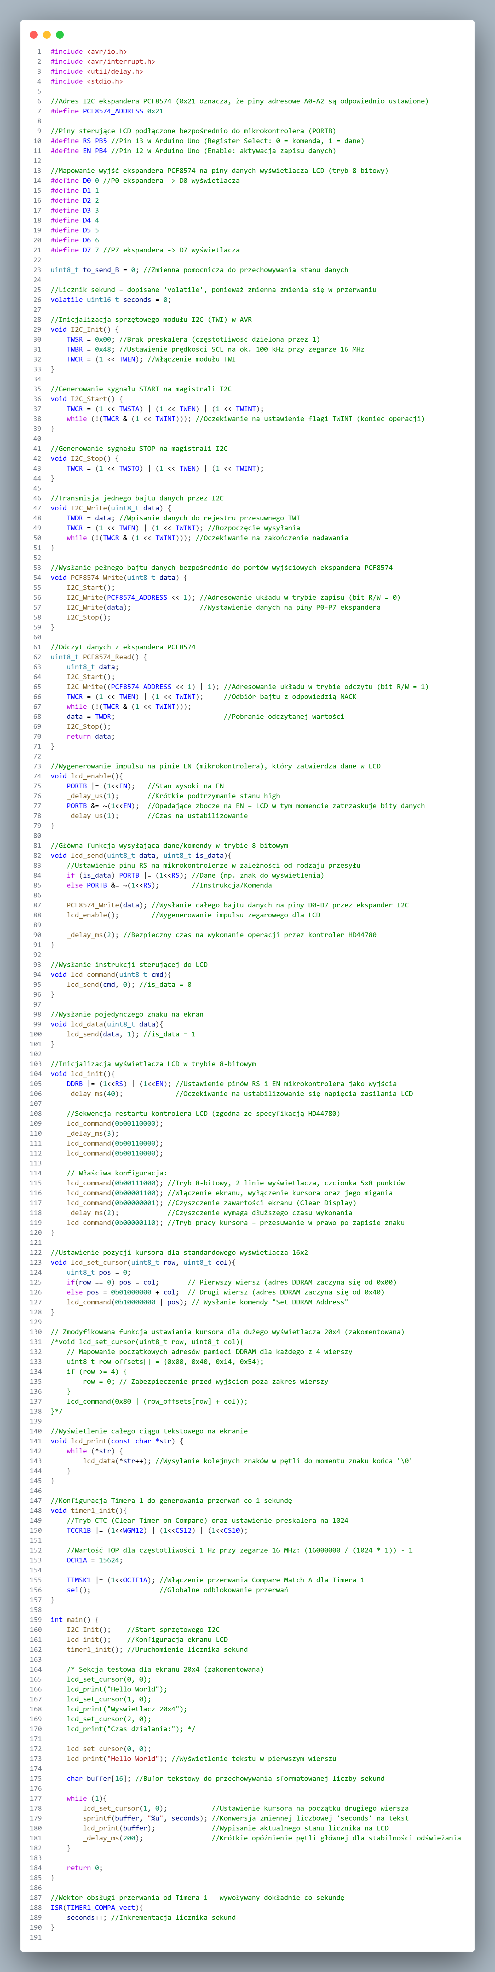
wyswietlacz_interfejs_8bit_pcf/caly_kod_wysw_8bit_1pcf1.png
