rryske2001/praca-magisterska/wyswietlacz_interfejs_8bit_pcf/delay_pomiedzy_danymi_a_enb.png

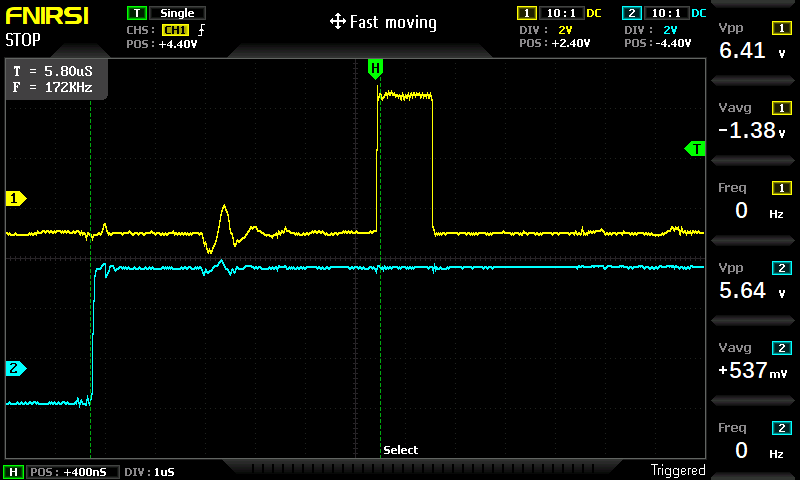
wyswietlacz_interfejs_8bit_pcf/delay_pomiedzy_danymi_a_enb.png
