rryske2001/praca-magisterska/wyswietlacz_interfejs_8bit_pcf/przykład_wyzwolenia_danych.png

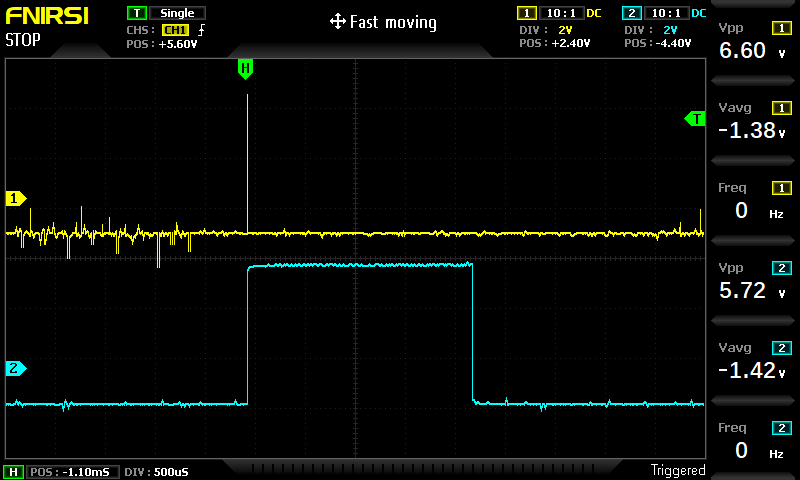
wyswietlacz_interfejs_8bit_pcf/przykład_wyzwolenia_danych.png
