rryske2001/praca-magisterska/wyswietlacz_interfejs_szere_8_bit/i2c_czas_jednej_ramki.png

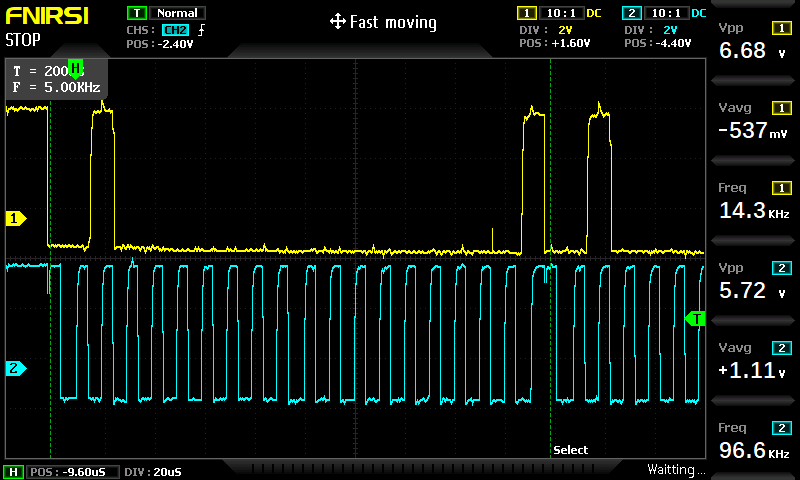
wyswietlacz_interfejs_szere_8_bit/i2c_czas_jednej_ramki.png
