rryske2001/praca-magisterska/wyswietlacz_interfejs_szere_8_bit/i2c_scl_częstotliwość.png

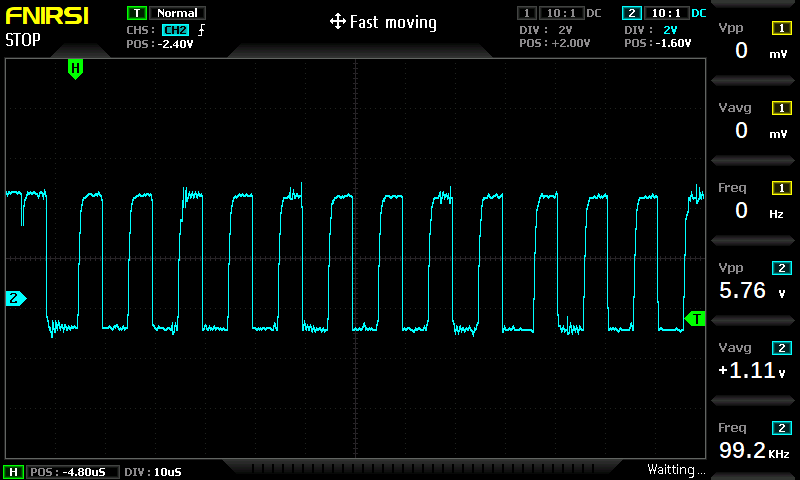
wyswietlacz_interfejs_szere_8_bit/i2c_scl_częstotliwość.png
