rryske2001/praca-magisterska/wyswietlacz_interfejs_szere_8_bit/i2c_stop.jpg

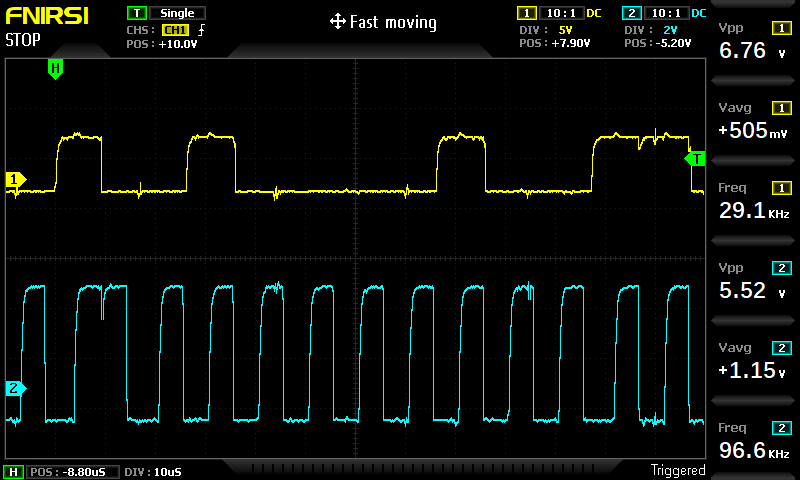
wyswietlacz_interfejs_szere_8_bit/i2c_stop.jpg
