rryske2001/praca-magisterska/wyswietlacz_interfejs_szere_8_bit/wykres_sonda.png

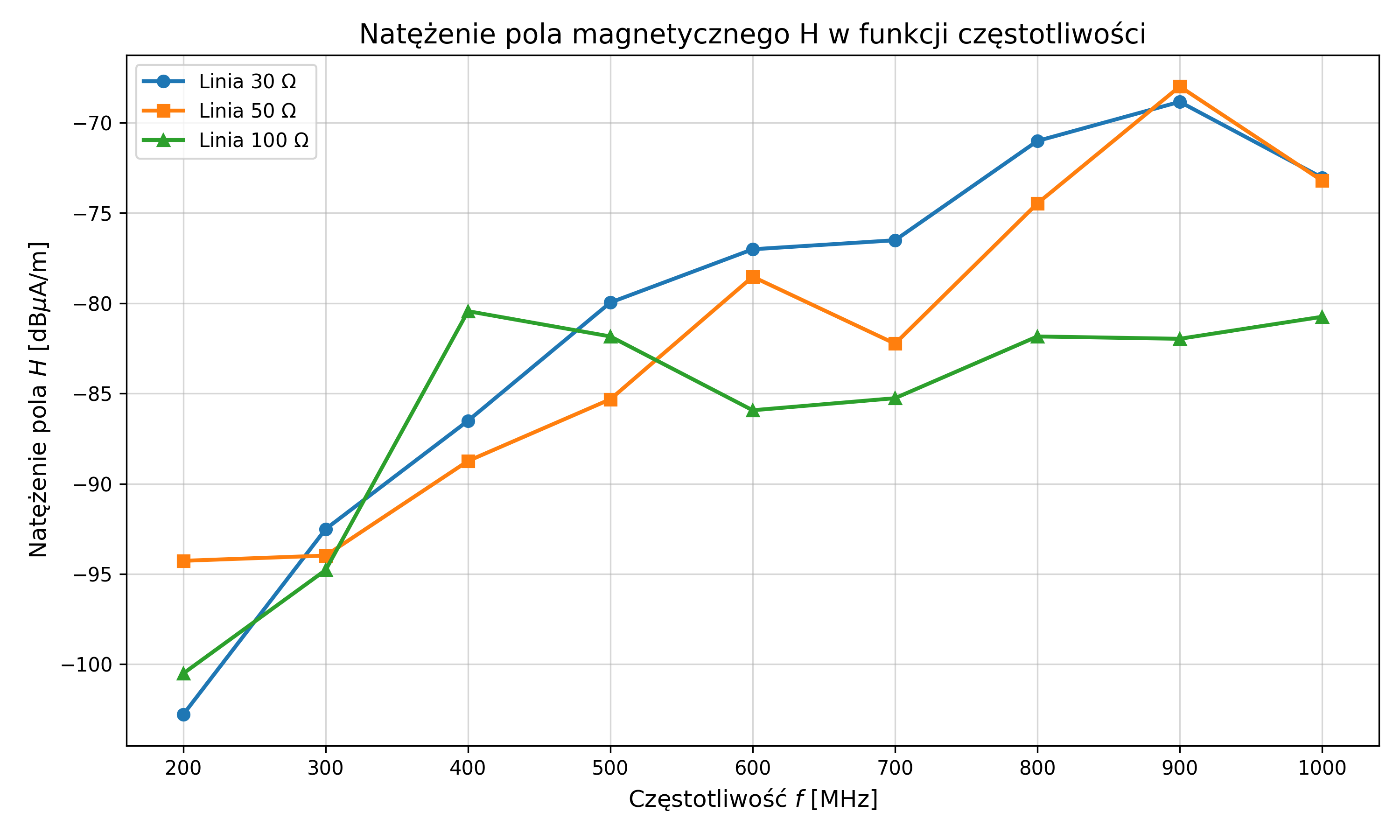
wyswietlacz_interfejs_szere_8_bit/wykres_sonda.png
