rryske2001/praca-magisterska/Obudowa_do_modulu_dwa_PCF/LCD 16x2 HD44780 assembly.stp

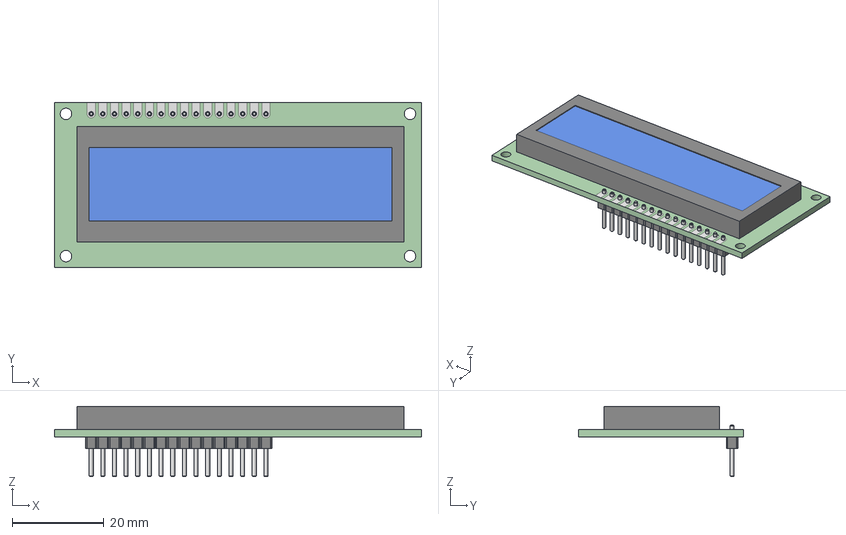
[picture p155: CAD file, 2026-06-25]
Obudowa_do_modulu_dwa_PCF/LCD 16x2 HD44780 assembly.stp
80.0 x 36.0 x 15.3 mm
lcd 16_2 HD44780
dupont_pin_16
