rryske2001/praca-magisterska/Obudowa_do_MCP_I2C_SPI/zlozenie_obudowy_do_MCP_I2C_SPI.FCStd

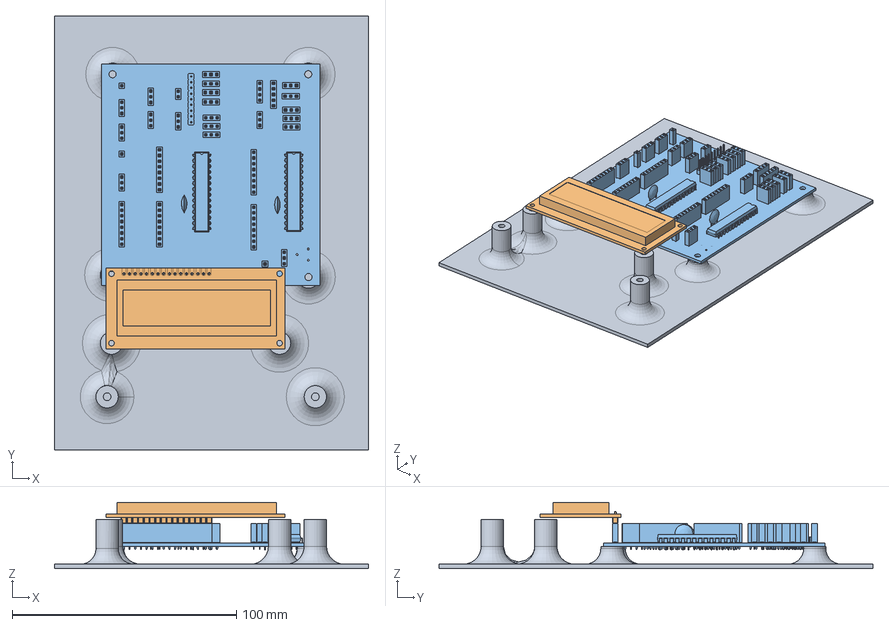
[picture p156: CAD file, 2026-07-02]
Obudowa_do_MCP_I2C_SPI/zlozenie_obudowy_do_MCP_I2C_SPI.FCStd
140.2 x 193.7 x 29.6 mm
GotowaObudowa_do_MCP_I2C_SPI1_001
LCD 16x2 HD44780 assembly1_001
MCP_I2C_SPI1_001
