rryske2001/praca-magisterska/Obudowa_do_modulu_dwa_PCF/Gotowa_obudowa_do_modulu_dwa_PCF.step

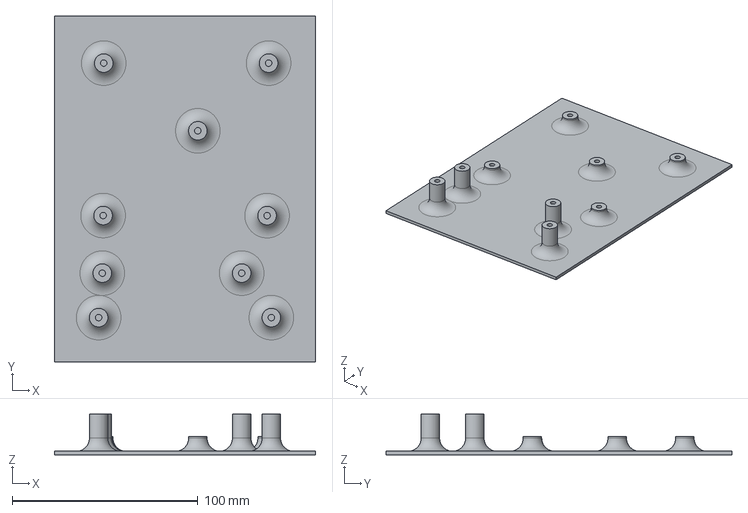
[picture p157: CAD file, 2026-07-02]
Obudowa_do_modulu_dwa_PCF/Gotowa_obudowa_do_modulu_dwa_PCF.step
140.4 x 185.9 x 22.0 mm
