rryske2001/praca-magisterska/obudowa_moduł_PCF/obudowa_PCF.FCStd

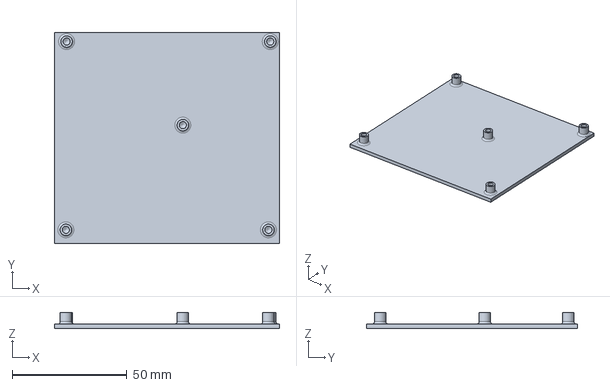
[picture p158: CAD file, 2026-06-23]
obudowa_moduł_PCF/obudowa_PCF.FCStd
98.0 x 92.0 x 7.00 mm
