rryske2001/praca-magisterska/Obudowa_do_MCP_I2C_SPI/GotowaObudowa_do_MCP_I2C_SPI.step

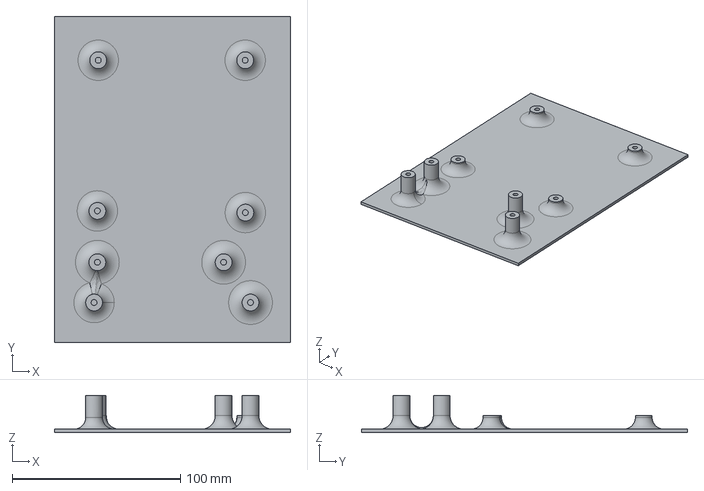
[picture p159: CAD file, 2026-07-02]
Obudowa_do_MCP_I2C_SPI/GotowaObudowa_do_MCP_I2C_SPI.step
140.2 x 193.7 x 22.0 mm
