rryske2001/praca-magisterska/Obudowa_do_modulu_dwa_PCF/zlozenie_obudowa_do_modulu_dwa_PCF.FCStd

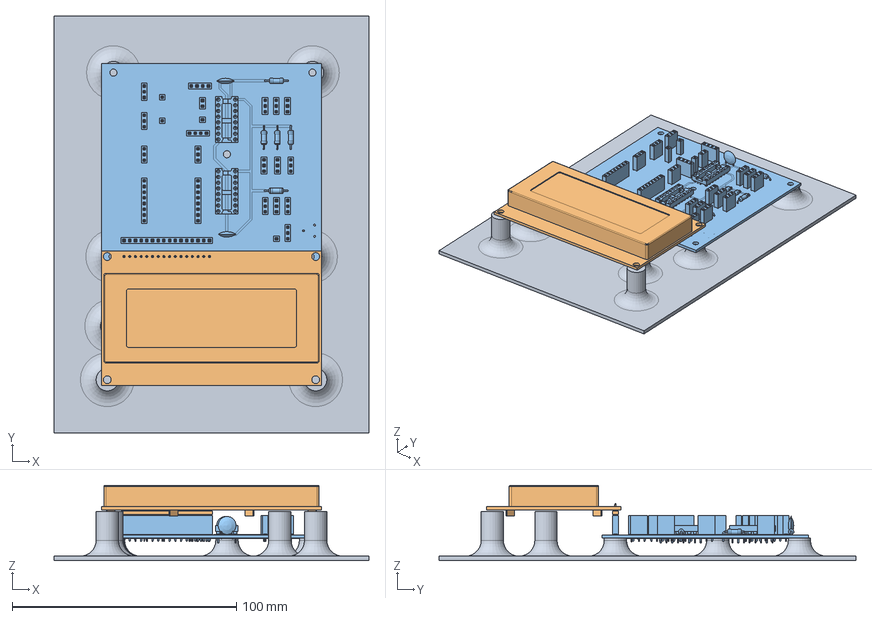
[picture p160: CAD file, 2026-07-02]
Obudowa_do_modulu_dwa_PCF/zlozenie_obudowa_do_modulu_dwa_PCF.FCStd
140.4 x 185.9 x 33.5 mm
Gotowa_obudowa_do_modulu_dwa_PCF1_001
QP5522 Jaycar 20x4 LCD Module v15_001
projekt_modul_systemowy_dwa_pcf1_001
