rryske2001/praca-magisterska/Obudowa_do_MCP_I2C_SPI/LCD16x2.stl

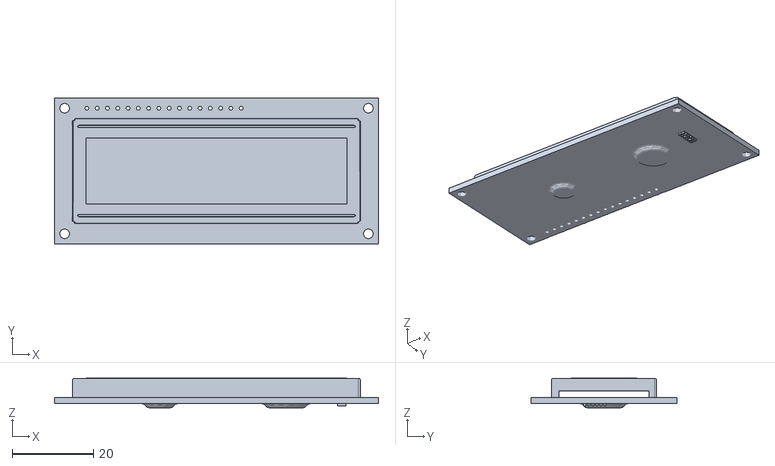
[picture p161: CAD file, 2026-06-25]
Obudowa_do_MCP_I2C_SPI/LCD16x2.stl
80.0 x 36.0 x 7.30
