rryske2001/praca-magisterska/Obudowa_do_modulu_dwa_PCF/QP5522 Jaycar 20x4 LCD Module v14.step

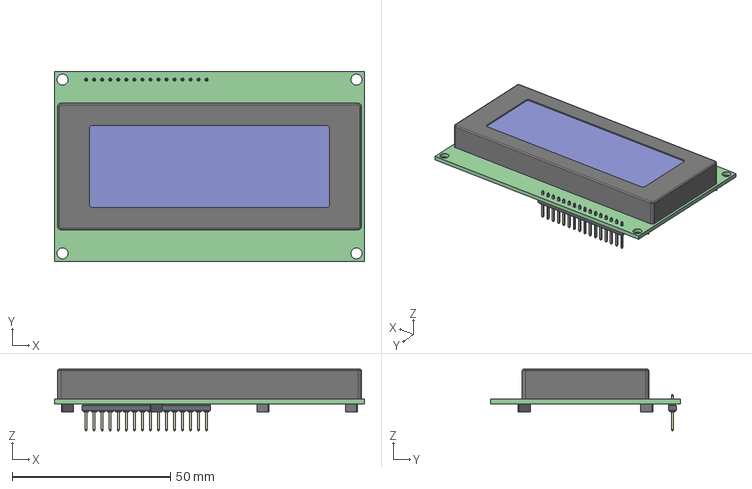
[picture p162: CAD file, 2026-06-25]
Obudowa_do_modulu_dwa_PCF/QP5522 Jaycar 20x4 LCD Module v14.step
98.0 x 60.0 x 19.5 mm
