rryske2001/praca-magisterska/Obudowa_do_MCP_I2C_SPI/MCP_I2C_SPI.step

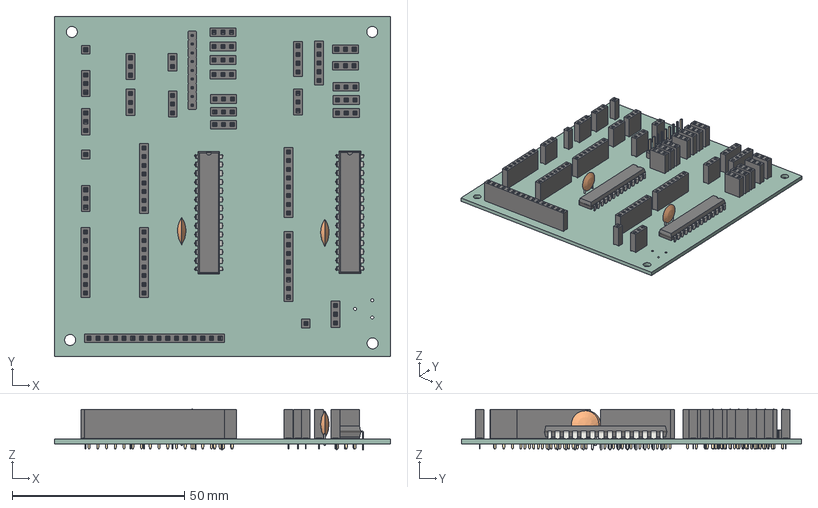
[picture p163: CAD file, 2026-06-25]
Obudowa_do_MCP_I2C_SPI/MCP_I2C_SPI.step
97.7 x 98.8 x 11.8 mm
PinSocket_1x08_P2.54mm_Vertical x 5
PinSocket_1x03_P2.54mm_Vertical x 20
C_Disc_D8.0mm_W2.5mm_P5.00mm x 2
PinSocket_1x01_P2.54mm_Vertical x 3
PinSocket_1x05_P2.54mm_Vertical
DIP-28_W7.62mm x 2
PinSocket_1x02_P2.54mm_Vertical
PinSocket_1x16_P2.54mm_Vertical
PinSocket_1x04_P2.54mm_Vertical
PinHeader_1x09_P2.54mm_Vertical
MCP_I2C_SPI_PCB
