rryske2001/praca-magisterska/Obudowa_do_modulu_dwa_PCF/projekt_modul_systemowy_dwa_pcf.step

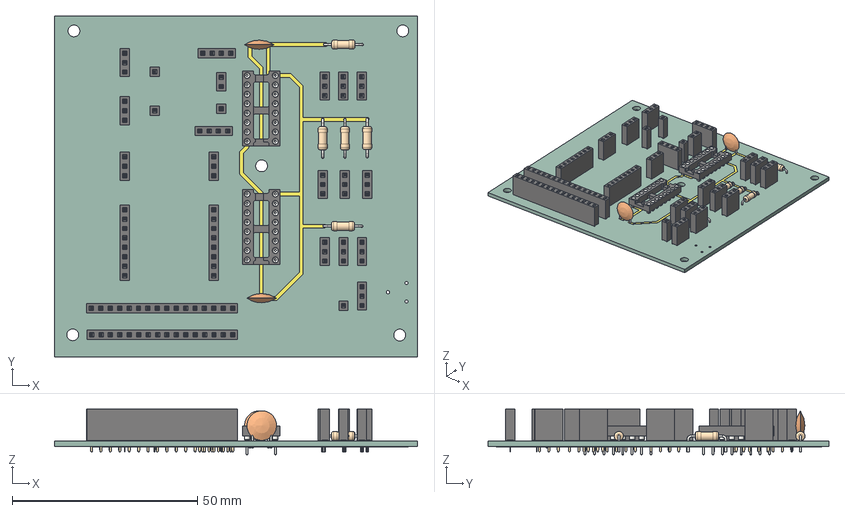
[picture p164: CAD file, 2026-06-23]
Obudowa_do_modulu_dwa_PCF/projekt_modul_systemowy_dwa_pcf.step
98.0 x 92.0 x 12.3 mm
R_Axial_DIN0207_L6.3mm_D2.5mm_P10.16mm_Horizontal x 5
PinSocket_1x03_P2.54mm_Vertical x 14
PinSocket_1x04_P2.54mm_Vertical x 2
PinSocket_1x16_P2.54mm_Vertical x 2
PinSocket_1x01_P2.54mm_Vertical x 4
DIP-16_W7.62mm_Socket x 2
PinSocket_1x08_P2.54mm_Vertical x 2
C_Disc_D8.0mm_W2.5mm_P5.00mm x 2
PinSocket_1x02_P2.54mm_Vertical
projekt_modul_systemowy_dwa_pcf_copper
projekt_modul_systemowy_dwa_pcf_PCB
