rryske2001/praca-magisterska/Obudowa_do_MCP_I2C_SPI/obudowa_MCP_I2C_SPI.FCStd

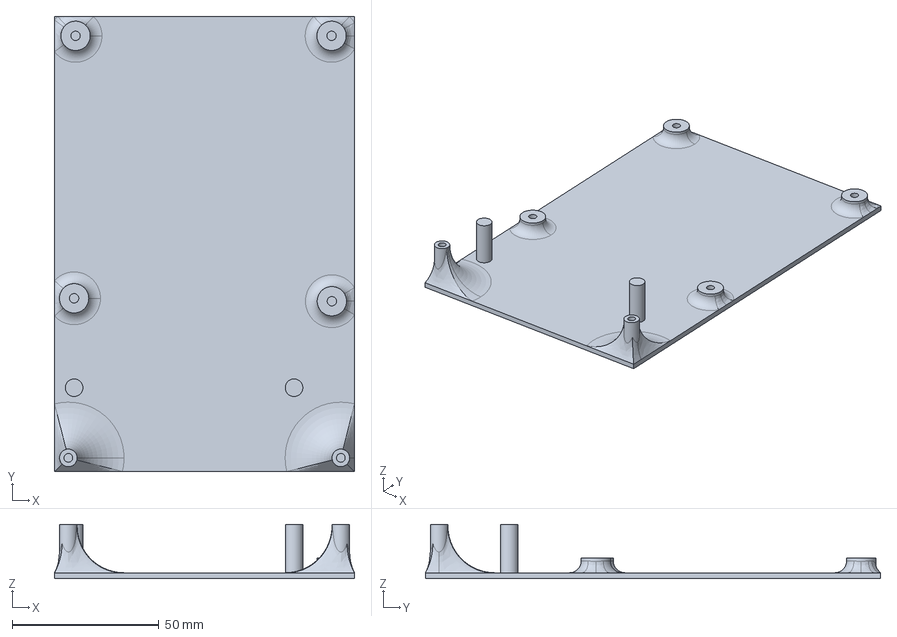
[picture p165: CAD file, 2026-06-25, an earlier design]
Obudowa_do_MCP_I2C_SPI/obudowa_MCP_I2C_SPI.FCStd
102.3 x 155.2 x 18.5 mm
