rryske2001/praca-magisterska/(list of files, cad)

Other CAD files:
Obudowa_do_MCP_I2C_SPI/obudowa_MCP_I2C_SPI_V2.FCStd
Obudowa_do_modulu_dwa_PCF/obudowa_do_modulu_dwa_PCF.FCStd
obudowa_moduł_PCF/obudowa_PCF.stl
