rryske2001/praca-magisterska/MCP_I2C/testy_I2C_AVR.xlsx

zasilanie 5V | rezystor 1kOhm | 5 mA | zasilanie 5V | rezystor 1kOhm | 5 mA
długość kabla [m] | czestotliowsc [Hz] | czy działa [tak/nie] | długość kabla [m] | czestotliowsc [Hz] | czy działa [tak/nie]
5 | 100000 | tak | 7 | 100000 | tak
5 | 200000 | tak | 7 | 200000 | tak
5 | 300000 | tak | 7 | 300000 | nie
5 | 400000 | tak | 7 | 400000 | nie
5 | 500000 | tak | 7 | 500000 | nie
5 | 600000 | tak | 7 | 600000 | nie
5 | 700000 | tak | 7 | 700000 | nie
5 | 800000 | tak | 7 | 800000 | nie
5 | 900000 | nie | 7 | 900000 | nie
5 | 1000000 | nie | 7 | 1000000 | nie
zasilanie 5V | rezystor 1kOhm | 5 mA | zasilanie 5V | rezystor 1kOhm | 5 mA
długość kabla [m] | czestotliowsc [Hz] | czy działa [tak/nie] | długość kabla [m] | czestotliowsc [Hz] | czy działa [tak/nie]
3 | 100000 | tak | 10 | 100000 | tak
3 | 200000 | tak | 10 | 200000 | tak
3 | 300000 | tak | 10 | 300000 | nie
3 | 400000 | tak | 10 | 400000 | nie
3 | 500000 | tak | 10 | 500000 | nie
3 | 600000 | tak | 10 | 600000 | nie
3 | 700000 | tak | 10 | 700000 | nie
3 | 800000 | tak | 10 | 800000 | nie
3 | 900000 | nie | 10 | 900000 | nie
3 | 1000000 | nie | 10 | 1000000 | nie
zasilanie 5V | rezystor 1kOhm | 5 mA
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
