rryske2001/praca-magisterska/Testy_na_wyswietlaczu_7_seg/kod_test_na_wysw_7segm.png

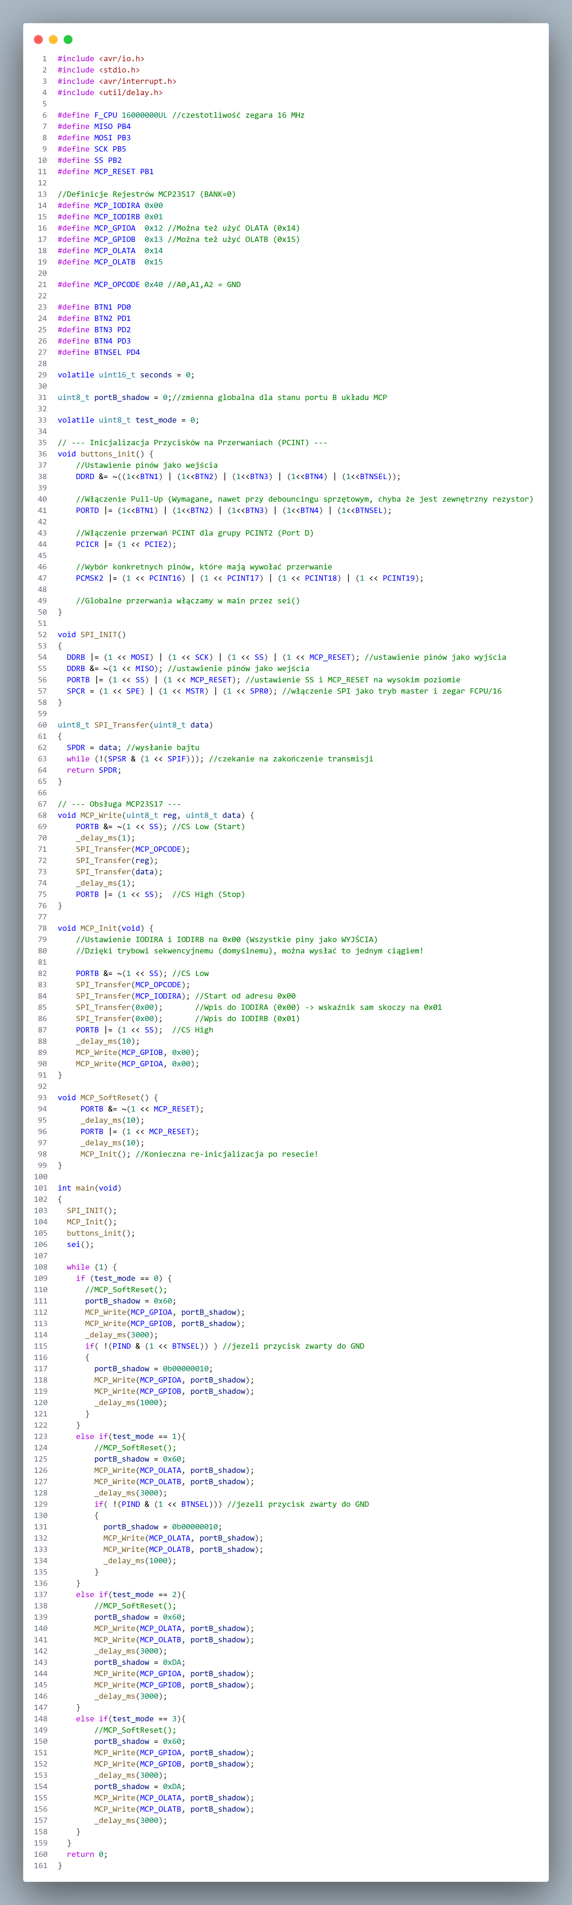
Testy_na_wyswietlaczu_7_seg/kod_test_na_wysw_7segm.png
