rryske2001/praca-magisterska/wyswietlacz_interfejs_szer_4bit/kod_testowy_pcf_4bitBS.png

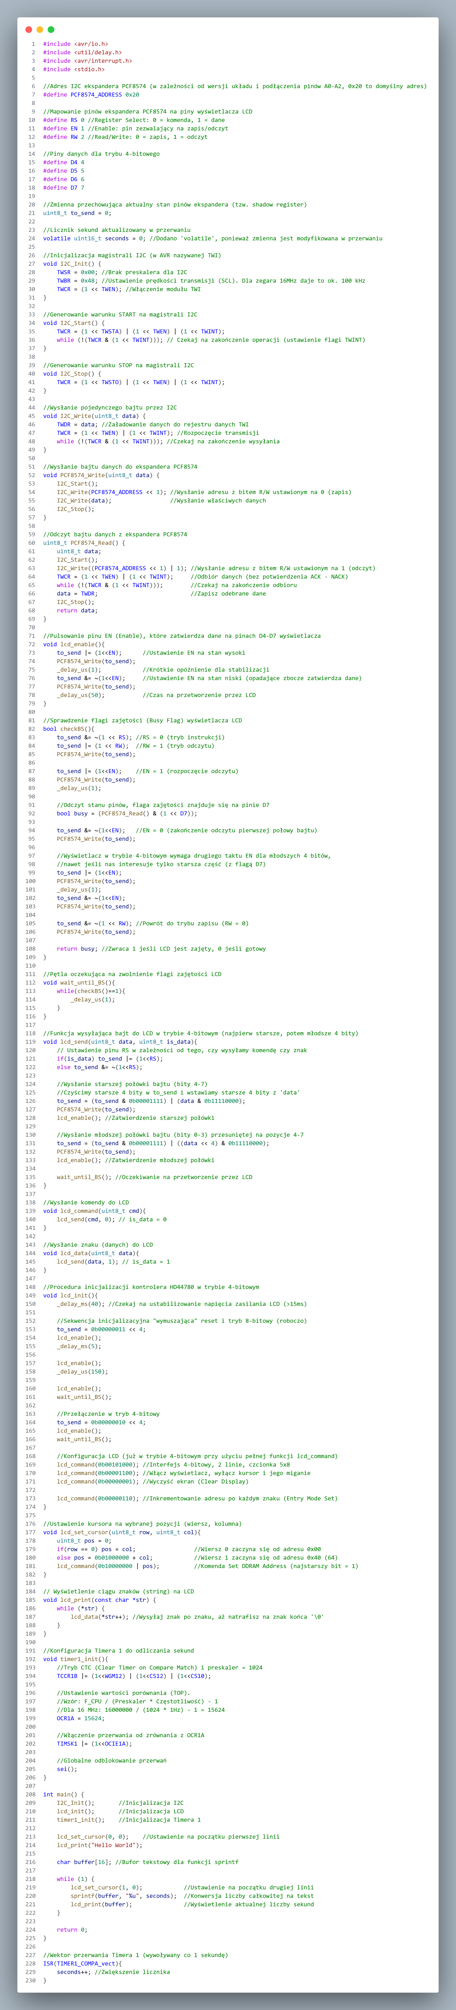
wyswietlacz_interfejs_szer_4bit/kod_testowy_pcf_4bitBS.png
