rryske2001/praca-magisterska/MCP_I2C_SPI_alternatywna_V11/plots/MCP_I2C_SPI_V12(final).pdf

# J24 C2 100n J21 V0

## J65SIL9

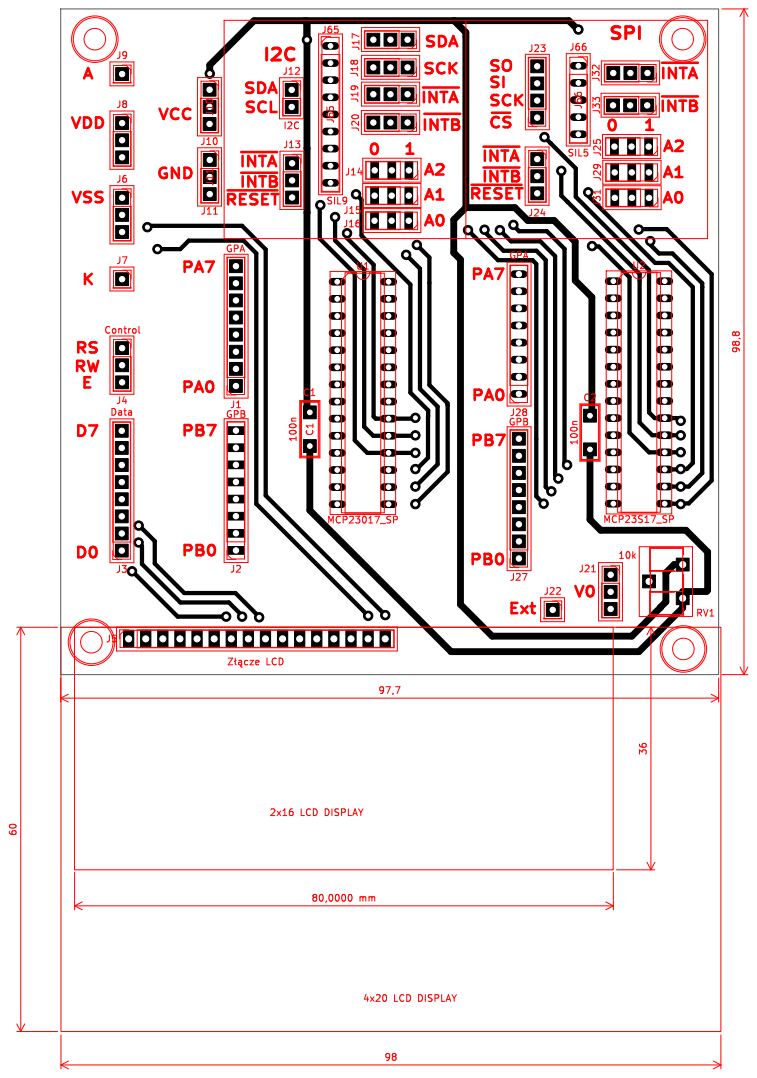
[picture p172: page 1]

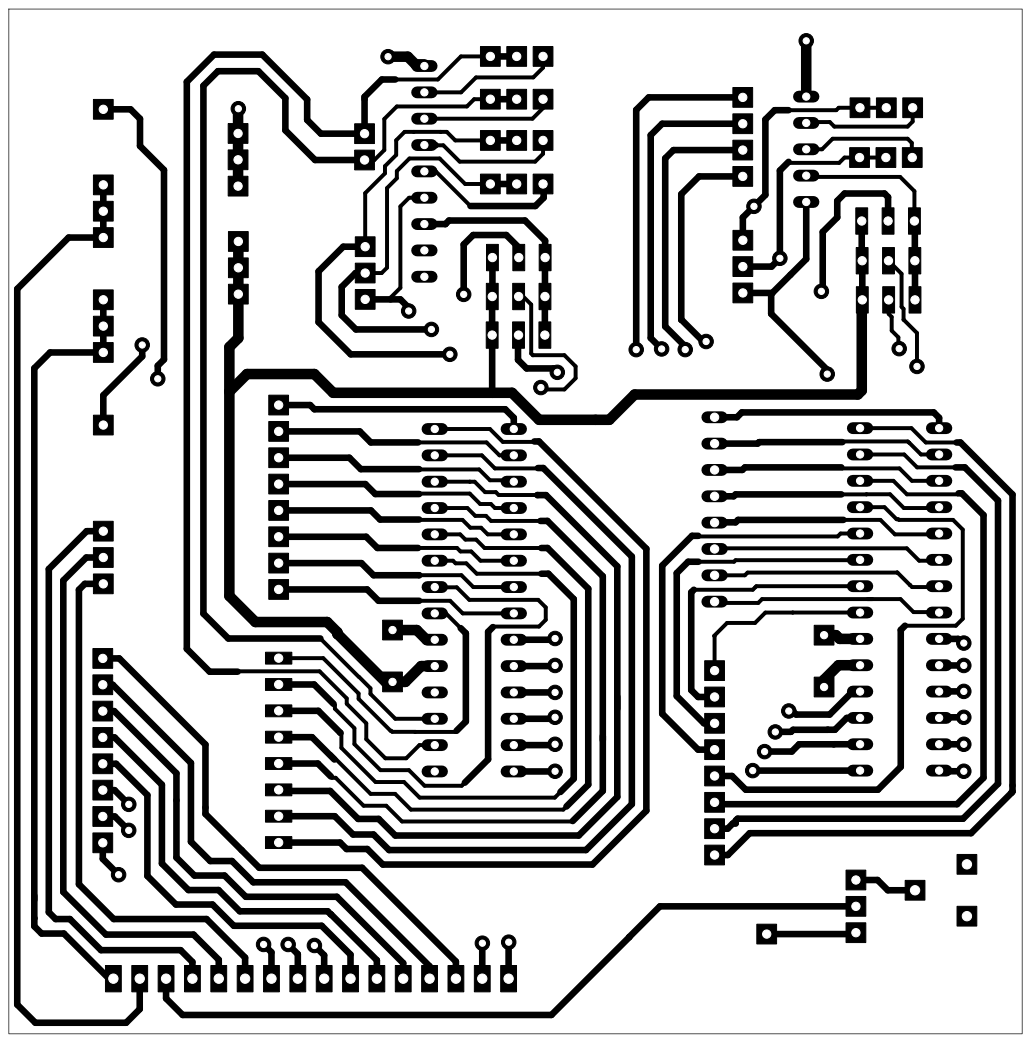
[picture p173: page 2]
D Date: KiCad; E.D.A. 9.0.2 Size: A4; Rev:; Id: /1 Title: File: MCP_I2C_SPI.kicad_pcb Sheet: Black; And; White; BOT Board2Pdf:; Black; BOT -; Page 2/2
