rryske2001/praca-magisterska/MCP_I2C_SPI/plots/MCP_I2C_SPI_PCB_V10.pdf

J66 | RV1
J24 | C2

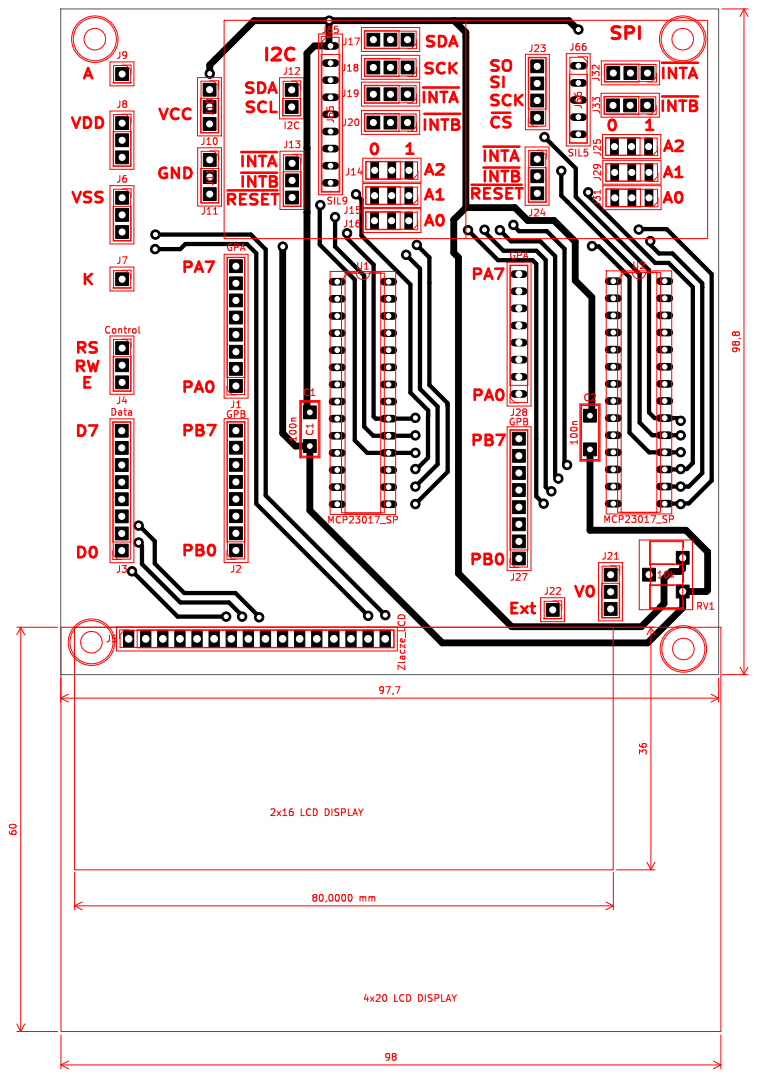
[picture p174: page 1]

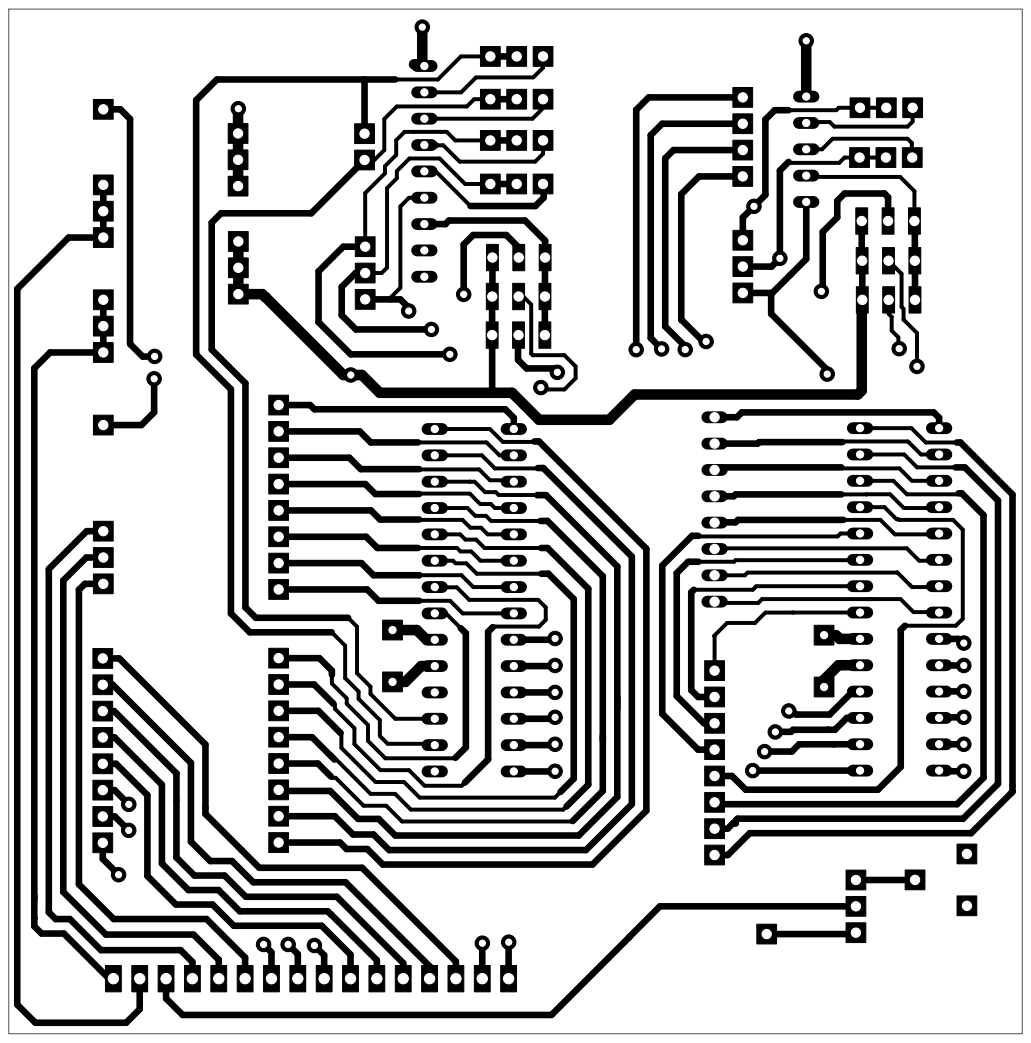
[picture p175: page 2]
D Date: KiCad; E.D.A. 9.0.2 Size: A4; Rev:; Id: /1 Title: File: MCP_I2C_SPI.kicad_pcb Sheet: Black; And; White; BOT Board2Pdf:; Black; BOT -; Page 2/2
