rryske2001/praca-magisterska/płytka_MCP_I2C/plots/płytka_MCP_I2C_V3_frez.pdf

80 | 36
J9 | VSS

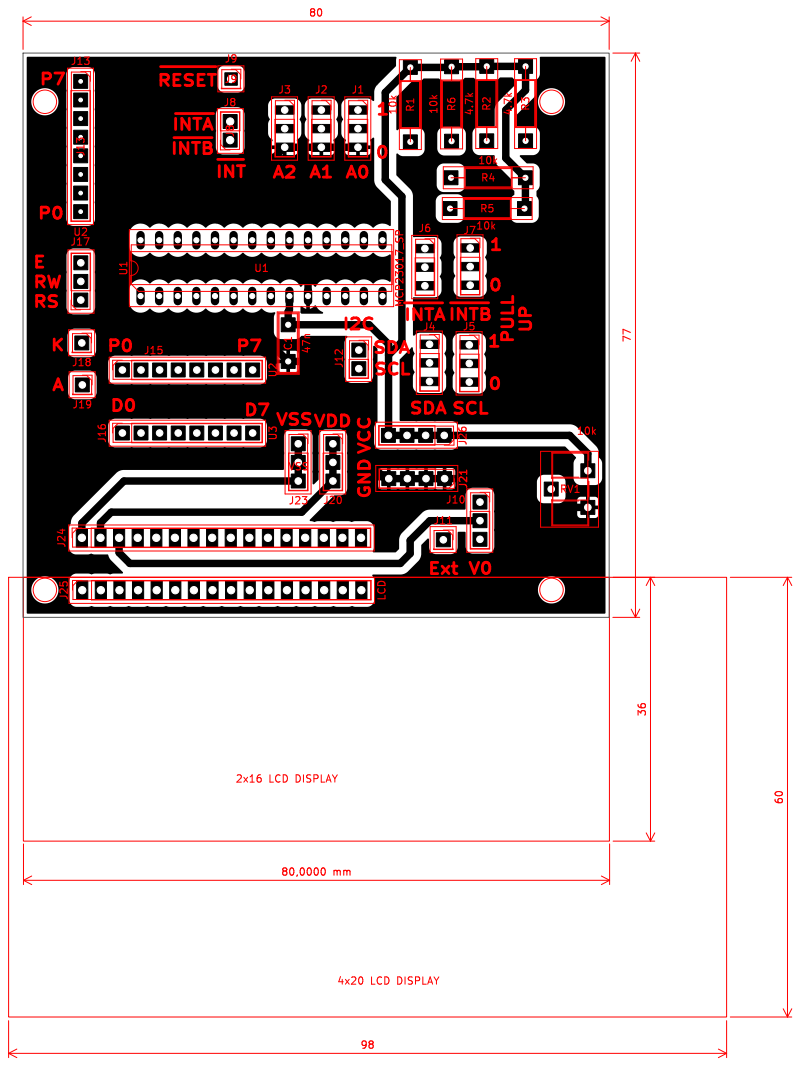
[picture p178: page 1]

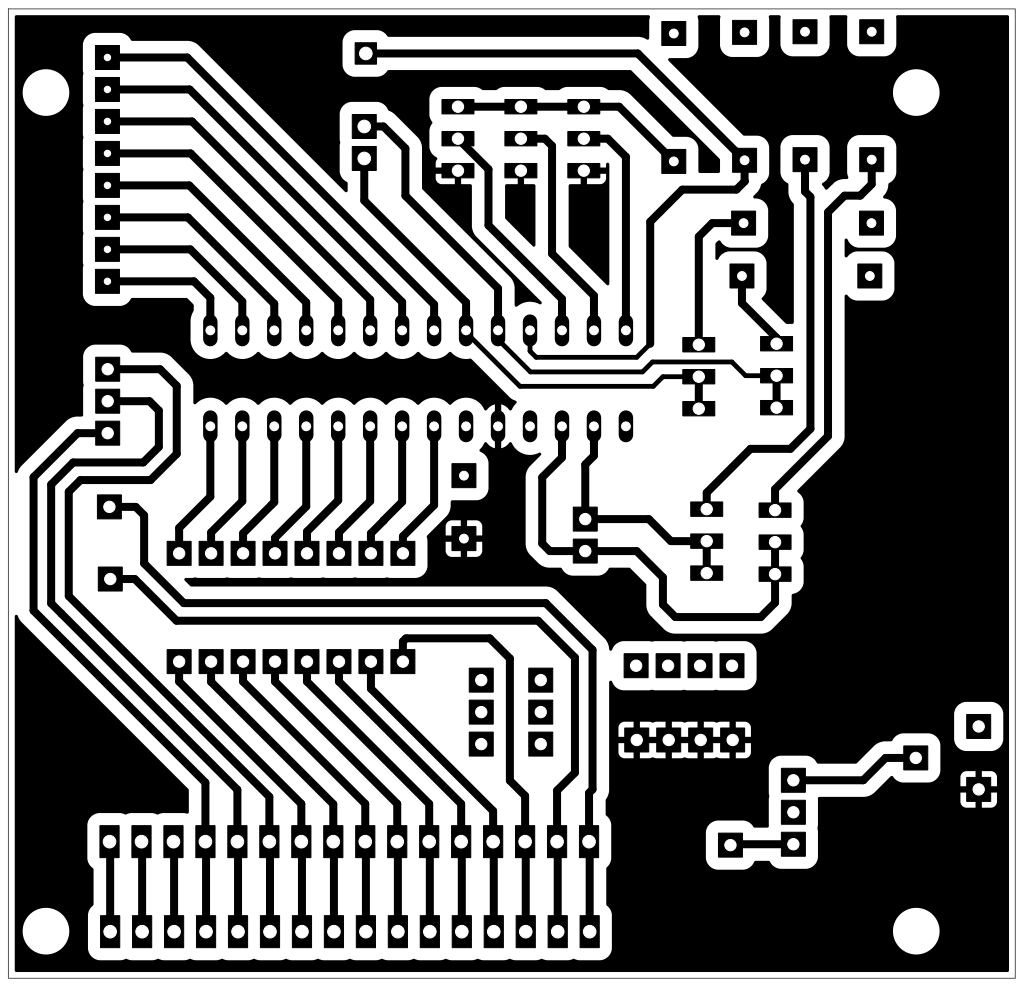
[picture p179: page 2]
D Date: KiCad; E.D.A. 9.0.2 Size: A4; Rev:; Id: /1 Title: File: þÿpBytka_MCP_I2C.kicad_pcb Sheet: Black; And; White; BOT Board2Pdf:; Black; BOT -; Page 2/2
