rryske2001/praca-magisterska/płytka_MCP_SPI_frez/plots/płytka_MCP_SPI_PCB.pdf

J1 A0

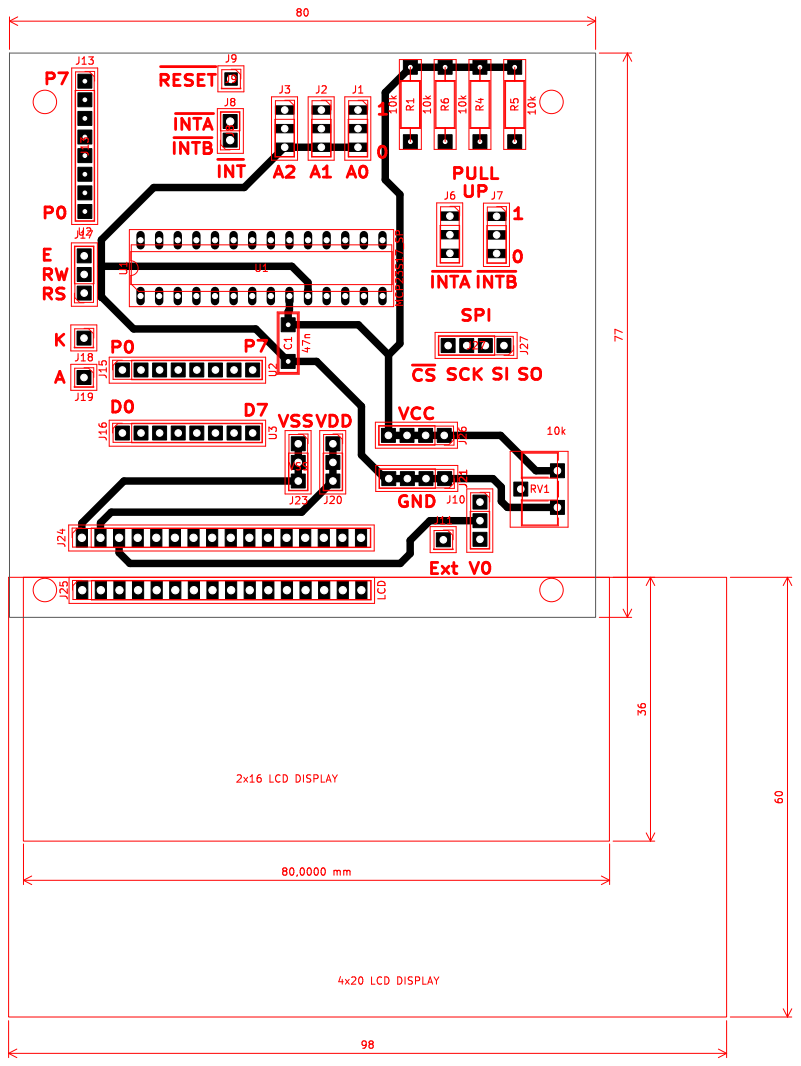
[picture p182: page 1]

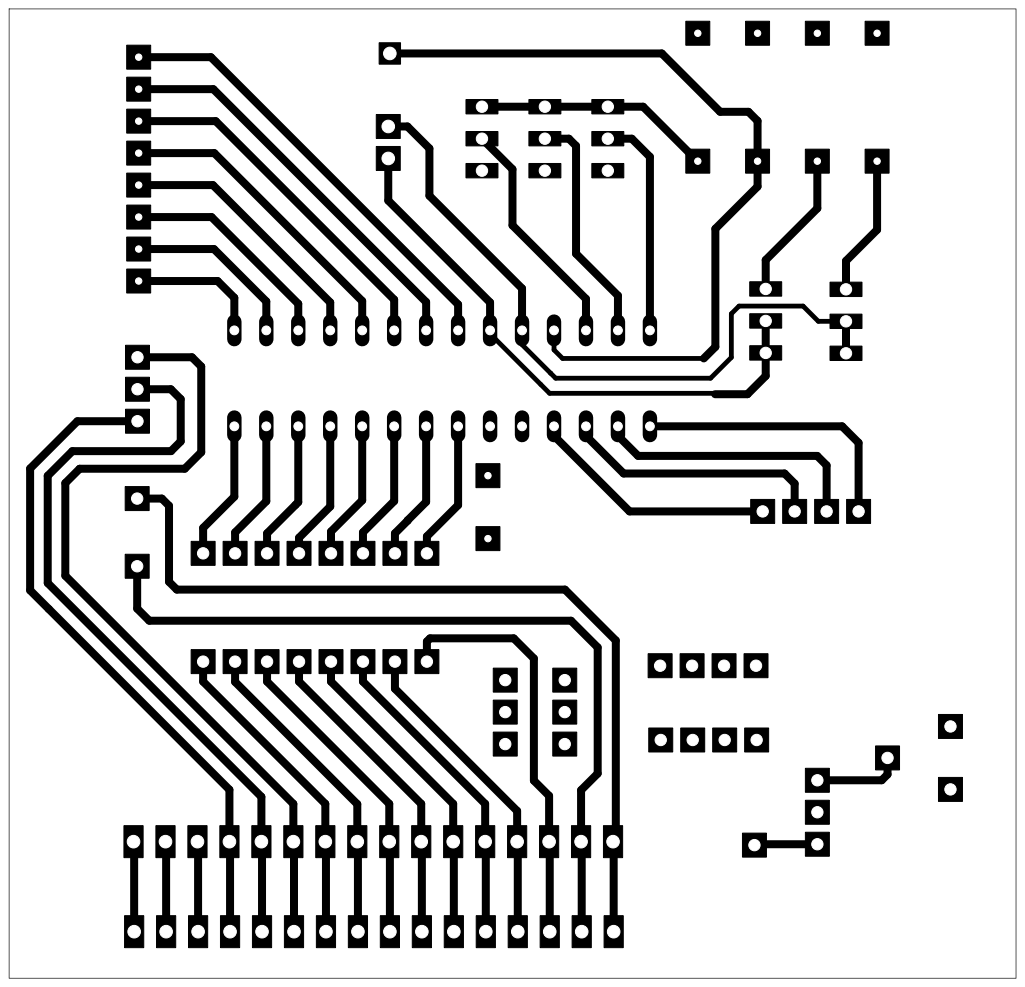
[picture p183: page 2]
D Date: KiCad; E.D.A. 9.0.2 Size: A4; Rev:; Id: /1 Title: File: þÿpBytka_MCP_SPI.kicad_pcb Sheet: Black; And; White; BOT Board2Pdf:; Black; BOT -; Page 2/2
