rryske2001/praca-magisterska/płytka_MCP_I2C/plots/płytka_MCP_I2C_PCB_V2.pdf

J9 | VSS
10k R5 ⁴.7k | R² C¹ | 47n | J21 LCD ¹⁰k | R¹ U²

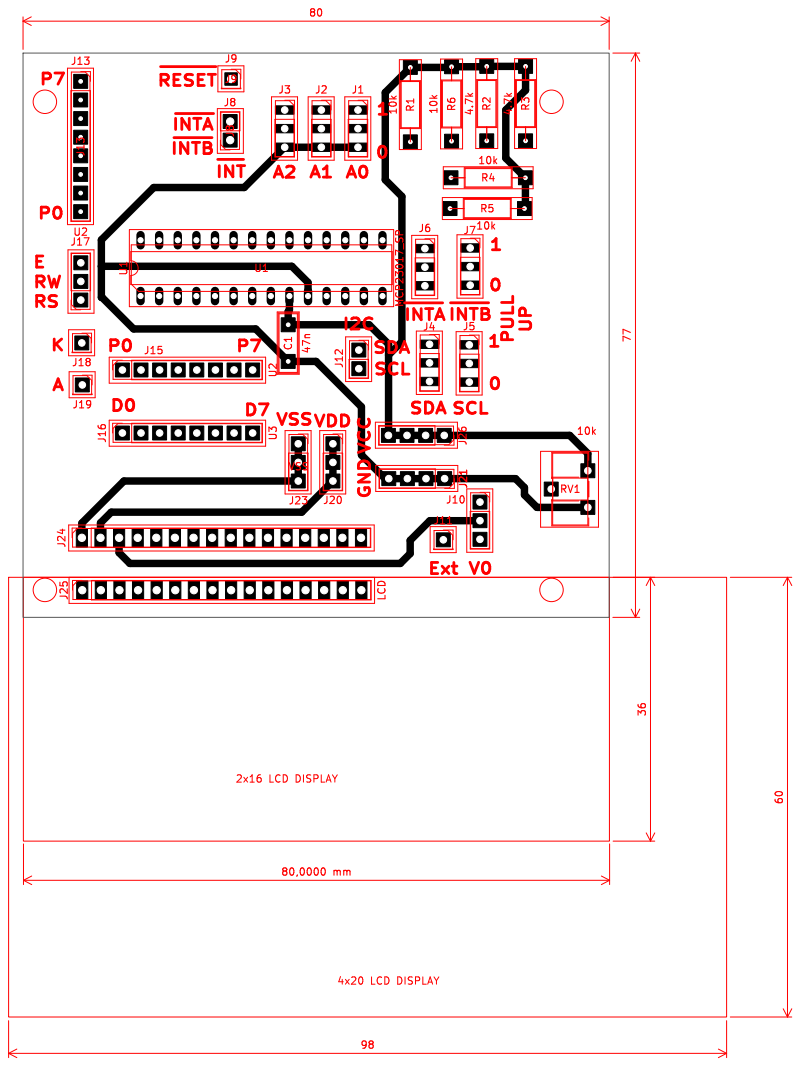
[picture p184: page 1]

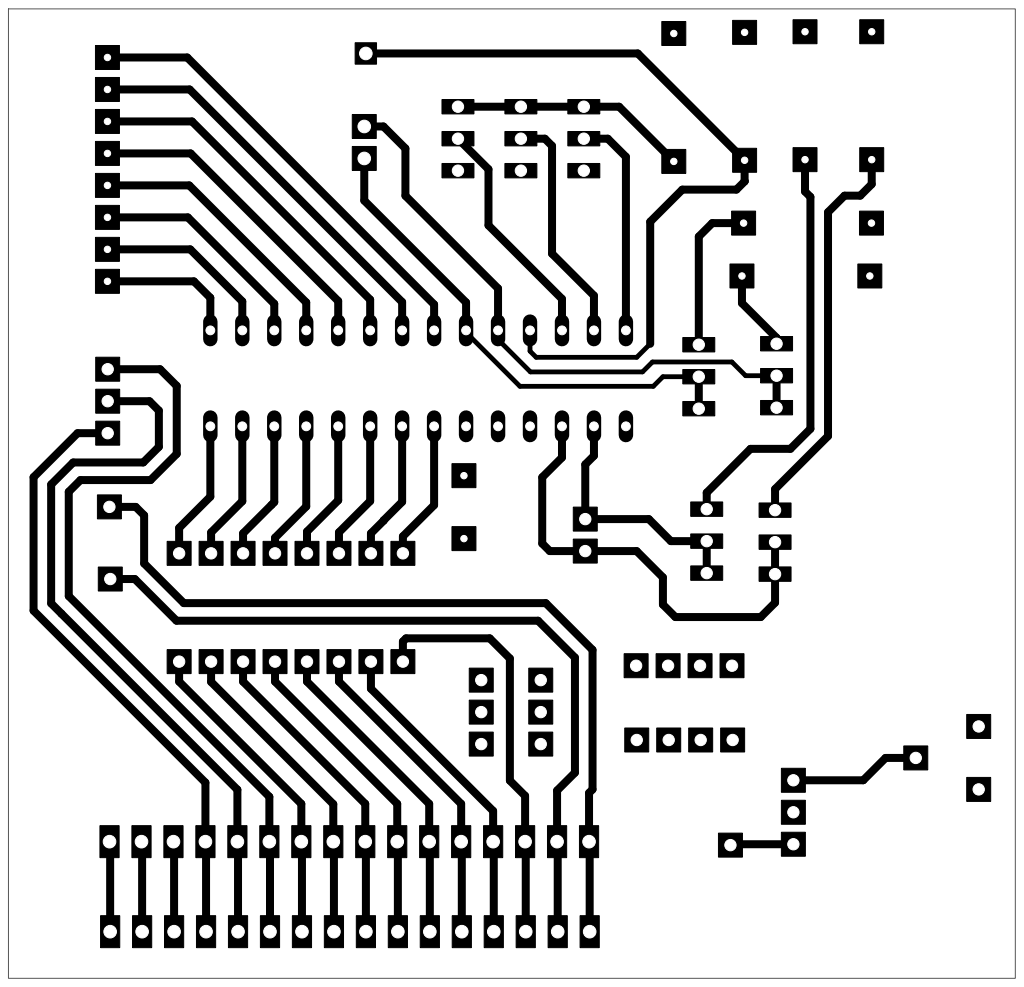
[picture p185: page 2]
D Date: KiCad; E.D.A. 9.0.2 Size: A4; Rev:; Id: /1 Title: File: þÿpBytka_MCP_I2C.kicad_pcb Sheet: Black; And; White; BOT Board2Pdf:; Black; BOT -; Page 2/2
