rryske2001/praca-magisterska/MCP_I2C_SPI_alternatywna_V9/plots/MCP_I2C_SPI_PCB_V9.pdf

1 | 2 | 3 | 4 | 5 | 6

A

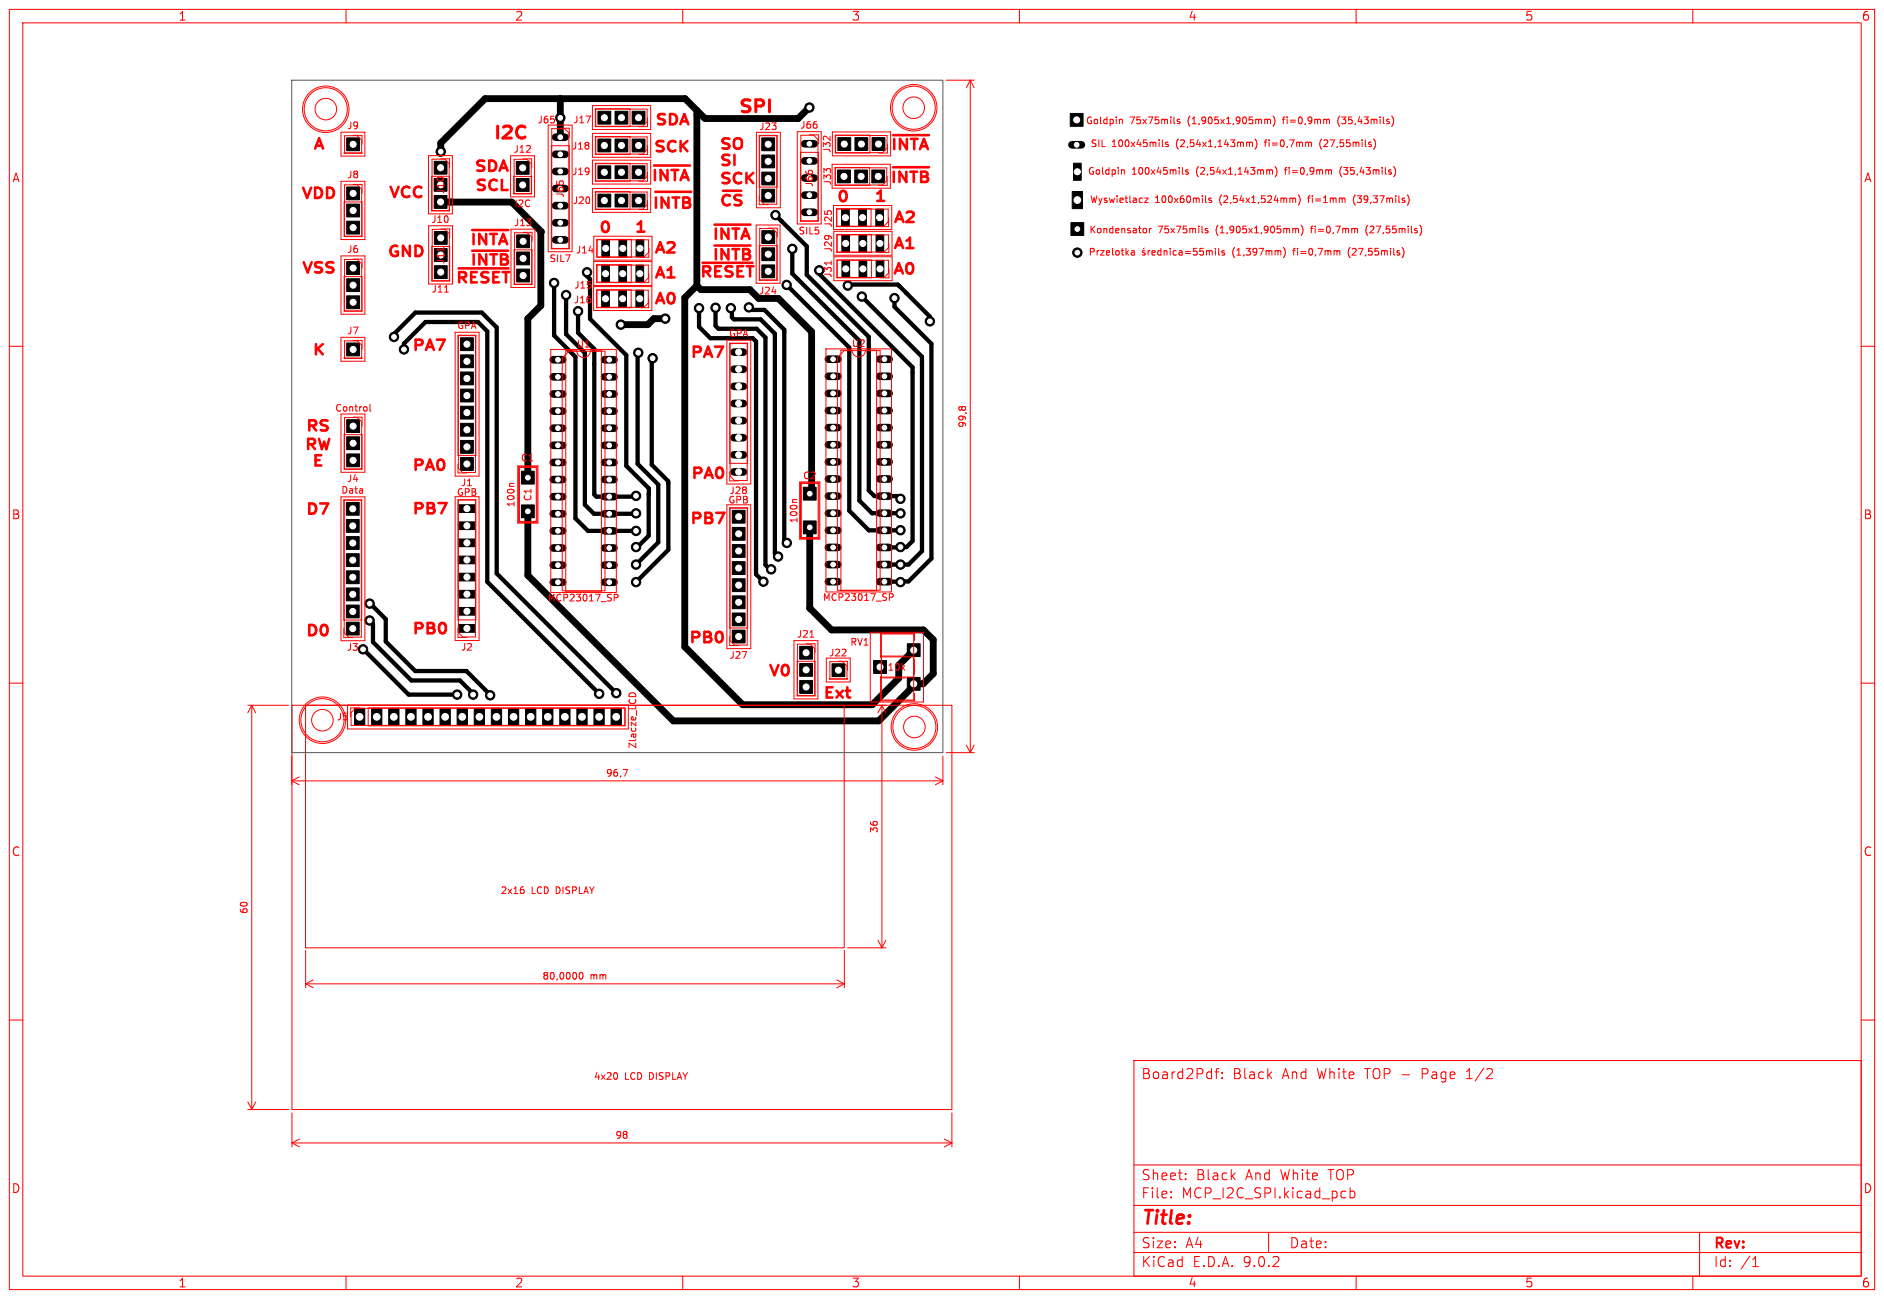
[picture p194: page 1]

1 | 2 | 3 | 4 | 5 | 6

A

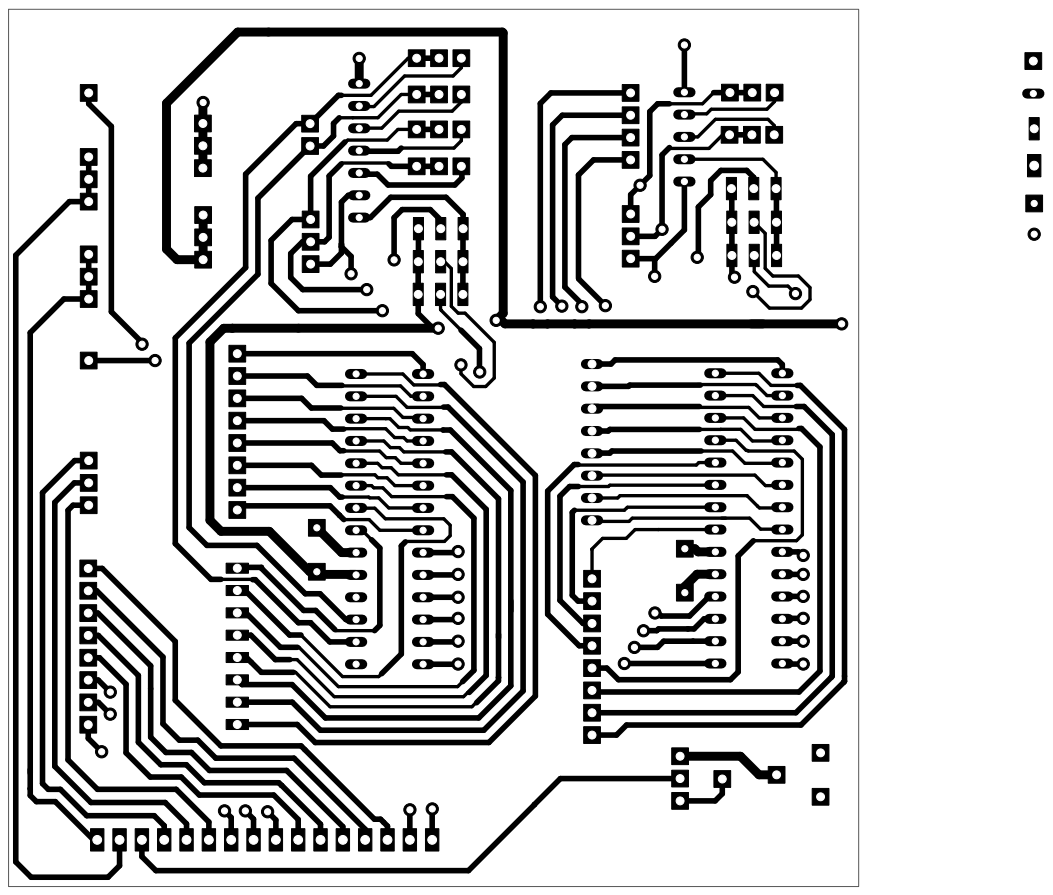
[picture p195: page 2]
D Date: KiCad; E.D.A. 9.0.2 Size: A4; Rev:; Id: /1 Title: File: MCP_I2C_SPI.kicad_pcb Sheet: Black; And; White; BOT Board2Pdf:; Black; BOT -; Page 2/2
