rryske2001/praca-magisterska/MCP_I2C_SPI_alternatywna_V11/plots/MCP_I2C_SPI_PCB_V4.pdf

# J18 SCK

# J17 SDA

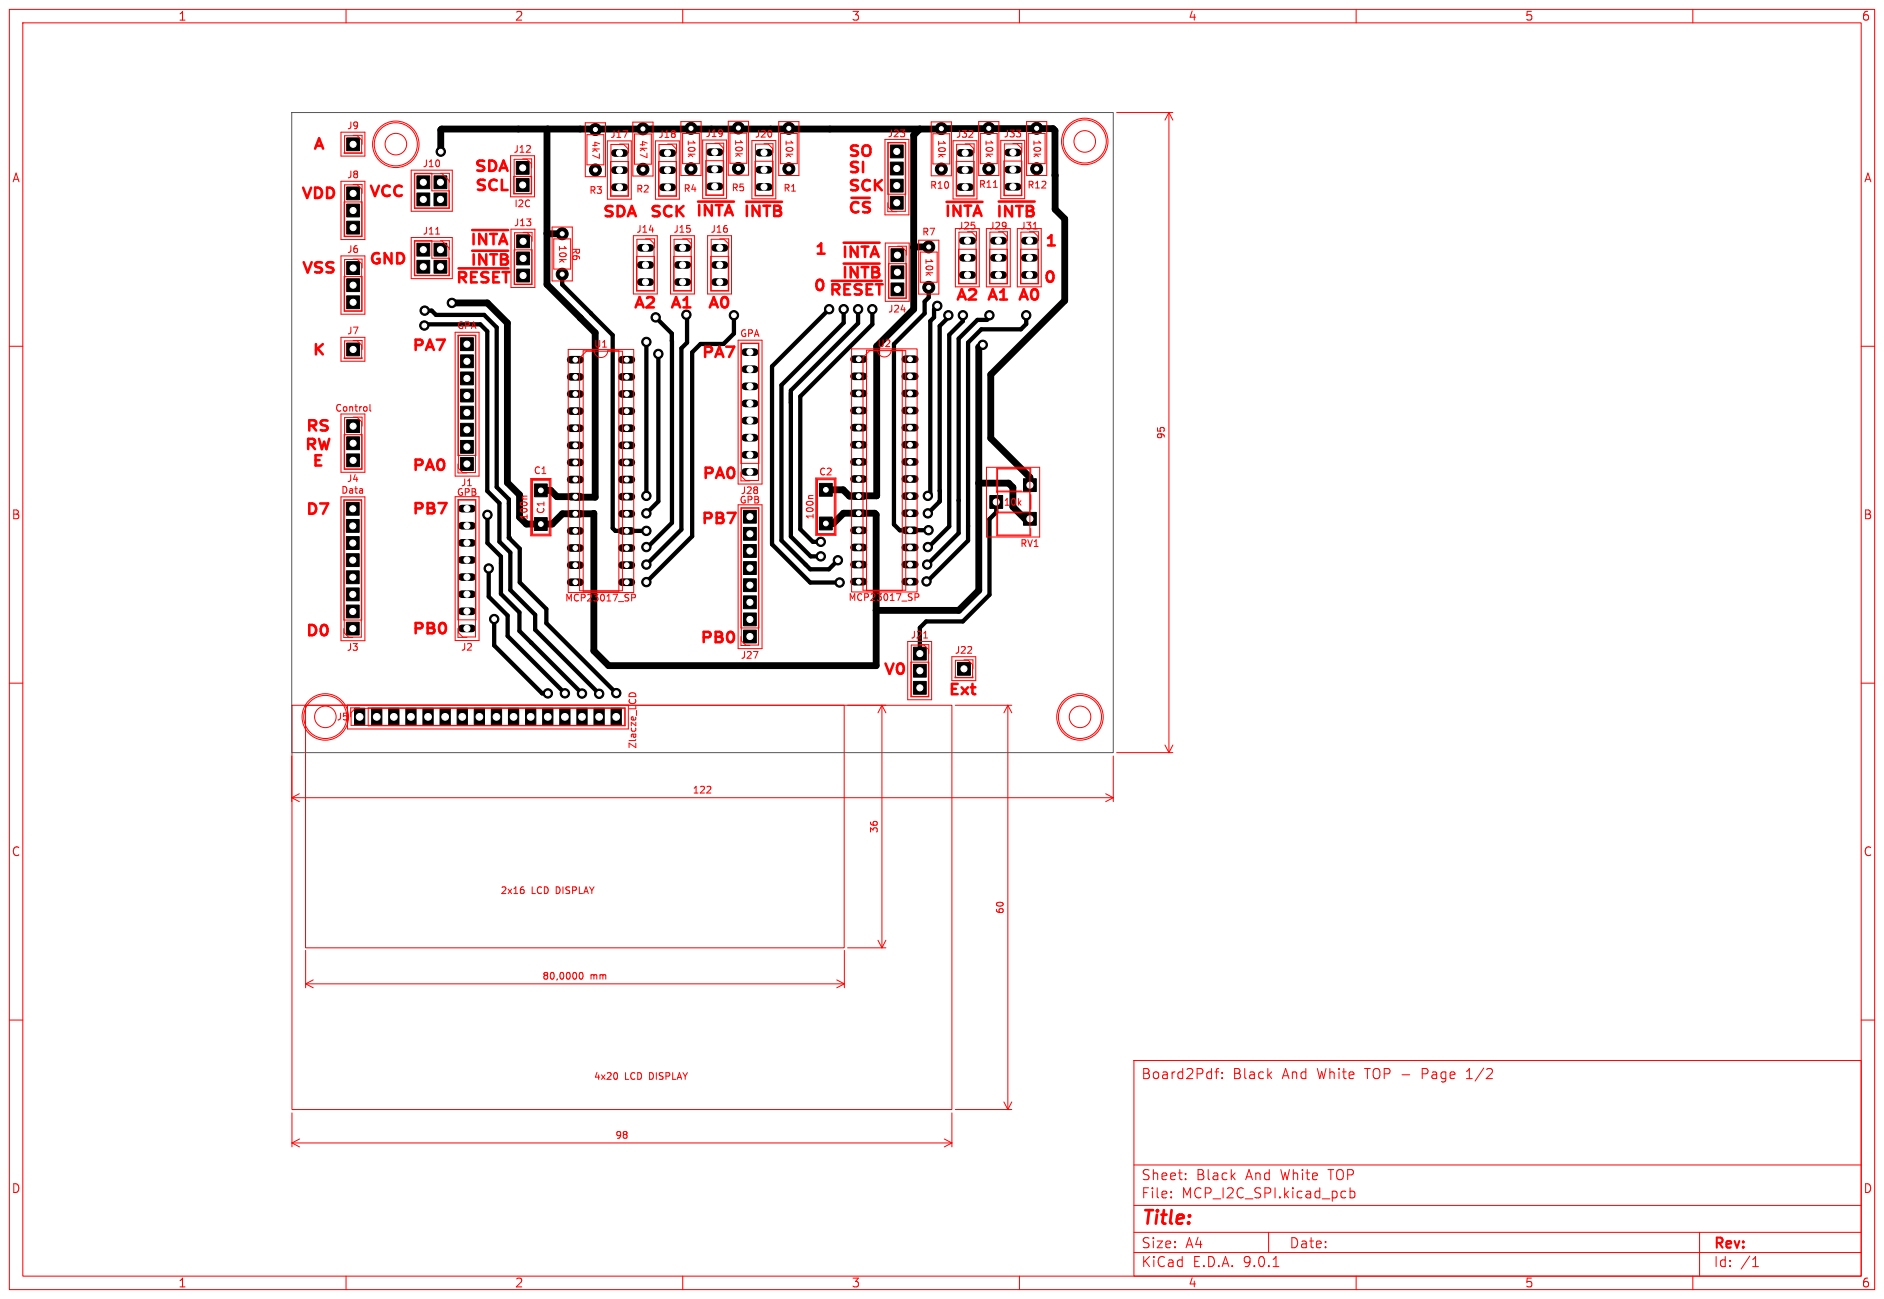
[picture p202: page 1]

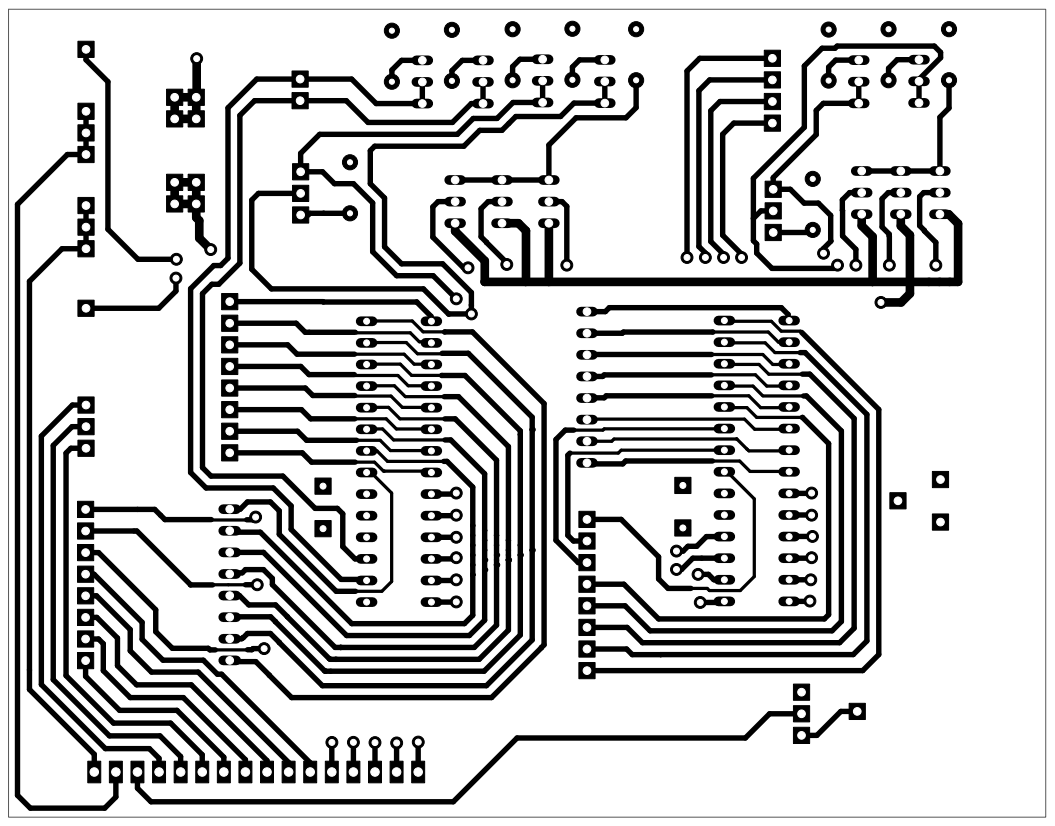
[picture p203: page 2]
D Date: KiCad; E.D.A. 9.0.1 Size: A4; Rev:; Id: /1 Title: File: MCP_I2C_SPI.kicad_pcb Sheet: Black; And; White; BOT Board2Pdf:; Black; BOT -; Page 2/2
