rryske2001/praca-magisterska/płytka_MCP_I2C_v1/plots/płytka_MCP_I2C_PCB.pdf

J3 A2

# J8 U¹

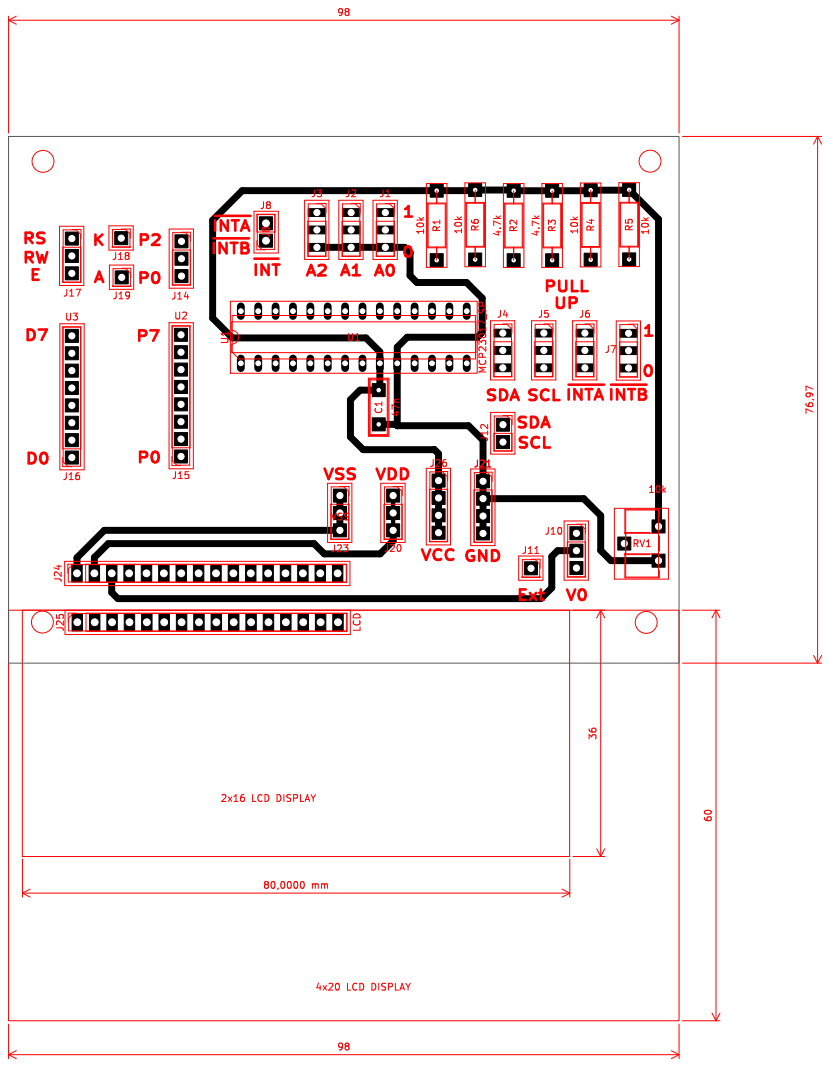
[picture p210: page 1]

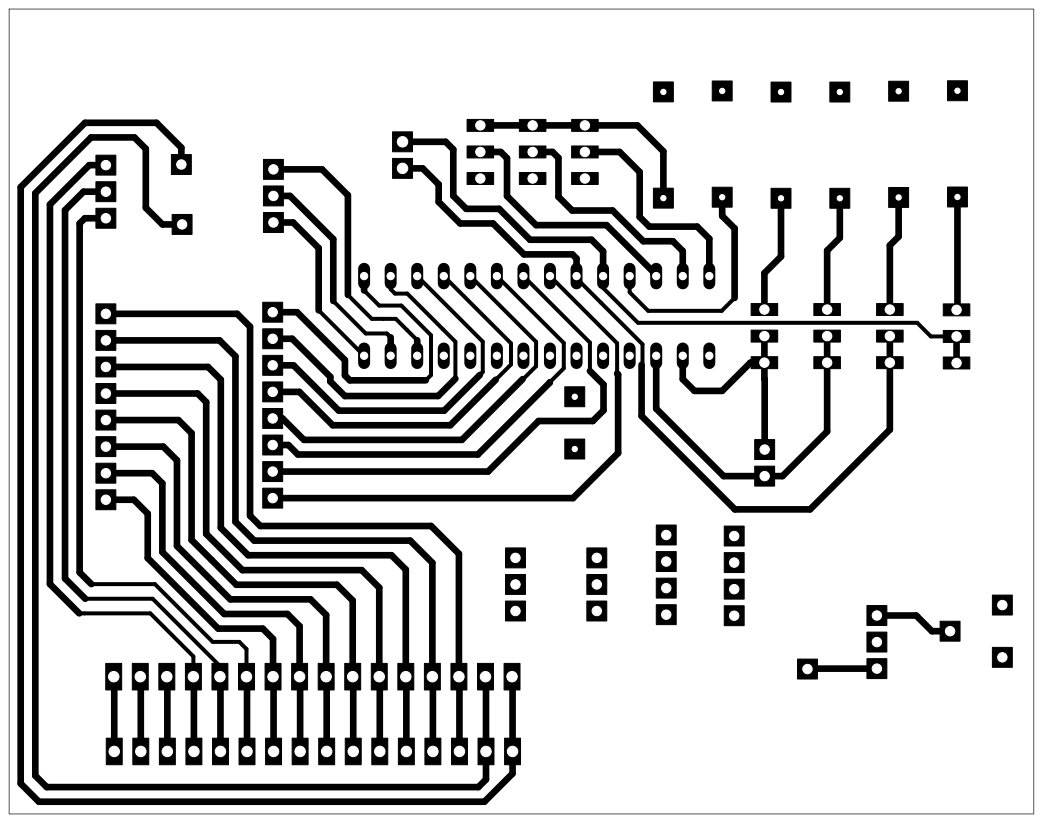
[picture p211: page 2]
D Date: KiCad; E.D.A. 9.0.2 Size: A4; Rev:; Id: /1 Title: File: þÿpBytka_MCP_I2C.kicad_pcb Sheet: Black; And; White; BOT Board2Pdf:; Black; BOT -; Page 2/2
