rryske2001/praca-magisterska/projekt_modul_systemowy_dwa_pcf_wersja_frezowanie/plots/old/projekt_modul_systemowy_dwa_pcf_v10.pdf

98 | 36 | 92 60
10k R1 4.7k | R³

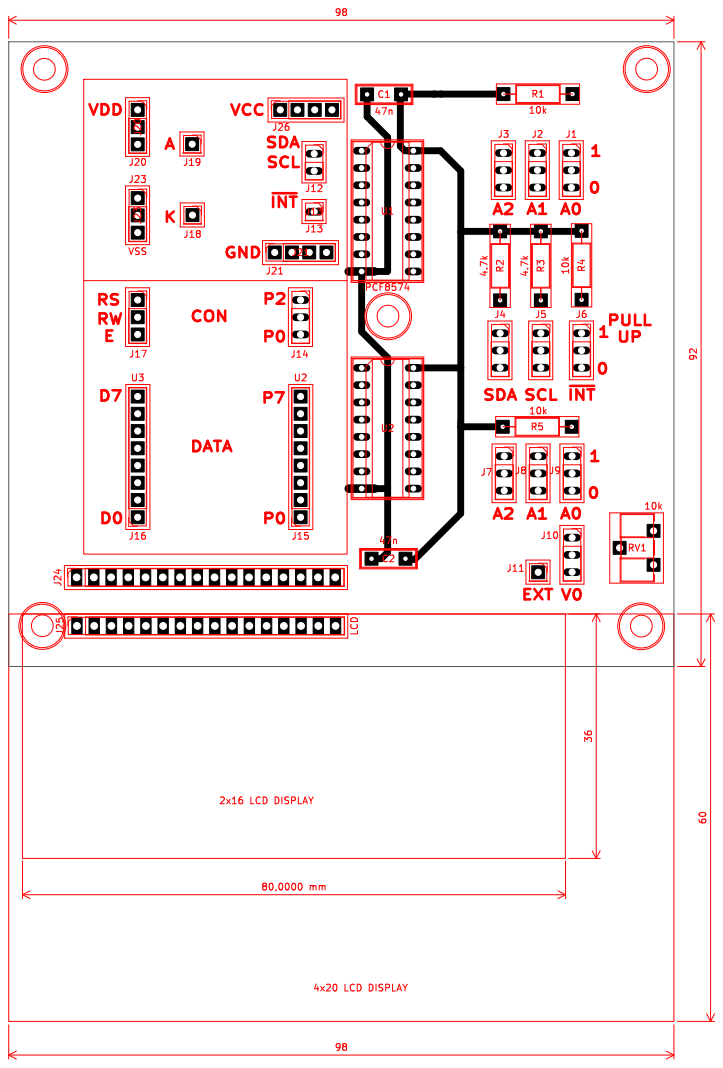
[picture p220: page 1]

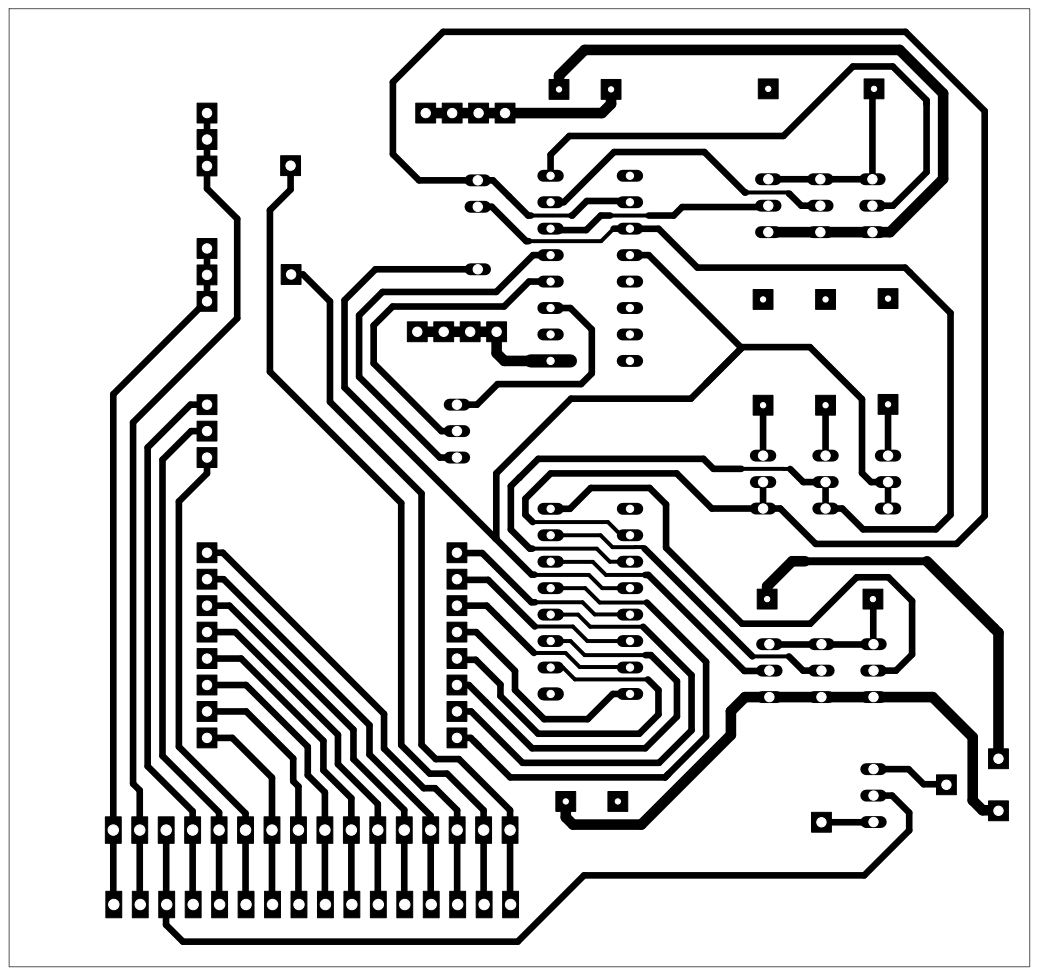
[picture p221: page 2]
D Date: KiCad; E.D.A. 9.0.2 Size: A4; Rev:; Id: /1 Title: File: projekt_modul_systemowy_dwa_pcf.kicad_pcb Sheet: Black; And; White; BOT Board2Pdf:; Black; BOT -; Page 2/2
