rryske2001/praca-magisterska/MCP_I2C_SPI_alternatywna_V11/MCP_I2C_SPI.kicad_pcb

## KiCad design MCP_I2C_SPI_alternatywna_V11/MCP_I2C_SPI.kicad_pcb (2026-06-28)

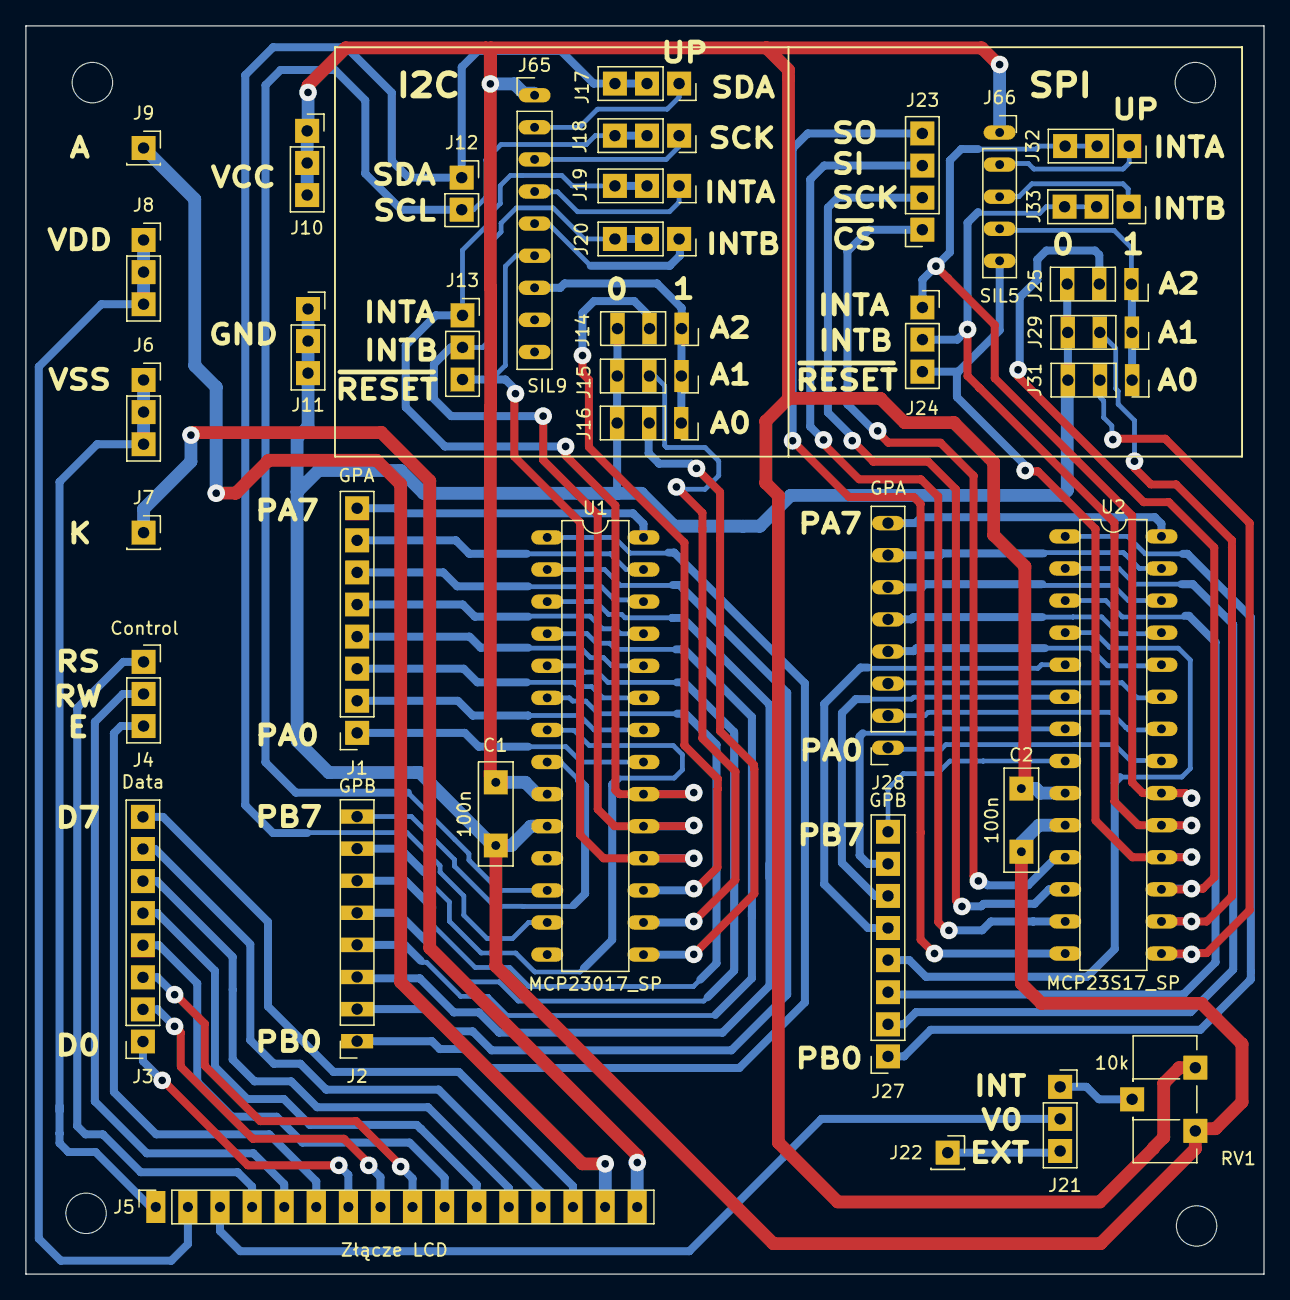
[picture p234: board MCP_I2C_SPI.kicad_pcb from above]

Board: 2 copper layers, 98.0 x 98.8 mm, 38 parts (0 on the bottom side), 78 nets.

Parts:
C1, C2: 100n; C_Disc_D8.0mm_W2.5mm_P5.00mm_kwadart
J1, J28: GPA; PinSocket_1x08_P2.54mm_Vertical_kwadrat
J2, J27: GPB; PinSocket_1x08_P2.54mm_Vertical_kwadrat
J3: Data; PinSocket_1x08_P2.54mm_Vertical_kwadrat
J4: Control; PinSocket_1x03_P2.54mm_Vertical
J5: Złącze LCD; PinSocket_1x16_P2.54mm_Vertical_kwadrat
J6: VSS; PinSocket_1x03_P2.54mm_Vertical
J7: K; PinSocket_1x01_P2.54mm_Vertical_kwadart
J8: VDD; PinSocket_1x03_P2.54mm_Vertical
J9: A; PinSocket_1x01_P2.54mm_Vertical_kwadart
J10: VCC; PinSocket_1x03_P2.54mm_Vertical
J11: GND; PinSocket_1x03_P2.54mm_Vertical
J12: I2C; PinSocket_1x02_P2.54mm_Vertical_square
J13: Interrupt0; PinSocket_1x03_P2.54mm_Vertical
J14, J25: A2; PinSocket_1x03_P2.54mm_Vertical
J15, J29: A1; PinSocket_1x03_P2.54mm_Vertical
J16, J31: A0; PinSocket_1x03_P2.54mm_Vertical
J17: SDA; PinSocket_1x03_P2.54mm_Vertical
J18: SCK; PinSocket_1x03_P2.54mm_Vertical
J19, J32: INTA; PinSocket_1x03_P2.54mm_Vertical
J20, J33: INTB; PinSocket_1x03_P2.54mm_Vertical
J21: V0; PinSocket_1x03_P2.54mm_Vertical
J22: EXT; PinSocket_1x01_P2.54mm_Vertical_kwadart
J23: SPI; PinSocket_1x04_P2.54mm_Vertical
J24: InterruptS; PinSocket_1x03_P2.54mm_Vertical
J65: SIL9; PinHeader_1x09_P2.54mm_Vertical
J66: SIL5; PinSocket_1x05_P2.54mm_Vertical
RV1: 10k; Potentiometer_ACP_CA9-H5_Horizontal_kwadrat
U1: MCP23017_SP; DIP-28_W7.62mm
U2: MCP23S17_SP; DIP-28_W7.62mm

Connections:
+5V: C1.1, C2.1, J10.1, J10.2, J10.3, J65.1, J66.1, RV1.3, U1.9 (VDD), U2.9 (VDD)
CS: J23.1, U2.11 (~CS)
GND: C1.2, C2.2, J11.1, J11.2, J11.3, J14.3, J15.3, J16.3, J25.3, J29.3, J31.3, RV1.1, U1.10 (VSS), U2.10 (VSS)
INTA0: J13.1, J19.2, J19.3, U1.20 (INTA)
INTAS: J24.1, J32.2, J32.3, U2.20 (INTA)
INTB0: J13.2, J20.2, J20.3, U1.19 (INTB)
INTBS: J24.2, J33.2, J33.3, U2.19 (INTB)
unnamed: J1.1, U1.21 (GPA0)
unnamed: J1.2, U1.22 (GPA1)
unnamed: J1.3, U1.23 (GPA2)
unnamed: J1.4, U1.24 (GPA3)
unnamed: J1.5, U1.25 (GPA4)
unnamed: J1.6, U1.26 (GPA5)
unnamed: J1.7, U1.27 (GPA6)
unnamed: J1.8, U1.28 (GPA7)
unnamed: J2.1, U1.1 (GPB0)
unnamed: J2.2, U1.2 (GPB1)
unnamed: J2.3, U1.3 (GPB2)
unnamed: J2.4, U1.4 (GPB3)
unnamed: J2.5, U1.5 (GPB4)
unnamed: J2.6, U1.6 (GPB5)
unnamed: J2.7, U1.7 (GPB6)
unnamed: J2.8, U1.8 (GPB7)
unnamed: J3.1, J5.7
unnamed: J3.2, J5.8
unnamed: J3.3, J5.9
unnamed: J3.4, J5.10
unnamed: J3.5, J5.11
unnamed: J3.6, J5.12
unnamed: J3.7, J5.13
unnamed: J3.8, J5.14
unnamed: J4.1, J5.4
unnamed: J4.2, J5.5
unnamed: J4.3, J5.6
unnamed: J5.1, J6.1, J6.2, J6.3
unnamed: J5.2, J8.1, J8.2, J8.3
unnamed: J5.15, J9.1
unnamed: J5.16, J7.1
unnamed: J14.1, J15.1, J16.1, J65.7
unnamed: J14.2, U1.17 (A2)
unnamed: J15.2, U1.16 (A1)
unnamed: J16.2, U1.15 (A0)
unnamed: J17.1, J65.2
unnamed: J18.1, J65.3
unnamed: J19.1, J65.4
unnamed: J20.1, J65.5
unnamed: J21.1, RV1.2
unnamed: J5.3, J21.2
unnamed: J21.3, J22.1
unnamed: J25.1, J29.1, J31.1, J66.4
unnamed: J25.2, U2.17 (A2)
unnamed: J27.1, U2.1 (GPB0)
unnamed: J27.2, U2.2 (GPB1)
unnamed: J27.3, U2.3 (GPB2)
unnamed: J27.4, U2.4 (GPB3)
unnamed: J27.5, U2.5 (GPB4)
unnamed: J27.6, U2.6 (GPB5)
unnamed: J27.7, U2.7 (GPB6)
unnamed: J27.8, U2.8 (GPB7)
unnamed: J28.1, U2.21 (GPA0)
unnamed: J28.2, U2.22 (GPA1)
unnamed: J28.3, U2.23 (GPA2)
unnamed: J28.4, U2.24 (GPA3)
unnamed: J28.5, U2.25 (GPA4)
unnamed: J28.6, U2.26 (GPA5)
unnamed: J28.7, U2.27 (GPA6)
unnamed: J28.8, U2.28 (GPA7)
unnamed: J29.2, U2.16 (A1)
unnamed: J31.2, U2.15 (A0)
unnamed: J32.1, J66.2
unnamed: J33.1, J66.3
RESET0: J13.3, J65.6, U1.18 (~RESET)
RESETS: J24.3, J66.5, U2.18 (~RESET)
SCK: J23.2, U2.12 (SCK)
SCL: J12.2, J18.2, J18.3, U1.12 (SCK)
SDA: J12.1, J17.2, J17.3, U1.13 (SDA)
SI: J23.3, U2.13 (SI)
SO: J23.4, U2.14 (SO)
