rryske2001/praca-magisterska/projekt_modul_systemowy_dwa_pcf_wersja_frezowanie/projekt_modul_systemowy_dwa_pcf.kicad_pcb

## KiCad design projekt_modul_systemowy_dwa_pcf_wersja_frezowanie/projekt_modul_systemowy_dwa_pcf.kicad_pcb (2026-04-29)

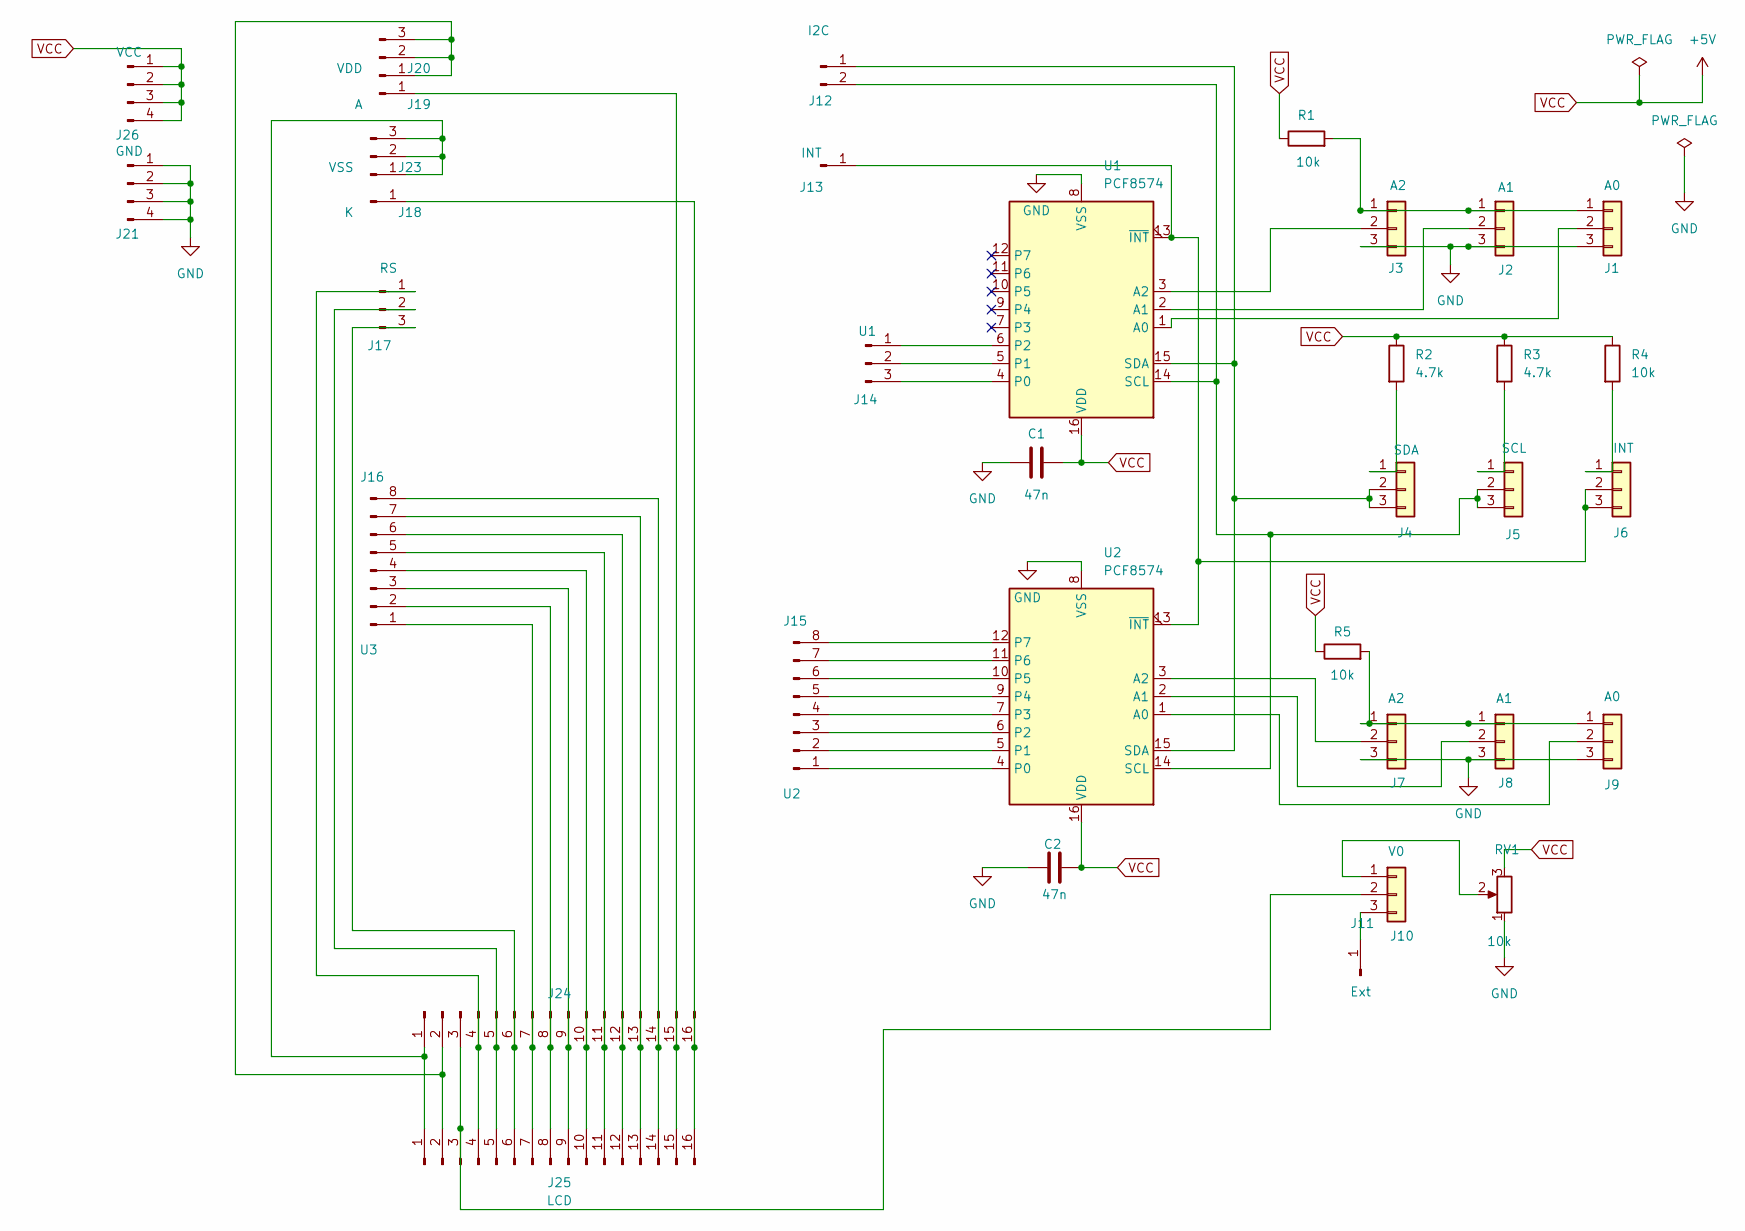
[picture p235: schematic projekt_modul_systemowy_dwa_pcf.kicad_sch]

Parts:
C1, C2: 47n; C_Disc_D8.0mm_W2.5mm_P5.00mm_kwadart
J1, J9: A0; PinSocket_1x03_P2.54mm_Vertical
J2, J8: A1; PinSocket_1x03_P2.54mm_Vertical
J3, J7: A2; PinSocket_1x03_P2.54mm_Vertical
J4: SDA; PinSocket_1x03_P2.54mm_Vertical
J5: SCL; PinSocket_1x03_P2.54mm_Vertical
J6: INT; PinSocket_1x03_P2.54mm_Vertical
J10: V0; PinSocket_1x03_P2.54mm_Vertical
J11: Ext; PinSocket_1x01_P2.54mm_Vertical
J12: I2C; PinSocket_1x02_P2.54mm_Vertical
J13: INT; PinSocket_1x01_P2.54mm_Vertical
J14: U1; PinSocket_1x03_P2.54mm_Vertical
J15: U2; PinSocket_1x08_P2.54mm_Vertical_kwadrat
J16: U3; PinSocket_1x08_P2.54mm_Vertical
J17: RS; PinSocket_1x03_P2.54mm_Vertical
J18: K; PinSocket_1x01_P2.54mm_Vertical_kwadart
J19: A; PinSocket_1x01_P2.54mm_Vertical_kwadart
J20: VDD; PinSocket_1x03_P2.54mm_Vertical
J21: GND; PinSocket_1x04_P2.54mm_Vertical
J23: VSS; PinSocket_1x03_P2.54mm_Vertical
J24: Conn_01x16_Pin; PinSocket_1x16_P2.54mm_Vertical_kwadrat
J25: LCD; PinSocket_1x16_P2.54mm_Vertical_kwadrat
J26: VCC; PinSocket_1x04_P2.54mm_Vertical
R1, R4, R5: 10k; R_Axial_DIN0207_L6.3mm_D2.5mm_P10.16mm_Horizontal_square
R2, R3: 4.7k; R_Axial_DIN0207_L6.3mm_D2.5mm_P10.16mm_Horizontal_square
RV1: 10k; Potentiometer_ACP_CA9-H5_Horizontal_kwadrat
U1, U2: PCF8574; DIP-16_W7.62mm_Socket_LongPads_lezki

Connections:
GND: C1.1, C2.1, J1.3, J2.3, J3.3, J7.3, J8.3, J9.3, J21.1, J21.2, J21.3, J21.4, RV1.1, U1.8 (VSS), U2.8 (VSS)
unnamed: J1.1, J2.1, J3.1, R1.2
unnamed: J1.2, U1.1 (A0)
unnamed: J2.2, U1.2 (A1)
unnamed: J3.2, U1.3 (A2)
unnamed: J4.1, R2.2
unnamed: J5.1, R3.2
unnamed: J6.1, R4.2
unnamed: J7.1, J8.1, J9.1, R5.2
unnamed: J7.2, U2.3 (A2)
unnamed: J8.2, U2.2 (A1)
unnamed: J9.2, U2.1 (A0)
unnamed: J10.1, RV1.2
unnamed: J10.2, J24.3, J25.3
unnamed: J10.3, J11.1
unnamed: J4.2, J4.3, J12.1, U1.15 (SDA), U2.15 (SDA)
unnamed: J5.2, J5.3, J12.2, U1.14 (SCL), U2.14 (SCL)
unnamed: J6.2, J6.3, J13.1, U1.13 (~INT), U2.13 (~INT)
unnamed: J14.1, U1.6 (P2)
unnamed: J14.2, U1.5 (P1)
unnamed: J14.3, U1.4 (P0)
unnamed: J15.1, U2.4 (P0)
unnamed: J15.2, U2.5 (P1)
unnamed: J15.3, U2.6 (P2)
unnamed: J15.4, U2.7 (P3)
unnamed: J15.5, U2.9 (P4)
unnamed: J15.6, U2.10 (P5)
unnamed: J15.7, U2.11 (P6)
unnamed: J15.8, U2.12 (P7)
unnamed: J16.1, J24.7, J25.7
unnamed: J16.2, J24.8, J25.8
unnamed: J16.3, J24.9, J25.9
unnamed: J16.4, J24.10, J25.10
unnamed: J16.5, J24.11, J25.11
unnamed: J16.6, J24.12, J25.12
unnamed: J16.7, J24.13, J25.13
unnamed: J16.8, J24.14, J25.14
unnamed: J17.1, J24.4, J25.4
unnamed: J17.2, J24.5, J25.5
unnamed: J17.3, J24.6, J25.6
unnamed: J18.1, J24.16, J25.16
unnamed: J19.1, J24.15, J25.15
unnamed: J20.1, J20.2, J20.3, J24.2, J25.2
unnamed: J23.1, J23.2, J23.3, J24.1, J25.1
VCC: C1.2, C2.2, J26.1, J26.2, J26.3, J26.4, R1.1, R2.1, R3.1, R4.1, R5.1, RV1.3, U1.16 (VDD), U2.16 (VDD)

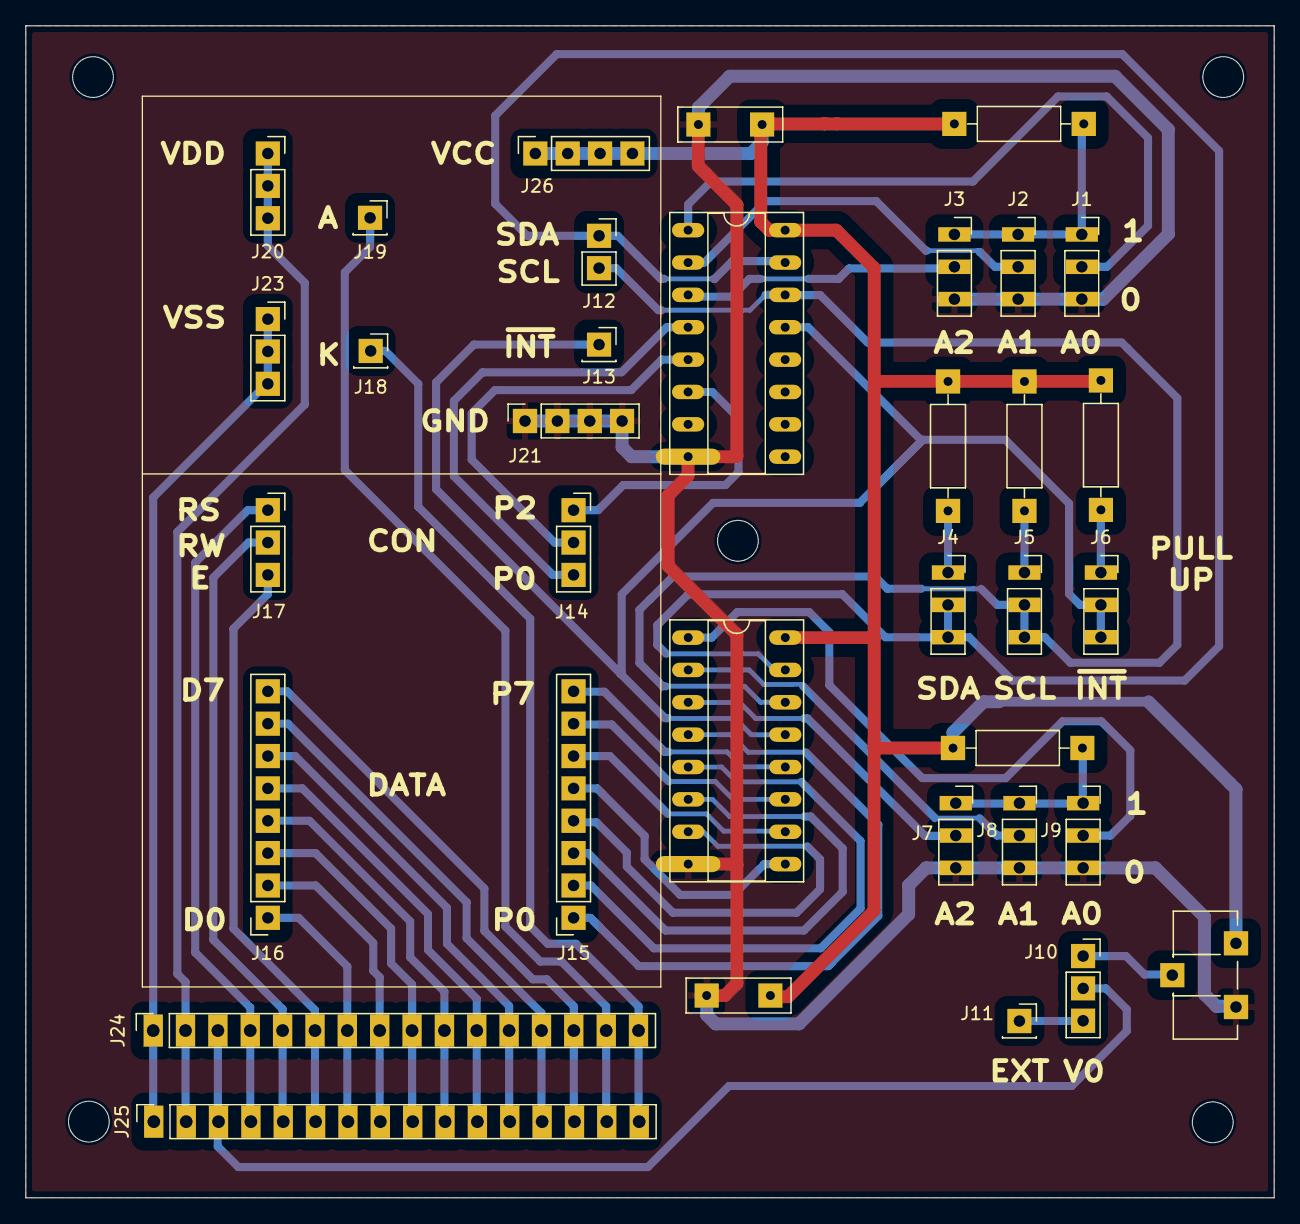
[picture p236: board projekt_modul_systemowy_dwa_pcf.kicad_pcb from above]

Board: 2 copper layers, 98.0 x 92.0 mm, 35 parts (0 on the bottom side), 45 nets.
