rryske2001/praca-magisterska/external_module_cc1101/src/main.cpp

/*
 * KOMPLETNY PLIK DIAGNOSTYCZNY DLA ATTINY414 + NRF24L01
 * Funkcje: Nadawanie + Wykrywanie Resetu Radia (Brown-out detection)
 */

#include <avr/io.h>
#include <util/delay.h>
#include <avr/interrupt.h>
#include <stdio.h>
#include <string.h>

#include "Config.h"
#include "SPI.h"
#include "CC1101.h"
#include "SoftwareI2C.h"
#include "BME280.h"
#include "RTC_sleep.h"

// Makra LED
#define LED_ON()   (LED_PORT.OUTSET = LED_PIN)
#define LED_OFF()  (LED_PORT.OUTCLR = LED_PIN)

// Funkcja pomocnicza do mrugania (ilość razy, czas ms)
void blink_led(uint8_t count, uint16_t ms) {
    for (uint8_t i = 0; i < count; i++) {
        LED_ON();
        for(uint16_t d=0; d<ms; d++) _delay_ms(1);
        LED_OFF();
        for(uint16_t d=0; d<ms; d++) _delay_ms(1);
    }
}

uint16_t get_battery_mv(void) {
    // 1. Ustaw wewnętrzne napięcie odniesienia (VREF) dla ADC na 1.5V
    VREF.CTRLA = VREF_ADC0REFSEL_1V5_gc;
    
    // 2. Skonfiguruj ADC: 
    // - Napięciem referencyjnym (maksymalnym) dla ADC staje się VDD (bateria)
    // - Ustawiamy preskaler na DIV16 (bezpieczna wartość dla standardowego zegara)
    ADC0.CTRLC = ADC_PRESC_DIV16_gc | ADC_REFSEL_VDDREF_gc; 
    
    // 3. Jako kanał wejściowy ADC wybieramy nasze stabilne 1.5V (INTREF)
    ADC0.MUXPOS = ADC_MUXPOS_INTREF_gc;
    
    // 4. Włącz przetwornik ADC
    ADC0.CTRLA = ADC_ENABLE_bm;

    _delay_us(100);
    
    // 5. Ślepy pomiar (Dummy read) - nota Microchip zaleca odrzucenie pierwszego 
    // wyniku po uruchomieniu ADC lub zmianie napięcia odniesienia, aby ustabilizować układ
    ADC0.COMMAND = ADC_STCONV_bm; // Start konwersji
    while (!(ADC0.INTFLAGS & ADC_RESRDY_bm)); // Czekaj na koniec
    ADC0.INTFLAGS = ADC_RESRDY_bm; // Wyczyść flagę
    
    // 6. Właściwy pomiar
    ADC0.COMMAND = ADC_STCONV_bm;
    while (!(ADC0.INTFLAGS & ADC_RESRDY_bm));
    ADC0.INTFLAGS = ADC_RESRDY_bm;
    
    // Zapisz wynik (10-bitowy)
    uint16_t adc_result = ADC0.RES;
    
    // 7. Natychmiast wyłącz ADC, żeby nie marnował energii podczas snu układu!
    ADC0.CTRLA &= ~ADC_ENABLE_bm;
    
    // 8. Obliczenia
    // Przekształcony wzór dający wynik od razu w miliwoltach:
    // 1500 (bo 1.5V = 1500mV) * 1024 (rozdzielczość przetwornika) / wynik ADC
    uint32_t vdd_mv = (1500UL * 1024UL) / adc_result;

    return (uint16_t) vdd_mv;
}

int main(void) {
    _PROTECTED_WRITE(CLKCTRL.MCLKCTRLB, 0); 

    LED_PORT.DIRSET = LED_PIN; // LED jako wyjście
    LED_OFF();

    SPI_init();
    TWI_Init();
    CC1101_init();
    RTC_Init();

    sei();//włączamy globalne przerwania
    
    BME280_Init();
    BME280_ReadCalibration();
    sensor_packet_t pkt;

    while (1) {
        uint8_t data[8];
        BME280_ReadBytes(0xF7, data, 8);

        // ciśnienie (20 bit)
        uint32_t raw_press = ((uint32_t)data[0] << 12) | ((uint32_t)data[1] << 4) | ((uint32_t)data[2] >> 4);

        // temperatura (20 bit)
        uint32_t raw_temp  = ((uint32_t)data[3] << 12) | ((uint32_t)data[4] << 4) | ((uint32_t)data[5] >> 4);

        // wilgotność (16 bit)
        uint32_t raw_hum   = ((uint32_t)data[6] << 8)  | ((uint32_t)data[7]);
        
        CC1101_wake_up(); //wybudzenie radia cc1101
        _delay_ms(10); //uśpienie potrzebne na uruchomienie się oscylatora układu

        //Tutaj jest kompensacja
        
        pkt.temp_hundredths = BME280_Compensate_T(raw_temp); //0.01°C
        pkt.pressure_pa    = BME280_Compensate_P(raw_press); //Pa
        pkt.hum_x1024      = BME280_Compensate_H(raw_hum);
        pkt.battery_mv         = get_battery_mv();

        CC1101_send_packet(&pkt);
        //blink_led(3, 100); //sygnalizacja wysłania danych
        _delay_ms(10); //odkomentowac w przypaku zakomentowania blink_led();
        CC1101_sleep(); //całkowite uśpienie radia cc1101 na czas braku transmisji

        //_delay_ms(5000); //uśpienie tylko w trakcie testu komunikacji
        //zamiast delay go to sleep
        GoToSleep(); 

    }
}

// Obsługa przerwania - budzik zadzwonił
ISR(RTC_PIT_vect) {
    // Wyczyść flagę przerwania, żeby nie wpaść w pętlę
    RTC.PITINTFLAGS = RTC_PI_bm;
}
