rryske2001/praca-magisterska/Odbiornik_radiowy/main/cc1101_regs.h

// Transmission types

#define BURST_READ 0xC0 // continuous read
#define SINGLE_BYTE_READ 0x80 // single read
#define BURST_WRITE 0x40 // continuous overwrite
#define SINGLE_BYTE_WRITE 0x00 // single overwrite

// Strobes

#define SRES 0x30 // Reset CC1101
#define SFSTXON 0x31
#define SXOFF 0x32
#define SCAL 0x33
#define SRX 0x34
#define STX 0x35
#define SIDLE 0x36
#define SWOR 0x38
#define SPWD 0x39
#define SFRX 0x3A
#define SFTX 0x3B
#define SWORRST 0x3C
#define SNOP 0x3D

// Registers

#define IOCFG2 0x00
#define IOCFG1 0x01
#define IOCFG0 0x02
#define FIFOTHR 0x03
#define SYNC1 0x04
#define SYNC0 0x05
#define PKTLEN 0x06
#define PKTCTRL1 0x07
#define PKTCTRL0 0x08
#define ADDR 0x09
#define CHANNR 0x0A
#define FSCTRL1 0x0B
#define FSCTRL0 0x0C
#define FREQ2 0x0D
#define FREQ1 0x0E
#define FREQ0 0x0F
#define MDMCFG4 0x10
#define MDMCFG3 0x11
#define MDMCFG2 0x12
#define MDMCFG1 0x13
#define MDMCFG0 0x14
#define DEVIATN 0x15
#define MCSM2 0x16
#define MCSM1 0x17
#define MCSM0 0x18
#define FOCCFG 0x19
#define BSCFG 0x1A
#define AGCTRL2 0x1B
#define AGCTRL1 0x1C
#define AGCTRL0 0x1D
#define WOREVT1 0x1E
#define WOREVT0 0x1F
#define WORCTRL 0x20
#define FREND1 0x21
#define FREND0 0x22
#define FSCAL3 0x23
#define FSCAL2 0x24
#define FSCAL1 0x25
#define FSCAL0 0x26
#define RCCTRL1 0x27
#define RCCTRL0 0x28
#define FSTEST 0x29
#define PTEST 0x2A
#define AGCTEST 0x2B
#define TEST2 0x2C
#define TEST1 0x2D
#define TEST0 0x2E
#define PARTNUM 0x30
#define VERSION 0x31
#define FREQEST 0x32
#define LQI 0x33
#define RSSI 0x34
#define MARCSTATE 0x35
#define WORTIME1 0x36
#define WORTIME0 0x37
#define PKTSTATUS 0x38
#define VCO_VC_DAC 0x39
#define TXBYTES 0x3A
#define RXBYTES 0x3B
#define RCCTRL1_STATUS 0x3C
#define RCCTRL0_STATUS 0x3D
#define TX_RX_FIFO 0x3F // TX only write single and write burst are both on the same address
