rryske2001/praca-magisterska/(commit log)

2026-03-02 Pierwszy commit
    [MapaRejestrowMCP.xlsx]
2026-03-03 Pomiary dla I2C
    [pomiary_I2C.xlsx]
2026-03-21 Pierwsze przymiarki do plytki
    [pomiary_I2C.xlsx, pomiary_SPI.xlsx, pomiary_SPI_AVR.xlsx, płytka_MCP_I2C.kicad_pcb, płytka_MCP_I2C.kicad_sch, testy_I2C_AVR.xlsx]
2026-03-22 Dodano płytkę z dwoma PCF
    [projekt_modul_systemowy_dwa_pcf.kicad_pcb, projekt_modul_systemowy_dwa_pcf.kicad_sch]
2026-03-22 MCP I2C wersja 1.0
    [płytka_MCP_I2C.kicad_pcb]
2026-03-23 Kosmetyczne zmiany, wydruk schematu, oraz plytki do pdf
    [płytka_MCP_I2C.kicad_pcb]
2026-03-23 Dodany pin RESET
    [płytka_MCP_I2C.kicad_pcb, płytka_MCP_I2C.kicad_sch]
2026-03-23 Wersja 2 plytki I2C
    [płytka_MCP_I2C.kicad_pcb, płytka_MCP_I2C.kicad_sch]
2026-03-23 MCP_SPI płytka wersja 1.0
    [płytka_MCP_I2C.kicad_pcb, płytka_MCP_I2C.kicad_sch]
2026-03-23 _MCP_I2C płytka do zmniejszenia
    [płytka_MCP_I2C.kicad_pcb]
2026-03-24 Korekcja rozmiaru płytki, utworzenie draftow, do druku
    [płytka_MCP_I2C.kicad_pcb, płytka_MCP_SPI.kicad_pcb, płytka_MCP_SPI.kicad_sch]
2026-03-24 Normalizacja wielkosci plytke
    [płytka_MCP_SPI.kicad_pcb]
2026-03-24 Zaktualizowane pomiary
    [pomiary_I2C.xlsx, pomiary_SPI_AVR.xlsx, testy_I2C_AVR.xlsx]
2026-03-25 Wyrownane otwory
    [płytka_MCP_I2C.kicad_pcb, płytka_MCP_SPI.kicad_pcb]
2026-03-25 Zmieniono otwory na rezystory oraz kondensotry 0,7mm
    [projekt_modul_systemowy_dwa_pcf.kicad_pcb]
2026-03-25 Zwiekszenie otworow na 0.7 mm dla SPI i I2C
    [płytka_MCP_I2C.kicad_pcb, płytka_MCP_SPI.kicad_pcb]
2026-04-29 Dodanie plytkek z wersja na frezowanie
    [projekt_modul_systemowy_dwa_pcf.kicad_pcb, projekt_modul_systemowy_dwa_pcf.kicad_sch, płytka_MCP_I2C.kicad_pcb, płytka_MCP_SPI.kicad_pcb, płytka_MCP_SPI.kicad_sch]
2026-05-27 Nowe programy testowe
    [bom.csv]
2026-05-30 Dodałem pomiary do SPI
2026-06-01 Plytka SPI_I2C
    [MCP_I2C_SPI.kicad_pcb, MCP_I2C_SPI.kicad_sch, mcp_i2c.kicad_sch, mcp_spi.kicad_sch]
2026-06-01 Płytka MCP in progress
    [MCP_I2C_SPI.kicad_pcb]
2026-06-02 Płytka MCP_I2C_SPIv1 gotowa
    [MCP_I2C_SPI.kicad_pcb, MCP_I2C_SPI.kicad_sch]
2026-06-03 Poprawki płytki MCP_I2C_SPI V1
    [MCP_I2C_SPI.kicad_pcb, MCP_I2C_SPI.kicad_sch]
2026-06-12 Zmiana footprintu rezystorow - 6mm
    [MCP_I2C_SPI.kicad_pcb]
2026-06-13 Update PCB MCP_I2C_SPI V3
    [MCP_I2C_SPI.kicad_pcb]
2026-06-17 płytka MCP 17.06.2026
    [MCP_I2C_SPI.kicad_pcb]
2026-06-19 PCB MCP_I2C_SPI_V4
2026-06-19 kolejna wersja MCP
    [MCP_I2C_SPI.kicad_pcb]
2026-06-23 Płytka MCP_I2C_SPI_V7
    [MCP_I2C_SPI.kicad_pcb, MCP_I2C_SPI.kicad_sch]
2026-06-23 obudowa do modułu PCF
    [obudowa_PCF.FCStd, obudowa_PCF.stl, projekt_modul_systemowy_dwa_pcf.step]
2026-06-23 MCP_I2C_SPI PCB V8
    [MCP_I2C_SPI.kicad_pcb]
2026-06-23 MCP_I2C_SPI PCB V9
    [MCP_I2C_SPI.kicad_pcb, MCP_I2C_SPI.kicad_sch, mcp_i2c.kicad_sch, mcp_spi.kicad_sch]
2026-06-24 MCP_I2C_SPI PCB V11
    [MCP_I2C_SPI.kicad_pcb, MCP_I2C_SPI.kicad_sch, mcp_i2c.kicad_sch, mcp_spi.kicad_sch]
2026-06-25 MCP_I2C_SPI PCB V12
    [LCD 16x2 HD44780 assembly.stp, LCD16x2.stl, MCP_I2C_SPI.kicad_pcb, MCP_I2C_SPI.step, QP5522 Jaycar 20x4 LCD Module v14.step, obudowa_MCP_I2C_SPI.FCStd]
2026-06-28 Final verison MCP_I2C_SPI, ready to order
    [MCP_I2C_SPI.kicad_pcb, MCP_I2C_SPI.kicad_sch]
2026-07-02 Obudowa modul dwa PCF
    [GotowaObudowa_do_MCP_I2C_SPI.step, Gotowa_obudowa_do_modulu_dwa_PCF.step, LCD 16x2 HD44780 assembly.stp, QP5522 Jaycar 20x4 LCD Module v14.step, obudowa_MCP_I2C_SPI_V2.FCStd, obudowa_do_modulu_dwa_PCF.FCStd, projekt_modul_systemowy_dwa_pcf.step, zlozenie_obudowa_do_modulu_dwa_PCF.FCStd]
2026-07-09 Wirless receiver
